Nyxarian/ApexFly-v2.0/优化一下/会话交接.md

# ApexFly V2.0 · 会话交接

> **更新于 2026-10-07，已提交基线 v0.34（含阶段4~7改动 + 定点手动上锁修复）；修复待真机验收。**
>
> **用途**：换新会话时，把这份文档交给新会话的 AI 先读。
> 它只写**当前状态 + 下一步 + 不能忘的规矩**；详细设计与推导**不在这里**，下文指了位置。
>
> ⚠️ **不要把这个旧会话的聊天记录/日志粘进新会话。** 要数据就给文件路径。

---

## 0. 新会话开场白（复制这段）

```
ApexFly V2.0 飞控项目。先读 优化一下/会话交接.md，再按它指的位置读细节。
本次要做：<在这里填一句话>
```

---

## 1. 项目是什么

| 项 | 内容 |
|---|---|
| 什么 | STM32G474VCT6 上的**自写四轴飞控固件** |
| 工具链 | **Keil MDK（AC5 / armcc，C99，`-O1`）** |
| RTOS | FreeRTOS 10.3.1 + CMSIS-RTOS2，tick 1000Hz，heap 30KB |
| 控制环 | 250Hz（`motorTestTask`，优先级 High，DRDY 信号量驱动） |
| 代码根目录 | `ApexFly v2.0\ApexFly v2.0\`（工作区根是 `F:\Zhuomian\ApexFly v2.0\`） |
| 资源 | Flash 256 KB / RAM 128 KB。⚠️ 最近一次 map 约 **98 KB / 42 KB**，那是 **v0.23 之前**的数，加光流后没重新出过 map |
| 遥控端 | **另一个仓库**：`F:\Zhuomian\CoreFly F2 Remoto`（STM32F407 + LVGL） |
| 调试口 | USART3 = 打印 + 黑匣子 dump，**115200 8N1**（COM9，WCH 芯片） |
| 文档目录 | `优化一下\`（方案 / 施工顺序）、`技术文档\`（数据手册，**被 .gitignore 忽略**） |

**任务优先级**：`motorTestTask`=High ／ `radioTask`=AboveNormal ／ `blackboxTask`/`magtask`/`gpsTask`/`tofTask`/`flowTask`=BelowNormal ／ `ledTask`/`defaultTask`=Normal。

---

## 2. 分工与硬规矩（不许破）

**分工：AI 改代码；用户在真机上编译、烧录、验证。**
AI **不烧录、不擦除、不探测目标板、不占串口**，**绝不假装这些已经成功**。

| # | 规矩 |
|---|---|
| 1 | **工作循环**：①AI 出方案 →②用户批准 →③AI 改代码 →④用户真机验证 →⑤下一环节。**未明确批准不动任何代码/工程文件/配置。** |
| 2 | 方案必须含三段（会导致什么 / 现在怎么办 / 优化后如何）+ 五要素（目标、改动文件与点、影响范围、内存与资源、验收标准）。 |
| 3 | **能用串口打印验证的一律用打印验**；验证通过后**把临时打印删干净**。 |
| 4 | **关键节点提交**；提交信息必须写**版本号 + 本次完成了什么**；**跳过某环节必须在留档里备注**。 |
| 5 | **行尾**：`Modules/*` = **LF**；`Core/Src/*`、`Core/Inc/*` = **CRLF**。改之前先确认，别搞成混合。 |
| 6 | **改 `.uvprojx` 之前 Keil 必须关掉**（否则退出时被覆盖）。 |
| 7 | ⭐ **加任何全局符号前，先全工程 grep 一遍**。`HAL_UART_ErrorCallback` 重复定义（`L6200E`）踩过一次。 |

---

## 3. 当前状态（v0.34 已提交，修复待真机验收）

- 2026-10-07 用户批准修复：正常手动上锁让定点回到 WAITING；重新解锁后门禁全通时重新捕获原点。仅把“链路正常 + 有效遥控帧明确请求上锁”认作正常上锁，不把失联、内环禁用或 IMU 故障认作正常上锁。
- `PositionControl_SetSafetyContext()` 新增第4个参数 `pilot_disarmed`；motor 控制环传递原因，Flow 轮询即使无新帧或旋转冻结也能退等待。正常上锁清零目标、积分、滤波、位置/速度和旧锚点；已有真实故障锁存及首次故障原因保持，仍需关开定点请求。
- 验证：位置仿真由22项增至56项，全过；光流39项全过。新增覆盖连续两轮上锁/解锁、重新锚定、无新帧、手动飞行态、五种真实故障锁存保留。position_control.c和motor_test.c的ARM GCC语法检查通过（沿用synchk_gcc的RTOS语法桩，不等同于Keil整工程编译）。Keil编译、烧录和拆桨串口验证由用户进行，本轮未执行。
- 用户日志 `C:/Users/fool/Downloads/apex_session_20261007_110915.csv`：完整场次10/11速度Kp分别0.012/0.013，位置三增益与速度I/D均为0；444条定点记录全部st=3/fr=5，定点姿态输出全为0，不能比较增益效果。文件开头另有场次9尾段；首次锁存触发不在文件中，不能认定具体触发时刻。
- 同份日志有明显偏航变化；用户表示只有油门动、其他杆未动。偏航原因未查明，不能因为本次锁存修复就直接恢复飞行调参。失联停桨旧缺口仍在当前代码中。
- 阶段4：IMU健康、动态加速度权重与静止陀螺偏置学习已实现；阶段5~7：光流方向复核、高度比例和旋转冻结已实现，并有用户台架记录。旋转门限是冻结/重新锚定，不是完整角速度补偿。
- 2026-10-07 已提交 **v0.34**：阶段4~7既有改动与本次手动上锁修复一并入库，未拆分成两次提交。提交信息里写明了「待真机验收」的边界。
- `sim_position_control.c` 受忽略规则影响（`_inbox_会话提取/.gitignore` 整目录忽略），已用 `git add -f` 强制入库并随 v0.34 提交；以后改它**仍要走 `git add -f`**，直接 `git add` 会被静默漏掉。

- v0.24 在 v0.23 光流接入基础上，把 OF5 标定窗口从 25 帧改为 **250 帧（约 10 秒）**，`z` 改为 4 位小数。
- OF1~OF5 的 `sim_flow.c` 基线 **37 项全过**；用户已编译烧录并完成 60 秒静止复测；遥控端不用动。
- 本地仍领先远端，推送由用户自己做。`硬件/BOM/` 是另一话题留下的未跟踪文档，不属于本次固件提交。

### 定高（H1~H14）：代码完成 + 已真机验证

| 环节 | 状态 |
|---|---|
| H1~H6 估计器 / 状态机 / 门禁 / 三段映射 / 停手 | ✅ 已实测（v0.13） |
| H17a 遥控端模式通道 | ✅ 用户实测通过 |
| H8 油门来源接管 | ✅ 台架 9/9 |
| H9 垂速内环 P | ✅ 真机 10/10（等效 Kp ≈19.9） |
| H10 悬停油门估计器 + 绝对油门区间 | ✅ 真机 12/0/1 |
| H12 失效处理（保持 → 慢降到 1000） | 🔨 代码完成（v0.19），⚠️ **台架验证被跳过，从未上过真机** |
| H13 外环 P + `h_sp` 接入 | 🔨 代码完成（v0.20），待验证 |
| 飞前清账（v0.21） | 🔨 代码完成，待烧录 |
| H14 停手改「推杆即解手」（v0.22） | 🔨 代码完成，待烧录 |
| **H16 估计器互补滤波** | ❌ **未做**。⭐ 它是"内环增益能不能加上去"的前提（当前 `vz_kp` 只能给 2，设计值 20） |

### ⭐ 光流（OF1~OF5）：全部真机通过

- **OF1/OF2**：约 25Hz、Quality 168~255、checksum 恒 0；format 偶发但能自动恢复。
- **OF3**：遮挡时 304 个低质量帧期间 `sx/sy` 严格冻结；TX 断开约 16 秒时 `n` 不变、`sx/sy` 严格冻结；接回自动恢复。
- **OF4**：前后/左右正反方向已取证。模块镜头垂直向下，仅在水平面内相对机体系约旋转 **58°**；二维转换放到 OF6 只打印阶段复核。
- **OF5**：v0.24 的 250 帧标定已真机通过。`z=-0.0040,0`；标定后 1653 帧/66.12 秒漂 6.6/0 计数，每帧残差 0.003993，相对旧版改善 10.02 倍。
- **OF6**：v0.25 软件与真机台架通过。新增约 58° 机体系旋转、位置 P 环 12.5Hz、速度 P 环 25Hz、2.5Hz 输出低通；只打印 `[PC]`，未接姿态/电机。用户确认机体与光流镜头实际高度保持约 15cm；内侧 ToF 被底座遮挡导致 `[V] raw/h` 后半段下降，不代表光流高度变化。
- **OF7**：新增请求接口、五位门禁、当前位置锚定、手动飞行态、失效锁存和请求重开；仍只打印，真实遥控请求留到 OF10，不复用定高 `flight_mode`。
- **OF10**：飞控与 `CoreFly F2 Remoto` 已接入独立定点请求位 `0x02`；遥测 `flight_mode` 的 bit4~6 回传实际定点状态；遥控器设置页可开关请求，仪表盘显示实际状态。两端基线已分别提交，用户真机联调通过；UI 有轻微显示问题，暂不处理。
- **OF8**：姿态、有效高度、解锁/内环许可接入定点门禁；光流/链路/姿态/高度运行中故障会清零并锁存，恢复后必须关开请求。宿主机 `sim_position_control.c` **22/22**；`sim_flow.c` **39/39**；飞控 ARM GCC 语法检查通过。待用户拆桨台架验证。
- **OF8 真机验收**：用户已验证定点锁存与恢复流程；拔掉光流输入后为 `st=3 fr=1`，盖镜头时已处于锁存态没有新增动作，符合锁存设计。`fr=2` 的遥控链路专门测试尚未单独取证，但不阻挡本轮进入 OF9。
- **OF9**：新增独立 64 字节定点扩展记录，约 12.5Hz 记录光流 dx/dy/quality、累积流量、标定零点、速度/目标速度、raw/out 姿态目标和定点状态；旧姿态样本布局不变。首份 CSV 已确认字段与状态正确，但发现 `t_ms` 受黑匣子队列写入延迟影响，已改为记录 Flow 采样源时间；当前等待重新 dump 验证时间间隔。宿主机 Flow 39/39、位置 22/22、ARM GCC 语法检查通过。
- **OF11**：位置/速度环输出已接入原有姿态目标角输入；普通模式生效，定高模式暂不叠加，修正角保持 ±8°；原有姿态 PID 参数未改。ARM GCC 语法检查通过，待用户拆桨台架验证。
- **OF15**：飞控与遥控端已扩展到 39 项参数；新增定点位置环/速度环 KP、KI、KD 共 6 项；支持遥控 SET、SAVE、LOAD、上电自动加载；黑匣子场次头追加定点参数记录。当前继续补上机载端每次成功 SET/LOAD 的完整 39 项参数版本记录和 SAVE 标记，遥控端无需改协议。两端语法检查通过，待用户验证参数历史与波形对应关系。
- OF11 已在普通模式接入姿态目标；定高模式暂不叠加定点，不能再按“全部只打印”理解当前代码。

完整证据：`优化一下\光流OF1~OF5真机验收留样.md`。

⚠️ **GPS 被临时摘掉**：本板只有两个串口，光流接到了 GPS 座。开关是
`Core/Inc/apex_config.h` 的 **`APEX_UART2_ROLE_FLOW`**（1=光流 19200 / 0=GPS 9600，**GPS 代码路径没删**）。
副作用：**黑匣子场次时间戳会写 0**（用户已定：照原样显示、不兜底）。

---

## 4. ⭐ 下一步（本会话结束后的第一件事）

**用户用Keil编译烧录本次手动上锁修复；先拆桨验证下面流程，再排查偏航及失联保护，暂不继续飞行加增益。**

1. 拆桨、保持ToF/光流有效、摇杆回中，打开定点请求。正常手动上锁时应为 `[PC] req=1 st=1 fr=0 ok=0`，`raw/out`全0。
2. 解锁后门禁全通，应为 `gate=0x1F st=2 fr=0 ok=1`。轻微平移验证速度和修正角更新。
3. 手动上锁后改一次参数，定点请求保持打开；应回st=1/fr=0/ok=0。将机体平移到新位置再解锁，应在新位置锚定、st=2/fr=0/ok=1，不能向旧位置回拉。连续完成两轮。
4. ACTIVE时遮挡镜头到光流失效，应st=3/fr=1；恢复、手动上锁和再解锁都不能清掉已有故障。只有关闭、重开定点请求才允许重新使能。
5. 参数SET/SAVE/LOAD仍只允许上锁操作；仅降油门并不等于上锁。真实故障许可丢失仍允许fr=5锁存。

OF1~OF5 的完整留样：`优化一下\光流OF1~OF5真机验收留样.md`。

参数调节顺序是速度内环先、位置外环后。单独验证速度刹车时位置Kp/Ki/Kd全0，速度I/D全0；合格的ACTIVE记录产生后才能判断增益。当前修正角上限±8°，高度比例参考14cm、钳在0.6~2.0。

### 不建议现在做的

**别急着首飞。** 飞前还压着 4 件事，其中待办 9 是硬缺口 —— 见下一节。

---

## 5. 挂着没关的账

| # | 项 | 状态 | 挡什么 |
|---|---|---|---|
| **待办 9** | ⚠️⚠️ **失联门限只放宽到 1500ms，没根治** | LoRa 一问一答实测间隔 300~320ms ⇒ 连丢 4~5 帧仍判失联 ⇒ `armed=false` ⇒ **空中停桨**。真修法要改 `motor_test.c` 的 `!armed` 分支（failsafe hold） | **首飞**（唯一的硬缺口） |
| **待办 11** | ⚠️ **H12 从未上过真机** | 最便宜的一条：**举到 1.25m 以上** → `fr=3`、`st=6` 保持 2s、`st=7` 慢降。不用飞、不用拆桨 | **首飞**（风险转移在那里） |
| **待办 6** | 「举到 1.35m 让 `v=0`」未做 | 需要更长的 USB 线或支架（举高会扯掉线，实测掉线 3 次丢 143s） | 不挡 |
| **待办 7** | 悬停油门天花板 1650 够不够 | **只有首飞才知道**。若 `i` 长期顶在 1650 还上不去，要改**代码常量** `VERTICAL_CONTROL_THROTTLE_MAX_US`（**要重烧**） | 首飞后 |
| **待办 10** | H12 下降段单向不回头 | 刻意取舍，待评估 | 不挡 |
| **待办 4** | 串口 ORE 溢出后的自动恢复路径 | **未真机验证**（用户跳过了）。将来串口"突然收不到、要重插"先怀疑这里 | 不挡（只影响黑匣子 dump） |
| GPS | 返航/航线 | 光流稳了之后第二阶段做（光流挪到打印口 RX、GPS 接回 USART2） | 后期 |
| H18/H19 | 自动起飞 / 自动降落 | 未做。⚠️ H19 的前提被"停手"改过，文档里标了要重看 | 后期 |

---

## 6. 必读文档

| 文档 | 里面有什么 |
|---|---|
| `优化一下\IMU与光流定点阶段总结_2026-10-07.md` | 本轮阶段0~8成果、状态机修复、飞行日志结论、验证边界、当前参数及后续调试顺序 |
| `优化一下\高度接入施工顺序.md`（**1428 行，含「当前进度」表 + 待办清单**） | 定高 H1~H20 全表、每个环节的验收步骤与实测结果、待办 1~11、踩坑记录 |
| `优化一下\高度接入飞控方案.md` | 定高的研究方案（为什么这么设计，§5 摇杆与模式、§6 失效、§15 坑） |
| `优化一下\光流接入方案.md` | 光流 OF1~OF5 方案；**含商家 demo 的两条缺陷**（不看 Quality、不做零点标定 = 恒速漂移的根因） |
| `优化一下\光流定点施工顺序.md` | OF1~OF15 全表 + **「OF1~OF5 验收步骤」** |
| `优化一下\光流OF1~OF5真机验收留样.md` | 2026-09-21 真机日志证据、实际安装条件、OF3 验收与 OF5 修正依据 |
| `技术文档\mini光流资料\demo代码\README.md` | 商家 demo 逐行读后的结论（⚠️ `技术文档/` 被 gitignore） |

**改代码前必看的具体文件**

| 文件 | 关键内容 |
|---|---|
| `Modules\Control\vertical_control.h` | ⭐ 所有定高常量与注释都在这里（停手门槛、三段边界、速率、门限、油门区间） |
| `Modules\Control\vertical_control.c` | 状态机 + 两层门禁 + 停手 + 失效处理 + 慢层积分器 |
| `Modules\Flow\flow.c` / `flow_cxof.c` | 光流管理层 / 协议层 |
| `Core\Inc\apex_config.h` | 手写编译期开关（USART2 归谁） |
| `Modules\Motor\motor_test.c` | 控制环；基础油门按模式分叉在 ~L524；打印**禁止**在这里（一行 10ms 会吃两拍预算） |
| `Modules\ToF\tof.c` | `[V]` 与 `[OF]` 两行打印都在这里（tofTask，500ms） |
| `Modules\Communication\apex_protocol.h` | 参数 ID 表（高度组 25~32） |

---

## 7. 日志怎么读

### `[V]` 行（500ms 一行，垂直轴全部信息）

```
[V] raw=<mm> | h=<cm> vz=<cm/s> v=<0|1> | req= mode= st= sw=0x ct=0x stick= h_sp= gt=ms fs=ms fr= | vzsp= corr= i= thr=
```

| 字段 | 含义 |
|---|---|
| `st` | ⭐ 细分状态：**0** 普通 / **1** 定高在干活 / **4** 停手 / **5** 已进模式未使能 / **6** 失效保持 / **7** 失效下降 |
| `sw` / `ct` | 两层门禁位图，全通分别是 `0xF` |
| `fs` / `fr` | 失效计时 / 失效原因（0 无、1 ToF 失效、2 姿态超限、3 高度越界）。⚠️ **`fr=2` 时 `thr` 立刻 1000**，是设计不是 bug |
| `vzsp` | 外环输出（内环的目标垂速）。符号：命令上升为正；死区 2cm 内恒 0 |
| `corr` | 快层（垂速内环修正量）。⚠️ **符号必须与 `vz` 相反**，这是负反馈的唯一证据 |
| `i` | ⭐ 慢层（悬停油门估计器），钳在 **1150~1650**。台架上只有它能看出积分在不在工作 |
| `thr` | 基础油门。定高时 = `i + corr` 再钳到 [1150,1650]；普通模式跟杆走 |

### `[OF]` 行
见第 4 节。

---

## 8. 已经踩过的坑（别重犯）

| # | 坑 | 结论 |
|---|---|---|
| 1 | **`L6200E: Symbol HAL_UART_ErrorCallback multiply defined`** | 加全局符号前先全工程 grep。光流与 GPS **必须互斥编译**（同一个 `APEX_UART2_ROLE_FLOW` 开关控制两个 HAL 回调） |
| 2 | ⚠️ **CubeMX 重新生成会覆盖手改** | `usart.c` 里 `huart2.Init.BaudRate = APEX_UART2_BAUD` 和 `app_freertos.c` 里 `gpsTask` 的那个 `#if` **都不在 USER CODE 区** ⇒ 生成完必须回来确认（否则波特率打回 9600、光流一帧收不到） |
| 3 | **停手门槛必须 > 地面静止读数** | 门槛低于读数 ⇒ 停手永远进不去（2026-09-14 翻过车）。反向也不行：门槛太高会把低空悬停误判成停手 ⇒ 油门压最低 ⇒ **掉下来**。规矩是**撤垫块后重新实测**，门槛取"实测 + 1~2cm" |
| 4 | **打印绝不能进 250Hz 控制环** | 一行约 10ms，会吃掉两拍 4ms 预算。打印全在 `tof.c`（tofTask，500ms） |
| 5 | `USART3` 是 **5ms 轮询 + FIFO 关闭**（硬件只存 1 字节） | 串口命令**必须逐字节发、间隔 ≥10ms**，否则被吃掉。这就是"发命令又慢又脆"的根因 |
| 6 | **`.uvprojx` 是手改的** | 改之前 Keil 必须关着 |
| 7 | 仿真能抓产品代码的错 | H6 的"**永远起飞不了**"死循环就是仿真抓出来的。**烧录前先跑仿真**（见下一节） |
| 8 | ⚠️ **DSH 沙箱禁写 `.git`** | 受限模式下 `git add/commit` 一律 `Unable to create '.git/index.lock': Permission denied`（工作区其他目录可写，只有 `.git` 被单独挡）。**提交必须在「完全权限」下跑**，别误判成仓库损坏 |
| 9 | ⚠️ **本工作区 Windows 权限曾缺失** | 2026-10-07 出现过 `SetNamedSecurityInfoW failed (Win32 5): grantWrite(...)`，连 `echo` 都跑不了：根目录缺 `WRITE_OWNER`。备份与回滚脚本在 `F:\Zhuomian\acl-recovery\` |

---

## 9. 验证工具在哪（不碰硬件就能用的）

都在 `_inbox_会话提取\提取脚本\`（脚本源码已强制入库；`_inbox_会话提取\.gitignore` 里列了清单）。

| 工具 | 干什么 |
|---|---|
| `sim_vc_h10.c` / `h12.c` / `h13.c` / `h14.c` | **固件仿真**：真实编译 `vertical_control.c` + `pid.c`，桩掉估计器与参数表。当前有效回归：h10 **49** / h12 **68** / h13 **34** / h14 **48** 项全过 |
| `sim_flow.c` | **光流仿真**：真实编译 `flow.c` + `flow_cxof.c` + `position_control.c`，并用"反向控制"驱动**真的 `Flow_Task`**，**39 项全过** |
| `sim_position_control.c` | **OF6/OF7 纯计算仿真**：旋转、两级环、分频、门禁、锚定、手动飞行态、锁存、限幅、低通、失效与恢复，**16 项全过** |
| `verify_v.js` | **真机日志自动判据**：读 `[V]` 行，24 条判据逐条给结论。用法 `node verify_v.js <日志>` |
| `gen_fake_v_log.js` | 合成日志生成器，**含 11 个对照组**（用来证明判据真能抓错，不是自欺） |
| `sim_h13_takeoff.js` | 物理仿真：起飞时间线 / 延迟扫描 / 增益扫描 |
| `measure_session.js` / `measure_usage.js` | 量 DSH 会话体积与 token 用量（成本分析用） |
| `synchk_gcc\` / `flow_stub\` / `sim_stub\` | 宿主机语法检查用的桩头 |

**语法检查**（两种开关状态都要过）：
```bash
arm-none-eabi-gcc -fsyntax-only -std=gnu99 -Wall -Wextra -Wno-unused-parameter -Wformat=2 \
  -DUSE_HAL_DRIVER -DSTM32G474xx <包含路径...> <文件>
```
⚠️ `sim_vc_h8.c` / `sim_vc_h9.c` 是**历史脚本**（断言基于当时的旧基准，已过期），**不要接进自动检查**。

---

## 10. 沟通与协作风格

- **中文回答，先给结论再给依据。**参数偏保守，不确定就说不确定，**不要猜**。
- 用户偏好：**大白话**、**决策表**、**五要素方案**、**不要废**（别啰嗦）。
- ⚠️ **压缩档（caveman full）默认开**。**例外**（按普通写法、不许压）：
  安全警告、不可逆操作（接反烧模块、5V、掉桨）、**多步操作顺序**（烧录流程、验收步骤、接线）、
  判据、参数值、常量、命令行、错误原文、代码块。
- ⚠️ 硬件的事**由用户做**，包括编译烧录。AI 只给可直接执行的步骤与命令。

---

## 11. 成本纪律（给用户看的，AI 也要遵守）

**实测结论**（用 `measure_usage.js` 量的上一个会话）：

- 上下文长期卡在 **700K~790K**；**三次压缩只降了 10% / 3% / 6%** ⇒ **压缩救不了**。
- 换新会话，同样工作量**输入省约 18 倍**（拆成多个会话约 30 倍）。

**规矩：**
1. ⭐ **一个环节 ≈ 一个会话。**（H8/H9/H10 一个、H12/H13 一个、OF1~OF5 一个）
2. 换会话的触发：**一个环节做完并提交** / **上下文 > 200K** / **已经压缩过 1 次** / **换任务类型**。
3. AI 回复默认走压缩档；**长报告只在"要留档"时才写**。
   （上一个会话里，AI 自己的回复占会话体积的 **58%**，是最大单项。）
4. 换会话时**不要把旧日志/长工具回显粘过来** —— 给文件路径，或重新生成。
5. 本文件就是交接资料。**每次换会话前更新本文件的第 3、4 节。**
