Nyxarian/ApexFly-v2.0/优化一下/IMU与光流定点阶段总结_2026-10-07.md

# ApexFly V2.0 · IMU与光流定点阶段总结

> 日期：2026-10-07（北京时间）  
> 范围：IMU基准优化、六面校准、姿态健康、光流测量与定点控制，以及手动上锁退等待修复。  
> 已提交基线：`9f5d31e`，`v0.33：完成 IMU 六面校准与姿态打印链路`。  
> 当前状态：主要功能代码和调参链路已实现，后续重点为真机验收与调参；有效定点飞行尚未验收通过。

## 1. 本阶段结论

这轮工作把“每次上电把当前地面当成水平”的处理，改为重力姿态、加速度计校准和固定安装角修正分别处理；同时补齐光流高度比例、旋转冻结、定点状态机和观测链路。

当前能够计算定点姿态修正，并在普通模式中送入姿态控制。遥控器可以修改、保存、加载位置与速度六项增益，串口和黑匣子可以查看定点实际状态。

“代码已经实现”不等于“飞行已经稳定”。2026-10-07两场完整飞行记录中的定点始终故障锁存，输出为零，所以不能把它们视为速度环整定成功，也不能据此认定增益过大。

最新完成的是正常手动上锁退等待修复：代码、仿真与语法检查通过，用户尚未提供修复后的编译、烧录和拆桨验收结果。

## 2. 完成内容和验证状态

| 阶段 | 完成内容 | 当前证据与状态 |
|---|---|---|
| 0 | 冻结基线、记录参数和工作区 | 基线文档已建立 |
| 1 | 取消每次上电动态水平清零 | 已从电机控制任务移除旧清零流程；用户后续姿态测试有倾斜响应 |
| 2 | 固定安装角修正 | 用户确认机架水平，完成平放、四方向垫高测试；六面校准后重新修正安装角 |
| 3 | 六面加速度计bias/scale校准、串口控制和Flash保存 | 用户提供保存成功回显及后续姿态数据；历史六面算法仿真1224项通过，本次未重跑 |
| 4A/4B | 姿态健康、加速度模长、静止判断和融合误差观测 | 用户提供静止/移动串口记录 |
| 4C | 动态加速度修正权重 | 用户记录可观察到运动时权重降低、静止后恢复 |
| 4D | 静止时在线陀螺零偏学习 | 用户记录可观察到静止允许学习、移动停止学习；在线补偿仅保存在RAM |
| 5 | 光流质量、有效性、零点和前后左右方向复核 | 用户提供台架移动记录；安装角在代码中采用约54° |
| 6 | 按ToF高度计算比例，缩放光流位置和速度 | 用户提供不同高度的hs记录；已实现0.6～2.0钳位 |
| 7 | 大角速度期间冻结光流控制，结束后重新锚定 | 用户提供rot冻结/恢复记录；这是门限抑制，不是完整旋转补偿 |
| 8 | 位置/速度增益整定 | 参数和日志链路已具备；有效定点飞行增益尚未确定 |
| 本次补充 | 正常手动上锁退WAITING，重新解锁重新锚定 | 位置仿真56/56、光流39/39、ARM GCC语法检查通过；待修复后真机验收 |
| 9 | 定点与定高同时使用 | 尚未实现；当前定高模式不叠加定点修正 |

上述台架结果来自本轮用户提供的串口记录和反馈，不表示本次重新执行了全部硬件测试。

## 3. IMU处理结果

### 3.1 水平基准与传感器校准分开

- 上电仍采集陀螺仪静止零偏，但不再把当前摆放姿态强行清成水平。
- 六面校准处理加速度计三轴bias和scale，不等于机架安装角校准。
- 加速度计校准改变重力方向估计后，需要重新检查固定安装角修正。这解释了六面校准后平放角度曾重新出现偏差。
- 当前安装角修正为机体系 `roll=-0.14°`、`pitch=-0.87°`，属于代码中的固定常量；更换飞控、改变安装位置或传感器后需要重新检查。
- 当前六面算法不包含完整轴间不正交、温度模型或全矩阵安装旋转标定。

### 3.2 六面校准与保存

串口命令：

```text
calimu start
calimu next
calimu status
calimu save
calimu cancel
```

六面顺序为传感器原始轴 `X+ → X- → Y+ → Y- → Z+ → Z-`，不能直接把这些名称当成机架前后左右。

用户曾提供以下保存成功回显：

```text
[IMU_CAL] flash saved gen=1 bias=+0.04171,-0.08191,+0.02669 scale=1.00044,0.99864,0.98863.
```

这是一份历史保存证据，不是本次重新读取目标板Flash的结果。校准记录使用外部W25Q64末尾保留扇区中的64字节双副本，启动时读取有效记录；无需每次上电重新做六面采集。固定安装角修正与这份bias/scale记录分开。

### 3.3 姿态健康与在线零偏

已有诊断字段包括加速度模长 `an`、修正有效性 `ac`、健康状态 `ah`、静止状态 `st`、融合误差 `fe`、修正权重 `aw`、在线陀螺偏置 `gb` 和学习许可 `gl`。

在线学习仅在未解锁、静止、健康正常且加速度修正权重足够高时允许；时间常数约20秒，补偿限制为每轴±3°/s。解锁或运动时停止学习，避免把真实运动吸收为零偏。它不代替六面校准，也不在飞行中学习水平基准。

## 4. 当前定点控制链和参数

```text
光流原始帧
→ 校验、质量门禁、零点修正
→ 旋转门限抑制
→ 模块坐标转机体系
→ 高度比例缩放
→ 位置外环给目标速度
→ 速度内环给roll/pitch修正角
→ 输出低通
→ 普通模式下叠加到姿态目标
→ 原有姿态/角速度控制和电机混控
```

| 项目 | 当前代码值或规则 |
|---|---|
| 控制周期 | 姿态/电机任务250Hz；光流约25Hz；位置外环每两帧更新一次，约12.5Hz |
| 光流安装角 | 约54°，cos=0.5878、sin=0.8090 |
| 高度参考 | 14cm |
| 高度比例 | `hs=clamp(height_cm/14, 0.60, 2.00)` |
| 比例影响 | 同时缩放机体系光流位置和速度 |
| 高度限制 | 超过28cm后比例顶在2.00，不能视为更高高度也已完整补偿；当前量仍是光流计数，不是cm或m |
| 旋转冻结 | 三轴角速度最大绝对值达到25°/s时进入，降到15°/s及以下时退出 |
| 冻结行为 | 停止对应累积/控制更新，姿态修正清零，恢复后重新锚定 |
| 目标速度限幅 | 每轴±200 count/s |
| 姿态修正限幅 | roll/pitch各±8° |
| 输出低通 | 2.5Hz |
| 代码默认位置增益 | Kp=0.50，Ki=0，Kd=0 |
| 代码默认速度增益 | Kp=0.010，Ki=0，Kd=0 |
| 参数更新权限 | SET/SAVE/LOAD仅允许上锁状态操作 |
| 当前模式范围 | 普通模式支持定点；定高模式暂不叠加定点 |

默认值不是已经验证的最终飞行值。Flash保存参数会覆盖默认值，应以遥控回读及场次参数记录为准。

当前高度处理采用简化缩放模型；尚未证明高度变化过程中累计位置的连续性及跨高度闭环一致性。阶段6台架hs变化记录只能证明比例计算和钳位行为，不能代替这一项飞行验收。

## 5. 状态机与手动上锁修复

### 5.1 请求与实际状态必须分开看

| st | 含义 |
|---:|---|
| 0 | 定点请求关闭 |
| 1 | 等待有效使能条件 |
| 2 | 定点实际工作 |
| 3 | 故障锁存，禁止输出 |
| 4 | 摇杆离开中心，手动移动 |

| fr | 原因 |
|---:|---|
| 0 | 无故障 |
| 1 | 光流不可用 |
| 2 | 遥控链路故障 |
| 3 | 姿态超限 |
| 4 | 高度不可用/越界 |
| 5 | 控制许可失效 |

`gate=0x1F`表示五位门禁全通，但不会自动清除既有锁存。判断实际参与定点，应同时看 `st=2、fr=0、ok=1` 和修正输出；不能只看请求开关。

摇杆离开中心后，定点修正暂停；回中后按当前代码等待约200ms，再捕获新位置。因此推杆移动后松杆主要检验新位置的刹车和保持，不代表回到推杆前的原点。

### 5.2 旧问题与本次修复

旧路径可能为：

```text
定点ACTIVE → 正常手动上锁 → 许可失效 → fr=5锁存
→ 上锁改参数 → 再次解锁 → 定点仍不工作
```

修改参数命令本身不会触发锁存；不便来自参数操作前的正常上锁被当作故障。

本次新增的正常上锁判断是：链路正常、控制帧有效、遥控帧明确取消解锁请求。失联、内环禁用或IMU异常不能仅因 `armed=false` 就被当作正常上锁。

新的正常路径为：

```text
定点ACTIVE → 明确手动上锁 → WAITING，fr=0，输出/积分/旧锚点清零
→ 上锁改参数 → 再次解锁且门禁全通 → 在当前位置重新ACTIVE
```

Flow轮询在没有新光流帧或旋转冻结时也处理正常上锁。已有真实故障锁存不自动解除，后续光流失效不会覆盖已锁存的首次故障原因；仍需关闭、重开定点请求。

本次仅增加少量状态和分支，没有新增RTOS任务或动态内存，未修改Keil工程文件、遥控协议或增益。整工程最新Flash/RAM占用需由用户编译后的map确认。

## 6. 2026-10-07飞行日志结论

文件：`C:/Users/fool/Downloads/apex_session_20261007_110915.csv`。

文件开头为上一场尾段，随后包含场次10、11的完整记录；姿态与定点两种记录混排，不能作为同一张固定列数CSV直接套用姿态表头。

| 项目 | 场次10 | 场次11 |
|---|---:|---:|
| 位置Kp/Ki/Kd | 全0 | 全0 |
| 速度Kp | 0.012 | 0.013 |
| 速度Ki/Kd | 全0 | 全0 |
| 姿态记录数 | 5275 | 3797 |
| 定点记录数 | 259 | 185 |
| 定点状态与原因 | 全部st=3/fr=5 | 全部st=3/fr=5 |
| raw/out修正角 | 全部0 | 全部0 |

确定结论：这两场没有产生有效定点控制，不能比较0.012与0.013的刹车效果。锁存期间速度快照一直为 `-0.8,0.0`，不是可用的实时飞行速度证据。

尚不能确定：首次许可失效发生在哪次操作。日志第一条就已锁存，没有首次触发前后的记录。正常上锁后没有关开定点请求，是符合旧代码的解释，但不是本文件证明的唯一原因。

另有偏航异常线索：日志首尾偏航展开后变化约174°和218°，包含落地前后阶段；电机运行段也存在明显偏航角速度，场次11偏航修正曾达到−200µs。用户表示仅动油门，其余杆未动。需要结合实际机头转动情况检查陀螺方向、混控/电机转向与磁航向；当前不能定性为某一个具体根因。

## 7. 验证完成范围

| 检查 | 结果 | 边界 |
|---|---|---|
| 最新位置仿真 | 56/56通过 | 真实编译position_control.c；覆盖两轮正常上锁/解锁、重新锚定、无新帧、手动移动态、五类故障锁存保留 |
| 最新光流仿真 | 39/39通过 | 驱动真实Flow_Task，验证解析、质量、标定、冻结和恢复 |
| 最新ARM GCC语法检查 | position_control.c、motor_test.c通过 | 使用synchk_gcc的RTOS语法桩，不等同于Keil整工程编译 |
| 行尾与差异检查 | 本次修改文件保持LF；diff检查通过 | 未混入行尾转换或工程文件修改 |
| 六面算法仿真 | 历史1224项通过 | 本次只写总结，没有重新运行该仿真 |
| 最新修复的Keil编译/烧录/拆桨验收 | 待用户提供结果 | 尚未收到修复后的具体测试结果，暂不标为已验收 |
| 有效定点飞行和最终参数 | 尚未通过 | 需要实际ACTIVE场次的飞行表现与黑匣子记录 |

## 8. 下一步执行顺序

### 8.1 先验收手动上锁修复

1. 用户Keil编译、烧录；测试全程拆桨，保持光流/ToF有效、摇杆回中。
2. 定点请求打开并解锁后，确认 `gate=0x1F、st=2、fr=0、ok=1`。
3. 手动上锁，确认 `req=1、st=1、fr=0、ok=0`，raw/out全部0。
4. 上锁修改一项参数，定点请求保持打开。
5. 平移机体到新位置后重新解锁，确认重新ACTIVE且在新位置锚定。
6. 连续重复两轮。
7. ACTIVE时遮挡镜头直到光流失效，确认st=3/fr=1；恢复光流、手动上锁/再解锁仍保持锁存；关闭、重开定点请求才允许恢复。

### 8.2 处理基础飞行问题

- 检查偏航变化是否为实际自转，查明并验证原因。
- 当前失联路径仍可能令 `armed=false` 后立即停桨，不能把本次调参便利性修复当成失联保护修复。
- 交接中的H12失效处理仍缺真机证据；若后续测试涉及定高，需先补该验收。

### 8.3 再做速度、位置整定

1. 普通模式基础姿态稳定，实际定点ACTIVE，有可靠光流与高度数据后，再开始飞行整定。
2. 速度环先：位置Kp/Ki/Kd全0，速度Ki/Kd为0；速度Kp=0.005仅作为首轮候选值，不是已证明安全的最终参数。
3. 刹车不足且无振荡时，每轮增大速度Kp约10%～20%；出现振荡、错误方向或输出持续饱和时结束该轮，不继续加。
4. 固定已验证的速度参数，再从位置Kp=0.10这个候选值开始，位置Ki/Kd仍为0，逐步检查回位和过冲。
5. 每轮落地上锁只改一项，记录实际六项参数、测试高度、机头方向、动作和场次编号。保持相同高度，暂不混入转向和高度变化。
6. 用黑匣子判断动态过程；当前串口每500ms打印一次，不足以排除快速振荡。
7. 合格参数在落地上锁后SAVE，断电回读验证，再重复同样动作。
8. 有效定点验收后再评估低通、角度限幅和跨高度一致性，最后另立阶段9方案整合定高。

## 9. 主要文件、资料和提交状态

| 文件 | 作用 |
|---|---|
| `ApexFly v2.0/Modules/IMU/imu_attitude.c/.h` | 姿态、安装角修正、健康和动态权重 |
| `ApexFly v2.0/Modules/IMU/imu_bias.c/.h` | 启动零偏与在线静止学习 |
| `ApexFly v2.0/Modules/IMU/imu_accel_calibration.c/.h` | 六面bias/scale算法与采样控制 |
| `ApexFly v2.0/Modules/Flash/blackbox.c/.h` | 校准保存、串口命令、姿态/定点及参数版本记录 |
| `ApexFly v2.0/Modules/Flow/flow.c/.h` | 光流管理、零点、质量、旋转门限、控制上下文 |
| `ApexFly v2.0/Modules/Control/position_control.c/.h` | 坐标、高度比例、两级环、门禁和状态机 |
| `ApexFly v2.0/Modules/Control/pid_table.c/.h` | 定点六项参数与更新权限 |
| `ApexFly v2.0/Modules/Motor/motor_test.c` | IMU与控制上下文、普通模式定点姿态接入 |
| `ApexFly v2.0/Modules/ToF/tof.c`、`Modules/De_Bug/debug.c/.h` | 低频串口观测；打印不进入250Hz控制环 |
| `_inbox_会话提取/提取脚本/sim_position_control.c`、`sim_flow.c` | 最新主机回归 |

以上代码路径均相对工作区根 `F:/Zhuomian/ApexFly v2.0`；表中简写的同组文件位于同一目录。

相关资料：

- [会话交接](<F:/Zhuomian/ApexFly v2.0/优化一下/会话交接.md>)：当前状态与下一步。
- [整体施工方案](<F:/Zhuomian/ApexFly v2.0/优化一下/IMU与光流整体优化施工方案.md>)：初始问题、分阶段设计与后续整合。
- [阶段0基线记录](<F:/Zhuomian/ApexFly v2.0/优化一下/阶段0基线记录.md>)：施工前基线。
- [光流施工顺序](<F:/Zhuomian/ApexFly v2.0/优化一下/光流定点施工顺序.md>)：OF系列历史进度。

Git目前已提交到v0.33；后续阶段4~7和手动上锁修复仍在工作区。本总结没有生成新的固件提交，也没有改动硬件/BOM或遥控器仓库。关键修复待真机验收后审查提交范围，提交信息必须包含版本号和完成内容。

`sim_position_control.c`目前未被Git跟踪，提交对应测试时需显式执行：

```powershell
git add -f "_inbox_会话提取/提取脚本/sim_position_control.c"
```

调试结束后再清理临时串口打印；当前[V]/[OF]/[PC]仍用于有效使能与调参验收，不在本次总结时提前删除。
