Nyxarian/ApexFly-v2.0/优化一下/光流定点施工顺序.md

# 光流 + 定点 · 施工顺序表

> 只排列环节顺序，不排期、不分天。按依赖关系从底到上排列，作为后续推进的"施工顺序表"。
> 前置文档：`高度接入飞控方案.md`、`高度接入施工顺序.md`（提供**高度估计**，光流要靠它换速度）。
> 硬件资料：`技术文档/mini光流资料/`（协议图 + docx 教程 + `demo代码/`）+ ArduPilot 官方页 `Cheerson CX-OF Optical Flow`。
>
> ⭐ **2026-09-21**：**OF1~OF6 已完成真机台架验收。** OF3 的遮挡、断 TX、冻结和自动恢复全部通过。
> OF5 的 v0.24 250 帧标定已复测：标定后 1653 帧（约 66.12 秒）仅漂 6.6/0 计数，
> 每帧残差 0.003993，相对旧版改善 **10.02 倍**。OF6 版本 v0.25，只算只打印，不接姿态。
> 完整证据见 `光流OF1~OF5真机验收留样.md`。
>
> ⚠️ 本文件的「前置事实」在 2026-09-18 做过一次更正：原来写的是 2026-09-11 的四段式摇杆
> （**含早已取消的"待命段"**）和 25° 姿态门限，都已过期。

---

## 前置事实（硬件与协议，写代码前必看）

### ⭐ 前置前提：定高现在长什么样（2026-09-18 更正）

⚠️ **本节原来写的是 2026-09-11 的四段式版本（含"待命段"），已经全部过期。**

| | 普通模式 | 定高模式 |
|---|---|---|
| 油门杆 | **直通油门** | **三段式**：下降 0~350 ／ 保持 350~650 ／ 上升 650~1000 |
| 速率 | — | 下降 **−5 → 0**、上升 **0 → +5** cm/s（2026-09-15 由 −2/+3 改） |
| 切换条件 | — | **已上锁 + 杆在最低位（≤50）** ⇒ 一次飞行只能用一个模式 |
| 模式值 | 0 | 1 |
| 地面状态 | — | **停手**：落地自动进（`h_est ≤ 4cm` 且没在命令爬升，连续 500ms）；**推杆过 200 解手**（H14，2026-09-15） |
| 姿态门禁 | — | **30°**（2026-09-15 由 25° 改；超过即判撞击、立即停桨） |

⭐ **"待命段"早在 2026-09-12 就被取消了**，不要再按它写代码。

**对定点的影响（三条，前两条与原来的说法相反）**：

1. ⭐ **定点不必绑在"定高模式"下。** 原来写的是"定点只能在定高模式下起作用"，
   理由是"垂直由定高管"。但实际上：
   - 定点真正依赖的只是**高度估计**（`h` / `vz` —— 光流要靠高度才能把"流量"换成速度），
     而那是 H1~H6 的产物，**与定高的控制环（外环 P、悬停油门估计、失效处理）无关**；
   - 让定点先跑在**普通模式**下反而更好：油门由人管、垂直那一路完全不参与，
     出问题时**只有一个新环在动**，容易定位。
   ⇒ **结论：定点不绑定定高。**
2. **将来做 OF7 使能门禁时，不要照抄本文件旧文字里的"杆不在待命段"**：
   停手现在由**推杆**驱动，语义已经变了，按当时的实现重看一遍。
3. ⭐ **定点开关的形态仍未定**（是独立模式值？还是定高模式内的一个位？能不能空中切？）
   —— 见 `高度接入飞控方案.md` **§15.2 待讨论事项**。

详设定高侧全部细节见 `高度接入飞控方案.md` §5、§6。

### 买的是什么

**Cheerson CX-OF**（淘宝"mini 光流"就是它）。不是杂牌——**ArduPilot 官方支持它**（`FLOW_TYPE = 4`）。

### 协议（已从商家资料确认）

```
0xFE | 0x04 | DX_L | DX_H | DY_L | DY_H | SUM | Quality | 0xAA
               └──── 4 字节光流数据 ────┘   ↑      ↑       ↑
                                     累加和  图像质量   包尾
```

| 项 | 值 |
|---|---|
| 波特率 | **19200**，8 数据位，无校验，无流控 |
| 更新率 | **40ms 一帧 = 25Hz**，有数据自动发（不用轮询） |
| DX / DY | **int16（有符号）**，是"从上次更新到现在的位移计数" |
| SUM | 中间 4 个字节相加取低 8 位 |
| Quality | 0~100，**< 30 建议舍弃** |

### 六条硬约束（踩了会烧模块或白干活）

| # | 事实 | 后果 |
|---|---|---|
| 1 | ⭐ **供电只能 2.7~3.3V，绝不能接 5V**（ArduPilot 官方页原话："Connect the sensor's **VDD (aka VCC or 3.3V)** to a 3.3V power source"） | 飞控 TELEM 口一般给 5V → 必须有单独的 3.3V 取电方案。<br>✅ **本机已解决**：GPS 座的 VCC 就是 **3.3V**（用户实测确认）⇒ 直接接同一个座。<br>⚠️ 插之前**先量电压、核对线序**（GPS 座 4 pin、光流 3 线，错位可能把电供到信号线上）；**正负极接反很可能烧模块** |
| 2 | **只发不收**（3 根线：VCC / GND / TX） | 飞控**只需要一个 RX**，不需要 TX —— 串口紧张时是好事 |
| 3 | ⭐ **延迟约 80ms**（ArduPilot 推荐 `EK2_FLOW_DELAY = 80`） | **位置环周期必须 ≥ 80ms ⇒ 只能做 10~12.5Hz**，这不是保守，是物理决定的 |
| 4 | **没有陀螺补偿**（商家 demo 里试过、注释掉了） | 姿态机动时光流会读到假运动 → **定点只能在松杆、姿态平稳时启用** |
| 5 | **没有高度输出** | 必须配测距 —— 我们有 ToF ✓ |
| 6 | **输出是"原始位移计数"，不是速度** | 见下面第五条：尺度不用标，**但零点偏移必须标** |

> ⭐ **2026-09-18 定的接线方案（分两期）**：本板没预留接口，只有 USART2（GPS 座）和
> USART3（调试口/打印）两个串口，都占满了。所以：
>
> | 阶段 | USART2（GPS 座） | USART3（调试口） | 干什么 |
> |---|---|---|---|
> | **第一期（现在）** | **光流** @19200 | 打印 @115200（**一根线都不动**） | 把定点 + 定高都做稳 |
> | **第二期（稳了之后）** | **GPS** @9600 接回来 | 打印 @19200 + **光流接它的 RX 脚** | 做 GPS 返航 / 航线 |
>
> ⚠️ **第一期的打印口绝对不能动**：`[V]` / `[OF]` 判据、**黑匣子 dump**、串口命令全靠它；
> 拿它换光流等于把开发能力换掉。而且先在"排错工具完好"的条件下把光流跑通，风险最低。
>
> ⚠️ 第二期要付两个代价：① 打印波特率必须从 115200 降到 **19200**（STM32 收发共用一个
> 波特率，改不了；日常够用，但**黑匣子 dump 会从约 20 秒变成约 2 分钟**，dump 时可临时提速）；
> ② 打印口的 **RX 引脚被光流占用** ⇒ 台架上想发命令得先拔那根线（飞行中不需要发命令）。
>
> ⚠️ 一条纪律：**光流的驱动里不能把串口写死**，要照 `gps.c` 的做法把 `UART_HandleTypeDef*`
> 当参数传进来（`GPS_ATGM336H_Init(&gps_device, &huart2)` 就是这个模式）——
> 否则第二期要把代码重写一遍。`Modules/Flow/flow.c` 目前直接用 `huart2`（第一期够用），
> **第二期挪口时这里要改**。
>
> ⚠️ 切换用一个**编译期开关**（不要上电自动识别）：`Core/Inc/apex_config.h` 的
> `APEX_UART2_ROLE_FLOW`。GPS 那条代码路径**故意不删**，第二阶段改一个数就切回去。

### ⭐ 第五条：尺度不用标，**零点偏移必须标**

商家 demo 里最关键的三行：

```c
speed_x = -flow_x;                                        // 只是取反，没有任何比例系数、没有除高度
sum_flow_x += vx * 0.05f;                                 // 把"流量"累加成"位移"
pos_pid_out_x = PID_calculate(..., 0.0f, sum_flow_x, ...); // 位置环目标是 0
```

**思路：把"累积光流"当成位置，用 PID 把它钉在 0。**

⚠️ **但必须分清两件事**：

| | 要不要标定 | 为什么 |
|---|---|---|
| **尺度**（1 个计数 = 多少米） | ❌ **不用** | 因为**目标永远是 0**，尺度错了只是环路增益不对，**不会造成漂移** |
| ⭐ **零点偏移**（静止时读数不为 0） | ✅ **必须标** | 环路会把"**读数**"压到 0。若静止时读数本来是 +3，它就会让飞机**真的往反方向移动**直到读数为 0 —— **这就是恒速慢漂的直接原因** |

PMW3901 这类传感器在静止时确实会报出很小的非零流量（像素噪声、光照不均、装配公差）。**不处理它，位置环就会变成"恒速漂移机"。**

**好在标定很简单**，而且我们已经有现成的模式可以照搬：

> 水平零点就是这么干的：**上电、静止时采几秒取平均，作为本场次的零点**。
> 光流用同一套：**每次上电、飞机静止时采几秒光流的平均，之后每帧减掉它。**

⇒ **不需要转台、不需要已知位移的滑动测试、不需要 counts-per-radian。**

代价：得到的是"**把相对地面的运动压到零**"（= 钉住），**不是**回到某个绝对坐标。长期仍有缓慢漂移——这是光流的固有性质。

### ⭐ 预期能到什么水平（先把期望定下来）

| 方案 | 松杆后实际表现 |
|---|---|
| **现在**（纯姿态，无位置反馈） | 起飞漂 2~5 米，之后持续缓慢漂 |
| **光流 + 位置环**（本表 OF1~OF12 的档次，≈ 商家 demo） | 原地游走 **±20~50cm**；短时间不会跑出 1 米 |
| **光流 + 加速度计融合**（再加 OF13） | **±10~20cm**，明显更"钉" |
| RTK | ±2~5cm（真厘米级，但贵、只能室外） |
| UWB | ±10cm（室内，要布站） |

**结论**：相比现在是**数量级改善**，但**"厘米级"要理解成"十几厘米级"**。真"几厘米"要靠 RTK / UWB。
想要"十几厘米"这一档，**零点偏移标定（OF5）和 IMU 融合（OF13）两个都要有**。

另外：**定点效果好不好，一半取决于地面**——有纹理的地板最好；纯色瓷砖/抛光地面/地毯差很多甚至失效；太暗（<60Lux）、水面、镜面直接失效；室外有风会顺风飘（我们没有风估计）。

### 从商家 demo 里抄什么 / 不抄什么

> ⭐ **2026-09-18：demo 源码已经解出来逐行读过了**，留档在
> `技术文档/mini光流资料/demo代码/`（含 UTF-8 可读版 + 原始 GBK 版 + 一份 README）。
> （RAR4 压缩，用 **Windows 自带的 `tar.exe`（bsdtar/libarchive）** 就能解，不用装 7-Zip。）
> 读完挖出**两条缺陷**，正好是我们要补的：

| # | demo 的做法 | 后果 | 我们怎么做 |
|---|---|---|---|
| **1** | ⭐ **完全不看 `Quality`**（`flow_decode()` 从头到尾没读过 `buf[7]`，尽管协议图明确写着"30 以下建议舍弃"） | 镜头被挡 / 对着纯色地面时模块报"**0 流量 + 低质量**"，环路会读成"**飞机完全静止**" ⇒ **控制器以为钉住了、实际在飘** | **Quality < 30 判该帧无效 + 冻结数据**（OF3） |
| **2** | ⭐⭐ **完全不做零点标定**（`speed_x = -flow_x` 直接取反） | 位置环是**纯 P、目标恒 0**，它把"测到的累积流量"压到 0；静止时若本来报 +3/帧，环路就会让飞机**真的往反方向匀速移动** ⇒ **这就是"恒速漂移机"** | **上电静止采 10 秒取平均当零点**，之后每帧减掉（OF5；v0.24 由 1 秒改为 10 秒）← **不是可选优化，是能不能用的前提** |

| 抄 | 不抄 |
|---|---|
| ⭐ **按高度调增益**（flow ∝ 1/高度，所以增益要随高度增大） | **PID 参数**（`KKP=0.1`、`KP=12`、`KD=1`）——那是他们机架、他们量纲下的值 |
| **摇杆居中才使能**的门禁（他们用 ±30） | `-flow_x` 的**符号与轴映射**——必须自己实测（OF4 手推测试） |
| 位置环 / 速度环两级 + 输出低通（约 2.5Hz）的结构 | 固定 7 档的高度表（1.0→1.7；**只补了一半**，物理上应 ∝ 高度） |
| **Quality 判据 + 限幅** 的思路 | 用"欧拉角差分"补偿光流（他们自己都注释掉了） |
| 退出时**清累积 + 复位 PID 状态**（无扰切换） | 只查累加和、不查 `buf[1]==0x04` / `buf[8]==0xAA` 的解析方式 |
| ⚠️ 但**零点标定他们没做** —— 这是我们比 demo 做得细的地方 | 用**写死的 0.05s** 积分（传感器实际是 40ms；我们直接累加计数） |

---

## 排序规则（七条）

1. **先让数据"看得见"，再谈控制** —— 串口 → 解析 → 有效性 → 累积，前四步全是只读；
2. ⭐ **先标零点，再谈闭环** —— 光流的零点偏移不标就是恒速漂移，闭环前必须解决；
3. **先算出来，再发出去** —— 位置环先在台架上跑通、只打印，**不接姿态**，这一步零炸机风险；
4. **先无扰，再接管** —— 使能门禁与切换无跳变，必须排在"第一次接控制"之前；
5. ⭐ **高度估计先行，但不必等定高**（2026-09-18 更正）—— 定点依赖的是**高度估计**
   （光流要靠高度才能把流量换成速度），那是 H1~H6 的产物，**已经做完了**。
   原来的"定点只在定高模式下起作用、必须在定高模式+已解锁+杆不在待命段时做"**作废**
   （待命段已取消；定点也不必绑定高）。
   现在建议：**第一次接控制先跑在普通模式下** —— 油门由人管、垂直那一路不参与，
   出问题时只有一个新环在动，容易定位；
6. **权限从极小开始** —— 第一次接管只给 **±3°**，方向反了也能救；
7. **先验证，再整定** —— 每次改参数都必须有黑匣子波形作依据。

---

## 施工顺序表

图例：🖥 纯软件可验证 ／ 🔧 需要台架 ／ ✈️ 需要飞行 ／ ⚠️ 有炸机风险

| # | 环节 | 依赖 | 类型 | 改动 | 验证方式 | 风险 |
|---|---|---|---|---|---|---|
| **OF1**<br>**OF2** | ✅ **v0.23 已真机验证 · 串口接入 + 帧解析**（两条合并成一批做）<br>本板没预留接口，因此摘掉 GPS、光流接 USART2（GPS 座），开关是 `APEX_UART2_ROLE_FLOW`。四重校验失败只丢一个字节重新同步。<br>2026-09-21 实测：正常每 500ms 增加 12~14 帧，Quality 168~255，checksum 恒 0；format 偶发但能自动恢复，继续观察 | 硬件到手 | 🖥🔧 | `Modules/Flow/*`、`apex_config.h`、`usart.c`、`gps.c`、`app_freertos.c`、`tof.c`、`.uvprojx` | 真机帧率约 25Hz、质量远高于 30、解析持续工作 | 低 |
| **OF3** | ✅ **v0.23 已真机验证 · 失效判据 + `valid` 标志**<br>连续 3 帧 Quality < 30、或 >200ms 没有合格帧 → `valid=0` 并冻结。2026-09-21 遮挡实测：304 个低质量帧期间 `sx/sy` 变化严格为 0；TX 断开约 16 秒期间 `n` 不变、`sx/sy` 变化严格为 0，接回自动恢复 | OF2 | 🖥🔧 | 同上 | ✅ 遮挡、断 TX、冻结、恢复全部通过，证据见留样文档 | 低 |
| **OF4** | ✅ **v0.23 已取真机方向证据 · 累积流量与符号**<br>`sum += dx − 零点`，不乘 dt；另输出 `vx/vy`。实测向前 `sx/sy` 同增、向后同减、向右 `sx` 减而 `sy` 增、向左相反。模块镜头垂直向下，仅在水平面内相对机体系约旋转 58°；OF6 用二维旋转并在只打印阶段复核精确角度 | OF3 | 🖥🔧 | 同上；OF6 增加机体系旋转 | 正反方向已通过；精确角度和尺度在 OF6 台架复核 | 低 |
| **OF5** | ✅ **v0.24 已真机验证 · 零点偏移标定**<br>v0.23 的 25 帧窗口被真机证据否定；v0.24 改为 250 帧（约 10 秒）并打印 4 位小数。实测 `z=-0.0040,0`，标定后 1653 帧/66.12 秒仅漂 6.6/0 计数，每帧残差 0.003993，较旧版改善 10.02 倍。0.004 级残差留到 OF6 根据真实位移尺度评估，不凭空加死区 | OF4 | 🖥🔧 | `flow.c`、`tof.c`、`sim_flow.c`、文档 | ✅ OF5 基线 37/37；真机 60 秒静止复测通过 | 低 |
| **OF6** | ✅ **v0.25 真机台架通过 · 位置环 + 速度环（只算不下发）**<br>光流坐标按约 **54°** 旋到机体前/右；2026-09-27 前后/左右原始流量复核得到 53～54°；位置 P 环 12.5Hz（2 分频）、速度 P 环 25Hz、输出低通 2.5Hz；输出限幅 ±3°，只打印 `[PC]` | OF5 | 🔧 | `Modules/Control/position_control.c/.h`、`flow.c`、`tof.c`、`.uvprojx`、仿真 | `z=-0.0040,+0.0040`；前后/左右主轴、副轴和符号一致；输出未越限；**全程不接姿态环** | 中 |
| **OF7** | 🔨 **v0.25 模块与仿真完成，遥控请求留到 OF10**<br>状态机、请求门禁、当前位置锚定、手动飞行态、故障锁存、关开请求后重新锚定；只打印，不接姿态 | OF6 | 🖥🔧 | `position_control.c/.h`、仿真、打印清理 | 仿真 16/16；待 OF10 接入独立遥控请求后做真机切换验收 | 中 |
| **OF8** | 🔨 **v0.27 安全门禁代码完成，待拆桨台架验收**<br>姿态、有效高度、解锁/内环许可接入定点门禁；运行中光流、链路、姿态或高度异常 → 输出归零并锁存；恢复后必须关开请求 | OF7 + OF10 | 🖥🔧 | `position_control.c/.h`、`flow.c`、`motor_test.c`、`tof.c` | 宿主机 22/22；拆桨验证 WAITING、ACTIVE、PILOT_MOVE、FAULT_LATCHED、故障原因和请求重开 | 中 |
| **OF9** | 🔨 **v0.28 黑匣子定点扩展记录代码完成，待真机 dump 验收**<br>新增独立 64 字节定点记录，保存 flow dx/dy/quality、累积流量、零点、速度/目标速度、raw/out 姿态目标和状态；不改变旧姿态样本布局 | OF8 | 🖥🔧 | `blackbox.c/.h`、`flow.c`、仿真桩 | 编译烧录后解锁一场，`dump` 能看到 `# position_log` 和定点列；记录约 12.5Hz，旧 CSV 仍可读 | 低 |
| **OF10** | ✅ **v0.26 两端代码与真机联调通过**<br>新增独立定点请求位；遥控器设置页可开关请求，仪表盘显示 `DISABLED/WAITING/ACTIVE/PILOT_MOVE/FAULT_LATCHED` 实际状态；不复用定高 `flight_mode` | OF7 | 🖥🔧 | 飞控协议/Flow/Radio + `CoreFly F2 Remoto` 协议/无线任务/UI | 已验证请求开关、手动飞行态、重新锚定、故障锁存和恢复；UI 有轻微显示问题，不影响控制，暂不处理 | 低 |
| **OF11** | 🔨 **v0.29 姿态目标接入代码完成，待拆桨台架验收**<br>位置环/速度环输出接入原有横滚/俯仰目标角，普通模式生效，修正角保持 **±8°**；定高模式暂不叠加 | OF9 + OF10 | ✈️⚠️ | `motor_test.c`、`attitude_control.c/.h` | 拆桨确认 ACTIVE 时姿态目标通道有响应；PILOT_MOVE/故障时修正为 0；之后才做限位绳/低风险悬停 | **高** |
| **OF12** | **整定 + 按高度连续补偿增益 + 加大权限**<br>`Kp_eff = Kp_base × (h / h_ref)`，限幅；在 ±8° 基线上验证，必要时再评估到 ±10° | OF11 | ✈️ | 参数 + `position_control` | 松杆能钉住，漂移明显变小；用黑匣子波形整定。目标：**±20~50cm 游走** | 中 |
| **OF13** | ⭐ **光流 + 加速度计融合**（本表新增，对照定高的 H16）<br>互补滤波：高位交给加速度计、低频漂移交给光流；顺便估计光流的残余零点偏移。**只换速度来源，控制律一行不改** | OF12 | 🖥✈️ | 新增/扩展一个水平估计器 | 波形对比：融合后高频更顺、滞后更小；**重新整定**。目标：**±10~20cm 游走** | 中 |
| **OF14** | **与定高整合：松杆悬停**<br>定高 + 定点同时生效 = 高度和水平都钉住 | OF12 + 定高完成 | ✈️ | `motor_test.c` | 松杆后基本悬停不动 | 中高 |
| **OF15** | 🔨 **v0.31 在线调参与参数历史代码完成，待机载端编译和链路验收**<br>新增定点位置环/速度环 KP、KI、KD 共 6 项；支持遥控 SET、SAVE、LOAD、上电自动加载；黑匣子场次头记录本场定点增益，并为每次成功 SET/LOAD 写入完整 39 项参数版本和 SAVE 标记 | OF11 | 🖥🔧 | 飞控/遥控协议、`pid_table`、`position_control`、`blackbox`、遥控器 PID 页 | 39 项参数 GET/SET；2.0→2.5→3.0 版本记录与对应飞行日志连续可追溯；SAVE/断电恢复 | 中 |

---

## OF1~OF5 验收步骤（2026-09-21：全部通过，保留作回归基线）

⚠️ **全程拆桨**（本阶段光流不接任何控制，拆不拆桨都安全；拆桨可以顺便听电机）。

### 烧录前

1. ⭐⭐ **断电，量 GPS 座 VCC–GND = 3.3V**，核对线序，再把光流插上（只接 **GND + TX** 两根）；
2. 确认 `Core/Inc/apex_config.h` 里 `APEX_UART2_ROLE_FLOW = 1`；
3. Keil 编译烧录（**只烧飞控，遥控端一行没动**）。

### 观测：只看 `[OF]` 一行

```
[OF] n=帧数 bad=累加和/格式 qrej=质量拒绝 | q=质量 dx dy | z=零点 | sx sy | v=可用 cal=标定态 a=age
```

| # | 操作 | 期望 |
|---|---|---|
| ① | 上电 | `[OF]` 行出现；`n` 持续增长；`q` **远大于 30** |
| ② | ⭐⭐ 上电静止至少 70 秒 | 前约 10 秒 `cal=1`，随后变 **2**；再静止 60 秒，`sx/sy` 不应持续单向增长 |
| ③ | ⭐⭐ **用手沿机头方向缓慢平移** | 对应轴 `s` **单调变化**；反向平移 → 反向变化 |
| ④ | 盖住镜头 / 对着纯色面 | `q` < 30 ⇒ `v=0`、`sx/sy` **冻结**、`qrej` 增长 |
| ⑤ | 拔信号线 | `v=0`、`a` 涨过 200ms；插回后自动恢复 |
| ⑥ | 拿着飞机晃动几下再看 `cal` | 若晃动正好落在采样期 ⇒ `cal=3`（判失败）→ 1 秒后自动重来，**不许留下坏零点** |
| ⑦ | 换一块地面重新上电 | 重标之后 `sx/sy` 仍能压住 |
| ⑧ | ⭐ **回归**：普通模式 / 定高模式各走一遍 | `[V]` 行与改动前**完全一致** |

### 停止条件（出现任一条先停下来）

1. 插之前量到的**不是 3.3V** ⇒ 先断电，不许插；
2. `q` 长期 < 30、或帧率远低于 25Hz ⇒ **接线/波特率/供电有问题，不要再往下做**；
3. 静止时 `sx/sy` **持续单向快速增长** ⇒ 标定没生效；
4. 平移测试方向与机头完全对不上 ⇒ 轴映射写错；
5. 普通模式或定高模式出现**任何**与改动前不同的现象。

### 软件侧已做的自查（不碰硬件）

- `arm-none-eabi-gcc -fsyntax-only -Wall -Wextra -Wformat=2`：**两种开关状态都全绿**
  （role=1 光流 / role=0 GPS）；
- ⭐ **符号互斥在目标文件层面验过**：`HAL_UARTEx_RxEventCallback` / `HAL_UART_ErrorCallback`
  在 role=1 时只定义在 `flow.o`、role=0 时只定义在 `gps.o`（用 `nm --defined-only` 查的，
  **不是靠读代码**）—— 这条是 2026-09 串口回显测试踩过 `L6200E` 之后专门加的检查；
- ⭐ **宿主机仿真 `sim_flow.c`：39 项全过** —— 驱动的是 `flow.c` 里**真的 `Flow_Task`**
  （外设与 RTOS 是桩，用"反向控制"让 `osDelay/taskYIELD` 去推进仿真世界，
  于是整场跑在同一个栈帧里、`Flow_Init` 只执行一次，而循环体是产品代码原文）。
  覆盖：正常帧流、**DMA 缓冲绕回**、坏校验/坏长度/坏包尾、**半截帧跨事件拼装**、
  **粘包**、帧中插噪声后的**重新同步**、质量门槛边界（29 / 30）、**标定期间不累积**、
  **质量失效时冻结而不是清零**、超时失效与恢复、**标定守卫与自动重试**、
  以及 250 帧窗口把单个异常计数的零点影响从 0.04 降到 0.004 的回归。

- ⭐ **OF6/OF7 独立仿真 `sim_position_control.c`：16 项全过** —— 覆盖 58° 旋转、前/右轴解耦、
  位置环 12.5Hz、速度环 25Hz、回拉符号、当前位置锚定、手动飞行态、门禁锁存、请求重开、±8° 限幅、
  2.5Hz 低通、失效归零和恢复。

  ⚠️ 仿真抓出我**一条写错的判据**（把"累加和错 2 次"写成了 1 次）：帧中间插噪声会让窗口错位，
  而**错位窗口几乎都先在累加和这一步被拦下** ⇒ checksum 计数会多一次。
  这条差别本身有用：**"checksum 一直在涨"未必是波特率问题，也可能只是有噪声字节**。

---

## 三个关键节点

| 节点 | 在哪 | 为什么重要 |
|---|---|---|
| **第一个"零风险可验证"的里程碑** | **OF7 结束** | 到此为止**绝不接控制**，但解析、有效性、累积、轴符号、**零点标定**、位置环、门禁、无扰切换**全部验完了**。台架上就能做，不用飞 |
| **第一个"有炸机风险"的动作** | **OF11** | 位置环的输出第一次真的会推动姿态。之前所有环节都可以在桨叶拆掉或飞机固定住的条件下做 |
| **第一个"必须拿到数据才能继续"的点** | **OF12** | 从这里开始，每次改参数都必须先导黑匣子看波形 |

---

## 可以并行 / 合并的

- **OF1 与 OF2 可以合并**：接线对了、字节进来了，直接往下解析就是；
- **OF3 / OF4 / OF5 可以合并**：都是"只读只算"，一起验也不冲突；
- **OF9（黑匣子）与 OF10（遥控器）可以并行**（不同仓库），但 **OF9 必须赶在 OF11 之前**；
- **OF15 可以和整定并行**，但它动协议，要单独走一轮遥控器升级；
- **OF14 必须等定高整套做完**（H13~H19）。

---

## 与现有文档的关系

| 文档 | 关系 |
|---|---|
| `高度接入飞控方案.md` | **前置**。定高的研究方案；本文的 OF3/OF5/OF7/OF8 直接复用它的"valid + 冻结 + 重启间隔 + 采集取平均"模式 |
| `高度接入施工顺序.md` | **前置**。定高的 H1~H20；本文的 OF11 依赖定高可用（H13/H14），OF14 依赖定高整套完成 |
| `技术文档/mini光流资料/` | 硬件一手资料：协议图、docx 教程、demo 代码（**注意 demo 文件名写 iic，其实是串口版**） |
| ArduPilot 官方页 `Cheerson CX-OF` | 权威参考：`FLOW_TYPE=4`、**`EK2_FLOW_DELAY=80`（延迟来源）**、`FLOW_POS_X/Z`（安装位置补偿） |
| `定高与油门专题.md` | 定高的现状与历史；定点的结论将来回写进这里 |

---

## OF6 软件实现与台架验收（v0.25，已通过）

### 软件侧改动

- `Modules/Control/position_control.c/.h`：固定初始旋转系数 `cos=0.5878`、`sin=0.8090`（约 54°）；位置 Kp=`0.50/s`，目标速度限幅 ±200 count/s；速度 Kp=`0.010 deg/(count/s)`，角度限幅 ±8°；输出一阶低通 2.5Hz。
- `Modules/Flow/flow.c`：每个合格、已标定光流帧更新一次；光流失效或标定未完成时清输出。
- `Modules/ToF/tof.c`：每 500ms 增加一行 `[PC]`，只打印位置、速度、目标速度和 roll/pitch 角。
- `motor_test.c`、姿态环、混控、油门、定高逻辑均未接入。

### 台架结论

- 用户确认机体与光流镜头到桌面的实际高度保持约 15cm；ToF 安装在底座内侧，左右摆放时底座会遮挡 ToF，导致 `[V] raw/h` 从约 15cm 降到几厘米。这是 ToF 遥测遮挡，不代表光流高度变化，不能用它否定左右段数据。
- 上电标定完成后 `z=-0.0040,+0.0040`；静止段 `pF/pR` 仅小幅缓慢变化，未出现上一场的坏零点漂移。
- 前移 `pitch` 正、后移 `pitch` 负、右移 `roll` 负、左移过程出现正确的正向刹车 roll；位置/速度更新次数约 2:1，输出保持在 ±3° 内。
- 中间设备断开和末段乱码属于日志窗口链路干扰；光流数据随后恢复，未改变 OF6 控制结论。

### 真机步骤（拆桨）

1. 断电，量 GPS 座 VCC–GND 必须为 3.3V；光流仍只接 GND + TX；确认 `APEX_UART2_ROLE_FLOW=1`。
2. Keil 编译烧录，静止等待至少 70 秒，确认 `[OF] cal=2`、`[PC] ok=1`，且 `[PC] n=` 的前后两个计数约为 2:1。
3. 在约 15cm 高度、机体保持水平，用手沿机头方向前后各平移约 20cm，再沿机体右方向左右各平移约 20cm；每个方向做正反动作并留日志。
4. 期望方向：前移 `pitch` 正、后移 `pitch` 负、右移 `roll` 负、左移 `roll` 正；主轴明显变化，副轴不超过主轴约 20%。
5. 盖住镜头，再断开 TX：`[OF] v=0` 后 `[PC] ok=0 out=+0.00,+0.00`；恢复纹理/接回 TX 后自动恢复。
6. 普通模式与定高模式各走一遍，`[V]` 行、油门和电机行为必须与 v0.24 一致。

### 回归停止条件

- 若后续回归出现方向反、前后/左右明显串轴、输出长期撞 ±3°、失效时 `out` 不归零、或 `[V]` 行/电机行为变化：停止后续环节，回到 OF6 排查。

---

## OF7 模块实现（v0.25）

- `position_hold_request` 已作为模块接口加入；当前诊断构建默认请求为真，只为保持 `[PC]` 只打印链路可见。
- 门禁位：请求、链路、光流有效、摇杆中心、控制许可；完整门禁为 `0x1F`。
- 状态：`0=DISABLED`、`1=WAITING`、`2=ACTIVE`、`3=FAULT_LATCHED`、`4=PILOT_MOVE`。
- 进入 ACTIVE 时捕获当前旋转后位置为新锚点；退出或光流失效后锁存，必须关开请求才重新锚定。
- 真实遥控请求不复用现有定高 `flight_mode`，留到 OF10 增加独立请求位。

### 串口打印清理

- 保留 `[V]`、`[OF]`、`[PC]` 和 ToF/黑匣子/磁力计故障信息。
- 删除 ToF 正常初始化、I2C2 扫描成功、黑匣子参数/磁力计正常加载、日志索引成功和黑匣子周期状态横幅。
- 保留用户主动命令的结果、写入失败、传感器故障和 dump 过程信息。

---

## OF10 两端联调验收清单（v0.26）

### 软件与协议

1. 飞控和遥控器的 `APEX_CONTROL_FLAG_POSITION_HOLD_REQUESTED` 都为 `0x02`。
2. 遥控器上电后请求默认关闭，控制帧默认不带该位。
3. 飞控 `flight_mode` 的 bit0~2 仍是垂直模式，bit4~6 是定点状态，bit7 仍是垂直模式拒绝标志。
4. 两端协议编解码通过；普通控制帧、定高请求、ARM 请求、PID 命令回归不变。
5. 飞控和遥控器都能通过 ARM GCC/Keil 工程语法或编译检查。

### 拆桨真机

1. 遥控器设置页显示“定点请求：关闭”；上电后飞控 `[PC] req=0`、`st=0`。
2. 打开定点请求，等待光流 `cal=2`、摇杆回中，飞控显示 `req=1 gate=0x1F st=2`；遥控器显示“定点生效”。
3. 手动推前/后/左/右：飞控进入 `st=4`，`out` 归零；遥控器显示“手动飞行”。
4. 松杆回中并保持约 200ms：回到 `st=2`，位置重新锚定，`p` 接近 0，输出从零开始。
5. 重复 A 点 → B 点 → 松杆 → C 点 → 松杆，确认每次松杆后的新位置都能重新定点。
6. 关闭定点请求：飞控回 `st=0`，输出归零；遥控器显示“定点关闭”。
7. 盖镜头或拔 TX：飞控进入 `st=3`，输出归零；遥控器显示“定点锁存”。
8. 恢复光流/TX：状态仍保持 `st=3`，不会自动接管。
9. 关开定点请求：重新进入 `st=2`，以当前位置重新锚定。
10. 定点请求关闭时，普通模式和定高模式各走一遍，`[V]`、油门和电机行为与 OF10 前一致。

---

## OF8 安全门禁验收清单（v0.27）

### 代码与仿真

- `PositionControl_SetPilotContext()` 只接收链路和摇杆状态；姿态、有效高度、解锁/内环许可由 250Hz 控制环通过 `PositionControl_SetSafetyContext()` 发布。
- 安全门禁不满足时，`gate` 的许可位（bit4）关闭；位置/速度环输出为 0。
- 运行中从 `ACTIVE` 或 `PILOT_MOVE` 遇到光流、链路或姿态/高度安全故障时进入 `FAULT_LATCHED`；恢复数据不会自动接管。
- `[PC]` 新增 `fr`：`0=无`、`1=光流`、`2=链路`、`3=姿态`、`4=高度`、`5=许可`。
- 宿主机位置控制仿真：**22/22**；`sim_flow.c` 回归：**39/39**；飞控 ARM GCC 语法检查通过。

### 用户拆桨台架步骤

1. 拆桨，烧录飞控；遥控端沿用已通过 OF10 的程序。确认光流 `cal=2`，ToF 有效，IMU 内环完成初始化。
2. 定点请求关闭：确认 `[PC] req=0 st=0`，输出为 0。
3. 请求打开但未解锁：确认许可门禁未打开，状态为 `WAITING`，`fr=5`，输出为 0。
4. 拆桨解锁、摇杆回中、机体保持水平：确认 `gate=0x1F st=2`，进入 `ACTIVE`。
5. 推动摇杆：确认进入 `st=4`，输出归零；回中保持约 200ms，回到 `st=2` 并重新锚定。
6. 在 `ACTIVE` 时让机体姿态超过现有 `±30°` 门限：确认进入 `st=3 fr=3`，输出归零。
7. 恢复水平姿态：确认仍为 `st=3`，不会自动恢复；关闭再打开定点请求后才回到 `st=2`。
8. 在 `ACTIVE` 时盖住光流：确认进入 `st=3 fr=1`，输出归零；恢复纹理后仍保持锁存。
9. 在 `ACTIVE` 时拔 TX：确认进入 `st=3 fr=2`，输出归零；重新接回后仍保持锁存。
10. 高度门禁用仿真确认 `WAITING/fr=4`；真机高度测试必须保证 ToF 下方无遮挡，不能把底座遮挡造成的假低值当作真实高度变化。

### OF8 停止条件

- 任一故障后 `out` 仍非零、恢复传感器后自动回到 `ACTIVE`、姿态门禁误触发、或普通模式油门/姿态行为变化，停止测试并回到 OF8 排查。

⚠️ OF8 只负责定点输出的退出和锁存。TX 失联后整机 `armed=false`、电机降到 1000us 的总失联策略仍是独立待办，必须在 OF11 首次接管前单独处理。

---

## OF9 黑匣子验收清单（v0.28）

1. 编译烧录飞控端 OF9；遥控端不需要升级。
2. 拆桨解锁并保持一场短日志，依次覆盖：定点关闭、`ACTIVE`、摇杆移动、回中重新锚定；允许保留一次光流故障锁存。
3. 上锁后通过 USART3 发送 `dump`，确认导出中出现：
   - `# position_log`
   - `pos_t_ms,flow_dx,flow_dy,flow_q,flow_valid,...`
   - `flow_sum_x/y`、`flow_zero_x/y`
   - `vel_f/vel_r`、`vel_sp_f/vel_sp_r`
   - `raw_roll/raw_pitch`、`roll/pitch`
   - `pc_state`、`pc_gate`、`pc_fault`
4. 检查普通姿态样本的原有 CSV 表头和列数不变，旧的 `alt_state/armed/conn` 数据仍能正常导出。
5. 检查定点扩展记录的采样时间单调增加，约每 80ms 一条；时间取光流任务采样时刻，不受 Flash 队列排队延迟影响；`pc_fault=1/2/3/4/5` 与对应故障场景一致。
6. 发送 `dumpall` 时，新记录的 magic、type、CRC 均能通过，不出现连续无效记录。

OF9 通过后，才进入 OF11 的第一次姿态环接入；OF11 仍需单独做失联保护收尾和风险评估。

---

## OF11 姿态环接入验收清单（v0.29）

### 代码行为

1. 定点关闭、`WAITING`、`PILOT_MOVE`、`FAULT_LATCHED` 时，传给姿态环的定点横滚/俯仰修正为 0。
2. 普通模式下 `ACTIVE && valid` 时，使用 `position_control.roll_deg/pitch_deg` 作为姿态修正输入。
3. 定高模式暂不使用定点修正，避免 OF11 同时引入水平和垂直两路控制。
4. 修正角仍由位置控制模块限制在 ±3°；原有姿态角环、角速度环和 PID 参数不改。

### 拆桨台架

1. 确认原有姿态环内环已启用，拆掉全部桨叶。
2. 定点关闭，记录普通模式姿态和电机输出作为基线。
3. 打开定点请求，确认 `ACTIVE`；手动移动机体或制造光流位移，观察姿态修正方向和电机混控修正开始响应。
4. 推动摇杆进入 `PILOT_MOVE`，确认定点修正归零，手动姿态通道仍可用。
5. 盖镜头、拔光流输入或触发高度门禁，确认定点修正归零；姿态环本身仍按普通模式运行。
6. 检查修正方向：前向偏移应产生反向俯仰，右向偏移应产生反向横滚；修正角不得超过 ±8°。

### 进入有动力测试前

- 先处理或明确总失联保护：当前 TX 失联会让整机 `armed=false` 并把电机降到 1000us。
- 拆桨台架通过后，才允许进入限位绳/低风险悬停；首次只用普通模式和人工油门。
