Nyxarian/ApexFly-v2.0/优化一下/阶段0基线记录.md

# ApexFly V2.0 · 阶段 0 基线记录

> 记录时间：2026-10-01 10:13 UTC  
> 对应方案：[IMU与光流整体优化施工方案.md](./IMU与光流整体优化施工方案.md)  
> 阶段：0 · 冻结基线  
> 状态：完成

## 1. 本阶段边界

本阶段只做只读盘点和主机验证：

- 未修改固件源代码；
- 未修改 Keil 工程文件；
- 未修改协议、参数或配置；
- 未烧录、未擦除、未连接目标板；
- 未清理原有 OF15 未提交改动；
- 本轮生成的临时仿真可执行文件已删除。

## 2. Git 基线

### 当前分支和 HEAD

```text
branch: master
HEAD: a2ac82e OF11: 接入定点姿态目标基线
```

### 已修改但未提交的文件

```text
ApexFly v2.0/Modules/Communication/apex_protocol.h
ApexFly v2.0/Modules/Control/pid_table.c
ApexFly v2.0/Modules/Control/pid_table.h
ApexFly v2.0/Modules/Control/position_control.c
ApexFly v2.0/Modules/Flash/blackbox.c
ApexFly v2.0/Modules/Flash/blackbox.h
ApexFly v2.0/Modules/ToF/tof.c
优化一下/会话交接.md
优化一下/光流定点施工顺序.md
```

统计：9 个已跟踪文件，约 547 行新增、96 行删除。

### 未跟踪文件

```text
ApexFly v2.0/MDK-ARM/.clangd
优化一下/DeepSeek Harness 交接.md
优化一下/IMU与光流整体优化施工方案.md
优化一下/代码学习计划.md
硬件/
```

其中 `IMU与光流整体优化施工方案.md` 是本轮新增方案文件；其他未跟踪内容属于本阶段之前已存在的工作区内容，未做处理。

## 3. OF15 工作区确认

当前未提交改动集中在：

- 39 项参数协议和参数表；
- 定点位置/速度环参数；
- 黑匣子参数历史与定点扩展记录；
- 定点控制参数读取；
- ToF/打印相关代码；
- 施工顺序和会话交接文档。

本阶段确认：阶段 1 不应覆盖、回滚或重排这些改动。后续 IMU 修改必须单独识别 diff，不能把 OF15 文件的既有改动误当成本轮改动。

## 4. 当前代码基线

### IMU

当前调用链仍为：

```text
motor_test.c
  IMU_GyroBias_Start()
  IMU_Level_Start()
  IMU_Attitude_Update()
  IMU_Level_Update()
  IMU_Level_Apply()
```

确认位置：

- `motor_test.c:356` 启动陀螺零偏和水平采样；
- `motor_test.c:357` 启动 200 点水平采样；
- `motor_test.c:442` 水平采样门禁失败时重新开始；
- `motor_test.c:446` 收集水平姿态；
- `motor_test.c:457` 把平均水平偏置应用到 body 姿态；
- `imu_level.c:16` 实现采样；
- `imu_level.c:60` 实现横滚/俯仰减偏置。

这确认阶段 1 的第一目标仍然是取消“每次上电动态水平清零”，不是修改陀螺仪零偏流程。

### 光流/定点

当前调用链仍为：

```text
flow.c
  Flow_OnFrame()
  PositionControl_Update()

motor_test.c
  PositionControl_GetSnapshot()
  AttitudeControl_Update(... position_roll_offset_deg, position_pitch_offset_deg ...)
```

当前默认定点参数仍为：

```text
position_kp = 0.50
position_ki = 0.0
position_kd = 0.0
velocity_kp = 0.010
velocity_ki = 0.0
velocity_kd = 0.0
```

当前普通模式会叠加定点姿态修正，定高模式暂不叠加；这一行为不在阶段 0 修改。

## 5. 主机验证

### 光流仿真

使用现有 `sim_flow.exe` 运行：

```text
结果：39 项检查，失败 0 项
```

覆盖：帧解析、DMA 绕回、坏帧、半帧、粘包、噪声重同步、质量门禁、250 帧零点标定、冻结、超时和恢复。

注意：直接从当前源码重新编译光流仿真时，旧仿真桩与当前 HAL 头文件存在已有声明不一致：

```text
error: conflicting types for 'HAL_UARTEx_GetRxEventType'
have 'HAL_UART_RxEventTypeTypeDef(UART_HandleTypeDef *)'
previous declaration ... 'const UART_HandleTypeDef *'
```

这属于阶段 0 发现的既有仿真构建问题。现有可执行文件可运行并通过 39/39；本阶段不修它，避免把仿真桩修复混入 IMU 变更。

### 位置控制仿真

使用当前产品 `position_control.c`，加 `POSITION_CONTROL_SIM` 和现有桩重新编译运行：

```text
结果：22 项检查，失败 0 项
```

覆盖：坐标旋转、两级环、限幅、低通、失效、锚定、手动飞行态、故障锁存、高度门禁和请求重开。

### Keil 历史构建记录

现有 `compiler.log` 最后更新时间为 2026-09-27 16:55，记录：

```text
ARM Compiler 5.06 update 5
Program Size: Code=101440 RO-data=4248 RW-data=524 ZI-data=50452
```

该日志早于本阶段新增方案文件，且不能证明当前 OF15 工作区已由用户重新编译。阶段 0 不把它当作当前工作区真机编译通过证据。

## 6. 阶段 0 结论

1. 当前工作区存在 OF15 未提交改动，后续必须避开覆盖。
2. 当前 IMU 每次上电动态水平清零调用链已确认，阶段 1 修改目标明确。
3. 光流已有 39/39 主机回归可执行结果。
4. 位置控制当前源码重新编译运行 22/22 通过。
5. 光流仿真源码重编译存在 HAL 桩头 `const` 声明不一致，暂不修复。
6. 阶段 1 可以从 `motor_test.c` 与 `imu_level.c/.h` 开始，不需要先改光流控制器。

## 7. 阶段 1 起点和停止条件

### 阶段 1 只做

- 保留陀螺仪零偏校准；
- 取消当前姿态被 `IMU_Level_Apply()` 动态减零；
- 保持普通姿态 PID、混控、光流协议和 OF15 参数链不变；
- 修改后重新跑现有位置/光流回归。

### 停止条件

- 需要回滚或覆盖 OF15 未提交内容；
- 需要修改 `.uvprojx` 但无法确认 Keil 已关闭；
- 发现姿态符号或机体系映射需要重新定义；
- 普通模式出现与水平基准修改无关的新电机行为；
- 主机回归从 39/39 或 22/22 下降。

## 8. 本阶段提交

阶段 0 是基线文档节点。本文件新增但尚未提交，是否与下一阶段代码一起提交按用户后续确认执行。
