Nyxarian/ApexFly-v2.0/优化一下/光流OF1~OF5真机验收留样.md

# 光流 OF1~OF5 真机验收留样

> 日期：2026-09-21
> 基线：v0.23 光流接入代码
> 模块：CX-OF，USART2 19200，约 25Hz
> 安装：镜头垂直向下；模块 XY 在机体水平面内约旋转 58°，计划在 OF6 做二维坐标旋转
> 本文件保留真实测试证据、结论和随后实施的 OF5 修正。原始长日志不粘入交接文档。

## 1. 日志来源

| 组别 | 环境与动作 | 原始日志 |
|---|---|---|
| A | 光流离桌面约 1cm，静止 | `C:\Users\fool\.codex\attachments\a847026a-57a8-4269-b428-de70d1151e22\已粘贴的文本.txt` |
| B | 光流/ToF 离桌面约 15cm，从上电开始静止 | `C:\Users\fool\.codex\attachments\cacaefba-36d7-45fb-867b-4359cd14a254\已粘贴的文本.txt` |
| C | 前进后退、右移左移 | `C:\Users\fool\.codex\attachments\9921130b-37b7-4bb2-8101-792a9a9eb684\已粘贴的文本.txt`、`C:\Users\fool\.codex\attachments\14e63859-9cec-424b-8b5b-b04719098447\已粘贴的文本.txt` |
| D | 先遮挡镜头，再断开 TX，最后恢复 | `C:\Users\fool\.codex\attachments\b6c01cef-3271-45fc-bd80-b7257e08e470\已粘贴的文本.txt` |
| E | v0.24，250 帧标定，约 15cm，静止复测 | `C:\Users\fool\.codex\attachments\c507eed5-3560-4054-af95-b60854302913\已粘贴的文本.txt` |

## 2. OF1/OF2：串口与解析

- 正常相邻打印中 `n` 每 500ms 增加 12~14，符合约 25Hz。
- Quality 在正常纹理地面为 168~255，远高于门槛 30。
- 所有留样中 checksum 错误保持 0。
- format 错误偶发增加，比例低且解析器能恢复；继续观察，不阻挡台架阶段。
- `age` 正常约 0~70ms，远低于 200ms 超时门槛。

结论：OF1/OF2 真机通过。

## 3. OF3：质量失效、冻结与掉线恢复

### 3.1 遮挡镜头

遮挡前后关键样本：

```text
[OF] n=665 qrej=0   | q=255 | sx=-92.4 sy=-203.6 | v=1 a=10ms
[OF] n=678 qrej=5   | q=0   | sx=-44.1 sy=-165.9 | v=0 a=203ms
[OF] n=982 qrej=309 | q=0   | sx=-44.1 sy=-165.9 | v=0 a=11275ms
[OF] n=995 qrej=316 | q=255 | sx=-126.8 sy=-247.2 | v=1 a=11ms
```

证据：

- 低质量帧仍能被解析并计入 `qrej`。
- `q=0` 后 `v=0`。
- 304 个低质量帧期间 `sx/sy` 变化量严格为 0，证明是冻结而不是清零。
- 移开遮挡后自动恢复 `v=1`，`cal` 保持 2，不需要重启或重标。

### 3.2 断开 TX

关键样本：

```text
[OF] n=1329 | sx=-19.5 sy=-119.5 | v=0 a=383ms
... n 始终为 1329，a 一直增加 ...
[OF] n=1329 | sx=-19.5 sy=-119.5 | v=0 a=16001ms
[OF] n=1358 | sx=-17.3 sy=-120.7 | v=1 a=30ms
```

证据：

- 断线期间 `n` 完全不增长。
- 超过 200ms 后 `v=0`。
- 约 16 秒掉线期间 `sx/sy` 变化量严格为 0。
- TX 接回后 DMA 和解析自动恢复，`v=1`，无需重启。

结论：OF3 的质量失效、超时失效、冻结、恢复全部真机通过。

## 4. OF4：方向与安装事实

用户实际操作：空间只有一条移动路线。前后测试完成后，把整架飞机连同光流旋转 90°，再沿同一路线完成左右测试。支架有几毫米高度误差，因此本轮只判方向，不拿计数做尺度标定。

| 机体动作 | `sx` | `sy` |
|---|---:|---:|
| 向前 | 增大 | 增大 |
| 向后 | 减小 | 减小 |
| 向右 | 减小 | 增大 |
| 向左 | 增大 | 减小 |

- 正反方向一致。
- 两组数据方向接近正交。
- 用户确认模块镜头垂直向下，不存在 roll/pitch 安装倾角；只有水平面内约 58° 的 yaw 安装角。
- OF6 使用可复核的二维旋转，不要求重装模块。初值：

```text
body_forward = +0.53 * flow_x + 0.85 * flow_y
body_right   = -0.85 * flow_x + 0.53 * flow_y
```

上式只是 OF6 台架初值，必须在“只算不下发”阶段用前后左右移动再次验证后才能冻结。

结论：OF4 的运动响应与符号已取得真机证据；精确安装角和尺度留给 OF6 台架标定。

## 5. OF5：25 帧标定暴露的问题

### 5.1 三组静止证据

| 组别 | `zero_x, zero_y` | 帧数与结果 |
|---|---|---|
| A，约 1cm | `+0.16,+0.08` | 522 帧内 `sx -87.5`、`sy -38.8` |
| B，约 15cm | `0.00,0.00` | 858 帧内 `sx/sy` 始终 0 |
| D，约 15cm | `-0.04,+0.04` | 601 帧内 `sx +23.1`、`sy -23.1` |

D 组理论预测与实测：

```text
X 理论：-(-0.04) × 601 = +24.04；实测 +23.1
Y 理论：-(+0.04) × 601 = -24.04；实测 -23.1
```

根因已确认：`dx/dy` 是整数。25 帧窗口中只要偶发一个 ±1，均值就是 ±0.04；之后即使原始值全为 0，逐帧减掉这个分数零点也会主动制造约 1 计数/秒的漂移。

### 5.2 2026-09-21 实施的修正

- `FLOW_CAL_FRAMES`：25 → **250**，标定时间约 1s → **10s**。
- 单个异常计数对零点的影响：0.04 → **0.004 计数/帧**，降低 10 倍。
- `[OF] z=`：2 位小数 → **4 位小数**，让 0.004 级残差可见。
- 不加任意死区，不做运行中自适应，不改变冻结、恢复和累积算法。
- 更新 `sim_flow.c`，增加“单个 -1 经 250 帧平均后零点为 -0.004，随后 250 帧静止只累积约 +1”的真实回归。

软件验证：

```text
sim_flow：37 项，失败 0 项
```

### 5.3 v0.24 真机验收结果

日志 E 从上电开始记录。文件首行属于上一次连接残片，统计从 `[BB] pid loaded` 后的新启动开始。

```text
标定前：cal=1，n=1...245
首次打印到标定完成：n=282，cal=2
零点：z=-0.0040,+0.0000
标定后末尾：n=1935，sx=+6.7，sy=0.0
```

精确统计：

| 项 | 结果 |
|---|---:|
| 标定窗口 | 250 帧，约 10 秒 |
| 标定后样本 | 1653 帧，估算 66.12 秒 |
| X 净漂移 | +6.6 计数 |
| X 每帧残差 | +0.003993 计数/帧 |
| X 每秒漂移 | 约 +0.0998 计数/秒 |
| Y 净漂移 | 0 |
| 相对旧版 0.04/帧改善 | **10.02 倍** |
| Quality | 恒 255 |
| `v=0` 次数 | 0 |
| checksum / format | 0 / 6，均能自动恢复 |
| ToF | 152~161mm，无重初始化 |

实际结果与 37 项仿真的“单个 -1 → `z=-0.004` → 250 帧静止约漂 +1”完全一致。
v0.24 达到预定的“至少改善 10 倍”验收标准，因此 OF5 结案。

仍保留的限制：0.004 级量化残差没有被消灭，只是压低。OF6 在“只算不下发”阶段根据实际位移尺度判断它是否足以影响控制；没有数据之前不继续加死区或自适应算法。

## 6. 当前结论

| 环节 | 状态 |
|---|---|
| OF1 串口接入 | ✅ 真机通过 |
| OF2 解析与重同步 | ✅ 真机通过，偶发 format 错误继续观察 |
| OF3 质量/超时失效、冻结、恢复 | ✅ 真机通过 |
| OF4 移动响应、方向与符号 | ✅ 已取证；约 58° yaw 转换留给 OF6 台架复核 |
| OF5 零点标定 | ✅ v0.24 真机通过：66.12 秒漂 6.6/0 计数，较旧版改善 10.02 倍 |
