Nyxarian/ApexFly-v2.0/优化一下/高度接入施工顺序.md

# 高度接入 · 开发顺序（施工顺序表）

## 排序规则（七条）

1. **先让"眼睛"准，再让"手"动** —— 估计器先做完、单独验证，再碰控制律；
2. **先搭骨架，再装肌肉** —— 模式状态机、门禁先落地，这个阶段**修正量恒 0**，零炸机风险就能验完最危险的那部分逻辑；
3. **先内环，后外环** —— 内环是唯一的阻尼来源，没有内环的外环必振荡；
4. **先安全，后首飞** —— 退出判据必须在第一次打开定高之前就位；
5. **先近端，后远端** —— 飞控跑通再改遥控器，避免两端同时动、出了问题分不清是谁；
6. **先验证，再整定** —— 每次改参数都必须有黑匣子波形作依据，不凭感觉连改；
7. ⭐ **模式只在地面切换**（2026-09-11 新增）—— 切换要求"**已上锁 + 杆在最低位**"，所以**一次飞行只能用一个模式**。
   这条顺带让"无扰切换"这件事基本消失（切换时两边油门都是最低）。
8. ⭐ **"停手"跟着骨架一起做**（2026-09-12 新增）—— 地面行为改由**停手状态机**负责（方案 §5.4）。它只依赖"高度读数 + 摇杆积分"，**不产生任何修正量**，
   所以放在 H6 阶段做是零炸机风险的；而且它**必须和门禁一起验证**，才能证明"地面不推杆就不动"。

---

## 施工顺序表

图例：🖥 纯软件可验证 ／ 🔧 需要台架 ／ ✈️ 需要飞行 ／ ⚠️ 有炸机风险

| # | 环节 | 依赖 | 类型 | 改动 | 验证方式 | 风险 |
|---|---|---|---|---|---|---|
| **H1** | **语义与正名迁移**<br>`hover_pwm_us` 注释正名；`target_vz_cms` 黑匣子列语义迁移方案定稿 + `bb_*.js` 脚本改成能区分两种语义 | — | 🖥 | `pid_table.c/.h` 注释、`blackbox.h` 注释、脚本 | 编译通过；用**旧数据**跑脚本仍能正确解析磁航向 | 低 |
| **H2** | **ToF 暴露原始距离**<br>快照新增未滤波距离，滤波值继续给显示 | — | 🖥🔧 | `tof.h/.c` | 串口同时打印 raw 与 filtered，确认 raw 抖动明显更大 | 低 |
| **H3** | **估计器骨架（差分版）**<br>`h_est`、`vz_est`、有效标志 | H2 | 🖥🔧 | 新增 `vertical_est.c/.h` | 手举对比卷尺（差 <3cm）；静止时 `vz_est` 抖动 <5cm/s；匀速抬手符号正确 | 低 |
| **H4** | **倾斜补偿 `cosθ`**<br>估计器入口对 `h_tof` 做 `d·cos(roll)·cos(pitch)` | H3 | 🖥🔧 | `vertical_est.c` | 台架把飞机歪 20°，读数应基本不变（补偿前会偏大 6%） | 低 |
| **H5** | **估计器接入控制环（只读）**<br>250Hz 每拍调用 + 节流打印，**不接控制** | H3 | 🖥🔧 | `motor_test.c` | ① 打印正常；② ⭐**实测控制环一拍耗时**，确认没吃掉 4ms 预算 | 低 |
| — | ⚠️ **H4 与 H5 已合并为「H4'」**（2026-09-11）：倾斜补偿要用姿态角，而姿态角只有控制环算得出来，tofTask 拿不到。按原顺序做得先造一条"姿态发布通道"，H5 一搬家就变废码。合并后一次做完：搬迁 + 倾斜补偿 + 一拍耗时实测，打印仍留在 tofTask（控制环禁止打印）。**H6 的依赖从 H5 改为 H4'。** | — | — | — | — | — |
| **H6** | ⭐ **模式状态机 + 两层门禁 + 三段映射 + 停手状态机**（2026-09-12 定义扩展；**三段映射与 `h_sp` 积分器从 H13 前移至此**）<br>① `flight_mode` 解析、请求 vs **实际**状态、遥测回显实际模式；<br>② **模式切换门禁**：已上锁 + 杆在最低位（≤50） + 读数可信 + 高度 ≤120cm；<br>③ **控制启用门禁**：已解锁 + 读数可信 + 姿态平稳 + **不处于停手**；<br>④ 三段边界与速率常量：下降 0~350 ／ 保持 350~650 ／ 上升 650~1000，速率 **−2 → +3 cm/s**，段间连续；<br>⑤ **`h_sp` 积分器**：`h_sp += rate×dt`，`clamp(h_sp, 0, 120)`；<br>⑥ **停手状态机**（方案 §5.4）：进入要 `h_est ≤ 门槛`（⚠️ **当前是台架测试值 6cm**，因为飞机被垫高、地面读数约 4cm；恢复不垫高后改回 **2cm**）**且本拍没在命令爬升**（`rate ≤ 0`）**且不在起飞保护期**，连续 **500ms**；进入时 **`h_sp := 0`**（不对齐到 `h_est`）；退出 **`h_sp > 4cm`** 并置**起飞保护**（`h_est > 10cm` 或 `rate < 0` 才清）；<br>**修正量恒 0** | H4' | 🖥🔧 | 新增 `vertical_control.c/.h`、`motor_test.c`、`radio.c`（回显实际模式）、`tof.c`（`[ALT]` 打印）、`blackbox.c`（**临时** `vm` 命令）、`MDK-ARM/*.uvprojx`（登记新文件） | ① **逐条测门禁**：不解锁 → 拒绝；杆不在最低位 → 拒绝；桌面上+上锁+杆最低 → **接受**；② 举到 1.3m 以上 → 读数失效 → 退出；③ 反复切模式状态干净；④ ⭐ **飞机行为完全不变**（修正量恒 0）；⑤ ⭐⭐ **停手状态位与 `h_sp`**：地面解锁不推杆 → `alt_state=4`（**门槛对了才进得去**）；推杆过 650 → `h_sp` 从 0 涨、过 4cm → `alt_state=1`；杆回中段 → `h_sp` **冻结不回落**；⑥ ⭐ 退出停手、油门抬起来之后**姿态环能重新收敛**（油门 ≤1100µs 时姿态环被旁路、三轴修正量清零，见方案 §5.4）；⑦ ⭐⭐ **推力偏弱起飞**：飞机一直放在台架上（`h≈4cm`）把杆推到底，`h_sp` 必须一路涨、`alt_state` 保持 1，**绝不能被按回停手**（这一条已在 PC 仿真里验过，见下方"台架仿真"）。<br>⚠️ 停手期间的"**输出恒 1100µs**"要等 **H8**（油门接管之后）才能验，H6 只验状态位与积分行为<br>⚠️ 原来写的"**挡住激光**"作废（手挡会得到一个**有效的**近距离读数） | 中 |
| ~~H7~~ | ⚠️ **已并入 H8**（2026-09-14，用户批准）。理由：① "切换时复位控制器状态" **H6 已经做了**；② `throttle_slew_us` 在 `!armed` 分支里每拍都在复位，而切模式必须上锁，**天然已满足**；③ "验证切换无跳变"——**H6 阶段模式根本不影响油门，平凡成立、验不出任何东西**。真正有可观测内容的"停手进出不油门跳变"要等 H8 接管油门之后。<br>**原定义留档**：因为切换只发生在"上锁 + 杆在最低位"，两边油门都是最低 ⇒ 主动切换天然无扰，什么都不用做；只剩"切换时复位控制器状态与 `throttle_slew_us`"。 | — | — | 无 | 见 H8 | — |
| **H17a** | ⭐ **遥控端：模式通道打通**（2026-09-14 提前到 H8 之前；**纯遥控端改动，飞控一行不动**）<br>① 设置页"飞行模式"改成**两选一：普通模式 / 定高模式**（删掉 RATE/ANGLE 空壳——飞控没有纯速率模式，那两个对飞控是同一个东西）<br>② 确认后把请求交给 radio 模块，之后每帧控制指令持续携带（上电初值 **0 = 普通**，**不记忆上次选择**）<br>③ 显示**实际**模式：设置页值区与仪表盘都读遥测回显，不再读本地请求<br>④ 已解锁时禁止编辑（**既有门禁已覆盖**：设置页本来就在解锁时弹"禁止修改"）<br>⑤ **被拒即作废**：连续 **3 帧**遥测都报 bit7 → 判失败，请求退回实际值、状态栏显示**「修改失败」**、想改必须**重新申请**（不做原因、不弹窗）；值区同步退回，否则界面会一直显示那个没生效的值<br>⑥ ⚠️ **为什么必须 3 帧**：遥测是飞控**收到控制帧的瞬间**回的，而模式切换在**下一个控制环拍**（最多 4ms 后），紧接请求的那帧遥测大概率还是"未生效"，一帧就判会把"其实已经成功"误报成失败 | H6 | 🖥🔧 | 遥控端仓库（**已 git init，基线 9619cdf**）：`Algorithms/ui.c`、`Apps/App_Radio_Task.c/.h` | ① 上电显示「普通模式」（读的是实际模式）；② 上锁 + 杆最低 → 选「定高模式」→ 飞控 `[ALT]` 的 `req` 变 1、`mode` 变 1，遥控值区几百毫秒内跟着变；③ 选回「普通模式」；④ **解锁后进设置页 → 弹「禁止修改」**，无法进入编辑；⑤ ⭐ 上锁但**杆推到中位**再申请 → 显示**「修改失败」**、值区退回「普通模式」、`req` 回到 0；⑥ ⭐ **被拒后不再自动生效**：把杆收到底、确认上锁，`req` 仍是 0，不会自己切进去；⑦ **重新进页面重新确认** → 这次生效 | 低 |
| **H8** | **油门来源接管**（⭐ 已并入 **H7 无扰切换**、**H4' 探针删除**、**举到 1.3m 验证**）<br>① **来源二选一**：普通模式走手动映射（**一个字节都不动**）；定高模式走控制器输出（新增 `VerticalControl_GetThrottleUs()`）<br>② 定高下两档：**停手 = 1000µs**（`MOTOR_PWM_MIN_US`，电机停转 —— 这才真的和"普通模式收到底"一致，原来文档写的 `MOTOR_PWM_IDLE_US` 1100 是错的）；**控制启用 = 1100µs**（`MIXER_PWM_EFFECTIVE_MIN_US`，H8 阶段是占位：修正量恒 0、顶在下限，H9 起换成内环输出）<br>③ **速率限制保留、不旁路**：它顺便把"停手 ↔ 控制"变成软启动/软收油（1000→1100 约 0.13s，反向约 0.33s）。方案 §2.5 说的"定高时旁路"是针对控制器自带限速，等 H9 接上内环再评估要不要合并两层<br>④ 删 H4' 探针；⑤ `[ALT]` 打印加 `thr=%u`（本环节核心观测量）<br>⭐ **关键性质：定高模式下油门只会更低、不会更高**（杆 690 时 H6 给 1345µs、H8 给 1100µs）⇒ **风险低**，不是原先评估的"中高" | H17a | 🖥🔧 | `vertical_control.c/.h`、`motor_test.c`、`motor_test.h`、`tof.c` | ① ⭐ **普通模式完全不变**：推杆 `thr` 从 1000 涨到 1500；② `vm 1` + 解锁 → `st=4` 且 **`thr=1000` 不动**；③ ⭐⭐ **推杆到底 `thr` 恒 1000、电机不转**（H6 这里是 1345µs，这是本环节的核心现象）；④ 推杆过 650 约 1.4s → `st=1 gnd=0`，`thr` 从 1000 爬到 **1100**（约 0.13s，电机刚够怠速）；⑤ 杆回中段 → `h_sp` 冻结、`thr` 停 1100；⑥ 杆拉到底 → 回 `st=4`、`thr` 降回 1000（约 0.33s）；⑦ 上锁 → `thr` 立即 1000；⑧ ⭐ **举到 1.3m 以上**（原 H6 的 ②）：`v=0`、`sw` 掉 `EST_VALID`/`HEIGHT_OK` 两位，⚠️ `st` **仍是 4**（停手不因高度退出，这是设计）、`thr` 仍是 1000 ⇒ **安全**；⑨ 反复切模式 `thr` 连续无跳变（H7 的验收） | **低** |
| **H9** | ✅ **内环 P（垂速→修正量）+ 动态输出限幅**（2026-09-15 实施 v0.15；**真机实测 10/10 通过**，见本文档「H9 实测结果」）<br>① **控制律** `∆µs = Kp_v × (vz_sp − vz_est)`，`vz_sp` **固定 0**（`VERTICAL_INNER_VZ_SP_CMS`）⇒ **纯阻尼器**：抬起来减油门、压下去加油门；<br>② ⭐⭐ **基准油门 1100 → 1250**（`VERTICAL_BASE_PWM_US`，与 `mixer.h:20` 的台架基准同值）—— 本环节最关键的一个决策，三条理由见方案 §3.4：基准=1100 时修正量只有单侧、"该减油门时减"**验不了**、姿态环还会在边界上反复 Reset；<br>③ **动态限幅**：上 = `min(满杆油门 − 基准 − 姿态保留余量100, +30)`、下 = `max(1100 − 基准, −30)` ⇒ 默认参数下**对称 ±30µs**；满杆油门取 `PidTable_GetMaxThrottleUs()`（**不是写死的 1600**）；<br>④ **硬限幅 ±30µs**（`VERTICAL_INNER_CORR_LIMIT_US`）；<br>⑤ 参数走协议 ID 25~27，**新增 `PidTable_GetAltitudeParams()`**；缓存比对、**变了才 `Pid_ApplyParams`**（否则 H10 的积分会被每拍按回 0）；<br>⑥ 停手 / 门禁②没过 → **复位内环并输出 0**，与 `GetThrottleUs()` 共用 `VerticalControl_IsActive()`；<br>⑦ `[ALT]` 加 `vzsp=` / `vz=` / `corr=`（本环节核心观测量）⚠️ **v0.16 起这两行打印已合并为一行 `[V]`**，见本表下方 H9 验收步骤与「打印格式」说明<br>⚠️ **anti-windup 推迟到 H10**：Ki=0 时 `pid.c` 里积分项根本不算，交付比例没有作用对象（详见方案 §3.4）<br>⚠️ **代价：H8 的"定高下油门只会更低"到此结束**，判据由 `thr ≤ 1100` 改为 **`thr ≤ 1280`**（停手仍恒 1000，地面安全性不变） | H8 | 🔧 | `vertical_control.c/.h`、`pid_table.c/.h`、`tof.c`、`motor_test.c`（**只改注释**） | ① ⭐⭐ **符号**（本环节唯一会真正导致失控的错误）：手**下压** → `vz` 负、`corr` **正**（顶 +30）；手**上提** → `vz` 正、`corr` **负**（顶 −30）；② 停手 / 上锁 / 门禁②没过 → `corr = 0`、`thr = 1000`；③ 控制启用时 `thr` 落在 **1220~1280**；④ 遥控改 `vz_kp` → `corr` 幅度跟着变（证明参数是活的）；⑤ 普通模式回归一字不变；⑥ ⚠️ **台架验不了增益**（手是"无限权限"扰动源，飞机不会真的跑飞），增益只能首飞整定 | **中**（原评"高"：符号写反是确定性失控；但台架拆桨下风险为零，且符号一旦验过就只剩限幅/状态逻辑） |
| **H10** | **悬停油门估计器（内环积分）+ 绝对油门区间**（2026-09-15 实施 **v0.18**，待硬件验证）<br>⭐⭐ **本环节的形状与原文不同：拆成了两层**（原文只说"内环 Ki + anti-windup"）——<br>　**慢层** = 手写积分器 `vertical_throttle_base_us`（回答"悬停要多少油门"），由 `vz_ki` 驱动，初值 1250；<br>　**快层** = H9 的垂速内环 P（回答"此刻该加还是该减"）；<br>　`GetThrottleUs() = 慢层 + 快层`，再**整体钳到 [1150, 1650]**（`VERTICAL_CONTROL_THROTTLE_MIN/MAX_US`）<br>⚠️ **为什么不让 `Pid_t` 的内部积分当慢层**：`pid.c` 的积分钳位是**对称的**（±i_limit），装不下 [1150,1650] 这种相对 0 不对称的区间。硬套只能玩"把积分当偏移、中心挪到 1400"，可读性差、以后必被改错。⇒ 因此 `Pid_ApplyParams` 收到的 **ki 写死 0**（否则两个积分器会打架 —— 这是最容易被后人"顺手修正"成 bug 的一行，注释里写死了）<br>① **快层限幅 30 → 50**（`VERTICAL_INNER_CORR_LIMIT_US`）：与 H14 首飞的"修正量限 ±50µs 起步"对齐 ⇒ H14 不用再改代码；取 80 则首飞振荡风险偏高，而真正该调的是遥控可改的 `vz_kp`；<br>② **地板/天花板独立于 `max_throttle_us`**（不跟着它走）：那个参数同时是普通模式满杆油门，跟着它会让"调手动手感"意外改变定高行为。地板 1150 = 混控有效下限 1100 + 50µs 余量（**必须 >1100，否则姿态环被旁路**）；天花板 1650 = 悬停估计 1420 + 230µs，且给姿态差速留 350µs；<br>③ ⭐ **积分与输出用同一把锁**（都是 [1150,1650]）—— 只钳输出不钳积分就是 windup；<br>④ 慢层初值 **1250**（`VERTICAL_THROTTLE_START_US`）⇒ 进控制那一刻油门不跳变；<br>⑤ 不活跃（普通 / 停手 / 门禁②没过）时**慢层回初值、快层输出 0**，不留残值；<br>⑥ `[V]` 打印加 **`i=`**（慢层当前值）—— 台架上只有它能看出积分在不在工作。<br>⚠️ **anti-windup 不需要额外接线**：`pid.c` 的 anti-windup 第 1 层（条件积分）本来就在跑；第 2 层 `delivery_scale` 是给"混控缩放姿态修正"用的，高度环的输出没有"被打折"这回事 ⇒ H9 写的"anti-windup 推迟到 H10"**更正为"高度环不需要它"**<br>⚠️ **并入了 H11 的两行**（`vz_correction_us` / `vz_target_cms` 由恒填 0 改成填真值）<br>⚠️ **满杆油门默认 1500 → 2000**（用户决定）：当年取 1500 是因为"1450 就能起飞、再高用不到"，但 1000~1500 映射下**一格杆 = 0.5µs，而 TIM8 只能分辨 1µs** ⇒ 那一半分辨率是花不出去的。改成 1000~2000 后一格杆 = 1µs，正好等于电调分辨率。代价：悬停点从杆量 ~900 挪到 ~450、软启动 0.625s → 1.25s | H9 | 🖥🔧 | `vertical_control.c/.h`、`pid_table.c`、`motor_test.c`、`tof.c`、遥控端 `ui.c` | ① 普通模式 `thr` 1000→**2000**、`corr` 恒 0、`i` 恒 1250；② ⭐⭐ **慢层符号**：匀速**上抬**飞机 → `i` **下降**（写反即正反馈，与快层那个减号同性质）；匀速**下放** → `i` **上升**；③ 停手 / 上锁 / 门禁②没过 → `thr=1000`、`corr=0`、`i=1250`；④ `st=1` 时 `thr` 与 `i` 恒在 **[1150,1650]**、`|corr| ≤ 50`；⑤ ⭐⭐ **不变式：`thr` 永不 ≤1100**（姿态环永不被旁路）；⑥ `vz_ki` 改 0 → 慢层冻结；⑦ ⚠️ **台架上飞机仍然抬不起来**（没有外环、拆桨）—— **这是预期现象，不是失败** | **中**（符号/限幅写错是确定性失控，与 H9 同性质；但台架拆桨下风险为零，且已有 48 组组合的不变式仿真兜底） |
| **H11** | **黑匣子字段补齐**<br>`vz_cms`/`target_vz_cms`/`vz_correction_us`/`altitude_state` 填真值；`hover_pwm_us` 列修正过期值<br>⭐ **H9 已经在快照里产生了 `vz_correction_us` / `vz_sp_cms` / `vz_est_cms` 的真值**，H11 只需把它们接进黑匣子（`motor_test.c:577` 现在恒填 0） | H1 H10 | 🖥🔧 | `blackbox.c/.h`、`motor_test.c` | 导一份数据，波形能看出内环行为 | 低 |
| **H12** | **失效处理：保持 → 平缓降至 1000**（2026-09-15 实施 **v0.19**，待硬件验证）<br>⚠️ **本环节的形状与原文完全不同**：原文写的是"退出判据 + 退出后交还手动"，实际做出来的是**不退出、而是先把油门稳住再慢慢收**。<br>⭐⭐ **根因**：H10 真机实测 451 个样本里 **41 个（9% 的时间）** 处于"空中停车" —— 门禁②一抖就返回 1000，而 1000 还会命中 `thr <= 1100` 分支**旁路姿态环** ⇒ 飞机**翻滚着砸下来**。<br>① **拆成三级台阶**：`st=1 控制` →（门禁②失效）→ `st=6 失效保持`（**油门锁存不变**、姿态环照常、计时 2s）→（未恢复）→ `st=7 失效下降`（从锁存值按 **30µs/s** 降到 1000，**单向不回头**）；<br>② ⭐ **锁存值 = 失效前一刻的实际输出**（慢层 + 快层），就是 §2.3 说的"内环积分器即悬停油门估计器"。**不是常数、更不是 1000**；<br>③ ⭐⭐ **2 秒保持是纯赚的**：瞬时失效（反光地面、丢帧、`ToF re-init`，H10 实测一晚上出现 3 次）在此期间恢复 ⇒ **什么都不发生**（慢层不丢、油门零跳变）；而且保持段油门锁在悬停值 ⇒ **不增加落地速度**（仿真：1.86 vs 1.86 m/s）；<br>④ ⚠️ **姿态超 25° 是唯一例外：不进保持段、直接 1000**（用户决定："姿态超 25° 一般就是撞上东西了，以现在的硬件基础很难找回，默认撞击炸机、不管了"）。若也走 2s+30µs/s，撞地之后桨还要转约 16 秒，与"赶紧停桨"正相反；<br>⑤ **高度越界（>125cm）并入本环节**：与读数失效同一套。**恢复门槛 115cm**（滞回，防边界来回穿）；<br>⑥ ⭐⭐ **守卫④「没飞过就不许锁存」**：本轮自己引入的风险 —— 地面上重新解锁而 ToF 还坏着时，停手要求 `est_valid` ⇒ 永远进不去停手 ⇒ 会把油门在**地面上**顶到 ~1250µs。判据用"本次解锁后有没有真的飞过"（不能用高度，高度正好不可用）；<br>⑦ **遥测 `flight_mode` bit5-6 = 失效原因**（0 无 / 1 读数 / 2 姿态 / 3 高度）。⚠️ 遥控端**暂不解析**（弹窗按用户要求缓做），先占位 ⇒ 将来加弹窗只改遥控端；<br>⑧ `[V]` 加 **`fs=`（失效计时）/ `fr=`（原因）**；黑匣子 `altitude_state` 的 **bit5-6 = 原因**（bit0-3 状态、bit4 预留定点都不动⇒旧档天然兼容）<br>⚠️ **不做**：自动降落（要 H16 的加计融合才能真正控下降速度）、空中切模式、§6.1 的"修正量饱和"判据（H10 之后已失去原意）<br>⚠️ 同一次实施**结掉了待办 5**（空中停车缺口） | H10 | 🖥🔧 | `vertical_control.c/.h`、`tof.c`、`motor_test.c`、`blackbox.h`、两份文档 | ① 普通模式 / 上锁 / **停手**回归（停手必须仍恒 1000）；② ⭐⭐ **拔 ToF 线** ⇒ `st=6`、`fr=1`、**`thr` 2 秒不动**；③ ⭐⭐ **拔线 0.5s 后插回** ⇒ 回 `st=1`、`i` 不丢、`thr` 无跳变；④ 过 2000ms ⇒ `st=7`、`thr` 按 **30µs/s** 线性下降（相邻两拍差约 15µs）；⑤ 下降全程 `thr ≥ 1100`（姿态环不被旁路）；⑥ 举到 **1.25~1.3m** ⇒ `fr=3`、同一套（**不需要举到 1.35m**）；⑦ 歪 30° ⇒ **立即 1000**、`fr=2`、**不进 `st=6`**；⑧ 上锁清干净 ⇒ 能重新进定高 | **中**（症状是确定的、逻辑是新增的；但全程拆桨、且"地面上不许锁存"那条守卫专门防新引入的风险） |
| **H13** | **外环 P + `h_sp` 接入 → 串级真正成立**（2026-09-15 实施 **v0.20**，待硬件验证）<br>⚠️ 本环节除"接线"之外**还抓出一个必须在首飞前知道的问题**（见 ③）。<br>① **新增外环**：`vz_sp = clamp( h_kp × (h_sp − h_est), ±20 )`，**死区 2cm（硬死区）**。它取代了原来的常数 `VERTICAL_INNER_VZ_SP_CMS = 0`；<br>② 外环用 **`Pid_t`**（不是手写纯 P）：你在 v0.17 加的 `h_kp/h_ki/h_kd`（**协议 ID 30/31/32**）本来就能遥控，手写 P 会让后两个变成死参数。**新增 `PidTable_GetHeightParams()`**（`pid_table.h` 里早就写着"H13 才补"）；<br>③ ⭐⭐ **`h_kp` 默认值 0.6 → 0.3、首飞 `vz_kp` 建议 20 → 2** —— 依据是**回路延迟**：ToF 一步 20ms、4 步一个测量周期 = **83ms**，再加差分垂速、低通、限速器（±50µs 满幅要走 125ms）。手算相位裕度：`d(推力比)/du = 2/415` ⇒ 修正量每变 1µs 加速度变 4.7cm/s²；内环 `corr = −Kp_v·vz` 的闭环时间常数 = `1/(Kp_v × 4.7)`，`Kp_v=20` 时只有 **11ms**，比延迟快 8~15 倍 ⇒ **相位裕度必然为负**。仿真确认 60~80ms 延迟下 `20/0.6` 进极限环（末段垂速 ±27cm/s），延迟 0 时同一组参数完全稳定；<br>④ ⭐⭐ **慢层的误差从 `0 − vz` 改成 `vz_sp − vz`**（H10 的注释一直写着"两层用同一个误差"，H13 才把它补成真的）。**这一条是"定高能起飞"的关键**：慢层只在有误差时才学，用 0 的话飞机在地面上 `vz=0` ⇒ 永不学习 ⇒ 油门停在 1250 而悬起来要 1450 ⇒ **永远离不开地面**（这就是 H10 台架上"抬不起来"的真正原因）；<br>⑤ 台架行为（仿真实测）：推杆 ⇒ **约 1.3s 退出停手** ⇒ **再憋油门约 5.7 秒**（`i` 从 1250 学到约 1410）⇒ 离地后**以 3~8cm/s 平缓爬升、无过冲**；跟随持续上升的目标稳定滞后 `3cm/s ÷ h_kp = 5cm`（与 §3.3 的预测完全一致）；<br>⑥ `[V]` 加 **`vzsp=`**（H9 的注释里就写着"H13 要加回来"）；黑匣子 `vz_target_cms` 那一列由"恒 0"变成真值（**记录结构不变**）<br>⚠️ **不做**：起飞助力（把 5.7 秒缩短 —— 那是 H18 的活，且需要 NVM 记住悬停油门才安全）、把 `VERTICAL_THROTTLE_START_US` 改成悬停值（⛔ 会让飞机**在地面上解锁就窜出去**）、降低 ToF 延迟（独立改动，但它正是增益上不去的根因） | H12 | 🖥🔧 | `vertical_control.c/.h`、`pid_table.c/.h`、`tof.c`、`motor_test.c`（只改注释）、两份文档 | ① 普通模式 / 上锁 / **停手**回归（停手仍恒 1000、`vzsp=0`）；② ⭐⭐ **符号**：`h_sp > h` ⇒ `vzsp` **为正**（写反 = 正反馈 = 越掉越低）；③ ⭐⭐ **死区**：`\|h_sp − h\| ≤ 2cm` ⇒ `vzsp` **恰好 0**；④ 限幅 ±20（⚠️ 负方向**不能**用大误差测：`h>125cm` 会先触发高度失效——那是正确行为，别误判）；⑤ 遥控改 `h_kp` ⇒ `vzsp` 跟着变；⑥ ⭐ **把飞机整体抬高 20cm 再放下** ⇒ `vzsp` 立刻变负、`i` 下降（**第一次真的闭环看高度**）；⑦ ⚠️ 台架预期：推杆后 `i` **一路涨到天花板 1650**（飞机起不来、误差一直大），**不是失败**；⑧ H12 回归（失效期间 `vzsp` **冻结**、姿态超限立即 1000） | **中**（符号写错是确定性失控，与 H9/H10 同族；但全程拆桨，且延迟问题已在方案阶段抓出并改成保守增益） |
| **H14** | **首飞：极小限幅**（⚠️ 2026-09-15 流程与参数都改了）<br>⭐ **地面上选定定高模式**（上锁 + 杆最低）→ 解锁 → 确认**停手**（不推杆不动）→ 推杆把目标抬到 **15~30cm 就立刻把杆回中段**（`h_sp` 会冻结）→ ⚠️ **等约 8~13 秒**（**解手已经很快**：H14 起推杆过 200 就解手；大头是憋悬停油门；**目标越低等得越久**：抬到 15cm 约 13s、30cm 约 8s）→ 飞机自己平缓爬上去 → 杆回中段悬停<br>⚠️⚠️ **起始参数必须用保守值，不许用默认/设计值**：`vz_kp = 2`（默认 100、设计值 20）、`h_kp = 0.3`（默认已是 0.3）、`vz_ki = 5`、MAX THROTTLE 2000。理由见 H13 的 ③（回路延迟把内环增益压得很低）<br>⚠️ 修正量限 ±50µs（H10 已经定好），之后按 §7.3 逐步放开<br>⚠️ **推杆一直推着不松手**：`h_sp` 会一直涨到 120cm 上限、飞机跟着走（滞后 5cm）—— 不是失控，但没必要 | H13 | ✈️⚠️ | 参数 | 不炸；⭐ **停手行为正确**（地面上输出恒 1000µs、电机停转）；⭐ **推杆后 8~13 秒才离地是预期现象**；能稳住。⚠️ 半空中开不了定高 | **高** |
| **H15** | **整定**<br>用黑匣子数据整外环 Kp、内环 Kp/Ki | H14 | ✈️ | 参数 | 松手稳住、推拉跟随、无低频摆动 | 中 |
| **H16** | **估计器升级为互补滤波**<br>只换 `vz_est` 来源，**控制律一行不改**。⭐ 它同时是"读数失效后做惯性下降"的前提（见方案 §15.1 路线 C） | H15 | 🖥✈️ | `vertical_est.c` | 波形对比：差分路受噪声限制、响应迟钝；融合后高频由加计提供、噪声由 ToF 长期锁住。需重新整定 | 中 |
| **H17b** | **遥控端其余**（⭐ 其中"模式选择 → 确认发送 → 显示实际模式"已由 **H17a** 提前完成）<br>剩余：显示**垂速**、自动退出时在 UI 上看得见、黑匣子/诊断页完善<br>⚠️ **定点开关怎么接 —— 待讨论**（方案 §15.2） | H15 | 🖥🔧 | 遥控端仓库（**已 git init，基线 9619cdf**） | 遥控联调；自动退出时能看到模式变化 | 低 |
| **H18** | **自动起飞**<br>目标高度从当前爬到 0.5m。⭐ **依赖 H6 的停手状态机**——"飞机在地面且未收到起飞指令"这个前提由它提供 | H17b | ✈️⚠️ | `vertical_control.c` | 一键起飞并稳住；起飞前在地面必须处于**停手** | 中 |
| **H19** | **自动降落**<br>目标高度降到 ~15cm 时**主动退出定高**交还手动（避开地面效应与 4cm 最小测距） | H18 | ✈️⚠️ | `vertical_control.c` | 下降速率受控、落地不过冲 | **高** |
| **H20** | 可选增强：电压前馈、地面效应补偿、接气压计扩高度上限 | H19 | ✈️ | 视情况 | — | 中 |

---

## 三个关键节点（记住这三个就够）

| 节点 | 在哪 | 为什么重要 |
|---|---|---|
| **第一个"零风险可验证"的里程碑** | **H17a 结束**（原 H7 已并入 H8） | 到此为止**修正量还是 0、油门也还没被接管**，但模式状态机、**两层门禁**、三段映射、**停手状态机**、模式通道全链路（遥控选定 → 发送 → 飞控门禁 → 回显实际模式）这些最容易出人命的逻辑，已经**全部验证完了**。台架上就能做，不用飞 |
| **第一个"有炸机风险"的动作** | **H9 / H14** | H9 是修正量第一次真的会推动电机（台架）；H14 是第一次真的接管飞行。之前所有环节都可以在桨叶拆掉或飞机固定住的条件下做 |
| **第一个"必须拿到数据才能继续"的点** | **H15** | 从这里开始，每次改参数都必须先导黑匣子看波形。没有数据就不改参数 |
| ⚠️ **挂起未定的点** | **H17b**（H12 已定） | H17b 的"**定点开关怎么接**"—— 见方案文档 **§15.2 待讨论事项**。原 H12 的"**退出之后交还手动还是自动降落**"已由用户在 2026-09-15 定为**"保持 2 秒，然后平缓降到 1000"**（不是交还手动），见 §15.1 |

---

## 可以并行/合并的

- **H1 和 H2 完全独立**，可以和别的活并行；
- **H4 可以并进 H3**（只是估计器入口多一行乘法），单列是因为它可以单独验证；
- **H11 黑匣子**其实可以和 H9/H10 一起写（值一产生就顺手记上），但**必须在 H14 首飞之前完成**，否则首飞没数据可整定；
- **H17b 遥控器端其余**可以和 H13~H16 并行（不同仓库、不同编译产物）。⚠️ 但 **H17a 不行**：它是 H8 的前置，必须排在 H8 **之前**单独验证完（理由见排序规则 5「先近端后远端」）。

---

## 当前进度（2026-09-15）

| 环节 | 状态 |
|---|---|
| H1 语义与正名迁移 | ✅ 完成（v0.8） |
| H2 ToF 暴露原始距离 | ✅ 完成（v0.9） |
| H3 估计器骨架（差分版） | ✅ 完成（v0.10） |
| H4/H5 → **H4'** 搬进控制环 + 倾斜补偿 | ✅ 完成（v0.11） |
| H6 模式状态机 + 两层门禁 + 三段映射 + 停手状态机 | ✅ **完成（v0.13）**：门禁逐条、模式切换、三段映射、`h_sp` 积分与冻结、**停手进出**、**推力偏弱起飞**、遥测回显实际模式**全部实测通过**。⚠️ 停手门槛按垫高台架暂用测试值 6cm（待办 3 要改回） |
| ~~H7 无扰切换~~ | ⚠️ **已并入 H8**（无代码可做、无现象可验） |
| **H17a 遥控端：模式通道打通** | ✅ **完成**（遥控端基线 `9619cdf` + H17a 改动 `5bc8c60`）：菜单选 普通/定高 → 确认发送 → 飞控回显实际模式；被拒 3 帧后 `0x80` 回滚 + 状态栏"修改失败"；解锁中禁止编辑。**用户实测通过** |
| H8 油门来源接管（含 H7 / H4' 探针 / 举到 1.3m） | ✅ **完成（v0.14）**：台架实测 **9/9 判据通过**（见"实测结果"）。⑧「举高」**⑧a 通过、⑧b 未达成**（受 USB 线长度限制，见"⑧ 补充实测"） |
| **H9 垂速内环 P + 动态输出限幅** | ✅ **完成（v0.15 代码 / v0.16 精简打印）**：真机实测 **10/10 判据通过**（见"H9 实测结果"）。⭐ **符号正确**（强信号 85/85 反号）、**等效 Kp ≈ 19.9** 与遥控设的 20 吻合、`thr` 硬上限越界 0。⚠️ 本次实测顺带补验了 H8 的 ⑨（举到 1.2m → `sw` 掉 `HEIGHT_OK`） |
| **参数通道扩展（高度环 KP/KI/KD）+ 遥控端字库补齐** | ✅ **完成（v0.17）**：已烧录，**用户实测 UI 无问题**（高度页三行、两个环标签可分辨、7 个参数可编辑、缺字形不再是方框）。🖥 我这边已验：两侧语法全绿、两份协议头逐条一致、字库 0 缺字且旧字形逐字节零改动 |
| **H10 悬停油门估计器 + 绝对油门区间（并入 H11 两行）** | ✅ **完成（v0.18）**：真机实测 **12 通过 / 0 失败 / 1 未测**（见"H10 实测结果"）。⭐ **慢层符号两个方向都对**（严格档 58/0）、`i` 全程在 [1150,1650]（实测 1153.8~1478.4）、**地板与"积分/输出同锁"实测生效**、无 windup；普通模式映射反推**满杆 2000µs** ✓。⚠️ ⑨「举到 1.2m」未做（`h` 最大 91.9cm）。⚠️⚠️ **本次正面确认了两条"空中停车"缺口**（姿态歪超 25°、ToF 掉线），**H12 必须修，之前不许飞** |
| **H12 失效处理：保持 → 平缓降至 1000（结掉待办 5）** | ✅ **代码完成（v0.19）**；⚠️⚠️ **台架验证按用户决定【跳过】**（2026-09-15，"到时候飞行测试如果出现这个情况我再去看"）—— 代码未经真机验证，**风险转移到首飞**，见待办 11。⭐ 仿真 `sim_vc_h12.c` **67 项全过**（含 144 组组合 × 400 拍的不变式遍历）；⭐ 核对脚本自测 **正确组 17/0/1 + 五个对照组各被对应判据抓到**。⚠️ **v0.19 的飞控要重烧**（遥控端不用动） |
| **H13 外环 P + `h_sp` 接入（串级真正成立）** | 🔨 **代码完成（v0.20），待你在 Keil 编译烧录验证**。⭐ 仿真 `sim_vc_h13.c` **34 项全过**；⭐ 物理仿真 `sim_h13_takeoff.js` 给出起飞时间线（推杆后 **8~13 秒**离地，**目标抬得越低等得越久**）；⭐ 核对脚本自测 **正确组 21/0/1 + 八个对照组各被对应判据抓到**。<br>⭐⭐ **方案阶段就抓出一个必须改参数的问题**：回路延迟 83ms 使 `vz_kp=20 / h_kp=0.6` 进极限环 ⇒ **首飞改 `vz_kp=2`、`h_kp` 默认降到 0.3** |

| **2026-09-15 飞前清账（v0.21）** | ✅ **代码完成，待烧录**：摇杆速率 2/3 → **5/5**、姿态门禁 25 → **30°**、满杆角度 20 → **15°**、停手门槛 6 → **4cm**、失联门限 800 → **1500ms**、删掉 `vm` 临时命令；**首飞参数定为 `vz_kp=2 / h_kp=0.3 / vz_ki=5 / MAX THROTTLE=2000`**（⚠️ `vz_kp` 由 5 改成 **2**，理由见「飞前清账」一节）。⚠️ 遥控端不用动 |

| **H14 停手改成"推杆即解手"（v0.22）** | ✅ **代码完成，待烧录**：解手从"推到上升段让 `h_sp` 攒过 4cm（约 0.8s）"改成"**已解锁 + 杆从低位推过 200（边沿）**"；起飞保护的清除条件从"变化率<0"改成"**杆 ≤100**"（不改就会**转一下停一下来回抖**）；`!armed` 时清保护（否则解锁瞬间油门直接 1250）。⭐ 仿真 `sim_vc_h14.c` **48 项全过**（含"杆停 1 分钟 `st` 恒为 1"）；⭐ 核对脚本自测 **正确组 24/0/1 + 11 个对照组各被对应判据抓到**。<br>⚠️ **离地前的 8~13 秒照旧**（油门仍全程由控制器给，本环节**不做**手动起飞段）。⚠️ 遥控端不用动 |

⚠️ **待办**：

1. ~~**删 H4' 的临时探针**~~ ✅ **已在 H8 删除**：`motor_test.c` 的 `motor_test_max_frame_us` / `MotorTest_TakeMaxFrameUs()`、`motor_test.h` 的声明、`tof.c` 里的 `loop=%luus`；
2. ✅ **已结案（2026-09-15 飞前清账）**：`vm` 临时命令已**全部删除** —— `blackbox.c` 的整段 VM 分支 + `HELP`/未知命令提示里的 `vm` 字样、`vertical_control.h` 的 `VerticalControl_SetDebugRequestedMode()` 声明、`vertical_control.c` 的实现与那个 `volatile` 变量。**全工程零残留**（grep 过）。遥控端 H17a 已验证能切模式，`vm` 本来就已经冗余。下面是当时的原始记录：`blackbox.c` 的 `VM 0|1|off` 分支（含 `HELP` 与"未知命令"提示里的 `vm` 字样）、`vertical_control.h/.c` 的 `VerticalControl_SetDebugRequestedMode()` 和它那个 `volatile` 变量。⚠️ H17a 之后遥控端已经能切模式、`vm` 变冗余，但**留作台架上的第二条退路**，H8 验证通过再和探针一起删。`tof.c` 的那行打印（现为 `[V]`）同理——H8/H9 正要靠它看 `thr=` / `corr=`。
3. ✅ **已结案（2026-09-15 飞前）：改成 `4.0`**（`VERTICAL_GROUND_ENTER_H_CM`）。
   ⚠️ **飞之前仍要在地面上先看一眼 `h`**：静止读数若已 ≥ 3.5cm，就把门槛再抬 1~2cm（**要重烧**）。
   下面是当时的原始记录（规矩仍然有效，别机械照抄任何数）：
   `VERTICAL_GROUND_ENTER_H_CM` 现在是 **6.0（垫高台架的测试值）**。
   ⚠️ **2026-09-15 实测（同样的垫高台架）地面读数 = 2.4~3.2cm，中位 2.8cm、均值 2.79cm**
   （H8 编译前后两份日志共 **2137** 个样本，分布完全一致）—— 比 09-14 记录的"垫高约 **4cm**"低，
   说明**垫高高度或镜头安装状态变过**，所以"不垫高约 **1cm**"这个旧数字**也不能照用**。
   ⇒ **规矩**：撤掉垫块后**重新实测静止读数**，门槛取 **实测读数 + 1~2cm**，并把实测值记回本文与方案 §5.4。
   **为什么不能机械地改回 2.0**：门槛只要**小于**地面读数，停手就永远进不去 ——
   2026-09-14 就是这么翻车的（门槛 2.0、读数 4cm ⇒ `st` 一直 1、`gt` 一直 0ms）。
   反过来门槛高了会把 4~6cm 的正常悬停误判成停手（油门压最低 → 掉下来）。详见方案 §15.3 第四个坑。
4. **（离题插曲，已全部还原）串口回显测试 —— 2026-09-15**：为验证上位机串口工具，临时做过一版
   USART3 透明回显（接收中断 + 环形缓冲 + 回显任务），**已按用户要求全部删除**
   （commit `afe46ad` 还原了 `0fbb390` 与 `448e549`；完整内容在 git 历史里随时可查）。
   **两条要记住的结论**：
   - ① **USART3 现在是"5ms 轮询 + 必须逐字节发"**（`BLACKBOX_UART_POLL_MS = 5`，FIFO 关闭、硬件只存 1 字节）。
     这就是"串口发命令又慢又脆"的根因。**接收中断这条路已实测可行**：256 字节全量二进制与 1024 字节连续突发
     都是零丢失（会话统计 **1314 字节进 / 1314 字节出**）。以后要做真正的命令协议，从这里起步。
   - ② ⚠️ **未验证项**：**拔插线 / ORE 溢出后的自动恢复那条路径没有真机验证过**（用户跳过了这一步）。
     将来串口出现"突然收不到数据、要重插才恢复"时，**先怀疑这里**。
5. ✅ **已结案（H12 / v0.19）：空中门禁失效 = 空中停车**。
   H8 留下的这条缺口（`GetThrottleUs()` 在门禁②没过时一律返回 1000 ⇒ 空中停车 +
   旁路姿态环 ⇒ 翻滚砸地）**已由 H12 的失效处理修掉**：`st=6` 保持锁存油门、
   `st=7` 按 30µs/s 平缓降到 1000，姿态环在前 90% 的行程里全程有效。
   下面是发现当时的原始记录，保留备查：
   > `VerticalControl_GetThrottleUs()` 在门禁②没过时**一律返回 1000**。地面上完全正确（停手），
   > 但**空中**丢读数（超量程 / 传感器坏）或姿态歪超 25° 时就等于**空中停车**。
   > ⭐ H10 之后"已经有东西可以保持了"（慢层积分器就是那个稳定偏置），
   > 所以正确做法是**锁存并保持慢层积分值** —— 这正是 H12 做的第一件事。
   ⇒ 定高现在允许台架之外的下一步（H13 外环 → H14 首飞）。
   ⚠️ 但"自动降落/受控坠落"仍未做（需要 H16 的加计融合才能真正控制下降速度）。

9. ⚠️ **已处理（2026-09-15 飞前）：门限 `800 → 1500`**（`control_link.h`）。
   ⚠️⚠️ **但只是"把停桨推迟 0.7 秒"，没有根治**：真正的做法是"失联后**维持最后一次指令**
   继续飞一段时间（failsafe hold）"，那要改 `motor_test.c` 的 `!armed` 分支，属独立改动。
   ⇒ **仍然登记为待办**（首飞可以先按 1500 飞，但这条不要以为关掉了）。下面是原始记录：
   `control_link.h` 的 `CONTROL_LINK_TIMEOUT_MS = 800U`，而 LoRa 一问一答**实测间隔 300~320ms**
   ⇒ **连续丢 2~3 帧控制帧就判失联 ⇒ `armed=false` ⇒ `!armed` 分支立刻四路 1000（空中停桨）**。
   这是**整个飞控的既有设计**，不是定高引入的（H12 的失效处理也接不住它 ——
   `!armed` 在 `motor_test.c` 里是硬台阶，比定高的失效处理更靠前）。
   ⇒ 首飞前**必须**单独评估：是放宽门限、还是失联后维持最后一次指令若干秒、
     还是先确认实测链路丢包率足够低（H14 之前的**必做项**，登记在此）。
   ⚠️ H12 **刻意没有动它** —— 那是飞行安全的全局决策，不该塞在定高环节里顺手改。

10. ⚠️ **H12 的"下降段不再回头"是一次飞行内的单向门**：
    失效保持 2 秒内恢复 ⇒ 无缝继续；一旦开始下降就**不会**再回到定高
    （理由是"高度越界"会在 125cm 上下反复进出，而读数恢复后油门要重新爬回悬停值，
    两件事都不好收尾）。⇒ 一次失效 = 一次飞行结束，落地后重新选定高。
    ⚠️ 如果实测发现"读数只是掉了 3 秒又回来"很常见，可以再评估"下降段也允许恢复"
      （代价是要给恢复加去抖，否则会来回抽）。**这是待评估项，不是缺陷。**

11. ⚠️⚠️ **H12 的台架验证被跳过（2026-09-15，用户决定）** —— 按"跳过必须留档"的约定记在这里。
    - **状态**：代码已提交（`7b867e2` / v0.19），仿真 `sim_vc_h12.c` 67 项全过、
      核对脚本 5 组对照组自测通过；但**真机上一次都没跑过**。
    - **风险转移**：失效处理的第一次真实检验会落在 **H14 首飞**上。
      缓解：`[V]` 行有 `fs=` / `fr=` 可现场判读；黑匣子 `alt_state` bit5-6 记原因码。
    - ⭐ **首飞前至少要补做这一条**（不用飞、不用拆桨、成本最低）：
      **把飞机举到 1.25m 以上**（ToF 仍有效）→ 应看到 `fr=3`、`st=6` 保持 2 秒、
      然后 `st=7` 且 `thr` 按 30µs/s 降到 1000。这一条同时验到：高度越界判据、
      保持段、下降段、斜坡斜率、地板 —— **一条顶 H12 验收表的一半**。
    - ⚠️ **另外三条建议在首飞前顺手做**（都在地面上、都不用飞）：
      ① 拔 ToF 线 → `fr=1`；② 拔线 0.5s 后插回 → 回 `st=1`、`thr` 无跳变；
      ③ 把飞机歪到 30° → `fr=2` 且 **立即** `thr=1000`（**不进 `st=6`**）。
    - 完整的 H12 验收表见上文「H12 验收步骤」（已标注"未执行"）。
6. **⑧b「举到 1.3m 以上让 `v=0`」还没做**：需要 **>1.35m**（120cm 是软上限、约 1.3m 是 ToF 硬件量程，
   两个触发点不同）。阻碍是**飞机用 USB 线连着电脑，举高会扯掉线**（实测掉了 3 次、丢 143 秒数据）。
   ⇒ 换**更长的 USB 线**，或用**支架**架到 1.35m 以上再做。
   ⚠️ 台架仿真 `sim_vc_h8.c` 的场景 9 已经覆盖了这一条（`v=0` 时 `sw` 掉两位、`st` 仍 4、`thr` 仍 1000），
   所以剩下的只是**真机确认**，不是逻辑风险。
7. ⭐⭐ **悬停油门还是未知数，而它挡在 H14 前面**（H9 实施时核对代码发现）
   —— **2026-09-15（H10）部分解决，但没完全解决**：
   - ✅ **"谁来给这个数"解决了一半**：H10 的慢层积分器**就是**那个估计器，它会在飞行中自己学出来
     （这正是方案 §2.3 的承诺）。**不再需要人工先飞一遍量出悬停油门再填参数。**
   - ✅ **用户提供的关键线索**：他说"**1450 左右就能起飞**" ⇒ 悬停油门 ≈ **1400~1430**，
     而 `mixer.h:54` 那句"悬停 1550"是当年写余量时的**假设、从没实测过** —— 偏高了约 100µs。
     H10 的天花板 **1650** 就是按 1420 + 230µs 余量定的。
   - ⚠️ **但"油门权限够不够"仍要首飞才能确认**，而且有一条**必须在首飞现场做**：
     如果积分器长期顶在 1650 而飞机还是上不去，说明天花板不够 —— 那时要抬的是
     **`VERTICAL_CONTROL_THROTTLE_MAX_US`（代码常量，要重烧）**，不是 `max_throttle_us`。
     （H10 起这两个数已经**解耦**：`max_throttle_us` 只管普通模式满杆油门。）
   - ⚠️ **另一个仍然存在的量**：`max_throttle_us` 默认值已由 1500 改成 **2000**，
     所以普通模式的满杆油门不再压缩定高的权限；但它**同时决定手动飞行手感**，
     悬停点从杆量 ~900 挪到 ~450，**首飞前先在地面确认这个新映射能接受**。
   - ✅ `max_throttle_us` 是协议 ID（遥控可改，范围已对齐成 1200~2000），**不用重新烧固件**。
8. ~~**H13 的外环 `h_kp` 没有协议 ID**~~ ✅ **已在 2026-09-15 解决（v0.17）**：选了路线 **B**，
   新增 `APEX_PID_HEIGHT_KP/KI/KD`（编号 **30/31/32**，`APEX_PID_PARAMETER_COUNT` 30 → **33**），
   **旧编号一个都没动**。详情与连带改动见下面「2026-09-15 参数通道扩展」。
   下面是发现当时的原始记录，保留备查：
   协议表 30 项里高度只占 4 项 —— `APEX_PID_VERTICAL_SPEED_KP/KI/KD`（**一个环**的量）+ `HOVER_PWM_US`，
   而三个姿态轴占了 21 项。⇒ **H13 的外环 Kp（方案 §3.3 写 0.6）没有通道可用。**
   两条路：**A. 写成代码常量**（每次改都要重新编译烧录）；
   **B. 加协议 ID**（要同时改 `apex_protocol.h`、`pid_table.c`、**黑匣子场次头格式**、遥控端 ⇒ 两端都要重烧）。
   ⚠️ 用户明确要求"能在遥控器上调定高 PID"，所以选 **B**。

---

## ⭐ 2026-09-15 飞前清账（第一次定高实飞之前一次性做掉的项）

> 用户的计划：**这次调参实现"下=降落 / 中=定高 / 上=上升"三段操作**，定高基本功能即完成；
> 之后直接进自动起飞 → 光流。所以飞之前把所有"琐碎但必须做"的事一次清干净。
>
> ⚠️ **2026-09-18 更正：这条计划改了 —— 光流提前开始，定高先放一边。**
> 用户实测发现**定高能悬停、但水平会一直漂走**（起飞漂 2~5 米，之后持续缓慢漂），
> 而厂区面积小、漂移会撞墙 ⇒ **定高没法长时间测试**。
> ⇒ 改成**先做定点**（那是缺少水平位置反馈的物理事实，定高调好了也不会改善）。
> **OF1~OF5 已实施（v0.23）**，方案见 `光流接入方案.md`、验收见 `光流定点施工顺序.md`。
>
> ⚠️ **一个直接影响本文件的副作用：GPS 被临时摘掉了。**
> 本板只有 USART2（GPS 座）与 USART3（打印）两个串口，光流接到了 USART2。
> 开关是 `Core/Inc/apex_config.h` 的 `APEX_UART2_ROLE_FLOW`（=1 光流 / =0 GPS，GPS 代码路径没删）。
> 后果：**黑匣子场次头部的 UTC 时间戳会写 0**（时间来自 GPS；用户已定：照原样显示、不做兜底，
> 找日志请按**场次序号**找）。定位/导航/高度/姿态/混控/油门/定高**都不读 GPS**，其余不受影响。

### 代码改动一览（v0.21）

| 项 | 文件 | 由 → 到 | 理由 |
|---|---|---|---|
| 摇杆速率 | `vertical_control.h` | 下降 2 → **5**、上升 3 → **5** cm/s | "下区域要能当**降落**用"：2cm/s 时从 1 米落地要 **50 秒**，飞行员会以为坏了。5cm/s 约 20 秒。⚠️ 仍远低于自由落体量级（300+ cm/s），"慌乱收杆也不会失控"的保护性质不变 |
| 姿态门禁 | `vertical_control.h` | 25 → **30°** | 与满杆角度配套（见下）。⚠️ **同一个阈值管两件事**：门禁② 的 `ATT_OK` 与 H12 的 `fr=2` |
| 满杆角度 | `attitude_control.c` | 20 → **15°** | 满杆 20° 对 25° 门禁只留 5° 余量，打满杆 + 一阵扰动就可能触发 `fr=2`（**立即停桨**）。15° + 30° 门禁 ⇒ 余量 15° |
| 停手门槛 | `vertical_control.h` | 6.0 → **4.0 cm** | 6.0 是垫高台架的测试值（**待办 3 结案**） |
| 失联门限 | `control_link.h` | 800 → **1500 ms** | LoRa 实测间隔 300~320ms ⇒ 800ms 只容忍连丢 2~3 帧就空中停桨（**待办 9**，但**未根治**） |
| 删 `vm` 命令 | `blackbox.c`、`vertical_control.c/.h` | 全部删除 | 临时命令，遥控端已能切模式（**待办 2 结案**） |
| **首飞 `vz_kp`** | 文档/参数（**不是代码**） | 5 → **2** | ⭐ 物理仿真扫表：延迟 80/100/120ms 下 `vz_kp ≤ 2` 稳、`≥ 3` 就开始振荡。**瓶颈是内环，不是外环**（更正 H13 的初版结论） |
| 三段边界 | `vertical_control.h` | 350 / 650（**不变**） | 用户遥控器中位约 520，落在保持段内 ✓ |

⚠️ **上面大部分是"要重烧"的代码改动，一次烧进去**；**遥控端不用动**
（`h_kp`/`vz_kp`/`vz_ki`/MAX THROTTLE 都是遥控可调）。

### 首飞参数（烧录后在遥控器上确认）

| 参数 | 值 | 备注 |
|---|---|---|
| `vz_kp` | **2** | ⚠️ 不是 20（H9 实验值）、也不是 100（代码默认） |
| `h_kp` | **0.3** | 代码默认已是 0.3；⚠️ Flash 里可能有旧 0.6 |
| `vz_ki` | **5** | 决定起飞前"憋油门"多久 |
| MAX THROTTLE | **2000** | 老坑：`LOAD_SAVED` 会把 1500 带回来 |

### ⚠️ 飞前必须过一遍的三件事（都不用飞）

1. ⭐ **在地面上先看一眼 `h`**：静止读数必须 **< 3.5cm**（否则停手门槛 4.0 给不出余量 ⇒ 停手永远进不去）。
2. ⭐ **举到 1.25m 以上**（ToF 仍有效）：应看到 `fr=3` → `st=6` 保持 2s → `st=7` 且 `thr` 按 30µs/s 降到 1000。
   **一条顶 H12 验收表的一半**（高度越界判据 + 保持段 + 下降段 + 斜率 + 地板）。
3. ⭐ **拔 ToF 线 / 把飞机歪到 30°**：`fr=1`（拔线）；`fr=2` 且**立即** `thr=1000`（歪 30°，**不进 `st=6`**）。

### ⚠️ 本次飞行的预期现象（不是故障，先知道就不会误判）

1. **推杆后 8~13 秒才离地**：⚠️ 其中**"解手"已经很快了**（H14 起推杆过 200 就解手），
   这 8~13 秒几乎全是**憋悬停油门**的时间。**目标抬得越低等得越久**（抬到 15cm 约 13s、30cm 约 8s）。
   ⭐ 顺带记住：**解手那一刻油门从 1000 跳到 1250（0.31 秒）**，而且杆停在下降段/中间段
   也一样会转（这正是 H14 的目的）。**要停就收杆到 ≤100 或上锁**。
2. **台架上 `i` 会一路顶到天花板 1650**（飞机起不来、误差一直大，估计器就一直学）。
3. **稳态精度 ±2cm**（P + 硬死区）。要更准得上 `h_ki`（ID 31），那是 H15 的活。
4. **落地后桨还转一会儿**（只有失效下降那条路会这样），**上锁即止**。
5. **高度超 120cm 会触发 `fr=3` ⇒ 开始慢降**（不是失控，是 H12 的设计）。
6. **杆一直推着不松手** ⇒ `h_sp` 涨到 120cm 上限、飞机一直往上爬（滞后约 5cm）。

### 这次飞行要验的功能（代码已经在跑，不是要写）

`下 0~350 = 缓降 5cm/s` ／ `中 350~650 = 保持（h_sp 冻结、松手就稳住）` ／ `上 650~1000 = 缓升 5cm/s`。
⚠️ 三段映射是 **H6** 就实现的、`h_sp` 积分也是；**这次是验手感 + 调增益，不是实现功能**。

### 调参顺序（§7.3 的落地版）

⭐ **先内环、后外环**（这是 H13 扫表得出的顺序，别反过来）：
1. `vz_kp`：2 → 3 → 4（**一次加一档**；看到"高度在目标附近来回抽"就退回上一档）；
2. 再动 `h_kp`：0.3 → 0.4 → 0.6；
3. **每次改完都要导黑匣子看波形再改**（排序规则第 6 条：不凭感觉连改）。

---
## H8 验收步骤（2026-09-15 实施，待硬件验证）

⚠️ **全程拆桨**。观测量只有一行：`[ALT] ... thr=<微秒>`。

| # | 操作 | 期望现象 |
|---|---|---|
| ① | **普通模式**，解锁，推杆从最低到最高 | `thr` 从 **1000** 平滑涨到 **1500**，和改动前**完全一致** |
| ② | 上锁 → 杆收最低 → 遥控切**定高模式**（或 `vm 1`）→ 解锁 | `st=4` 且 **`thr=1000` 不动** |
| ③ | ⭐⭐ 定高模式下**推杆到底并保持** | ⚠️ **头 1.33 秒**（334 拍）`thr` **恒 1000、电机不转**（H6 在这里是 1345µs，这是本环节的核心现象）；<br>⚠️ **继续推着不放，第 334 拍起按设计爬到 1100**（电机开始转）—— 因为"推杆"的语义就是"命令爬升"，`h_sp` 涨过 4cm 就要退出停手。**这不是故障** |
| ③b | 同上，但杆只推到 **690**（刚过保持段） | 变化率只有 +0.34cm/s，涨过 4cm 要 11.7s，所以 **8 秒内 `thr` 一直是 1000** —— 这一条才最能说明"油门不跟杆走" |
| ④ | 杆保持 >650 | 第 **334 拍**（1.33s）`st` 从 4 → **1**、`gnd=0`；`thr` 再用约 **31 拍**（0.13s）爬到 **1100** |
| ⑤ | 杆回到中段（350~650） | `h_sp` **冻结不回落**，`thr` 停在 **1100** |
| ⑥ | 杆拉到底（≤350） | ⚠️ **只要 500ms 去抖（125 拍）**就回 `st=4` —— **不需要等 `h_sp` 掉回 4cm 以下**（停手进入判据用的是 `h_est` + `rate`，不是 `h_sp`）；`thr` 再用约 **83 拍**（0.33s）降回 **1000** |
| ⑦ | 上锁 | `thr` **立即** 1000（上锁分支直接赋值，不走限速器） |
| ⑧a | ⭐ 举到 **1.2m 以上**（⚠️ 2026-09-15 实测后拆成两条） | `sw` 掉 **`HEIGHT_OK`**（> `VERTICAL_MODE_MAX_HEIGHT_CM` = 120cm，**软上限先触发**）；⚠️ `st` **仍是 4**（停手不因高度退出，这是设计）；`thr` **仍是 1000** ⇒ 安全 |
| ⑧b | ⭐ 再举到 **1.3m 以上**（超过 ToF 量程） | `v=0`、`sw` 再掉 **`EST_VALID`**（**硬件量程后触发**，实测约需 **>1.35m**）；`st`/`thr` 同上 |

⚠️ **为什么必须拆成两条**：原判据写成一条"举到 1.3m 以上 → `v=0`、`sw` 掉两位"，
把两个**触发点完全不同**的事件混在一起了 —— 120cm 是**代码里的软上限**（先掉 `HEIGHT_OK`），
约 1.3~1.35m 才是 **ToF 的硬件量程**（再掉 `EST_VALID`）。
2026-09-15 实测只举到 **128.1cm**，因此只看到 ⑧a 的现象、⑧b 没触发。
⚠️ **举高的物理限制**：飞机是**用 USB 线连在电脑上**的，往上举会把线扯掉
（实测当场端口掉了 3 次、丢了约 143 秒数据，也因此没能举过 1.3m）。
⇒ 做 ⑧b 要**换更长的 USB 线**，或者**用支架**把飞机架到 1.35m 以上（别手举）。
| ⑨ | 在两种模式间来回切 | ⚠️ **不是"全程无台阶"**：<br>· **普通模式 → 上锁** 是直接跳到 1000（**改动前就是这样**，不是 H8 引入的）；<br>· **上锁 → 解锁（定高停手）** 两边都是 1000，天然无扰；<br>· **定高停手 → 控制** 是 1000→1100 经限速器软启动（约 0.13s） |
| ⑩ | 切回**普通模式** | 摇杆重新驱动 `thr`（1000↔1500） |

**停止条件**（出现任一条就是没做对，回滚）：
- ① 普通模式与改动前有任何差异；
- 定高模式下 `thr > 1100`（**任何杆量、任何高度**）；
- ⑧ 举高后 `thr ≠ 1000`。

**已知的预期中间态**：`thr = 1100` 正好落在姿态环的旁路边界（`<= 1100` 含等号），
所以 **H8 阶段定高模式下没有姿态修正**。这不是 bug，H9 把修正量加到 1100 之上才会恢复。

⚠️⚠️ **本环节留下的一个安全缺口（已登记为待办 5，H14 首飞之前必须解决）**：
`GetThrottleUs()` 在门禁②没过时一律返回 **1000**。在地面上这是完全正确的（停手）；
但**如果飞机在空中**丢了读数（超量程 / 传感器坏）或姿态歪超 25°，
返回 1000 的含义就是**电机停转、空中停车**。
方案 §6.2 的要求是"**传感器失效时退回基准油门就能继续飞**"，那需要"内环积分器=悬停油门估计器"
存在之后才做得了（H9/H10）。⇒ **在 H11/H12 把自动退出/自动降落做完之前，不许飞定高**。
台架（拆桨）不受影响。

> ✅ **2026-09-15 状态（H12 / v0.19）：这条禁令已解除。** 缺口由 H12 的失效处理结掉
> （`st=6` 保持锁存油门 → `st=7` 按 30µs/s 平缓降到 1000）。**下面这段是当时的历史记录，保留备查。**
> ⚠️ 但**另一条与定高无关的缺口**仍然挡在首飞前面：全局失联门限 800ms
> （LoRa 实测间隔 300~320ms ⇒ 连丢 2~3 帧就停桨），登记在待办 9。

---

### ⭐ H8 实测结果（2026-09-15，用户执行，结论由串口审计日志逐条自动核对）

**证据**：Keil `unify_builder.log` 里 12:51:38 那次增量编译重编的正是 H8 的 6 个文件
（`vertical_control.c` / `motor_test.c` / `tof.c` + 依赖头文件的 `app_freertos.c` / `radio.c` / `blackbox.c`），
`build successfully`；COM9 审计日志 12:54:54–12:57:38 共 **314 个 `[ALT]` 样本（约 157 秒）**，
`thr=` 字段存在、`loop=` 已消失 ⇒ **H8 固件确实在跑**。
核对脚本：`_inbox_会话提取/提取脚本/verify_h8.js`（读 DSH 串口审计日志，按判据自动判定）。

| 判据 | 结果 | 实测数据 |
|---|---|---|
| ① 普通模式映射不变 | ✅ | 31 样本；限速带外 0；杆量连续两拍不变的 13 个全部精确；**杆 690 → thr=1345**（与改动前同值） |
| ② 定高+解锁+杆最低+停手 → 1000 | ✅ | 10 样本，`ct=0x7`（**已解锁**）全部 `thr=1000` —— 走的是 `GetThrottleUs()` 新路径 |
| ③ 推杆时 h_sp 未过 4cm → 恒 1000 | ✅ | 14 样本全部 1000（stick 最大 **1000**）；越过 4cm 后立刻变 `st=1 thr=1100` |
| ★ **不变式：定高下 thr ≤ 1100** | ✅ | 257 个定高样本，thr 只出现 `{1000, 1009, 1100}`，**超限 0 个** |
| ④ 控制启用时 1100、不跟杆 | ✅ | 47 样本，**21 种杆量（200~1000）全部 thr=1100** ← 本环节的核心现象 |
| ⑤ 中段 h_sp 冻结 | ✅ | 13 样本，h_sp 冻在 20.7 / 23.8 不动，thr 停 1100 |
| ⑥ 拉到底 → 重新进停手 | ✅ | 2 次转换，进停手那拍 `gt=500ms`（正好是去抖窗口） |
| ⑦ 上锁 → 立即 1000 | ✅ | 154 样本全 1000 |
| ⑨ 模式切换油门连续 | ✅ | 2 次切换，跳变 >20µs 的 **0 次** |
| ⑧ **举到 1.3m 以上** | ⚠️ **部分完成**：⑧a（>1.2m）✅ 通过；⑧b（>1.3m 触发 `v=0`）⬜ 未达成（受 USB 线长度限制，详见下） | 举到 **128.1cm**：`sw` 从 0xF 掉成 **0x7**（掉了 `HEIGHT_OK`），**`st` 仍 4、`thr` 仍 1000** ⇒ 安全 |

**顺带被数据正面印证的两条既有设计**（不是新结论，是第一次看到实测形态）：
- `st 1→4` 的转换恰好发生在 `h_sp` 从 **3.8 跨到 4.3** 的那一刻，与设计值 4.0 对上；
- 有一段时间杆停在中段（`rate=0`）却仍判在停手 —— 因为**起飞保护只在 `rate < 0` 时清除**，
  `rate=0` 清不掉。这正是 H6 写下的行为。

**黑匣子**：本次台架测试已记录（session 1818 / 1819 / 1820，468 / 3976 / 12786 采样 ⇒ 234 / 248 / 250 Hz ✓）。
`rec=0` 只是 disarm 之后的正常状态，不是故障。

**新增观察（记给 H9，不是缺陷）**：台架上飞机不离地，推杆把 `h_sp` 积分到了 **23.8cm**。
H8 没有外环所以无害；**H9 接上外环后**，退出停手那一刻外环会拿到一个 20cm 量级的正误差。
真机起飞时 `h_sp` 通常只涨到几厘米，多半是台架特有现象 —— 但 H9 要确认一下要不要在地面上钳 `h_sp`。

---

### ⭐ ⑧「举高」的补充实测（2026-09-15 13:03，同一天稍后）

用户把飞机举起来做 ⑧，结果 **拆成了两件事**（判据已按此改写，见上面的验收表 ⑧a/⑧b）：

| 观测 | 数值 | 说明 |
|---|---|---|
| 离地样本 | **32 个**，h = **96.6 ~ 128.1cm** | 全程 `st=4`、`thr=1000`、`v=1`、`ct=0x6` ⇒ **停手在离地状态下依然成立，油门不动** |
| **`sw` 掉 `HEIGHT_OK`** | h>120cm 的 **2 个样本全部 `sw=0x7`** | 触发点是**代码里的软上限** `VERTICAL_MODE_MAX_HEIGHT_CM = 120cm` |
| `v=0`（掉 `EST_VALID`） | **没触发** | h 最高 128.1cm，**还在 ToF 的 ~1.3m 量程内**，所以没判失效 |
| ★ `thr` 超过 1100 | **0 个** | 不变式在离地状态下依然成立 |
| ⑧b 需要的实际高度 | 约 **>1.35m** | 软上限与硬件量程是**两个不同的触发点**，原判据把它们混成一条了 |

⚠️ **举高时暴露的物理问题：飞机是用 USB 线连在电脑上的，往上举会把线扯掉。**
13:03:25 / 13:03:46 / 13:04:04 **端口掉了 3 次**（日志里是
`port closed unexpectedly (COM9) — unplugged, or the driver dropped it`），
`n=` 的跳变显示**丢了约 143 秒数据**，也因此没能举过 1.3m。
⇒ **做 ⑧b 必须换更长的 USB 线，或者用支架架到 1.35m 以上（别手举）。**

**顺带撞见的一次"意外注入"**：掉线前后出现 3 次 `[BB] unknown cmd, send dump dumpall calmag vm or stop`
（集中在 13:03:32~34，也就是一次掉线重连之后 2~3 秒）。两个可能的原因：
① **拔插瞬间 RX 线上的噪声**被 USART3 收进来当命令解析（我觉得是这个）；
② 手打命令被 **5ms 轮询**吃掉了字节（已知限制，见待办 4）。
**无法从日志区分**，但有一点是好的：**收到垃圾字节之后主循环照常跑、后续数据正常**。
⚠️ 注意这**没有**验证待办 4 那条"ORE 溢出标志的恢复路径" —— 只证明了收到垃圾不致命。
⇒ 记住操作规矩：**别在刚拔插之后发命令；发命令要逐字节、间隔 ≥10ms。**

---

## H9 验收步骤（2026-09-15 实施，待硬件验证）

⚠️ **全程拆桨**。观测量：**一行 `[V]`**（v0.16 起，取代原来的 `[TOF]` + `[ALT]` 两行）：

```
[V] raw=28mm | h=2.8cm vz=-0.3cm/s v=1 | req=1 mode=1 st=4 sw=0xC ct=0x7 stick=0 h_sp=0.0 gt=500ms | corr=+0.0 thr=1000
```

⚠️ **v0.18（H10）起这一行多了 `i=`（慢层 / 悬停油门估计器），位置在 `corr=` 与 `thr=` 之间**：

```
[V] raw=28mm | h=2.8cm vz=-0.3cm/s v=1 | req=1 mode=1 st=4 sw=0xC ct=0x7 stick=0 h_sp=0.0 gt=500ms | corr=+0.0 i=1250.0 thr=1000
```

⇒ **H9 及更早的日志没有 `i=`**，那时要用旧版核对脚本（`git` 历史里那一版 `verify_v.js`）。
本节下面的判据描述保留 H9 当时的形态，**不改写**；H10 的判据见下面「H10 验收步骤」。

需要看的只有**加粗**那几项，其余是出问题时才看的：

| 段 | 字段 | 本环节看什么 |
|---|---|---|
| ① 传感器 | `raw` | ToF 是否在出数据（估计器的输入） |
| ② 估计器 | **`vz`**、`h`、`v` | **`vz` 是符号判据的左半边**；`v` 必须为 1 |
| ③ 状态机 | **`st`**、`req` `mode` `sw` `ct` `stick` `h_sp` `gt` | **`st` 是本环节最重要的一个数**（4 停手 / 1 在干活 / 5 已进未使能）；`req`≠`mode` 就是"被拒"；`sw`/`ct` 是两层门禁位图（全通 0xF） |
| ④ 输出 | **`corr`**、**`thr`** | **本环节的核心**：`corr` 的符号必须与 `vz` 相反；`thr` = 普通模式跟杆走 / 定高 = 1250 + `corr` |

⚠️ **例行的 `[TOF]` 与 `[ALT]` 两个标签在 v0.16 起不再存在**（合并为 `[V]`）。
但 ⚠️ **`[TOF]` 标签本身没消失**：`tof.c` 里 `init ok` / `init fail` / `trigger fail` /
`too many misses, re-init` 这些**一次性事件**仍在用它 —— 那是 ToF 模块自己的故障与状态消息，
和例行数据行不是一回事，开机时看到 `[TOF] init ok: ...` 是正常的。
核对脚本相应换成 `verify_v.js`（见「台架仿真」节）；
本文里 2026-09-15 之前的实测记录仍沿用旧标签，那是当时真实的打印，不做改写。

### 第 0 步（**必做，否则看不出符号**）：先用遥控把 `vz_kp` 改成 20

`vz_kp` 的默认值是 **100**。而实测静置噪声 σ = **0.47 cm/s**（592 个样本），
Kp=100 时**噪声自己**就能推出 **±150µs**，远超 ±30 限幅 ⇒ **限幅会长期顶死、符号被淹没**。

> 遥控 → PID 页 → **垂速 KP**（`EDIT_PID_VERTICAL_SPEED_KP`，步进 10，范围 0~500）
> → 从 100 降到 **20** → 确认。
> ⚠️ `PidTable_Init()` **不会自动从 Flash 加载已保存参数**，所以每次上电/复位后都要重设，
>    或者用 SAVE 存下来再 LOAD_SAVED。
> ⚠️ 解锁中禁止改参（`PidTable_HandleCommand` 的既有约束），必须在**上锁**状态下改。

### 判据

| # | 操作 | 期望现象 | 在验什么 |
|---|---|---|---|
| ① | **普通模式**解锁，推杆 0→1000 | `thr` 1000 → 1500，与 H8 **完全一致**；`corr` 恒 0 | 回归 |
| ② | 上锁 → 杆最低 → 切**定高**（或 `vm 1`）→ 解锁 | `st=4`、`thr=1000`、**`corr=0.0`** | 停手时内环闭嘴 |
| ③ | 上锁 | `thr` 立即 1000、`corr=0` | 同上 |
| ④ | 推杆 >650 约 1.4s | `st=1`；`thr` **稳定后**落在 **1220~1280**（⚠️ 刚退出停手那几拍是 1000→1250 的**限速过渡值**）；飞机静止时 `corr` 接近 0 | 基准 1250 + 限幅生效 |
| ⑤ | ⭐⭐ **手快速下压飞机** | `vz` 变**负** → `corr` 变**正**、顶到 **+30** → `thr` 走向 **1280** | **符号（核心）** |
| ⑥ | ⭐⭐ **手快速上提飞机** | `vz` 变**正** → `corr` 变**负**、顶到 **−30** → `thr` 走向 **1220** | **符号（核心）** |
| ⑦ | 静止不动看 10 秒 | `corr` 抖动幅度 ≈ **Kp × 0.47 ≈ ±9µs**（**不**顶限幅）。把这个数记下来 | Kp 还能不能再往上加 |
| ⑧ | 杆拉到底 → **让飞机真的降下来** | 降到 `h_est ≤ 门槛` 后约 **0.5s** 回 `st=4`；`corr` **立刻**回 0；`thr` 约 **0.83s** 后回到 **1000**<br>⚠️ **举着不放是回不去的**，见下方"实测结果"里的第 6 条 | 停手往返干净 |
| ⑨ | 举到 **1.2m 以上** | `sw` 掉 `HEIGHT_OK`；若此时仍判在空中，`st` **仍是 1**、`thr` 仍是 1250±30（⑧a 是"在地面上举高"的情形，那时 `st` 才是 4） | 门禁① 的高度位 |
| ⑩ | 遥控把 `vz_kp` 20 → 5 → 50 | ⑦ 的抖动幅度按比例变（5→±2µs、50→±24µs）；最后**改回 20** | **参数是活的** |

**停止条件（出现任一条立刻回滚）**：
- ⭐⭐ **⑤⑥ 符号反了**（下压却减油门）—— 这是**唯一会真正导致失控**的错误
  （正反馈 ⇒ 飞机被抬起来就一直往上飞）。它就是 `pid.c` 里 `error = setpoint − measured`
  那个减号，或者 `Pid_Update` 的两个参数顺序写反了。台架上必须验死；
- 停手 / 上锁 / 门禁②没过时 `corr ≠ 0`；
- `st=1` **稳定后** `thr` 跑出 **1220~1280**（硬上限 1280 任何时候都不许破）；
- 普通模式出现任何差异。

### ⚠️ 本环节必须提前知道的三件事

1. **台架能验符号，验不了增益。** 手是"**无限权限**"的扰动源 —— 你按着飞机，它就不会真的跑飞，
   所以**即使增益大到飞行中会自激振荡，台架上看起来也完全正常**。
   增益只能首飞整定（H14，修正量限 ±50µs 起）。
2. **定高模式下油门不再"只会更低"。** 基准从 1100 抬到 1250 就是本环节的目的：
   不抬上去，"该减油门时减"这条判据**物理上验不了**（再减就低于电调有效下限），
   而且输出会在 1100 边界上来回穿、把姿态环反复 Reset。
   **停手仍然恒 1000**，"地面不会自己起飞"没有削弱；H8 的判据 `thr ≤ 1100` 到此作废，改 `thr ≤ 1280`。
3. **姿态环在定高模式下恢复参与了。** H8 时定高给 1100，正好命中 `motor_test.c` 里
   `throttle_us <= MOTOR_ATTITUDE_ENABLE_PWM_US`（= 1100，**含等号**）的"四路等值"分支，
   所以那时定高**没有**姿态修正；现在给 1250±30，不再命中 ⇒ 姿态环重新工作。

---

### ⭐ H9 实测结果（2026-09-15 17:24–17:30，用户执行，结论由 `verify_v.js` 逐条自动核对）

**证据**：3 份审计日志共 **598 个 `[V]` 样本（约 299 秒）**，`verify_v.js` 判定 **通过 10 / 失败 0 / 未测 0**。
（日志：`COM9-20260915-172454 / -172801 / -172931.jsonl`）

| 判据 | 结果 | 实测 |
|---|---|---|
| ★ 字段串位自检 | ✅ | 598 个样本的 raw/h/st/sw/ct/stick/thr 全部落在合理值域 |
| ① 普通模式 `thr = 1000 + 0.5×stick` | ✅ | 58 样本，限速带外 0；杆量连续两拍不变的 39 个全部精确；`corr` 恒 0 |
| ② 停手 → `corr=0`、`thr` 回 1000 | ✅ | 150 样本，`corr` 非 0 的 **0** 个 |
| ③ 上锁 → `thr=1000` | ✅ | 47 样本全 1000 |
| ④ 控制启用 `thr` 稳定后在 1220~1280 | ✅ | 326 样本 / 6 段；硬上限越界 **0**；涉及 **30 种杆量（0~1000）** |
| ⑤⑥ ⭐⭐ **符号** | ✅ | **强信号（\|vz\|≥3）85 个：反号 85、同号 0**；弱信号 231 个全部反号 |
| ⭐ **等效 Kp** | ✅ | **19.9 µs/(cm/s)** —— 与遥控里设的 **`vz_kp = 20` 吻合**，证明参数是真活的 |
| ⑦ 静止 `corr` 抖动 | ✅ | 111 样本：σ=4.8µs、幅度 8.9µs（**没顶限幅**）；同时刻 `vz` RMS 0.24cm/s |
| ⑧ `st 1→4` 转换 | ✅ | 4 次，进入那拍 `gt=500ms` |
| ⑨ 举到 1.2m → `sw` 掉 `HEIGHT_OK` | ✅ | h>120cm 的 10 个样本**全部** `sw=0x6`（0xE→0x6，位 3 掉了） |
| ★ 不变式 `thr ∈ [1000,1280]` | ✅ | 488 个定高样本，越界 **0** |

**⇒ H9 的核心目的（"证明那个减号写对了"）达成，而且等效 Kp 与设定值吻合。**

#### ⭐ 用户实测中提出的四个"为什么"，全部是设计行为（不是 bug）

四个现象有**同一个根源**：**停手只用"估计高度"判断，而"估计高度"就是"镜头到下方物体的距离"。**
定高**不知道**"飞机是不是在飞"，它只知道"离下方物体多远"。手举着 = 26cm = 系统认为在空中。

| # | 现象 | 实测数据 | 原因 |
|---|---|---|---|
| 1 | 推杆后**等了几秒**电机才逐步转起来；中途收杆也不减速 | stick 0→760，`h_sp` 从 0 涨到 4.3 时才 `st=1` | `h_sp` 从 0 涨到 **4cm** 才退出停手。stick=760 时速率 = 3×(760−650)/350 = **0.94cm/s ⇒ 约 4.2 秒**。这就是"等了几秒"。<br>⚠️ **收杆不减速**：定高模式下杆只管"目标高度变化率"，**不再直通油门**。 |
| 2 | 杆放最低了，**还在转** | `stick=0` 但 `st=1`，`h_est=26cm`，`thr` 保持 1243~1252 | 杆到底 = **−2cm/s 缓降**，不是停油门（"取消待命段"的直接后果）。<br>要进停手必须 **`h_est ≤ 6cm`**，而手举着 26cm ⇒ 永远进不去 ⇒ 油门保持基准 1250。<br>✅ 真实飞行时它会真的降，落到 6cm 以下就停手了。 |
| 3 | 上锁停了，**再解锁又转** | 上锁 `st=5 thr=1000` → 解锁 `ct=0xF` → `st=1 thr=1262` | 解锁后门禁②**全通**（已解锁 + 读数可信 + 姿态平稳 + **不在停手**，因为 `h_est=25.7cm`）⇒ 控制启用 ⇒ 基准 1250。<br>✅ **真实地面上解锁不会转**（`h_est≈3cm` → 停手）。他看到转，是因为**那一刻飞机在他手里**。 |
| 4 | **放回垫高位置就停机了** | `h=5.6cm`（≤ 门槛 6.0）+ 杆最低 + 500ms → `st=4`，`thr` 1276→1122→1000 | **这正是停手在工作** —— 而且注意：**此时仍是解锁状态**。 |

#### ⚠️ 这次实测暴露的三个要留意点（已登记）

1. ⚠️ **解锁时没有任何"必须在地面"的检查**（现象 3 的另一面）：
   `motor_test.c` 的 `!armed` 分支只把油门复位到 1000，**不看 `h_est`**。所以
   **举着 / 架着（> 门槛）解锁时，油门会在约 0.31s 内爬到 1250，桨就转起来了**。
   地面上安全（停手挡住），但**装桨后"先放地面、确认停手、再解锁"是硬规矩**——
   H14 首飞流程已经这么写了，但**代码层面没有强制**。要不要加门禁属于 **H12** 的范围。
2. ⚠️ **高度超过 120cm 时，门禁① 掉了但控制器没有退出**：
   实测 `h=125cm` 时 `sw=0x6`（`HEIGHT_OK` 掉了），但 **`st` 仍是 1、`thr` 仍 1220~1280**。
   ⇒ 真实飞行中爬过 120cm，定高会**继续用不可信的高度**干活。**这是 H12 的活**（退出判据还没做）。
3. **`h_sp` 在普通模式下也一直在积分**：实测普通模式推杆时 `h_sp` 涨到了 **19.3cm**。
   切进定高时 `VerticalControl_Reset()` 会把它对齐到 `h_est`、随后停手再归零，**所以无害**；
   但打印上看起来会误导（"普通模式怎么也有目标高度？"）。
   它是无条件的——**停手需要 `h_sp` 作为唯一出口**，不能只在定高模式下积分。

#### ⭐ 这次实测也**顺带把 H8 遗留的 ⑨ 补验了**

举高到 120cm 以上时 `sw` 从 `0xE` 变成 `0x6`（`HEIGHT_OK` 位掉了）——
H8 待办 6 的"⑧a 举到 1.2m"这次拿到了**10 个样本**的正面证据。
⚠️ 但与 H8 时的情形不同：**那次飞机在地面上（停手），`st` 仍是 4、`thr` 仍 1000**；
**这次飞机在空中（手举着），`st` 仍 1、`thr` 仍 1250±30**。判据已按此改写。

---

## H10 验收步骤（2026-09-15 实施，待硬件验证）

⚠️ **全程拆桨**。观测量是 `[V]` 行尾段的三个数：**`corr=`（快层）、`i=`（慢层）、`thr=`（两者之和）**。

### 烧录前必须先做的参数设置（3 个）

| 参数 | 遥控位置 | 设成 | 为什么 |
|---|---|---|---|
| **`vz_kp`** | PID 页 →「高度」→ 垂速环 Kp | **20** | 默认 100 时**噪声自己**就能推出 ±150µs，远超 ±50 限幅 ⇒ 限幅长期顶死、符号看不出来。20 是 H9 实测验过的值 |
| **`vz_ki`** | 同页 → 垂速环 Ki | **5** | 本环节的起步值。台架上"匀速移动 20cm/s"能让 `i` 以 **100µs/s** 变化 ⇒ 2 秒走 200µs，肉眼可见；够慢够安全 |
| **MAX THROTTLE** | 同页 → 第三行 | **2000** | 默认值已改成 2000；如果 Flash 里存着旧的 1500，`LOAD_SAVED` 会把旧值带回来 ⇒ `thr` 只会到 1500。**用「默认」按钮或手动改成 2000** |

⚠️ **改参必须在已上锁状态**（解锁中遥控端禁止改参，是既有约束）。
⚠️ **参数表上电不自动从 Flash 加载**，每次上电要么重设、要么 `LOAD_SAVED`。

### 验收表

| # | 操作 | 期望现象 |
|---|---|---|
| ① | **普通模式**解锁，推杆 0→1000 | `thr` **1000 → 2000**（满杆映射变了，`=` 一格 1µs）；`corr` **恒 0**；`i` **恒 1250**；<br>⚠️ 杆 450 处 `thr` 应约 **1450**（用户说这里能起飞）；杆 500 处约 1500 |
| ② | 上锁 → 杆最低 → 切定高 → 解锁 | `st=4`、`thr=1000`、**`corr=0`、`i=1250`** |
| ③ | 推杆 >650 约 1.4s | `st=1`；`thr` 经限速器从 1000 爬到 **1250**（约 0.31s，中间会看到 1003/1055/1192 这类**过渡值 —— 不是越界**）；`i` 仍是 **1250**（进控制不跳变） |
| ④ | ⭐ 手**快速下压** | `vz` 负 → `corr` 正、顶 **+50** → `thr` 走向约 1300 |
| ⑤ | ⭐ 手**快速上提** | `vz` 正 → `corr` 负、顶 **−50** → `thr` 走向约 1200 |
| ⑥ | ⭐⭐ **匀速上抬**飞机约 20cm/s，保持 2 秒 | **`i` 持续下降**（往 1150 走），2 秒约 **−200µs**。⚠️ 若 `i` 停在 1150 不动，说明已撞地板，**那是对的**（说明积分真的在累加） |
| ⑦ | ⭐⭐ **匀速下放**飞机同样 2 秒 | **`i` 持续上升**（往 1650 走），约 **+200µs** |
| ⑧ | **停住不动** 10 秒 | `i` **基本不动**（±几 µs）；`corr` 抖动约 **±9µs**（不顶限幅）—— 把这个数告诉我 |
| ⑨ | 遥控 `vz_ki` 5 → **0** | ⑥⑦ 的 `i` **完全不动**（冻结悬停油门估计）；改回 **20** → `i` 变化明显变快；**最后改回 5** |
| ⑩ | 杆拉到底 / 上锁 | 约 0.5s 后 `st=4`、`thr` 回 1000、**`corr=0`、`i` 回 1250** |
| ⑪ | 举到 1.2m 以上 | `sw` 掉 `HEIGHT_OK`（`0xC`→`0x8`）；⚠️ 因飞机在空中，此时 `st` 仍 1、`i` 仍等于当时值（不退出，属 H12） |
| ★ | **不变式** | `st=1` 时 **`thr` 与 `i` 恒在 [1150, 1650]**、**`|corr| ≤ 50`**、**`thr` 永不 ≤ 1100** |

### 停止条件（出现任一条立刻回滚）

1. ⭐⭐ **⑥⑦ 方向反了**（上抬却让 `i` 上升）—— 与 H9 的符号错误同性质，是正反馈，会失控；
2. `i` 或 `thr` 跑出 **[1150, 1650]**（积分没被钳住 = windup）；
3. 停手 / 上锁 / 门禁②没过时 `i ≠ 1250` 或 `corr ≠ 0`；
4. `st=1` 稳定后 `thr` 掉到 **1100 以下**（姿态环被旁路）；
5. 普通模式出现任何异常（`corr ≠ 0`、`i ≠ 1250`、映射不对）。

### ⚠️ 两个**预期现象**（不是失败，先知道就不会误判）

1. **台架上飞机仍然抬不起来。** 没有外环（`vz_sp` 仍固定 0）+ 拆桨，积分会动但油门不足以离地。
   **定高自己能起飞要等 H13（外环）。**
2. **静止时 `i` 不动。** `vz_est ≈ 0` ⇒ 误差 ≈ 0 ⇒ 积分不累加。
   **要让它动必须"匀速移动飞机"**，光按着不动是没用的。这也是 ⑥⑦ 为什么强调"匀速"。

### 台架能验 / 验不了

| 能验 | 验不了 |
|---|---|
| 慢层与快层的**符号** | `vz_ki` 该取多少（台架没有真实工作点可收敛） |
| 限幅、有界、无 windup | 稳定性 |
| 失效闭嘴（停手/上锁/门禁掉） | 真实悬停油门（**只能飞出来**） |
| 参数在线变更不丢 `i` | — |

⇒ 与 H9 同一条：**手是"无限权限"的扰动源，台架验得了方向、验不了增益。**

---

### ⭐ H10 实测结果（2026-09-15 21:18–21:22，用户执行，结论由 `verify_v.js` 逐条自动核对）

飞控端已烧 **v0.18**（构建日志 21:08:54 重编 `pid_table`/`vertical_control`/`blackbox`/`motor_test`/`tof`）。
日志 3 份、**451 个 `[V]` 样本 ≈ 226 秒**。

**判定：12 通过 / 0 失败 / 1 未测**（未测的是 ⑨ 举到 1.2m —— 本次 `h` 最大只到 **91.9cm**）。

| 判据 | 结果 | 实测数据 |
|---|---|---|
| ① 普通模式映射 + `corr=0` + `i=1250` | ✅ | 反推斜率 **k = 1.0000** ⇒ 满杆 **2000µs**（与 v0.18 的新默认值吻合）；杆 0 的样本曾经到过 1000；`corr`/`i` 全程为 0/1250 |
| ② 停手 → `thr=1000`、`corr=0`、`i=1250` | ✅ | 47 个样本；`thr` 集合 {1000, 1094, 1248}（后两个是限速回落过渡值） |
| ③ 上锁 → `thr=1000` | ✅ | 14 个样本全部 1000 |
| ④ `st=1` 时 `thr ∈ [1150,1650]`、`\|corr\|≤50` | ✅ | 231 个样本 / 10 段；`thr` 范围 **1150~1528**；硬越界 0；涉及 13 种杆量（150~1000） |
| ⑤⑥ **快层符号** | ✅ | 强信号（`\|vz\|≥3`）**66/66 反号**、弱信号 155/155；等效 Kp ≈ **20.2**（遥控设的 20） |
| ⭐⭐ **慢层符号** | ✅ | **严格档（相邻两条 `vz` 同号、`\|vz\|≥1`）：58 个可判、同号 0 个**；`\|vz\|` 门槛提到 8 仍是 0/13 |
| ⭐ **慢层有界** | ✅ | `i` 范围 **1153.8 ~ 1478.4**，全程在 [1150, 1650] |
| ⑦ 静止抖动 | ✅ | `corr` σ = **4.93µs**、幅度 **8.9µs**（不顶限幅）；等效 Kp ≈ 20.4；`i` 逐拍变化 RMS **0.61µs/拍** |
| ⑧ `st` 1→4 转换 | ✅ | 1 次，进入那拍 `gt=500ms` |
| ★ `thr ∈ [1000,1650]` | ✅ | 319 个定高样本，范围 1000~1528，越界 0 |
| ⭐⭐ **`st=1` 稳定后 `thr` 永不 ≤1100** | ✅ | 174 个稳态样本，`≤1100` 的 **0** 个 ⇒ 姿态环全程参与 |

#### ⭐⭐ 本环节最要紧的两条正面证据（happened exactly as designed）

**① 慢层方向：两个方向都对。** 挑"连续 5 拍同一方向"的段：

| 段 | `vz` 序列 | `i` 变化 | 判定 |
|---|---|---|---|
| 持续下沉 | `[-9.5, -6.5, -5.1, -4.5, -3.8]` | 1190.2 → 1247.3（**+57.1**） | ✅ 下沉 ⇒ 加油门估计 |
| 持续上抬 | `[+3.3, +5, +5.9, +7.4, +6.4]` | 1271.6 → 1210.6（**−61.0**） | ✅ 上抬 ⇒ 减油门估计 |

**② 地板与"积分/输出同锁"都真的在生效**，最漂亮的一例：

```
raw=236mm h=24.7cm vz=+11.2cm/s ... corr=-50.0 i=1153.8 thr=1150
```
`i` 被钳在地板 **1153.8**（正往 1150 走）、`corr` 顶在 **−50**，两者之和 (**1103.8**) 被最终那一层钳回 **1150**。
⇒ **如果没有最后那层钳位，油门就会掉到 1103.8，离姿态环旁路线 1100 只剩 4µs。** 三层钳位缺一不可，这一条是实测证据。

**③ 无 windup（顶到天花板后能自己退回来）**：飞机快速下坠时 `i` 一路涨到 **1478.4**，等它稳住之后
`i` 自己回落到 1245~1250 一带，没有卡在高位。

#### ⚠️⚠️ 这次实测**正面确认了两条"空中停车"缺口**（都是待办 5 的实证，**H12 必须修**）

| 触发 | 样本数 | 日志证据 | 后果 |
|---|---|---|---|
| **姿态歪超 25°**（门禁②掉 `ATT_OK`） | **38** | `ct=0xB`（`0xB` = ARMED+EST_VALID+NOT_GROUND，**缺 ATT_OK**）⇒ `st=5` ⇒ `thr` 从 1250 一路掉到 **1000** | 空中停车 |
| **ToF 读数失效**（`too many misses, re-init`） | **3** | `v=0 sw=0x0 ct=0x9` ⇒ `st=5` ⇒ `thr=1000`；`h`/`vz` 冻结在 61.7cm / +74.9 | 空中停车 |

第一次掉 `ATT_OK` 的上下文（飞机当时 `h≈22.7cm`，**在空中**）：

```
st=1 ct=0xf vz=-1.8 corr=35.3 i=1214.8 thr=1250
st=5 ct=0xb vz=-2.1 corr= 0.0 i=1250.0 thr=1166   ← 门禁刚掉，i 被按回初值
st=5 ct=0xb vz= 0.0 corr= 0.0 i=1250.0 thr=1012
st=5 ct=0xb vz=-0.5 corr= 0.0 i=1250.0 thr=1000
```

⚠️ 注意 `i` 同时也被按回 1250 —— 这就是 §5.4 里记录的"**不活跃时慢层回初值**"的代价
（一次飞行内门禁抖一下就会丢掉已学到的悬停油门）。拆桨台架上无害；
**真实飞行中这两条都会直接摔机**，所以 **H12 之前不许飞**这条不能松。

⚠️ 另外：`ct=0xB` 只掉 `ATT_OK` 一位 ⇒ **是姿态歪、不是读数坏**。台架上手拿着飞机快速上下移动，
很容易超过 25°；真实飞行中一阵风或一次打杆也会。⇒ **25° 这个门禁阈值对"空中"场景太严**，
这一点要留给 **H12** 一起定（要么放宽、要么失效时改为锁存而不是停车）。

#### 判据侧又踩了两次同类坑（第 5、6 次），已修

| 误报 | 原因 |
|---|---|
| ① 报"限速带外 6 个"+"杆 0 时 `thr≠1000` 4 个" | **带检的两个端点用了两个映射值**，而正确的一端是"上一拍**实际** `thr`"。杆从满位收到底时 `thr` 以 **300µs/s** 从 2000 衰减（到 1000 要 3.33s ≈ 7 拍打印），中途必然高于本拍映射值。⇒ 改成 `[min(上一拍 thr, 本拍映射值), max(...)]` |
| ⭐⭐ 慢层符号报"同号 7 个" | **拿两个端点瞬时 `vz` 去判一个积分的符号**。而 `i` 的变化取决于这 500ms 内的**平均** `vz`；端点一正一负（方向反转）或**丢行/乱码**（那次 COM9 掉了 3 次）时无从判。⇒ 加上"相邻两条 `vz` 必须同号"，同号立刻降到 **0** |

⇒ 教训合并进「台架仿真」节的坑位清单（第 5、6 条），并给 `gen_fake_v_log.js`
**补了一段"收杆回落"**（2000→1850→…→1000），让自测能覆盖到限速衰减。

---

## H12 验收步骤（2026-09-15 实施 v0.19）

> ## ⚠️⚠️ 本节【未执行】—— 用户决定跳过台架验证（2026-09-15）
>
> **用户原话**：「这个我就不用去进行测试了，到时候飞行测试如果出现这个情况，我再去看一下。」
>
> **实际状态**：代码已提交（`7b867e2`）、仿真 67 项全过、核对脚本 5 组对照组自测通过，
> 但**真机上一次都没跑过**。
>
> **风险已转移的位置**：失效处理的第一真实检验会在 **H14 首飞**中发生 ——
> 如果那条状态机有问题，**第一次发现会在飞行中**，而不是在拆桨的台架上。
> 缓解手段：① 仿真覆盖了全部状态机路径与不变式；② `[V]` 行有 `fs=` / `fr=` 两个观测量，
> 首飞时盯着它们就能判断失效处理是否按设计走；③ 黑匣子会把原因码记进 `alt_state` 的 bit5-6。
>
> ⚠️ **首飞前至少要确认一件事**：把飞机举到 **1.25m 以上**（ToF 还有效）看 `fr=3` 会不会出现
> —— 这条**不需要飞、不需要拆桨**，是最便宜的一次真实检验。见待办 11。
>
> 下面这张表保留，**首飞后要补做**（尤其是 ②③④⑧ 四条）。

⚠️ **全程拆桨**。观测量是 `[V]` 行里新加的两个数 + 老三个：

```
[V] raw=... | ... | req=1 mode=1 st=6 sw=0xC ct=0xD stick=1000 h_sp=20.0 gt=0ms fs=1500ms fr=1 | corr=+0.0 i=1450.0 thr=1500
                                                                                    ↑↑↑        ↑↑                     ↑↑↑
                                                                                  失效计时   原因                  锁存/斜坡值
```

| 段 | 字段 | 本环节看什么 |
|---|---|---|
| ③ 状态机 | **`st`** | **6 = 失效保持 / 7 = 失效下降**（新增）。`st` 与 `fr` 必须同进同出 |
| | **`fs`** | 失效计时：`0~2000` 在保持段，`≥2000` 已在下降段 |
| | **`fr`** | 0 无 / **1 ToF 读数失效** / **2 姿态超限** / **3 高度越界** |
| ④ 输出 | **`thr`** | `st=6` 时**恒定**（= 失效前一刻的输出）；`st=7` 时按 **30µs/s** 单调下降 |

### 烧录前（与 H10 相同）

`vz_kp = 20`、`vz_ki = 5`、MAX THROTTLE = 2000。改参必须在**已上锁**状态。

### 验收表

| # | 操作 | 期望现象 |
|---|---|---|
| ① | 普通模式推杆 / 上锁 / **停手** | 与 H10 一致；⭐ **停手仍然恒 1000**（不许被失效逻辑锁存成悬停值 —— 这是本环节最容易出的错） |
| ② | 进控制启用（`st=1`，`thr` 稳定）→ ⭐⭐ **拔 ToF 线** | 立刻 `st=6`、`fr=1`、`fs` 从 0 开始涨；**`thr` 在 2 秒内一点不动**（≈ 拔线前的值，**不是** 1000） |
| ③ | ⭐⭐ 拔线 **0.5 秒后插回** | `st` 回 **1**、`fs=0`、`fr=0`、**`i` 不丢**、`thr` **无跳变** ⇒ **瞬时失效什么都没发生** |
| ④ | 拔线后不管，等 `fs` 过 **2000ms** | `st=7`；`thr` 从锁存值**线性下降**，相邻两拍打印（500ms）差约 **15µs** ⇒ 斜率 ≈ **30µs/s** |
| ⑤ | ⭐ **下降全程看 `thr`** | 直到贴近 1000 之前**始终 ≥ 1100**（⇒ 姿态环不被旁路 ⇒ 水平着地）；到底后 `thr=1000` 且**桨停** |
| ⑥ | 上锁 | `thr=1000`、`fs=0`、`fr=0`；落地重选定高再解锁 ⇒ 能重新进入、`i` 回 1250 重新学 |
| ⑦ | ⭐ **举到 1.25~1.3m**（ToF 还有效） | `fr=3`、走 ②~⑥ 同一套（保持 → 下降）⇒ **不需要举到 1.35m，不受 USB 线长度限制** |
| ⑧ | ⭐⭐ **把飞机歪到 30° 并保持** | **立刻 `thr=1000`**、`fr=2`、⭐ **完全不进 `st=6`**（不是"先保持 2 秒再降"）；歪回去也不会恢复 |
| ⑨ | 歪到 24°（< 25°） | **不触发**（`st` 仍 1、`fr=0`）—— 门禁阈值含等号，24 不该进 |
| ★ | 不变式 | `st ∈ {0,1,4,5,6,7}`；`fr≠0 ⟺ st∈{6,7}`；`st=1` 时 `thr∈[1150,1650]`；**`st=6` 时 `thr` 恒定**；**`st=7` 时 `thr` 单调不增且 ≥1000**；上锁/停手恒 1000 |

### 停止条件（出现任一条立刻回滚）

1. ⭐⭐ **`st=6` 期间 `thr` 有跳变**（保持没生效 = 还是空中停车）；
2. `st=7` 期间 **`thr` 回升**、或掉到 **1000 以下**、或超出 [1000,1650]；
3. ⭐ **姿态超限没有立即停桨**（走了保持段 / `fr=2` 却出现 `st=6`）；
4. ⭐⭐ **停手被误伤**（停手时 `thr` 不是 1000，或进了 `st=6/7`）；
5. ⭐⭐ **没飞过却进了 `st=6/7`**（地面上重新解锁 + 读数坏着 ⇒ 会把油门在地面上顶到 1250µs）；
6. 正常悬停时**无故失效**（`fr=0` 却进了 `st=6/7`，或 `st=1` 却带 `fr≠0`）；
7. 普通模式出现任何差异。

### ⚠️ 三个**预期现象**（不是失败，先知道就不会误判）

1. **失效之后定高不会自己回来**：下降段是单向的，一次失效 = 一次飞行结束，落地重新选模式。
   （"读数掉了 3 秒又回来"这种更长的抖动救不回来 —— 这是刻意的取舍，理由见施工表待办 10。）
2. **失效期间 `mode` 仍是 1，遥控器上不会显示"已自动退出"**：因为切回普通模式的话，
   杆在中位就是 1500µs ≈ 接近满推力，飞机会往上窜。⇒ 飞行员接管的手段是**上锁**。
   原因码现在只能看串口（遥控端弹窗按你的要求缓做）。
3. **落地后桨还会转一会儿**（从落地时油门到 1000 要十几秒），**你上锁即止**。
   这是"慢降"必然的代价：无高度/垂速反馈时，**"落得软"与"落地就停桨"不可兼得**
   （这就是 §6.2 说的"控制不了下降速度"）。

### 台架能验 / 验不了

| 能验 | 验不了 |
|---|---|
| 状态机路径（保持 / 恢复 / 超时 / 单向） | 落地有多硬（要物理模型 + 真机；见 `sim_failsafe_ramp.js`） |
| 锁存值 = 失效前输出 | 斜坡斜率该取多少（20/30/50 的取舍是**算出来的**，不是台架能测的） |
| 斜坡斜率、单调性、地板 | 真实飞行中 ToF 失效的频率与持续时长 |
| 恢复的无缝性（`i` 不丢、`thr` 无跳变） | — |
| 姿态超限立即停桨 | — |
| ⭐ **守卫④**（地面上不许锁存） | — |

---

## H13 验收步骤（2026-09-15 实施 v0.20，待硬件验证）

⚠️ **全程拆桨**。观测量是 `[V]` 行里新加的 **`vzsp=`**（外环输出、内环的目标垂速）：

```
[V] raw=... | ... | stick=1000 h_sp=10.8 gt=0ms fs=0ms fr=0 | vzsp=+2.3 corr=+11.7 i=1264 thr=1276
                                                              ↑↑↑↑↑↑↑
                                                    外环（H13）—— 台架上只有它能看出外环有没有接上
```

### 烧录前必须先设的 4 个参数

| 参数 | 遥控位置 | 设成 | 为什么 |
|---|---|---|---|
| **`vz_kp`** | PID 页→「高度」→ **垂速环** Kp | ⭐ **5** | ⚠️ **不是 20**。回路延迟 83ms 下 `20` 会进极限环（见 H13 行的 ③） |
| **`h_kp`** | 同页 → **高度环** Kp | **0.3** | 代码默认已改成 0.3。⚠️ Flash 里可能存着旧的 0.6，`LOAD_SAVED` 会带回来 ⇒ **看显示值确认** |
| **`vz_ki`** | 垂速环 Ki | **5** | 悬停油门估计器的学习速率；它决定"起飞前憋多久" |
| **MAX THROTTLE** | 同页 → 第三行 | **2000** | 老坑：Flash 里存旧值会把 1500 带回来 |

### 验收表

| # | 操作 | 期望现象 |
|---|---|---|
| ① | 普通模式推杆 / 上锁 / **停手** | 与 H12 一致；⭐ **停手仍恒 1000 且 `vzsp=0`** |
| ② | ⭐⭐ 进 `st=1` 后**推杆** | `vzsp` **由 0 变正**，数值 ≈ `0.3 × (h_sp − h)`；推到 1000 约 2 秒后 `vzsp ≈ +2.3`（`h_sp≈10.8`、`h=3.0`） |
| ③ | ⭐⭐ **拉杆到底** | `vzsp` **变负**（⚠️ 台架上飞机不动 ⇒ `h` 不变 ⇒ 误差一直负）；注意**别把它推过 125cm**，否则会先触发高度失效（那是 H12 的正确行为） |
| ④ | ⭐⭐ **死区**：让 `h_sp ≈ 地面读数` | `vzsp = 0`；两侧各 2cm 内都是 0；出死区一点点（误差 2.5cm）应约 **+0.75** |
| ⑤ | ⭐ **把飞机整体抬高 20cm 再放下** | `h` 涨 ⇒ 误差变负 ⇒ **`vzsp` 立刻变负** ⇒ 随后 `i` 下降、`corr` 变负 ⇒ **这是第一次真的"闭环看高度"** ← 本环节最重要的一条 |
| ⑥ | ⭐ **推杆把 `h_sp` 抬到 15~30cm，然后** | ⭐⭐ **`i` 开始一路上涨**（从 1250 往 1400 爬）—— 这就是"憋油门"，**真机上约 5.7 秒后离地**。⚠️ 台架上飞机起不来，所以 `i` 会**一路顶到天花板 1650** 并停住，**这不是失败** |
| ⑦ | 遥控改 `h_kp` 0.3 → 0.6 | 同一个误差下 `vzsp` **翻倍**（证明参数是活的） |
| ⑧ | H12 回归 | 拔 ToF 线 ⇒ `st=6`、`thr` 恒定、**`vzsp` 冻结**（保持失效前的值，不跳也不清）；歪 30° ⇒ `fr=2` 立即 1000 |
| ⑨ | 黑匣子 | `vz_target_cms` 这一列**不再是常数 0** |
| ★ | 不变式 | `vzsp ∈ [−20, +20]`；`st∈{0,4,5}` ⇒ `vzsp = 0`；`st=1` 且误差在死区内 ⇒ `vzsp = 0`；`st=1` 时 `thr∈[1150,1650]`；停手/上锁恒 1000 |

### 停止条件（任一条立刻回滚）

1. ⭐⭐ **`vzsp` 符号反了**（推杆反而变负）—— 本环节唯一会真正导致失控的错误；
2. `vzsp` 恒 0（外环没接上）或死区内恒不为 0（死区没生效）；
3. 停手 / 上锁 / `st=6,7` 时 `vzsp ≠ 0`（失效期间必须冻结）；
4. **`i` 在"推杆但飞机没离地"时反而下降**（说明慢层的误差还在用 0 ⇒ 永远起飞不了）；
5. 普通模式出现任何差异；H12 的回归项失败。

### ⚠️ 三个**预期现象**（不是失败，先知道就不会误判）

1. **推杆后约 7 秒才离地**（1.3s 退停手 + 约 5.7s 憋油门）。这是"悬停油门必须自己学"的必然代价。
2. **台架上 `i` 会顶到天花板 1650 并停住** —— 因为飞机起不来、误差一直大，估计器就一直学。
3. **稳态精度只有 ±2cm**（P-only + 死区）。要更准得上 `h_ki`（ID 31，已预留），那是 H15 的活。

### 台架能验 / 验不了

| 能验 | 验不了 |
|---|---|
| 外环**符号**、死区、限幅 | **增益该取多少** —— 一维模型只能定量级（见 `sim_h13_takeoff.js`） |
| 参数在线变更 | 真实延迟/噪声/姿态耦合下的稳定性 |
| 与 H12 的交互（失效冻结） | 起飞的"手感"（憋油门那 5.7 秒你能不能接受） |
| ⭐ **"抬高飞机看 `vzsp` 反号"** —— 闭环的第一次真实检查 | — |
| 慢层误差来源改对了（`i` 在推杆时上涨） | — |

---

## H14 验收步骤（2026-09-15 实施 v0.22，待硬件验证）

> ⭐ **本环节改的是"停手怎么出来"**：从"必须推到上升段、让 `h_sp` 攒过 4cm（约 0.8 秒）"
> 改成"**推杆过 200 就解手**"。目的只有一个：**让杆在下降段/中间段推着时电机也能转**。
> ⚠️ 油门仍然**全程由控制器给**（本环节**不做**"手动起飞段"），所以**离地前的 8~13 秒照旧**。

⚠️ **全程拆桨**。观测量：`[V]` 行里的 `st` / `stick` / `thr`。

### 验收表

| # | 操作 | 期望 |
|---|---|---|
| ① | 落地 + 上锁 + 杆最低 | `st=4`、`thr=1000`、电机停 |
| ② | 解锁后**不动杆** | 仍 `st=4`、`thr=1000` |
| ③ | ⭐⭐ 杆**慢慢推过 200** | `st` 立刻变 **1**；`thr` 0.31 秒爬到 **≈1250**（`[V]` 上会看到 1003/1055/1192 这类**过渡值，不是越界**）；**电机转** |
| ④ | ⭐⭐ 杆停在 **250~350**（下降段） | `st=1`、`thr` 从 1250 **慢慢漂向 1150 然后停住**、**电机一直转** |
| ⑤ | ⭐⭐ 杆停在 **350~650**（中间段） | 同上 ⇒ **证明中间段不是"死区"** |
| ⑥ | ⭐⭐⭐ 杆停在中位 **1 分钟** | `st` **一直是 1**（**不许在 1 与 4 之间来回跳** —— 这是本次最容易写错的错）；`thr` 到 **1150 停住** |
| ⑦ | 杆推回 **≤100**，等 0.5 秒 | 回 `st=4`、`thr→1000`、电机停 |
| ⑧ | ⭐ 锁着时先把杆推到 1000、**再**解锁 | **不解手**（`st` 仍 4）；收回 ≤100 再推过 200 ⇒ 才解手 |
| ⑨ | ⭐ 举起 30cm 再放下（杆在中位 450） | **自动回 `st=4`**（落地自动进停手）—— 若把"杆 ≤100"错加进**进入条件**，这条会失败 |
| ⑩ | H12 回归 | `st=1` 时拔 ToF 线 ⇒ `st=6` 保持 2s（`thr` 恒定）→ `st=7` 慢降 |
| ★ | 不变式 | `st∈{0,1,4,5,6,7}`；`st=1` 时 `thr∈[1150,1650]`；停手/上锁恒 1000 |

### 停止条件（出现任一条立刻回滚）

1. 杆推过 200 后 `st` 仍是 4（**没解手**）；
2. ⭐⭐ **杆停在 200~650 时 `st` 在 4 与 1 之间来回跳**（起飞保护的清除条件没改干净 —— **本次最可能出的错**）；
3. **上锁状态下推杆能解手**（`armed` 判据漏了）；
4. **落地后收杆仍进不了停手**（说明"杆 ≤100"被错加进了进入条件）；
5. `st=1` 之后出现任何与改前不同的现象；H12 的回归项失败。

### ⚠️ 三个**预期现象**（不是失败，先知道就不会误判）

1. ⭐ **杆一推过 200，油门就从 1000 跳到 1250（0.31 秒）** —— "电机一转就是 27% 推力"这件事
   **不会消失**，它就是"解手后把油门交给控制器"的形态。本环节只是让它**提前**发生（不用再等 0.8 秒）。
2. **离地的 8~13 秒照旧**（目标抬得越低等得越久）。要缩短它得动别的（记住上次悬停油门 / 遥控设初值），
   那是 H18 的活。
3. **要停手就收杆到 ≤100 或上锁**。杆停在 200~650 时飞机会一直在地面上转着
   （推力 27% → 7.7%，**不会起飞**：目标高度被钳在 0、误差是负的）。
   ⚠️ 另一个边角：**低空（没超过 10cm）落地时，起飞保护还没被高度清掉** ⇒ 落地也进不了停手，
   同样要收杆或上锁。超过 10cm 的正常飞行落地则会**自动进停手**。

### 台架能验 / 验不了

| 能验 | 验不了 |
|---|---|
| 解手边沿、门槛（199/200/201） | 真实手感（"推一点就转"是不是你要的） |
| ⭐⭐ **滞回不抖**（杆停 1 分钟 `st` 恒为 1） | 起飞那 8~13 秒在真机上的表现 |
| 落地自动进停手、上锁边界 | 推力不足时"一直在地面转着"的处理（要靠人收杆） |
| 与 H12 的交互（失效照旧） | — |

---

## 台架仿真 / 静态检查（H6 起）

- **飞控端**：在 PC 上把 `vertical_control.c` 单独编起来，用一个**假的估计器**喂高度，跑 17 个场景，
把验收矩阵在**烧录之前**先跑一遍；再用 `arm-none-eabi-gcc -fsyntax-only` 配桩头文件做类型检查。不碰任何硬件。

⭐ **H8 之后新增一招：直接读 DSH 的串口审计日志来核对验收判据**（`_inbox_会话提取/提取脚本/`）：

| 脚本 | 作用 |
|---|---|
| ⭐ **`verify_v.js`** | **v0.18 起（H10）的格式**：解析 `[V]` 行（**含 `i=`**），自动判定 H10 的判据（慢层符号、有界、无 windup、失效闭嘴、限速过渡、回归），逐条给 PASS/FAIL + 实测数值。**新日志都用它**。⚠️ 只有符号、限幅、停手闭嘴这几条是"机器能判"的；**增益好不好只有人能判**。自测见「台架仿真」节（三组对照组） |
| `verify_h8.js` | **旧格式**（`[ALT]`）的判据核对。只对 2026-09-15 之前的日志有意义，**保留不动** |
| `parse_alt_log.js` / `dump_alt_seq.js` / `alt_h_stats.js` | 旧格式的按状态分组 / 时序明细 / `h` 分布统计，同上 |
| `gen_fake_v_log.js` | 生成合成的 `[V]` 日志（含**故意写反符号**的对照组），用来自测 `verify_v.js` 本身 |
| `chk_printf.js` | 扫 `.c` 里所有 `Debug_Printf`，核对「说明符个数 == 实参个数」+ 有/无符号强转是否匹配 |

日志位置：`C:\Users\fool\.dsh\serial-console\logs\COM9-<时间戳>.jsonl`。

⚠️ **判据写法上的坑，全都是真机/自测误报过才记下来的**（**同一条道理踩了四次**，值得单独记住）：

1. **判据 ① 不能拿"本拍杆量算出的映射值"直接比 `thr`** ——
   杆在扫动时限速器会滞后（上升 800、下降 **300**µs/s，打印周期 500ms ⇒ 最多滞后 150µs）。
   正确判据是"`thr` 必须落在【上一拍映射值, 本拍映射值】之间"。
   H8/H9 仿真、真机脚本都在这里误报过，不是固件问题。
2. ⭐ **符号判据必须排除 `corr = 0` 的样本** —— `0` 不带符号信息，
   把它算成"同号"会让"控制刚启用、误差还很小"这类正常样本变成**假失败**。
   `verify_v.js` 的自测（`gen_fake_v_log.js` 的正/反两组）就是靠这一条发现的：
   第一版把 `corr=0` 算成同号，**符号正确的那一组也被判了失败**。
3. ⭐ **判据 ④ 不能逐拍比较 `thr ∈ [1220,1280]`** ——
   刚退出停手时 `thr` 要**经速率限制器从 1000 爬到 1250**（上升 800µs/s ⇒ 约 0.31s ≈ 80 拍），
   中间必然出现 1003 / 1055 / 1192 这类值。H9 真机首跑就在这里误报 3 条。
   正确判据是**分段**：硬上限（任何 st=1 的样本都不许 > 1280）+
   每个连续 st=1 段**跳过开头 8 拍**（= 2s，远超 0.31s）后必须 ≥ 1220。
4. ⭐ **符号判据还要排除"`vz` 印成 `0.0`"的样本** —— 真实 `|vz| < 0.05` 时
   打印出来是 `+0.0`/`-0.0`（只有 1 位小数），此时 `corr*vz` 恒为 **0**，会被算成"同号"。
   而 `corr` 完全可能非 0（例：真值 vz=−0.005 → 印 `+0.0`，corr=+0.1）。
   H9 真机首跑在这里误报 **10** 条。
5. ⭐⭐ **"应该变化 X" 的判据必须先问"这段行程够不够"** —— H10 仿真里，
   把 `i` 从初值 1250 上抬 2 秒本应走 **−200µs**，但地板是 **1150**，只走得了 100µs 就撞住，
   实测显示 −100µs，**被我的判据判成"斜率不对"**。斜率其实完全正确。
   ⇒ 正确做法是**先把被测量充到有足够行程的位置再测**（先把 `i` 充到 1450 再测上抬），
   而且**顺手把"撞地板"本身也断言掉**（从 1250 上抬 2s 应恰好停在 1150）。
   ⚠️ 这是 `verify_v.js` 判据 ④ 那条"限速过渡值不是越界"的**同族错误**：
   **任何钳位都会让"应该走到 X"变成"只走到边界"。**

6. ⭐⭐ **判"积分的符号"不能拿两个端点的瞬时值去比** —— H10 真机首跑，
   慢层符号判据报了 **7 个"同号"**。逐个查完全不是符号错，而是**判据本身不成立**：
   `i` 在 500ms 内的变化取决于这段里的**平均** `vz`，而打印的 `vz` 只是**端点瞬时值**。
   两种情况下二者可以不同号：
     · **方向反转**（端点一个 +12.6、一个 −12.9）：平均值落在哪一侧无从得知；
     · **丢行/乱码**（那次 COM9 掉了 3 次、还有半行被截断）：两端之间不是 0.5s，区间长度对不上。
   ⇒ 判据加一条"**相邻两条打印的 `vz` 必须同号**"，同号立刻 **7 → 0**；
     而且 `|vz|` 门槛从 1 提到 8 都仍然是 0/13 ⇒ 符号确实是对的。
   ⚠️ 同时修正判据 ① 的带检：**端点必须用"上一拍实际 `thr`"而不是"上一拍映射值"**
     （杆从满位收到底时 `thr` 以 300µs/s 从 2000 衰减，到 1000 要 7 拍打印，
     中途必然高于本拍映射值 —— 这一条误报了 6+4 条）。
   ⚠️ 并且给 `gen_fake_v_log.js` **补了"收杆回落"段**：原来的合成日志太"干净"
     （直接给出 `1000+stick` 的精确值、不含限速滞后），所以自测**覆盖不到**这类判据错误 ——
     **合成数据必须包含真实系统里的滞后/钳位/丢行，否则自测是在自欺**。

⇒ **几次误报的共同点**：**判据把"打印分辨率 / 限速器 / 钳位 / 采样间隔带来的过渡值"当成了物理量本身。**
   凡是要拿打印值做**逐拍/逐符号/定量**比较的判据，先问四件事：
   **① 这个量有没有一阶滞后（限速器/滤波器）？② 这个量的打印精度够不够判我要判的那件事？
   ③ 这一路有没有钳位、行程够不够走到我期望的那个值？
   ④ 我要判的那个量（比如一个积分），是否真的由我拿来比较的那几个瞬时样本决定？**

  语法检查的可复用命令（包含路径取自 `ApexFly v2.0.uvprojx` 的 `<IncludePath>`）：

  ```powershell
  arm-none-eabi-gcc -fsyntax-only -std=gnu99 -Wall -Wextra -Wno-unused-parameter `
    -DUSE_HAL_DRIVER -DSTM32G474xx `
    -I<Modules/* 各目录> -I<Core/Inc> -I<Drivers/...> -I<synchk> `
    Modules/Control/vertical_control.c
  ```

  ⚠️ 一个必踩的坑：`Middlewares` 里只带 Keil(RVDS) 版 FreeRTOS port，`portmacro.h` 用
  ARMCC 的 `__asm { }`，GCC 解析不了 —— 需要一份 GCC 兼容的 `portmacro.h` 桩并放在包含路径最前面
  （H17a 那份在 `CoreFly F2 Remoto/.dsh-review-tmp/synchk/`，可直接复用）。
  ⚠️ **静态检查查不出重复定义**（`L6200E: Symbol ... multiply defined`）—— 新增任何**全局符号**
  之前，先在**全工程**范围内搜一遍同名符号（`Modules/` + `Core/` + `Drivers/` 全搜，不能只搜一个目录）。

- 仿真脚本：`_inbox_会话提取/提取脚本/sim_vertical_control.c`（跑法见文件头注释，宿主机 gcc，两行命令）；
- ⭐ **H6 的"起飞保护"就是它抓出来的**：不加保护时，"推力偏弱、飞机离不了地"会变成
  "推杆 → 被按回停手 → 再推杆"的死循环，飞机永远起飞不了（详见方案 §15.3 第三个坑）；
- 结论：**17 个场景全过**。这类纯状态机逻辑都应该先跑仿真再上硬件，成本几乎为零。

**H8 的仿真**（`_inbox_会话提取/提取脚本/sim_vc_h8.c`，15 个场景，**全过**）：
在 `motor_test.c` 那条分叉之外，还**逐行复刻**了 `MotorTest_MapStickToThrottleUs`、
`MotorTest_ThrottleRampLimit` 和 `if (!armed)` 分支，所以能直接断言油门值与**爬升/回落用了多少拍**。

- 编译：`gcc -std=c99 -Wall -Wextra -I sim_stub -I "ApexFly v2.0/Modules/Control" -I "ApexFly v2.0/Modules/Motor" sim_vc_h8.c "ApexFly v2.0/Modules/Control/vertical_control.c" -o sim_vc_h8.exe`
  （`sim_stub/main.h` 只是顶掉 HAL 聚合头，**绝不能**加进 Keil 包含路径）；
- 核心断言：**定高模式下 48 种"杆量×高度"组合遍历，油门峰值恒 = 1100、超限拍数 = 0**（单侧不变式）；
  普通模式 10 秒内峰值恒 = 1500；
- ⭐ **它抓出的不是代码 bug，是我自己写错的验收判据**（第一版 10 条失败，逐条查完全在脚本/期望值一侧）：
  ① 把"停手退出需要 `h_sp` 掉回 4cm 以下"记错了 —— 实际只需要 **500ms 去抖**（125 拍）；
  ② 把"限速器立即到位"记错了 —— 实际 1000→1100 要 **0.13s**、1100→1000 要 **0.33s**；
  ③ 把"推杆到底油门恒 1000"写绝对了 —— 实际**只有头 1.33s**，之后按设计升到 1100。
  ⇒ **这三条已经改回上面的验收表**。原来那版判据拿到真机上会让人误判成"H8 做错了"。
  ⭐ **教训**：仿真脚本的价值一半在验证代码，另一半在**逼你把验收判据写成可执行的形式**——
  写不成数字的判据，真机上一定判不清。

**H9 的仿真**（`_inbox_会话提取/提取脚本/sim_vc_h9.c`，9 组 / 15 个场景，**全过**）：
真实参与编译的只有 `vertical_control.c` 和**真的 `pid.c`**（PID 库不改，行为必须是真的），
估计器与参数表用桩顶掉。

- 编译：
  `gcc -std=c99 -Wall -Wextra -I sim_stub -I "ApexFly v2.0/Modules/Control" -I "ApexFly v2.0/Modules/Motor" -I "ApexFly v2.0/Modules/Communication" sim_vc_h9.c "ApexFly v2.0/Modules/Control/vertical_control.c" "ApexFly v2.0/Modules/Control/pid.c" -o sim_vc_h9.exe`
- ⭐ **核心断言是符号**：`vz = +50cm/s` ⇒ `corr = −30000/1000µs`（顶 −30）；
  `vz = −50` ⇒ `corr = +30`；`vz = +0.5` 且 Kp=20 ⇒ 恰好 `−10µs`
  （**这一条最重要**：证明是线性响应，不是"碰巧顶在限幅上所以方向看起来对"）。
- **不变式**：遍历 **240** 种"杆量×高度×垂速"组合，`thr` 全局范围恒为 **1000 ~ 1280**，真越界 **0** 拍。
- **动态限幅**：满杆油门改到 1350 ⇒ 向上余量算出来是 0 ⇒ `corr` 不能为正；
  改到 1200 ⇒ 向上仍为 0、向下仍是 −30（下限只由 1100 边界与硬限幅决定）。
- **已知缺口被正面确认**（不是 bug，是待办 5）：空中读数失效 ⇒ `corr = 0` ⇒ 约 0.93s 后 `thr = 1000`，
  即**空中停车**。这一条是**故意断言**的，用来提醒"**H12 之前不许飞**"。
- ⭐ **它抓出的 3 条失败全部是我自己判据写错**，产品代码一条没错：
  ① 两处**漏算了速率限制器的滞后**（"满杆改小后 `thr` 应该立刻 ≤ 基准"——实际下降只有 300µs/s，
     要走 25 拍；"失效后降到 1000"要走 **234 拍 = 0.93s**，我只跑了 0.48s）。
     ⚠️ **这和 H8 仿真踩的是同一个坑**（把限速滞后误判成逻辑错），值得记牢；
  ② 把限速器在 `1000 ↔ 1220` 之间的**过渡值**（实测是 **1218**）当成了"越界"。
     正确判据是"**硬界限** [1000,1280] 不许越" + "**稳定后**只许落在 `{1000} ∪ [1220,1280]`"。

**H10 的仿真**（`_inbox_会话提取/提取脚本/sim_vc_h10.c`，**49 项检查全过**）：
同样是"真实编译 `vertical_control.c` + 真 `pid.c`，估计器与参数表用桩顶掉"。

- 编译：
  `gcc -std=c99 -Wall -Wextra -I sim_stub -I "ApexFly v2.0/Modules/Control" -I "ApexFly v2.0/Modules/Motor" -I "ApexFly v2.0/Modules/Communication" sim_vc_h10.c "ApexFly v2.0/Modules/Control/vertical_control.c" "ApexFly v2.0/Modules/Control/pid.c" -o sim_vc_h10.exe`
- ⭐⭐ **核心断言是慢层的"两个方向 + 两个边界"**：
  `vz = −20cm/s` 持续 2s ⇒ `i` 上升约 **+200µs**；`vz = +20` 持续 2s（**先充到 1450**）⇒ 下降约 **−200µs**；
  从初值 1250 直接上抬 2s ⇒ **恰好停在地板 1150**。
- ⭐⭐ **无 windup 是显式断言的**：长时间下沉把 `i` 顶到天花板 1650 之后，
  **反向 0.1s 内 `i` 必须立刻开始下降**（而不是卡在天花板不动）。
- ⭐ **不变式遍历**：`6 种 vz × 4 种 ki × 2 种 kp = 48 组`，每组跑 6 秒，
  断言 `thr ∈ [1150,1650]`、`i ∈ [1150,1650]`、`|corr| ≤ 50`，
  以及 ⭐⭐ **`thr` 永不 ≤ 1100**（姿态环永不被旁路）。
- **失效闭嘴**：上锁 / 停手 ⇒ `i` 回 1250、`corr = 0`、`thr = 1000`；
  ⚠️ **姿态歪 30°** 在 H12 之后**不一样**：判定炸机 ⇒ 立即 `thr=1000`、`st=7`、`fr=2`，
  而 `i` 是**冻结保持**（不回初值）。判据已按 H12 更新过，见下面的说明。
- **参数在线变更**：改 `vz_kp` 会触发 `Pid_ApplyParams`（清快层），但 **`i` 不受影响**
  （那是刻意的：改增益不该丢掉已经学到的悬停油门）。
- **`dt` 异常**：`dt = 0.5s` 或 `0.1ms` ⇒ 慢层不积分（与 `pid.c` 同一套判据）。
- ⭐ **它抓出的 1 条失败仍然是我自己的判据写错**（产品代码 0 错）：
  把 `i` 从 1250 上抬 2 秒本应走 −200µs，但地板 1150 只允许走 100µs ⇒ 显示 −100µs，
  被我判成"斜率不对"。**已按"先充到 1450 再测"改写，并补上"撞地板"的断言**（见上面的坑位第 5 条）。

> ⚠️ **H12/H13 之后这个仿真做了两处改造，让它继续有效**（不改的话它就是废码）：
> ① **把外环关掉**（stub 的 `h_kp = 0`）：H13 把慢层的误差来源从 `0 − vz` 改成 `vz_sp − vz`，
>    而 `h_kp = 0` 时外环输出恒为 0 ⇒ 整条链路与 H13 之前**逐位等价**。
>    ⭐ 于是它从一个"过时脚本"变成**真正的回归测试**：
>    "**H13 的改动在 `h_kp = 0` 时没有改变任何行为**"。
> ② **一条判据按 H12 更新过**：原来期望"姿态歪 30° ⇒ `i` 回 1250"，
>    而 H12 起这是"判定炸机 ⇒ 立即停手（`st=7`、`fr=2`）且**两层冻结**" ⇒ 改成
>    "`i` **保持**、`thr` 立即 1000"。**这是 H12 的刻意改动，不是回退。**
> 现状：`sim_vc_h10` **49 项全过**、`sim_vc_h12` **67 项全过**、`sim_vc_h13` **34 项全过**。

**H12 的仿真**（`_inbox_会话提取/提取脚本/sim_vc_h12.c`，**67 项检查全过**）：
同样"真实编译 `vertical_control.c` + 真 `pid.c`，估计器与参数表用桩顶掉"。

- 编译：
  `gcc -std=c99 -Wall -Wextra -I sim_stub -I "ApexFly v2.0/Modules/Control" -I "ApexFly v2.0/Modules/Motor" -I "ApexFly v2.0/Modules/Communication" sim_vc_h12.c "ApexFly v2.0/Modules/Control/vertical_control.c" "ApexFly v2.0/Modules/Control/pid.c" -o sim_vc_h12.exe`
- ⭐⭐ **它证明的四件事**（都是"写错就会摔机"的）：
  ① **保持段 `thr` 恒定** —— 短暂失效时飞机真的什么都没发生；
  ② **恢复无缝** —— 失效前 `thr=1500`、保持 0.4s、恢复后 `thr=1500`（差 **0**）、`i` 不丢；
  ③ **斜坡 30.0µs/s、单调不增、最终恰好停在 1000**，且地板不漏；
  ④ **姿态超限完全不进 `st=6`**（直接 1000、`fs=0`）。
- ⭐⭐ **两条"写代码时自己踩的坑"各有专门的断言守着**，防止以后被人改回去：
  - 「**高度越界不在门禁②里**」⇒ "h>125cm 而其它一切正常"那一拍 `IsActive()` 恰好为 true。
    第一版在"门禁全通就 return"处直接返回，**高度失效整条判据是死代码**。
    断言：那一拍 `ct=0xF` 且仍然进了 `st=6 fr=3`。
  - 「**地面上重新解锁 + ToF 坏着**」⇒ 停手要求 `est_valid`，读数坏着就永远进不去停手，
    于是"锁存悬停油门"会把油门在**地面上**顶到 ~1250µs。
    断言：这条路径下 `thr=1000`，且**不许**出现 `st=6/7`（守卫④）。
- ⭐ **不变式遍历**：`4 种杆量 × 3 种倾角 × 3 种高度 × 2 种读数 × 2 种解锁 = 144 组`，每组 400 拍，
  断言 `st ∈ {0,1,4,5,6,7}`、`fr≠0 ⟺ st∈{6,7}`、`st=1` 时 `thr∈[1150,1650]`、
  **`st=6` 时 `thr` 恒定**、**`st=7` 时 `thr` 单调不增**、上锁/停手恒 1000。
- ⭐ **它抓出的 2 条失败仍然是我自己的判据写错**（产品代码 0 错）：
  ① **"油门不上升"套到了所有状态上** —— 而 `st=1` 时慢层正在积分，油门**本来就该会上升**
     （仿真一直喂 `vz=−20` ⇒ `i` 一直在涨 ⇒ `thr` 一直在涨）。⇒ 单调性判据只对 `st=7` 成立；
  ② **"保持段 2 秒内 `thr` 恒定"和"`fs` 涨满"写在一个 520 拍的循环里** ——
     跑到一半就转成了下降段，恒定判据必然失败。⇒ 拆成 490 拍（验恒定）+ 20 拍（验计时）。
     顺带记下：**进入保持的那一拍不累加计时**，所以"2 秒"要 **501** 拍才满（差 4ms 无影响，但判据写 500 会误报）。
- ⚠️ 还有一个**独立的物理仿真** `sim_failsafe_ramp.js`（纯物理、不碰飞控代码）：
  一维模型算"从 1m 掉下来落地有多快"，用来定斜坡斜率。结论：
  **立刻停车 4.43m/s → 30µs/s 的 1.86m/s（冲击能量降到 1/6）**，且落地速度与保持段长短无关。

**H13 的仿真**（`_inbox_会话提取/提取脚本/sim_vc_h13.c`，**34 项检查全过**）：
同样"真实编译 `vertical_control.c` + 真 `pid.c`，估计器与参数表用桩顶掉"。

- 编译：
  `gcc -std=c99 -Wall -Wextra -I sim_stub -I "ApexFly v2.0/Modules/Control" -I "ApexFly v2.0/Modules/Motor" -I "ApexFly v2.0/Modules/Communication" sim_vc_h13.c "ApexFly v2.0/Modules/Control/vertical_control.c" "ApexFly v2.0/Modules/Control/pid.c" -o sim_vc_h13.exe`
- ⭐⭐ **核心断言是"符号 + 死区 + 起飞助力"三条**：
  `h_sp > h_est` ⇒ `vzsp` 为正且 ≈ `h_kp ×` 误差；`h_sp < h_est` ⇒ 为负；
  `|误差| ≤ 2cm` ⇒ **恰好 0**（连边界 2.0cm 也是 0）；出死区 2.5cm ⇒ +0.75；
  `|误差| ≥ 67cm` ⇒ 顶 ±20。
- ⭐⭐ **"起飞助力"是显式断言的**：推杆使 `h_sp` 抬高后，`i` 在 2 秒内上涨约 20µs
  （定量：`Δi = 帧数 × vz_ki × vzsp × dt`）。这一条直接对应"定高模式能不能起飞"。
- **H10 回归**：`vzsp ≈ 0` 时匀速上抬 ⇒ `i` 下降 −80µs、匀速下沉 ⇒ +80µs（斜率都对）。
- **复位与失效**：`Reset()` ⇒ `vzsp` 归 0 且 `h_sp` 对齐到 `h_est`；失效期间 `vzsp`
  **冻结**（保持失效前的值，不跳也不清）；恢复后立刻重新出力；上锁 ⇒ 清 0。
- **不变式遍历**：`7 种高度误差 × 2 种解锁 × 2 种读数可信 = 28 组`，
  断言 `st∈{0,1,4,5,6,7}`、`vzsp∈[−20,+20]`、死区内恰好 0、出死区符号一致、
  非 `st=1/6/7` 时 `vzsp` 恒 0、`thr∈[1000,1650]`。
- ⭐ **它抓出的 2 条失败仍然是我自己的判据写错**（产品代码 0 错）：
  ① 用 **−200cm 误差**测负限幅 —— 而 `h_est=210cm` 会**先触发高度越界失效**（st=6 外环冻结），
     量到的是冻结值。**那是产品代码的正确行为**，是判据选错了测试点；
  ② `i` 预期降 200µs 却只降了 114 —— 因为**撞到了地板 1150**。
     ⇒ 与 H10/H12 是同一个坑的第三、四次复发：**判据必须先问"这段行程够不够"**。

**H13 的物理仿真**（`_inbox_会话提取/提取脚本/sim_h13_takeoff.js`，纯物理、不碰飞控代码）：
一维模型（与 `sim_failsafe_ramp.js` 同一套推力模型）算"接上外环之后怎么起飞"。

- ⭐ **起飞时间线**（推杆到底、h_kp=0.3、vz_ki=5）：**1.35s 退出停手 → 约 7.0s 离地**
  （中间约 5.7 秒在"憋油门"，`i` 从 1250 爬到约 1410）；离地时 `h_sp` 已到 21cm。
- ⭐ **爬升很温和**：最大 **8.4 cm/s**、**过冲 0**、末段垂速 <3cm/s。
  原因不显然但很重要：**推力只要 ≈ 悬停就能维持匀速爬升**（纯积分对象），
  所以内环的 P 项只需要很小修正，±50µs 限幅基本碰不到。
- ⭐ **跟随"持续上升的目标"稳定滞后 5cm**（= 3cm/s ÷ 0.6），与方案 §3.3 的预测**完全一致**
  —— 说明模型可信。
- ⭐⭐⭐ **延迟扫描（本环节最重要的产出）**：ToF 一步 20ms、4 步一个测量周期 ⇒ 回路延迟约 80ms。
  扫下来：延迟 0 稳、40ms 轻振荡、**80ms 起明显振荡（末段垂速 ±27cm/s）**、120ms 稳态误差 15cm。
  再扫 `vz_kp`：延迟 80ms 下只有 `vz_kp=2` 稳，`≥5` 全部振荡。
  ⇒ **结论：设计值 `vz_kp=20 / h_kp=0.6` 在真实延迟下不能用**，首飞必须降到 **5 / 0.3**。
  同时它说明 **H9 的"台架验过了"只验了符号** —— 拆桨时没有真实推力回路，
  "增益该取多少"从头到尾没被验证过。真正的解法是 **H16（加计融合换掉 `vz` 的来源）**。
- ⚠️ 该仿真自己踩过两个**符号/单位**错（与飞控里最容易犯的错同族）：
  ① 把"向下为正"的加速度加到"向上为正"的 `vz` 上 ⇒ 飞机加速飞到 **675 米**；
  ② `vz` 用米、`h_sp` 用厘米 ⇒ 地面读数算成 `3+12.8`，飞机在 12.8m 而控制器以为在 15.8cm。
  ⇒ 已全程统一成 cm / cm·s⁻¹，并只用一种符号约定。

**验收脚本 `verify_v.js` 的自测**（`gen_fake_v_log.js` 生成**九份**合成日志）：

| 组 | 造的数据 | 期望 | 实测 |
|---|---|---|---|
| A | 全部正确 | 全过 | ✅ **21 通过 / 0 失败 / 1 未测** |
| B | **快层**符号写反 | 只有 ⑤⑥ 失败 | ✅ **20 / 1** |
| C | **慢层**符号写反 | 只有「慢层符号」失败 | ✅ **20 / 1** |
| D | `st=6` 期间 `thr` 在漂 | 只有 H12-① 失败 | ✅ **20 / 1** |
| E | `st=7` 期间 `thr` 回升 | 只有 H12-② 失败 | ✅ **20 / 1** |
| F | 姿态超限先进了 `st=6` | H12-① 与 H12-③ 失败 | ✅ **19 / 2** |
| G | **外环符号写反** | H13-① 失败 | ✅ **19 / 2** |
| H | **死区内 `vzsp` 不为 0** | H13-② 失败 | ✅ **19 / 1**（另有 1 项未测，因为对照组让样本分布变了） |
| I | **`vzsp>2` 时 `i` 反而下降** | H13-④ 失败 | ✅ **19 / 2** |

⭐ **B~I 八组是专门的对照组**：只有"正确的组也能过"是不够的 ——
还必须证明脚本**真的有本事抓到写错的那种**，否则它只是个永远说 OK 的摆设。
⚠️ 自测先后抓出我自己的**六个**错，都已修：
① 生成器把显式指定的 `thr` 覆盖掉了；② ⑦ 里 `i` 的逐拍变化跨了"静止段→移动段"；
③ **生成器没给 `corr` 加 ±50 钳位** ⇒ "正确组"自己把字段自检与判据 ④ 判失败；
④ H12 的两条新判据一开始也被我写错；
⑤ ⭐ **H13 起 `corr` 必须由 `(vz − vzsp)` 推出**，生成器还在用 `vz`（旧时代写法）；
⑥ ⭐ **"静止"必须排除"被命令动"**：`vzsp≠0` 时飞机虽然暂时 `|vz|<0.5`（还在地面），
   内环却在为命令速度出满力（`corr` 顶 ±50）—— 把它算进"静止"会误判成"Kp 偏大"。
⇒ 一句话：**合成数据必须满足固件当前的**不变式与**控制律**，否则自测是在自欺。**

**遥控端**（H17a 起）：遥控工程里带了**完整的 LVGL 与 CMSIS**，所以能直接用 `arm-none-eabi-gcc` 拿**真实头文件**
做语法检查，不必等 Keil：

```powershell
# 包含路径取自 CoreFly F2 Remoto.uvprojx 的 <IncludePath>；synchk 是本仓库里那版 GCC 兼容的 portmacro.h 桩
arm-none-eabi-gcc -fsyntax-only -std=gnu99 -Wall -Wextra -Wno-unused-parameter `
  -DUSE_HAL_DRIVER -DSTM32F407xx -DLV_LVGL_H_INCLUDE_SIMPLE -DLV_CONF_INCLUDE_SIMPLE `
  -I<synchk> -I<../Core/Inc> ...（其余见 uvprojx）... Algorithms/ui.c
```

⚠️ 唯一的坑：`Middlewares` 里只带了 **Keil(RVDS) 版 FreeRTOS port**，它的 `portmacro.h` 用 ARMCC 的
`__asm { }` 内联汇编，GCC 解析不了。所以本仓库里放了一份 **GCC 兼容的 `portmacro.h` 桩**
（`CoreFly F2 Remoto/.dsh-review-tmp/synchk/portmacro.h`，已 gitignore，**不参与 Keil 构建**），
把它放在包含路径**最前面**即可。H17a 就是靠这个在 PC 上查出了 `ui.c` 里一处漏改的 `.mode` 结构初始化。

---

## 与现有文档的关系

- 本文是 `高度接入飞控方案.md` 第 8 节那 8 个"阶段"的**细化版**（阶段 → 20 个可独立验证的环节）；
- 每个环节真正开工前，按你的规矩**单独出五要素方案**、批准后再改代码；
- **2026-09-11 改版**：定高从"一个开关"变成**独立模式**（四段式油门杆 + 地面切换），受影响的 H6/H7/H8/H12/H13/H14/H16/H17 已同步；详见方案文档 §5、§6、§15。
- **2026-09-12 改版**：① 油门杆由**四段改为三段**（取消"待命段"，满杆下拉 = 2cm/s 缓降）；② 新增 **「停手（地面待机）」状态机**（方案 §5.4）并**并入 H6**；③ **三段映射 + `h_sp` 积分器从 H13 前移到 H6**，H13 收缩为"外环 P"；④ `h_sp` 钳位下限 **2 → 0**；⑤ 明确**落地不自动上锁**。受影响的 H6/H7/H8/H13/H14/H18 已同步；另有死锁教训留档在方案 §15.3。
- **2026-09-12 H6 实施**：`vertical_control.c/.h` 落地（v0.12）。⚠️ 实现时用台架仿真补出停手进入条件的**两条附加判据**（"没在命令爬升" + "起飞保护"），并**改写了 H17 的形态**（LCD 页面选模式 → 确认发送）。原因见方案 §15.3 第三个坑，别当成可选优化删掉。
- **2026-09-14 台架验证 + 门槛修正（v0.13）**：H6 首次实测——门禁 / 模式切换 / 三段映射 / `h_sp` 积分 / 遥测回显**全部正确**；但**停手一次都没进去**，因为飞机被垫高、地面读数约 4cm 而门槛是 2cm。修法两条：门槛改 **6cm（测试值）**；停手进入时 `h_sp` 从"对齐到 `h_est`"改成**归零**（否则"进入即退出"2Hz 抖）。详见方案 §15.3 第四个坑与上面待办第 3 条。
- **2026-09-14 H6 收尾 + H17a（本次）**：① **H7 并入 H8**（无代码可做、无现象可验）；② **H4' 探针删除**与**举到 1.3m 验证**也都并入 H8；③ 新增 **H17a「遥控端：模式通道打通」并提前到 H8 之前**（纯遥控端改动，飞控一行不动），原 H17 改名 **H17b**；④ H8 的"遥控端常量改成 0"**取消**（H17a 之后遥控端默认就是普通模式）；⑤ H8 的风险由**中高改判为低**（定高模式下油门只会更低、不会更高）；⑥ **遥控端仓库首次纳入版本控制**（`git init` + 基线 `9619cdf`）。
- **2026-09-15 H8 实施（v0.14）**：**定高模式接管基础油门**。① 新增 `VerticalControl_GetThrottleUs()`（停手/门禁②没过 → **1000**，控制启用 → **1100** 占位）；② `motor_test.c` 的油门来源按**实际生效的模式**分叉，普通模式那一行**一个字节没动**；③ 速率限制器**保留不旁路**（1000↔1100 因此是软启动/软收油）；④ **删除 H4' 探针**（`motor_test.c/.h` + `tof.c` 的 `loop=`）；⑤ `[ALT]` 加 `thr=%u`（本环节核心观测量，从遥测快照读，两种模式都看得到）；⑥ ⭐ **更正文档旧错**：停手油门由 `MOTOR_PWM_IDLE_US`（1100，桨还在转）改为 **`MOTOR_PWM_MIN_US`（1000，电机停转）** —— 影响方案 §5.4 / §6.1 / §5.2 / §7 首飞流程 / 决策 9 / §15.3 及本文 H14 共 8 处。
  ⚠️ **一个必须记住的后果**：1100 落在姿态环旁路边界（判据含等号）内，所以 **H8 阶段定高模式下没有姿态修正**，H9 才会恢复。这不是 bug。
  ⚠️ 本次**没有**做"举到 1.3m 验证"的实测（并入本环节的验收步骤 ⑧，等硬件验证时一起做）。
  ⭐ **台架仿真 `sim_vc_h8.c` 15 个场景全过**，并**纠正了三处我自己写错的验收判据**（见"台架仿真"节）。
  ⚠️⚠️ **留下一处安全缺口**：空中门禁失效时油门压到 1000 = 空中停车，**H11/H12 之前不许飞定高**（待办 5）。
  ✅ **已由 H12（v0.19）结案**，见施工表待办 5 与「H12 验收步骤」。
- **2026-09-15 H8 台架验证通过（v0.14）**：用户实测，**9/9 判据通过**（详见"H8 实测结果"）。
  核心确认：**定高模式下 257 个样本 thr 只出现 {1000, 1009, 1100}，超限 0 个**；
  **控制启用时 21 种杆量（200~1000）全部 thr=1100 ⇒ 油门确实不跟杆走了**；
  普通模式杆 690 仍是 **1345µs**（与改动前同值）。
  ⚠️ **并入本环节的「举到 1.3m」仍未做**（飞机全程在地面上）。
  ⚠️ **待办 3 的数字被推翻**：同一台架地面实测 **2.8cm（中位）**，不是旧记录的 1cm/4cm ——
  门槛**必须按撤垫块后的重新实测值 + 1~2cm 定，不许照抄 2.0**。
  📌 新增观察（给 H9）：台架不离地时推杆会把 `h_sp` 积到 **23.8cm**，接上外环后要评估要不要在地面上钳它。
- **2026-09-15 ⑧「举高」补充实测**：举到 **128.1cm**（32 个离地样本）——
  **`sw` 从 0xF 掉成 0x7（掉了 `HEIGHT_OK`），`st` 仍 4、`thr` 仍 1000、`thr` 超 1100 的样本 0 个**。
  ⭐ **判据本身被这次实测纠正**：`HEIGHT_OK`（120cm **软上限**）与 `EST_VALID`（约 1.3m **硬件量程**）
  是**两个不同的触发点**，原判据写成一条是错的 ⇒ 已拆成 **⑧a / ⑧b**。
  ⚠️ 举高时 **USB 线被扯掉，端口掉了 3 次、丢约 143 秒数据**，所以没能举过 1.3m（⑧b 待做，见待办 6）。
  ⚠️ 掉线前后出现 3 次 `[BB] unknown cmd`：大概率是**拔插瞬间 RX 线噪声**（另一个可能是手打命令被
  5ms 轮询吃字节）。收到垃圾字节后主循环照常跑 —— 但**没有**验证待办 4 那条 ORE 恢复路径。
- **2026-09-15 H9 实施（v0.15）**：**垂速内环 P 接上，修正量第一次真的加到油门上**。
  ① 新增内环 `Pid_t`（不是 `CascadePid_t`——H9 只有内环，用后者会让人误以为外环已在跑）；
  ② ⭐⭐ **基准油门 1100 → 1250**（`VERTICAL_BASE_PWM_US`）：这是本环节最关键的一个决策。
     不抬上去的话，修正量只有 `[0,+30]` 单侧、**"该减油门时减"这条判据物理上验不了**，
     而且输出会因噪声在 1100 边界上来回穿，姿态环被反复 `AttitudeControl_Reset()` 等于废掉。
     取 1250 是因为 `mixer.h:20` 的台架倾斜测试基准就是这个值，不是新编的数；
  ③ **动态限幅**：上 = `min(满杆油门 − 基准 − 姿态保留 100, +30)`、下 = `max(1100 − 基准, −30)`；
     ⭐ 顺手更正方案 §3.4 的旧错——那里写"最高油门 **1600**"，而代码是
     `PidTable_GetMaxThrottleUs()` 默认 **1500** 且**遥控可改**（写死 1600 等于没有限幅）；
  ④ **新增 `PidTable_GetAltitudeParams()`**（协议 ID 25~27 原来只是读写载体、没有访问接口）；
     参数**缓存比对、变了才 `Pid_ApplyParams`** —— 否则 H10 打开 Ki 后积分会被每拍按回 0；
  ⑤ 停手 / 门禁②没过 → 复位内环并输出 0，与 `GetThrottleUs()` **共用 `VerticalControl_IsActive()`**
     （两处各写一遍迟早会不一致，那会出现"修正量在算、油门却给 1000"）；
  ⑥ `[ALT]` 加 `vzsp=` / `vz=` / `corr=`；`motor_test.c` **只改注释，逻辑一行不动**；
  ⑦ **anti-windup 明确推迟到 H10**（Ki=0 时 `pid.c` 里积分项根本不算，没有作用对象）；
  ⑧ 台架仿真 `sim_vc_h9.c` 9 组全过，**抓出的 3 条失败全是判据写错、产品代码无问题**（见仿真节）。
  ⚠️ **代价与后果**：H8 的"定高下油门只会更低"到此结束，判据改 **`thr ≤ 1280`**；
     姿态环在定高模式下**恢复参与**（H8 时 1100 命中旁路分支）。
     **停手仍恒 1000**，地面安全性不变。
  ⚠️ **本次没有动代码的地方**：遥控端（H9 用到的 4 个参数 `ui.c` 里已有编辑控件，**一行都不用改**）、
     `mixer.*`、`attitude_control.*`、`pid.*`、`apex_protocol.h`、黑匣子格式、`.uvprojx`。
  ⚠️ **新登记两条待办**：7 = 悬停油门未知（默认参数下控制器最多命令到 1280µs < 估计悬停 1550µs，
     **H14 前必须飞出来并抬 `max_throttle_us`**）；8 = H13 外环 `h_kp` **没有协议 ID**（要决定加 ID 还是写常量）。

- **2026-09-15 打印精简（v0.16，与 v0.15 一起烧一次）**：用户提出例行打印太长、多数字段不看。
  把 500ms 的 **`[TOF]` + `[ALT]` 两行（约 239 字符）合并为一行 `[V]`（约 123 字符）**，
  只留会看的 14 个字段。**控制逻辑一行不动，纯粹是打印。**
  - ⭐ **合并的最大理由不是省字符，是消重**：原来 `h` / `vz` / `v` 三个字段是
    **同一时刻同一来源打了两遍**（两行都读估计器，取出时刻差一拍，数值还不一样，
    反而容易让人怀疑是 bug）。合并后估计器那一段只出现一次。
  - 其余删除项：`filt`/`alt`（一个 `raw` 就够）、`n`/`sc`（被 `fresh`+`age` 覆盖）、
    `gnd`（**与 `st=4` 恒等**）、`rate`（由 `stick` 唯一决定）、`vzsp`（H9 阶段恒 0，H13 加回）。
  - ⭐ **用户主动砍掉的是 ToF 健康度（`status`/`fresh`/`age`/`err`）**：平时最清爽，
    但有代价 —— **这几项黑匣子不记，删了就没有第二个出口**，将来排查
    "`v` 掉到 0 是超量程还是 ToF 挂了"时必须加回来或从 git 历史取旧版。
    已在 `tof.c` 的注释里逐条写明删了什么、为什么，免得后人当成手滑删错。
    当时给的三个档位（全套 18 项 / **中间 14 项** / 极简 10 项）与取舍理由也记在对话里。
  - 顺带把打印改为**全部读 `vertical_control` 的快照**，不再单独调 `VerticalEst_GetState()`：
    一份样本、少一次结构拷贝、少一条跨模块依赖（`tof.c` 不再 include `vertical_est.h`）。
    同时修掉一个潜在 bug：旧脚本 `measure_vz_noise.js` 靠"`[TOF]` 与 `[ALT]` 交替出现、按下标配对"
    来关联两个源，**合并成一行后这个脆弱假设消失了**。
  - ⚠️ **代价：解析脚本要换**。例行的 `[TOF]`/`[ALT]` 两行不再存在，新增 `verify_v.js` 认新格式；
    旧脚本全部保留（它们对已有日志仍然正确）。本文与方案里 2026-09-15 之前的记录沿用旧标签，
    **不改写**——那是当时真实的打印。（`[TOF]` 标签本身还在，ToF 的一次性事件消息仍用它。）
  - 自查：`chk_printf.js` 核对 14 个说明符 vs 14 个实参 ✅；`arm-none-eabi-gcc -Wformat=2` 全绿；
    **人工逐字段核对过顺序**（varargs 顺序错了编译器查不出来）。
  - ⭐ 新脚本 `verify_v.js` 用 `gen_fake_v_log.js` 做过**正/反两组自测**：
    符号正确的组 10/0/0 通过、故意写反的组 ⑤⑥ 如实报失败。
    **自测当场抓出脚本自己的一个错**：`corr = 0` 的样本被算成"同号"，
    导致**符号正确的那一组也被判失败**。零值不带符号信息，必须排除 —— 已修正并记进上面的坑位清单。

- **2026-09-15 H9 真机验证通过（v0.16，无代码改动）**：用户实测，`verify_v.js` 判定 **10/0/0**。
  - ⭐ **核心结论：符号正确**。强信号（|vz|≥3cm/s）**85 个样本全部反号**，弱信号 231 个也全部反号；
    **等效 Kp ≈ 19.9**，与遥控里设的 `vz_kp = 20` 吻合 ⇒ 参数链路与量纲都对。
  - `thr` 硬上限 1280 越界 **0**、停手/上锁时 `corr` 非 0 的 **0**、普通模式回归精确。
  - 顺带补验 H8 的 ⑨：举到 120cm 以上时 `sw` 从 `0xE` 变 `0x6`（`HEIGHT_OK` 掉了），10 个样本。
  - ⭐ **用户提的四个"为什么"全部是设计行为**，已记进"H9 实测结果"一节。核心一句：
    **停手只用"估计高度"判断，而"估计高度"= 镜头到下方物体的距离。定高不知道飞机是不是在飞。**
    所以：手举着（26cm）⇒ 系统认为在空中 ⇒ 杆到底也不停手、解锁就转、给基准 1250；
    放回台架（3.4cm）⇒ 停手 ⇒ 停机（**此时仍是解锁状态**）。
  - ⚠️ **新登记两条观察**：① 解锁时**不做**"必须在地面"的检查（举着解锁会直接爬到 1250，
    装桨后必须先放地面确认停手再解锁；要不要加门禁属 H12）；② 高度超 120cm 时门禁①掉了
    但**控制器没有退出**（实测 h=125cm 时 `st` 仍 1、`thr` 仍 1250±30）——**这是 H12 的活**。
  - ⚠️ `verify_v.js` 的判据 ④ 与 ⑤⑥ 在真机首跑各误报 3 条 / 10 条，**都是判据写错、
    产品代码无问题**（限速过渡值、`vz` 印成 `0.0`）。已修正，并把"这条道理踩了四次"整理进坑位清单。
  - 📌 未解：16:45–16:54 那段"串口一个字节都不出"的确切原因没有定论
    （当时 COM9 被换成了 COM5、且用户搬动过 USB/接线；17:13 恢复后再没复现）。
    排查结论记在对话里：代码侧查完（`gState` 超时会复位、ORE 不阻塞 TXE/TC、所有 TX 走同一把互斥锁）
    **找不到能让 TX 静默的机制** ⇒ 指向物理链路。

- **2026-09-15 参数通道扩展 + 遥控端字库补齐（v0.17）**：解决待办 8，并为 H10 备好调参工具。

  **① 新增高度环（外环）三个协议 ID** —— 编号 **30/31/32**，`APEX_PID_PARAMETER_COUNT` 30 → **33**，
  **旧编号一个都没动**（工程既有约定）。命名刻意把两个环分开：
  `VERTICAL_SPEED_*` = **垂速环（内环）**；`HEIGHT_*` = **高度环（外环）**。
  UI 上就是 PID 页「高度」标签页里的两行：`垂速环` / `高度环`。
  - 量程 KP 0~5、KI 0~2、KD 0~5（外环量级比内环小得多）；步进 0.1；默认 **KP = 0.6**（方案 §3.3）、KI = KD = 0。
  - ⚠️ **控制代码在 H13 之前不会读这三个值**，所以现在改它们不影响飞行。

  **② ⚠️⚠️ 单帧负载上限 128 → 140（本次最容易漏掉的连带改动）**
  33 个参数的 PID 回包 = `4 + 33×4 = **136**` 字节 > 原上限 128 ⇒ 会命中 `apex_protocol.h` 里那句编译期 `#error`。
  140 = 136 + 4 余量，远低于 LoRa 模块能力上限（`ra01sc.h` 的 255）。
  **代价与判断**：PID 回包帧 133 → 145 字节、空口时间约 +9%，
  但它是**请求触发的一次性报文**（进 PID 页 GET / SET / SAVE），**不是周期流量**
  ⇒ 遥测帧与控制帧不受影响，飞行中的链路余量不变。
  ⚠️ **协议版本号 `APEX_PROTOCOL_VERSION` 故意没有抬**（仍 0x07）：控制帧与遥测帧格式未变，
  所以"只烧了一端"时**飞机照样能正常飞**，只是 PID 页读不到参数（长度检查会挡下）。
  这比"整条链路 BAD_VERSION 直接死掉"更好。

  **③ 黑匣子**：两处，性质完全不同，别混 ——
  - **Flash 参数表存档**：记录带 `parameter_count` 校验，30 → 33 会让**旧记录被判无效**
    ⇒ `BLACKBOX_PARAMETER_SCHEMA` 2 → **3**，并在 `Blackbox_ReadSlot` 里**照抄一段 30 项的迁移分支**
    （代码里本来就有 26 → 30 的同一套做法）；槽位 A/B 是两个独立扇区，记录长 12 字节不会打架。
  - **场次头的高度参数记录**：新增 `height_q10000[3]`，**刻意放在 `utc_seconds` 之后**、
    占用原来 `reserved0` 的前 12 字节 ⇒ `altitude_q10000` 与 `utc_seconds` 的偏移**完全没变**、
    CRC 覆盖范围也没变 ⇒ **旧记录用新结构读出来照样正确**，因此**不需要**动 `BLACKBOX_RECORD_SCHEMA`。
    `# altitude ...` 那行相应加了 `h_kp/h_ki/h_kd` 三个字段。
    ⚠️ **上位机 BlackboxReader 是否按名字解析这一行还没核实**（按名字则天然兼容，按位置则要跟着改）。

  **④ 遥控端 UI**：PID 页「高度」标签页改成**三行**（`垂速环` / `高度环` / `MAX THROTTLE`）。
  用户选的布局方案 **A（一页三行）**：参数面板高度 `84 → 112`，**只对高度页加高**
  （底边 81+112 = 193，底部四个操作按钮固定在 y=196 ⇒ 还剩 3px），另外 4 个页面一个像素没动。
  - ⚠️ 布局冲突是这次查出来的：面板原本只有两行，而**满杆油门就占着外环 KI 要用的 (142,51)**，
    所以满杆油门整体下移到 (142,83)。
  - ⚠️ `edit_id_t` 的数值必须与 `APEX_PID_*` **同序连续**（`edit_pid_index()` 靠 `id - EDIT_PID_ROLL_OUTER_KP`），
    所以新项**只能追加在末尾**。

  **⑤ ⭐ 遥控端字库补齐（"普通模式"的"普"显示成方框）**
  根因：字库是 `tools/generate_apexfly_ui_fonts.py` **按 ui.c 的字符串清单生成的静态子集**，
  产物生成于 **08-28**，而「普通模式」等文案是 **09-14（H17a）** 才加的 ⇒ 新汉字没有字形。
  实测缺的**不是 1 个而是 17 个**（普/么/什/底/现/帧/干/若/其/效/生/切/换/签/被/拒/退），
  分布在 9 条文案上（`普通模式`、`飞机现在到底是什么模式`、`连续若干帧`、`其实已经成功`、
  `未生效`、`上锁且油门最低时可切换`、`标签高度`、`被拒`、`请求被拒/已自动退出`）。
  - 重新生成前先做了**管线可复现性验证**：用同一套参数（Bahnschrift Bold Condensed +2 /
    **DengXian Bold**(`Dengb.ttf`) +1 / 直立 / 2bpp）生成，与现有产物的 **425 个旧字形逐字节完全一致**
    （位图 + 6 个度量字段），只新增 17 个 ⇒ 不会整屏视觉回归。
    ⚠️ 顺带确认：用 `Deng.ttf`（Regular）会有 **329 个字形不一致** —— 这是"用错字体"的判据。
  - 重新生成后的验证：**缺字 0**、**旧字形逐字节零改动**、位图合计 **42205 → 43988 字节（+1.7 KB）**。
  - 消失 1 个字形 `稳`(U+7A33)：查过，当前**没有任何字符串在用**（来自 08-28 之后被改掉的文案），安全。
  - ⚠️ 已把"**改了 ui.c 的中文就必须重跑字库脚本**"写进 `tools/generate_apexfly_ui_fonts.py` 的文件头，
    并记下两个坑：中文字体必须用 `Dengb.ttf`；**`ui_font_16` 按设计不含中文**（中文放上去会整条变方框）。
  - 顺带：`ui_font_10` 生成了但 ui.c 里没有引用（约 10 KB 位图的潜在可裁剪空间），本次不动。

  **本环节没有动的**：控制逻辑一行没改（外环要到 H13 才读这三个参数）；
  `mixer.*` / `attitude_control.*` / `pid.*` / 黑匣子采样记录格式 / `.uvprojx` 全部没动。
  **静态检查**：飞控 8 个文件、遥控 3 个文件，`-Wall -Wextra -Wformat=2` 全干净；
  两份 `apex_protocol.h` 的关键常量与枚举顺序**逐条比对一致**。

- **2026-09-15 H10 实施（v0.18）：悬停油门估计器 + 绝对油门区间**。这是定高第一次"知道该给多少油门"。

  **① ⭐⭐ 形态与原文不同：拆成两层**（原文只说"内环 Ki + anti-windup"）
  - **慢层** = 手写积分器 `vertical_throttle_base_us`（悬停油门估计器，方案 §2.3 承诺的那个东西），
    由协议参数 `vz_ki` 驱动，初值 **1250**，钳 **[1150, 1650]**；
  - **快层** = H9 的垂速内环 P（钳 ±50）；
  - `GetThrottleUs() = 慢层 + 快层`，**再整体钳到 [1150, 1650]**。

  **② ⚠️ 为什么不让 `Pid_t` 的内部积分当慢层（这是本环节最容易做错的地方）**
  `pid.c` 的积分钳位是**对称的**（±`i_limit`），而 [1150,1650] 相对 0 **不对称**。
  硬套只能玩"把积分当偏移、中心挪到 1400"，可读性差、以后必被改错。
  ⇒ 因此 `Pid_ApplyParams` 收到的 **`ki` 写死 0**，`vertical_inner_pid` 的内部积分永不运行。
  **两个积分器同时跑会打架**，这一行在代码注释里写死了原因，别"顺手修正"。

  **③ 快层限幅 30 → 50**（`VERTICAL_INNER_CORR_LIMIT_US`）：与 H14 首飞的"±50µs 起步"对齐。
  取 80 则首飞振荡风险偏高；真正该调的旋钮是 `vz_kp`（遥控可改、不用重烧）。

  **④ 地板 1150 / 天花板 1650，且刻意不跟 `max_throttle_us` 走**
  `max_throttle_us` 同时是普通模式满杆油门，跟着它会让"调手动手感"意外改变定高行为。
  - 地板 1150 = 混控有效下限 1100 + 50µs。**必须 >1100**，否则命中 `motor_test.c` 的
    "四路等值 + `AttitudeControl_Reset()`"分支 ⇒ 飞机在空中没有姿态修正；
  - 天花板 1650 = 悬停估计 **1420** + 230µs，且给姿态差速留 350µs（基础油门越接近物理上限
    2000，留给姿态的空间越小，**被牺牲的永远是姿态**）。

  **⑤ ⭐ 积分与输出用同一把锁**：只钳输出不钳积分就是 windup ——
  积分偷偷涨到几千而表面看不出来，表现成"长期顶在天花板"，条件一变立刻猛冲。
  仿真里有一条**显式断言**：顶到天花板后反向 0.1s 内 `i` 必须立刻开始下降。

  **⑥ ⚠️ anti-windup 不需要额外接线（更正 H9 的说法）**
  `pid.c` 的 anti-windup 第 1 层（条件积分）本来就在跑；第 2 层 `delivery_scale`
  是给"混控缩放姿态修正"用的，高度环的输出没有"被打折"这回事。
  ⇒ H9 写的"anti-windup 推迟到 H10"**更正为"高度环不需要它"**。

  **⑦ 并入了 H11 的两行**：`motor_test.c` 的 `vz_correction_us` / `vz_target_cms`
  由恒填 0 改成填快照真值（此前黑匣子里有一列"看着像数据、其实是常数"）。
  ⚠️ 但**慢层的 `i` 在样本记录里没有对应字段** —— 要在飞行整定时用它，得给样本加一列
  （改 `BLACKBOX_RECORD_SCHEMA`），属独立改动，本次没做。

  **⑧ ⚠️ 满杆油门默认 1500 → 2000**（用户决定）
  当年取 1500 是因为"1450 就能起飞、再高用不到，压窄区间精度"—— 但那个精度是**花不出去的**：
  1000~1500 映射下一格杆 = 0.5µs，而 `motor.c` 文件头写着 **TIM8 计数 1MHz（1µs）**，
  电调只能分辨 1µs。改成 1000~2000 后一格杆 = 1µs，**正好等于电调分辨率，没有损失**。
  代价两条（已写进 §H10 验收）：悬停点从杆量 ~900 挪到 ~450；软启动 0.625s → 1.25s。

  **⑨ `[V]` 打印加 `i=`**（慢层当前值）。**台架上只有它能看出积分在不在工作** ——
  `corr` 是快层、随时可能为 0，而 `i` 会随"匀速移动飞机"持续变化。不加它 H10 无法验收。

  **⑩ 验收工具同步**：`verify_v.js` 已按 H10 全面更新（新增慢层符号、有界、无 windup、
  地板不越界等判据），并配了 **B/C 两组"符号写反"的对照组**自测 ——
  只有"正确的组也能过"是不够的，还必须证明脚本**真能抓到写反的那种**。

  **本环节没有动的**：`pid.c` / `mixer.*` / `attitude_control.*` / 协议格式 /
  黑匣子记录结构 / `.uvprojx` 全部没动。
  **静态检查**：飞控 8 个文件、遥控 3 个文件，`-Wall -Wextra -Wformat=2` 全干净；
  新增符号全工程查重（各 1 处定义）。

- **2026-09-15 H12 实施（v0.19）：失效处理 —— 保持 → 平缓降至 1000**。
  这一环的**形状与原文完全不同**（原文是"退出判据 + 交还手动"），起因是 H10 真机实测
  暴露的 **41/451 个样本（9% 的时间）处于"空中停车"**。

  **① ⭐⭐ 三级台阶，不是"退出"**
  `st=1 控制` →（门禁②失效）→ `st=6 失效保持`（油门**锁存**、姿态环照常、计时 2s）
  →（未恢复）→ `st=7 失效下降`（从锁存值按 **30µs/s** 降到 1000，**单向不回头**）。
  为什么不是"立刻退出交还手动"：飞行员接管的动作（切模式）**只在地面上允许**，
  空中交还等于"看着它掉"；而"立刻 1000"又等于空中停车。
  ⭐ 锁存值取 **"失效前一刻的实际输出"**（慢层+快层），就是方案 §2.3 承诺的
  "内环积分器即悬停油门估计器"—— 比任何常数都好，因为它带着当前的电压与载荷。

  **② ⭐⭐ 2 秒保持是"纯赚的"**：ToF 的失效有相当一部分是瞬时的
  （反光地面、丢帧、`too many misses → re-init`，H10 实测一晚上出现 3 次），
  它们本来什么都不用做。保持段内恢复 ⇒ 慢层不丢、油门零跳变（仿真断言差 = 0）。
  而且保持段油门锁在悬停值 ⇒ **不增加落地速度**（1.86 vs 1.86 m/s，只晚 2 秒落地）。

  **③ ⚠️ 姿态超 25° 是唯一例外：不进保持段、直接 1000**（用户决定）。
  理由：保持段的用途是"抓瞬时失效"，而姿态歪着**不是瞬时事件**、它什么也抓不到；
  若也走 2s+30µs/s，撞地之后桨还要转约 **16 秒**，与"撞了就别管、赶紧停桨"正相反。

  **④ 高度越界（>125cm）并入本环节**，与读数失效同一套。**恢复门槛 115cm**（滞回）：
  高度是连续量，进出用同一个门槛就会在边界上来回穿（`h_sp` 上限就是 120cm）。

  **⑤ ⭐⭐ 守卫④「没飞过就不许锁存」** —— 本环节**自己引入的风险**的补丁：
  地面上重新解锁而 ToF 还坏着时，停手判据要求 `est_valid` ⇒ **永远进不去停手** ⇒
  `grounded` 恒 false ⇒ 会把油门在**地面上**顶到 ~1250µs，飞机自己窜出去。
  判据用"**本次解锁后有没有真的飞过**"，**不能用高度** —— 高度正好在读数坏的时候不可用。

  **⑥ 顺带修掉的两个自己写的 bug**（都不是编译能发现的，靠通读抓回来）：
  - **高度越界不在门禁②里** ⇒ "h>125cm 而其它一切正常"那一拍 `IsActive()` 恰好为 true。
    第一版在"门禁全通就 return"处直接返回 ⇒ **高度失效整条判据是死代码**。
  - 进入失效时**必须先把状态置位、再让 ⑩ 决定冻结**，否则那一拍 `i` 会被 else 分支按回 1250，
    锁存值就变成了一个假的常数。

  **⑦ 观测**：`[V]` 加 **`fs=`（失效计时）/ `fr=`（原因）**；
  遥测 `flight_mode` 的 **bit5-6 = 原因**（⚠️ 遥控端暂不解析，弹窗按用户要求缓做，
  先占位 ⇒ 将来加弹窗只改遥控端、飞控不用再烧）；
  黑匣子 `altitude_state` 的 **bit5-6 = 原因**（bit0-3 状态、bit4 预留定点都不动 ⇒ 旧档天然兼容）。

  **本环节没有动的**：`pid.c` / `mixer.*` / `attitude_control.*` / 协议 payload 长度 /
  黑匣子记录结构 / `.uvprojx` / **遥控端一行都没动**。
  **静态检查**：飞控 7 个文件 `-Wall -Wextra -Wformat=2` 全干净；新增符号全工程查重。
  ⚠️ 过程中踩到一个**工程性**的坑：`motor_test.c` 是 **CRLF** 而 `vertical_control.c` 是 **LF**，
  用脚本按 `\n` 切分改这个文件会把行尾搞成混合 —— 改完必须逐文件核对行尾。

- **2026-09-15 H13 实施（v0.20）：外环 P + `h_sp` 接入 —— 串级真正成立**。
  本环节表面上是"接线"，实际上**方案阶段就抓出一个必须改参数的问题**。

  **① 接线本身很简单**：`vz_sp` 从常数 0 换成
  `Pid_Update(外环, h_sp, h_est)`（死区 2cm、限幅 ±20），内环与慢层的代码**一行没改** ——
  这就是串级的用意：外环换了，内环照旧。
  ⚠️ 但有两个"现成件"要补：`Pid_t` **没有死区字段**（死区用"界内把设定值当成当前值"
  传进去实现，这样 PID 的微分历史不会停更）；`PidTable_GetHeightParams()` **还不存在**
  （`pid_table.h` 里写着"H13 才补"）。

  **② ⭐⭐ 慢层的误差来源改了（H13 独有、也是最关键的一处）**：
  从 `0 − vz` 改成 `vz_sp − vz`。H10 的注释一直写着"两层用同一个误差"，
  H13 才把它补成真的。**这一条是"定高能起飞"的全部依据**：
  慢层只在有误差时才学，用 0 的话飞机在地面上 `vz=0` ⇒ 永不学习 ⇒
  油门停在 1250 而悬停要 1450 ⇒ **永远离不开地面** —— 这正是 H10 台架上
  "飞机仍然抬不起来"的真正原因（当时归因成"没有外环"，现在讲清了）。

  **③ ⭐⭐⭐ 回路延迟把增益上限压得很低（本环节最重要的产出）**：
  ToF 一步 20ms、4 步一个测量周期 = **83ms**，再加差分垂速、低通、限速器（125ms/满幅）。
  手算：`d(推力比)/du = 2/415` ⇒ 修正量每变 1µs 加速度变 4.7cm/s² ⇒
  内环 `corr = −Kp_v·vz` 的闭环时间常数 = `1/(Kp_v × 4.7)`，`Kp_v=20` 时只有 **11ms**，
  比延迟快 8~15 倍 ⇒ **相位裕度必然为负**。
  仿真确认：延迟 0 稳、40ms 轻振荡、**80ms 明显振荡（末段垂速 ±27cm/s）**；
  `vz_kp` 扫描在 80ms 下只有 `2` 稳。
  ⇒ ① **`h_kp` 默认 0.6 → 0.3**（`pid_table.c` 一行）；
    ② **首飞 `vz_kp` 用 2 而不是 20**（写在 H14 里）；
    ③ ⚠️ 同时说明 **H9 的"台架验过了"只验了符号** —— 拆桨时没有真实推力回路，
       "增益该取多少"从头到尾没被验证过。**真正的解法是 H16（换掉 `vz` 的来源）**，
       不是继续调增益。

  **④ 台架与首飞的预期行为（仿真给的数）**：推杆 ⇒ 1.35s 退停手 ⇒ 约 5.7 秒憋油门 ⇒
  约 **7.0s 离地**；离地后最大爬升 **8.4cm/s**、**过冲 0**；跟随持续上升的目标滞后 **5cm**
  （与 §3.3 的预测一致，说明模型可信）。台架上则表现为 **`i` 一路顶到天花板 1650**。

  **⑤ 观测**：`[V]` 加 `vzsp=`（H9 的注释里就写着"H13 要加回来"）；
  黑匣子 `vz_target_cms` 由"恒 0"变成真值（**记录结构不变**）；`[V]` 一行现在 **18 个字段**。

  **本环节没有动的**：`pid.c` / `mixer.*` / `attitude_control.*` / 协议 payload 长度 /
  黑匣子记录结构 / `.uvprojx` / **遥控端一行都没动**（ID 30/31/32 早就可编辑）。
  **静态检查**：飞控 7 个文件 `-Wall -Wextra -Wformat=2` 全干净；新增符号全工程查重。
  ⚠️ 文档侧踩到一个坑：**用 PowerShell 改含中文的源码会把编码搞坏**（`Set-Content` 默认编码），
  文件直接变成非法 UTF-8 —— 含中文的文件一律用文件工具改，不要用脚本。
