Nyxarian/ApexFly-v2.0/优化一下/性能增强+9轴.md

# ApexFly V2.0 性能增强 + 9 轴融合 实施方案

> **文件用途**：`环节开发顺序.md` 第六组（#31~#36）与 9 轴融合的详细执行方案，含**顺序、前置条件、验证方法、验收标准、回退方式**。
>
> **相关文档**：
> - `环节开发顺序.md`——环节进度总表
> - `调参.md`——#30 PID 整定方案（本方案第 6 阶段才进入）
> - `姿态链路优化实施顺序（详细版）.md`——阶段划分原始依据
> - `姿态链路优化备注（MPU6050-PID-电机）.md`——问题清单（A/B/C/D/E/F 组）
>
> 创建日期：2026-09-09。前置：#1~#29 全部完成并验证。

---

## 零、总览

### 0.1 为什么先做性能增强，再统一调参

**核心原则：调参要调在"最终的系统"上。**

| 改动 | 是否改变动力学 | 若放在调参之后 |
|---|---|---|
| #31 I2C DMA | 不改动力学，改 CPU 占用 | 影响小 |
| #32 EXTI 采样 | 改采样相位 | 影响小 |
| #10 DLPF 档位 | **改延迟** | 影响小（但会改噪声） |
| **#33 提频** | **改全部轴的动态特性** | **roll/pitch/yaw 必须全部重调** |
| 9 轴融合 | 只改 yaw | 只补调 yaw |

**结论**：#33 若放在 #30 之后，整定结果基本作废；放在之前则只需调一次。
所以顺序是：**先改系统 → 再统一调参**。

### 0.2 与环节总表的对应

| 本方案阶段 | 对应环节 | 说明 |
|---|---|---|
| 阶段 0 | 新增（前置闸门） | 磁力计数据质量评估，决定阶段 4 走哪条路 |
| 阶段 1 | **#31** | I2C DMA 读；承接原 #11（DRDY）、#12（读取原子性）的一部分 |
| 阶段 2 | **#32** | EXTI/DRDY 中断采样；承接 #11 |
| 阶段 3 | **#10 + #33** | DLPF 档位必须与提频同步改 |
| 阶段 4 | 9 轴融合（原 **#36** 的完整版） | 磁航向进姿态或进偏航环 |
| 阶段 5 | **#30** | 统一调参，一次到位 |
| 阶段 6 | **#34 / #35 / #36 剩余** | 调参之后的可选增强 |

### 0.3 总流程

```
阶段 0  磁力计数据质量评估          ← 闸门：不通过则阶段 4 降级
   ↓
阶段 1  #31 I2C DMA 读              ← 台架验证数据逐字节一致
   ↓
阶段 2  #32 EXTI/DRDY 中断采样       ← 台架验证每拍都是新样本
   ↓
阶段 3  #10 DLPF + #33 提频 250Hz    ← 台架验噪声/耗时，飞行验可飞
   ↓
阶段 4  9 轴融合（路线 a）            ⏭️ 【跳过】改按需
   ↓           替代 → 打开 yaw_rate / yaw_angle（路线 b），并入阶段 5
阶段 5  #30 统一调参                 ← 一次到位（轮 6 顺手把偏航两个功能上线）
   ↓
阶段 6  #34 电压补偿 / #35 输出平滑   ← 按需
```

### 0.4 三条铁律

1. **一步一验，不跳步**。每个阶段独立验证通过后才能进下一阶段；不允许"一次改四个再一起试"。
2. **每阶段都有回退路径**，且回退不需要重新设计（用宏切换或改回旧值）。
3. **阶段 0 不通过，阶段 4 降级**（见 0.5），但阶段 1~3、5 不受影响。

### 0.4.1 阶段 4 已决定跳过（2026-09-10）

阶段 0 实测通过后，评估结论是 **路线 (a) 9 轴融合不必要** —— 航向保持用路线 (b)
（磁航向进偏航角环，代码已存在）即可，零工程量、风险更低。

**详见第五节 5.0。** 阶段 4 改为"后续按需"。

> ⚠️ **注意：跳过 9 轴融合 ≠ 不用磁力计。** 磁力计仍然要用于偏航航向保持（路线 b）。

### 0.5 阶段 0 的分支决策

| 阶段 0 结果 | 阶段 4 走哪条路 |
|---|---|
| 静态噪声 < 2°、电流干扰偏移 < 3° | **路线 (a)**：9 轴 Mahony，磁力计进姿态融合 |
| 噪声大 / 电流干扰 > 3° | **路线 (b)**：保持 6 轴，磁航向只进偏航角环（现状路线，低风险） |
| 磁力计完全不可用 | 跳过阶段 4，yaw 只做速率阻尼（`调参.md` 轮 6a） |

---

## 一、阶段 0：磁力计数据质量评估（前置闸门）

### 1.1 目的

**这是整个方案里唯一可能推翻路线的环节。** HMC5883L 本身噪声约 ±2°，装在四轴上还要面对电机电流、电调、电池线产生的磁场。数据质量不行，无论走哪条路线都做不好。

**先花 0.5 小时测出来，比先写 200 行融合代码划算。**

### 1.2 前置条件

| 项 | 要求 |
|---|---|
| 供电 | **USB 供电即可，不需要电池**（前 3 项） |
| 串口 | USART3，115200-8N1 |
| 环境 | 远离铁磁物、大电流线、金属桌面 |
| 飞机状态 | 拆桨、静置 |

### 1.3 操作步骤

**第 1 步：硬铁校准**

```
串口输入：calmag start
缓慢绕三轴各转一圈以上（像转魔方，覆盖所有朝向）
串口输入：calmag status     ← 看三轴 span 是否足够
串口输入：calmag stop       ← 计算偏移并排队写 Flash
```

成功标志：
- `[MAG_CAL] done samples=... span=... offset=...`
- `[MAG_CAL] queued flash save at 0x002000`
- 断电重启后出现 `[MAG_CAL] flash loaded gen=N`

失败标志：`[MAG_CAL] rejected samples=... span=...; rotate farther on all 3 axes.` → 重转。

**第 2 步：静态噪声**

静置，看串口 `[MAG]` 打印的 `calhdg=` 字段（需要姿态调试任务，若没有可临时打开）。

| 指标 | 通过标准 |
|---|---|
| `calhdg` 波动 | **< 2°** |
| 采样计数 `ok` | 持续增长，无 `err` |

**第 3 步：转动连续性**

缓慢水平转动飞机（手拿着转一圈）。

| 指标 | 通过标准 |
|---|---|
| 航向变化 | 连续单调，**不跳变** |
| 回到原位 | 航向回到原值 ±2° |

**第 4 步：电流干扰（需要电池）**

| 条件 | 记录 |
|---|---|
| 电机不转 | `calhdg` = A |
| 电机中油门（拆桨）转 10 秒 | `calhdg` = B |
| 偏移量 | **\|B − A\| < 3°** |

> 这一条**最能说明 9 轴可行性**。偏移大说明磁力计离电机/电调太近，或者需要做"电机干扰补偿"（复杂度高，不建议）。

### 1.4 验收与分支

| 结果 | 分支 |
|---|---|
| 全部通过 | 阶段 4 走**路线 (a)** 9 轴 Mahony |
| 仅第 4 步不通过 | 阶段 4 走**路线 (b)** 磁航向只进偏航环（电流干扰时偏航环会受影响，但可加大倾角/门禁保护） |
| 第 2/3 步不通过 | 检查接线、安装位置；仍不行则**跳过阶段 4** |

---

### 1.5 实测结果（2026-09-10，已完成）

#### 硬件与标定

| 项 | 结果 | 判定 |
|---|---|---|
| 芯片 | **QMC5883P**（驱动自动识别，非 HMC5883L） | ✅ |
| 标度 | 1000 LSB/高斯（由 \|B\| 反推自洽） | ✅ |
| 地磁场 \|B_e\| | 0.495 高斯（由 span÷2 反推） | ✅ 正常 |
| 硬铁 offset | (−0.069, +0.119, +0.054)，\|offset\| = **0.148 高斯** | ⚠️ 偏大但可复现，标定已扣 |
| Flash | `gen=3`，重启后 `flash loaded gen=3` | ✅ |

#### 四个子测试

| 测试 | 实测 | 判定 |
|---|---|---|
| **T2 静态噪声** | **±0.3°**（门槛 2°） | ✅ **优秀** |
| **T3 转动连续性** | 陀螺转过 −351.5°，航向完整跟随；4343 拍中仅 1 次 32° 毛刺 | ✅ 通过 |
| **T4 电流干扰（空载）** | 油门 0→2000us→0 全程，航向仅 **±1.3°**（门槛 3°） | ✅ 空载通过 |
| T4 带载 | **未测**（带桨系留风险高） | ⏸️ 留到 #30 飞行看黑匣子 |

#### 映射（重要修正）

**旧映射 `mx=-x, my=y` 是错的**，实测后改为：

```c
*mx_gauss = -y_gauss;    /* 前 */
*my_gauss =  x_gauss;    /* 右 */
*mz_gauss =  z_gauss;    /* 下 */
```

实测依据（与机体朝向无关，只用地磁场方向）：
- 水平磁场完全落在芯片 −Y 上 → **芯片 −Y 指向正北**
- Z 读数为正的完整垂直分量 → **芯片 Z 指向正下**
- 结论：芯片电气轴 = **X→东、Y→南、Z→下**，与模块丝印标注差 180°

#### 关键教训（记下来）

| # | 教训 |
|---|---|
| 1 | **磁力计丝印不可信**，映射必须实测推导 |
| 2 | **换安装位置必须重做硬铁校准**，旧 Flash offset 立即作废 |
| 3 | **传感器要远离电池主回路**：原位置离总电流极近，低油门空载就偏 5.58°；挪开后全油门空载只偏 1.3° |
| 4 | **飞控串口每 5ms 才轮询一次接收**，长命令必须逐字节慢发（见 `工具/串口工具.html` 的"间隔 10ms/字节"） |
| 5 | 磁力计**未做倾角补偿**，做朝向测试时机体必须保持水平 |
| 6 | 测 `\|B\|` 是否恒定可判断环境干净程度（刚体在均匀场中旋转，`\|B\|` 必须不变） |

#### 遗留待办（不阻塞主线）

| 项 | 说明 |
|---|---|
| 软铁椭球拟合标定 | 当前硬铁标定后仍有 **7% 残留畸变**（软铁），会让航向有 ±5~10° 的朝向相关误差 |
| 绝对航向校验 | `chdg` 与 `bhdg` 差约 20°，**不影响偏航环**（环锁的是相对航向），等 GPS 可用时再校 |
| 带载电流干扰确认 | #30 飞行时导黑匣子看 `mag_hdg` 随 `thr` 的变化 |

#### 阶段 0 结论

> **路线 (a) 9 轴融合：条件性可行** ✅
>
> 磁力计硬件质量优秀、电流干扰（空载）已降到 1.3°、映射已确认。
> 唯一保留是带载干扰量级 —— 留到 #30 飞行验证。

---

## 二、阶段 1：#31 I2C DMA 读 —— ⏭️ 决定跳过（2026-09-10）

> **本阶段跳过。** 原目标"为 #33 提频腾出时间预算"改由 **I2C1 提到 400kHz** 承担。
>
> **为什么不靠 DMA**：DMA 只改变"谁在等"（CPU 忙等 → 任务阻塞在信号量上），
> **不改变 I2C 事务本身的墙钟延迟**。而当前的真实瓶颈是**总线速率**：
> `I2C1.Timing=0x40B285C2` 解码为约 **100kHz**（PRESC=4 → t_PRESC=29.41ns，SCLL=194、SCLH=133，
> SCL 周期 9.68µs），14 字节读按该速率约 **1.5ms**，占满 10ms 控制周期的 15%；
> 提到 250Hz（4ms）后就是 38%，必然超时。**只做 DMA 不修总线，提频照样做不成。**
>
> **替代方案**：`hi2c1.Init.Timing` 改为 `0x40621236`（CubeMX 官方值，Fast Mode 400kHz），
> 读耗时降到约 0.4ms，一次解决 CPU 占用与提频预算两个问题，且只改 1 个寄存器值、零结构性风险。
>
> **归属**：400kHz 作为 **#33 的前置步骤**执行（记为"轮 A"），不塞进 #32
> —— #32（DRDY 中断采样）与总线速率没有依赖关系。
>
> **#31 名下原承接项的去处**：#11（DRDY 中断）、#12（读取原子性）继续由 **#32** 承接。
> DMA 通路暂不实现；若将来 400kHz 仍不够（例如要上 500Hz），再回头评估。
>
> **以下 2.1~2.9 为原始方案，本次不执行，仅留档。**

### 2.0.1 轮 A 实测结果（2026-09-10，已完成 ✅）

| 项 | 改前（旧值 `0x40B285C2`） | 改后（`0x40621236`） |
|---|---|---|
| SCL 实际速率 | 约 98.8 kHz（按实测比值反推） | **400.0 kHz**（实测反推：393µs ÷ 157 位 = 2.50µs/位） |
| 14 字节读耗时 | 约 1600 µs（反推） | **405 µs**（探针实测，均值 = 峰值） |
| 占 10 ms 周期 | 16 % | **4.1 %** |
| 整拍 work（未解锁） | 约 1.63 ms | **435 µs 均值 / 633 µs 峰值**（峰值来自每秒一次的 `Battery_Update`） |
| I2C 错误 `err` | — | **0（连续 5 分钟以上）** |
| WHO_AM_I 自检 | — | **0x68，异常 0 次** |
| 丢拍 | — | **无，每秒拍数恒为 100** |

**结论**：提速 **4.0 倍**。`work` 减去 `i2c` 只剩约 30 µs（Mahony + 姿态映射 + 遥测发布 + 遥控快照），
说明控制环自身开销极小、I2C 读是绝对大头。
**阶段 3 提到 250 Hz（4 ms）后 `i2c` 占 10.1 %，时间预算充足，提频可行。**

**附带发现（值得记）**：`i2c` 峰值偶发 406~450 µs（约每秒一两次），是 ISR 抢占轮询造成的 SCL 时钟拉伸
—— HAL 阻塞读靠 CPU 及时读走 RXDR，被中断打断时外设会拉长 SCL。占比极小、不影响功能；
若要彻底消除，那才是 DMA 的真正价值（DMA 取 RXDR 不依赖 CPU）。

**另一件被实测否掉的事**：CubeMX 标称 400 kHz，而按 `(SCLL+1)+(SCLH+1)` 直接计数只有 2.18 µs（≈460 kHz），
曾担心实际偏快超标。实测 405 µs 证明 **CubeMX 的模型（把 SCLDEL/SDADEL 计入低电平延展、并计入上升时间）是对的**，
不需要再压低 `SCLL` 做后备。

### 2.1 目标

把 MPU6050 的 14 字节读取从**阻塞**改为 **DMA**，降低 CPU 占用，为阶段 3 提频腾出时间预算。

### 2.2 现状

| 项 | 现状 |
|---|---|
| 读取方式 | `HAL_I2C_Mem_Read()` 阻塞，超时 5ms |
| 数据量 | 14 字节 @ 400kHz ≈ 0.4ms |
| 占 10ms 周期 | 4% |
| 占 4ms 周期（提频后） | 10% |
| 占 2ms 周期（若提到 500Hz） | 20% |

### 2.3 前置条件

| 项 | 要求 |
|---|---|
| 阶段 | 阶段 0 完成（其实不依赖，但建议先做） |
| 固件基线 | #1~#29 已验证（提交 `d5c59ea`） |
| 工具 | 能对比改造前后的原始数据 |

### 2.4 改动点

| 文件 | 改动 |
|---|---|
| `Modules/IMU/mpu6050.c/.h` | 新增 DMA 读取路径：`HAL_I2C_Mem_Read_DMA()` + 静态缓冲区 + 完成通知 |
| `Core/Src/i2c.c` | 使能 I2C1 的 DMA 通道（CubeMX 配置） |
| `motor_test.c` | 调用点改为"DMA 启动 + 等待完成"或"读取上一拍结果" |
| `.ioc` | 配置 I2C1 TX DMA（若用 Mem_Read_DMA，走 TX 通道发地址 + RX 通道收数据） |

### 2.5 关键设计决策（实现时定）

| 方案 | 说明 | 延迟 | 复杂度 |
|---|---|---|---|
| **A. DMA + 等待完成** | 启动 DMA，阻塞在信号量上等完成 | 不变（仍 0.4ms） | 低 |
| **B. 流水线** | 本拍末尾启动下一拍读取，下一拍开头取结果 | 增加 1 拍 | 中 |
| **C. DRDY 驱动**（配合阶段 2） | 芯片有新数据 → 中断 → 启动 DMA → 控制拍开始时数据已就绪 | 最小 | 高 |

**建议**：阶段 1 先做 **A**（验证 DMA 通路正确），阶段 2 再升级到 **C**。

### 2.6 验证方法（台架，不需要电池）

| # | 方法 | 通过标准 |
|---|---|---|
| 1 | **静态逐字节对比**：改造前后各采 10 秒原始数据，对比 accel/gyro 的原始码值序列 | 统计特性一致（均值、方差、量级），无错位 |
| 2 | 转动飞机，看姿态角是否连续 | 无跳变、无卡顿 |
| 3 | 连续运行 10 分钟 | 无 I2C 错误累积、无数据冻结 |
| 4 | 测量控制环单拍耗时 | 比改造前**下降**（CPU 时间，不是墙钟） |

### 2.7 验收标准

- 原始数据统计特性与改造前一致；
- 无新增 I2C 错误；
- 控制周期稳定（`dt` 抖动不增大）。

### 2.8 回退

保留阻塞读代码路径，用编译宏 `MPU6050_USE_I2C_DMA` 切换，回退只需改宏。

### 2.9 风险

| 风险 | 影响 | 对策 |
|---|---|---|
| DMA 与下一次请求冲突 | 数据错乱 → **姿态失控** | 单缓冲 + 完成标志，未完成不发新请求 |
| DMA 通道与其它外设冲突 | 传输失败 | 查 DMA 请求映射表，确认 I2C1_TX/RX 独占通道 |
| 缓存一致性 | 读到旧数据 | STM32G4 无 D-Cache，风险低；仍需 `volatile` + 内存屏障 |

---

## 三、阶段 2：#32 EXTI/DRDY 中断采样

### 3.0 实测结果（2026-09-10，已完成 ✅）

| 项 | 结果 |
|---|---|
| `SMPLRT_DIV` | `0x00` → `0x09`：1kHz/(1+9) = **100Hz**，一次 DRDY = 一帧控制 |
| DRDY 中断与拍数 | **1:1**，每秒恒为 100 / 100，无一次例外 |
| 超时兜底次数 | **0**（脉冲一次没丢） |
| 实测周期 | **10019 µs**，抖动仅 **2~6 µs**（旧定时方式受 1ms tick 粒度限制） |
| `err` / WHO_AM_I | 0 / 0x68 |
| **断线兜底（自测）** | 跳过 `INT_ENABLE` 写入模拟 INT 断线：`drdy=0`、`tick=50`、`timeout` 每秒 +50、`err=0`、`who=0x68` —— **循环稳定跑在 50Hz，不卡死** ✅ |

**两个实测发现（重要，以后会反复用到）**

1. **传感器实际周期是 10.019 ms，不是 10.000 ms。**
   MPU6050 的 100Hz 由它自己的陀螺参考时钟分频而来，比 MCU 晶振慢 **0.19%**。
   - 所以必须用**实测 dt** 驱动 PID（硬编码 `0.01f` 会带 0.19% 的积分/微分偏差）。
   - 反推旧代码：MCU 每 10.000 ms 读一次、芯片每 10.019 ms 更新一次，相位每拍漂 19 µs
     → **约每 5.3 秒就会有一拍读到与上一拍完全相同的帧**（重复积分、重复控制）。改 DRDY 后归零。
   - 阶段 3 提频时同样成立：250Hz 的真实周期约 **4.008 ms**，靠实测 dt 自动跟上。

2. **MPU6050 只要不断电就一直保留自己的寄存器。**
   热复位（按复位键/重新下载）后，芯片仍按**上一次固件**的 `INT_ENABLE`/`SMPLRT_DIV` 在打脉冲。
   实测证据：热复位后前 5 行 `drdy=100`（芯片残留 `INT_ENABLE=1`），**断电重上电后才是 `drdy=0`**。
   → **做采样率、DRDY、DLPF 相关验证前，必须完全断电重上电**，否则测到的是芯片残留状态。

### 3.1 目标

用 MPU6050 的 **Data-Ready 中断**驱动采样，保证每拍拿到的是**新样本**，且采样相位与芯片内部更新对齐。

### 3.2 现状

| 项 | 现状 |
|---|---|
| `IMU_INT` | PB0 / EXTI0 已配优先级 6 |
| `HAL_GPIO_EXTI_Callback()` | **明确忽略它**（`radio.c:344-353`） |
| 采样方式 | 靠 `osDelayUntil` 盲等，不检查 Data-Ready |
| 后果 | 可能读到与上一拍相同的样本（重复积分/重复控制），或跨更新边界读到"半新半旧"数据 |

### 3.3 前置条件

| 项 | 要求 |
|---|---|
| 阶段 | **不依赖阶段 1**（#31 DMA 已跳过）；建议先完成轮 A（400kHz），再进本阶段 |
| 硬件 | PB0 已接到 MPU6050 的 INT 脚（现有工程已配，需实测确认有脉冲） |

### 3.4 改动点

| 文件 | 改动 |
|---|---|
| `radio.c` 或新建 `imu_int.c` | EXTI0 回调 → 任务通知（`vTaskNotifyGiveFromISR`） |
| `motor_test.c` | 控制循环从 `osDelayUntil` 改为等待任务通知（带超时兜底） |
| `mpu6050.c` | 设置 `SMPLRT_DIV` 使 DRDY 频率 = 控制频率；读前检查 `INT_STATUS.DATA_RDY` |
| `mpu6050.h` | 新增 INT 使能配置 |

### 3.5 关键设计决策

**采样率对齐**：MPU6050 内部采样 1kHz（DLPF 决定），用 `SMPLRT_DIV` 分频：

| 控制频率 | SMPLRT_DIV | 实际 DRDY |
|---|---|---|
| 100Hz | 9 | 100Hz |
| **250Hz** | **3** | **250Hz** |
| 500Hz | 1 | 500Hz |

这样 **一次 DRDY = 一帧控制**，时序最干净。

> ⚠️ 注意：改 `SMPLRT_DIV` 会改变采样率，必须与阶段 3 的 DLPF 档位一起考虑（DLPF 的内部采样率必须是 1kHz 才能这么分频；98Hz 档和 188Hz 档都是 1kHz）。

### 3.6 验证方法（台架，不需要电池）

| # | 方法 | 通过标准 |
|---|---|---|
| 1 | 用示波器/逻辑分析仪看 PB0 | 有稳定脉冲，频率 = 预期 DRDY 频率 |
| 2 | 连续采样，统计 `sample_count` 与中断计数 | 两者一致（每拍一个新样本） |
| 3 | 控制周期实测 | 与 DRDY 周期一致，抖动 < 5% |
| 4 | 断开 INT 线 | 循环靠超时兜底继续跑，不卡死 |

### 3.7 验收标准

- 每拍都是新样本（无重复）；
- 控制周期由 DRDY 驱动，抖动显著小于盲等；
- INT 失效时有超时保护，不会死锁。

### 3.8 回退

用宏 `IMU_USE_DRDY_IRQ` 切回 `osDelayUntil` 盲等。

### 3.9 风险

| 风险 | 影响 | 对策 |
|---|---|---|
| 中断频率高（250~1000Hz） | CPU 占用、优先级反转 | 中断里只发通知，不做任何 I2C 操作 |
| INT 线噪声/悬空 | 误触发或丢失 | 硬件上拉 + 软件超时兜底 |
| 中断优先级与 I2C DMA 冲突 | 数据竞争 | 明确优先级：EXTI(6) > 任务；DMA 完成用任务通知 |

---

## 四、阶段 3：#10 DLPF 档位 + #33 控制频率提升

> **这两个必须一起改。** 只提频不改 DLPF，42Hz 滤波器会成为瓶颈；只改 DLPF 不提频，噪声上去了延迟没降多少。

### 4.0 本次执行记录（2026-09-10，代码就绪，待台架验证）

前置条件已具备：轮 A 已把 I2C1 提到 400kHz（实测读 405µs/拍），轮 B 已把采样改成 DRDY 驱动（实测 1:1、周期抖动 2~6µs）。

实际采用的参数：

| 项 | 取值 | 位置 |
|---|---|---|
| DLPF | `CONFIG = 0x02`（带宽 98Hz，延迟约 2.8ms） | `mpu6050.c` |
| 输出率 / DRDY | `SMPLRT_DIV = 0x03` → **250Hz** | `mpu6050.c` |
| 控制周期常量 | `IMU_SAMPLE_PERIOD_MS = 4`、`IMU_DELTA_TIME_S = 0.004f` | `motor_test.c` |
| dt 限幅 | `MOTOR_DT_MIN_S = 0.002f`、`MOTOR_DT_MAX_S = 0.012f` | `motor_test.c` |
| DRDY 兜底超时 | `MOTOR_DRDY_TIMEOUT_MS = 8`（两倍周期；断线时跑 125Hz） | `motor_test.c` |
| 黑匣子分频 | `MOTOR_BLACKBOX_SAMPLE_DIV = 1` → **调参期间全速 250Hz**（约 8.3 分钟/场次）；调参结束后改 2 换长场次 | `motor_test.c` |

**已核对（支撑"旧增益可以直接飞"这个判断）**：整条控制链的 dt 自洽 —— `pid.c` 的 D 项除以 dt、I 项乘 dt、微分低通系数 `tau/(tau+dt)`；`attitude_control.c` 的 slew 限制全部乘 dt。提频只改变时间尺度，不改变增益的物理含义。
另外 `pid.c` 的 dt 合理性门限是 `[0.5ms, 100ms]`，4ms 落在区间内；250Hz 采样对 98Hz 带宽的奈奎斯特余量为 125Hz > 98Hz，不会折叠。

**台架实测结果（2026-09-10，✅ 通过）**

| 判据 | 通过线 | 实测 |
|---|---|---|
| `drdy` / `tick` | 250 / 250 | **250 / 250**（打印行约 3.2ms，塞进 4ms 一拍内，没吃采样） |
| `timeout` | 0 | 仅**冷启动第一次**超时 1 次，之后全程不再增长 |
| `dt` | ≈4008 µs | **4007 µs**（抖动 3~19 µs） |
| `work` 均值/峰值 | 峰值 < 2000 µs | **434 / 633 µs** |
| 陀螺静止噪声 | — | **13~15**（0.01dps，三轴和） |
| `err` | 0 | 0 |

**几点解读（以后会用到）**

- **时间预算**：`work` 峰值 633µs ÷ 4007µs = **15.8 %**（未解锁状态）。解锁后还要加串级 PID + 混控 +
  黑匣子入队，预计峰值 800~900µs（≈22 %），余量充足，**250Hz 站得住**。
- **`work` 与 100Hz 时几乎一样**（那时 435/633µs）：它主要由 I2C 读的 405µs 决定，与环率无关。
- **噪声完全达标，保留 `0x02`**：实测 0.13~0.15 dps（三轴和）→ 单轴约 0.05 dps RMS，
  与数据手册噪声密度 0.005 dps/√Hz × √98Hz ≈ 0.049 dps 吻合。
  说明 98Hz 档的噪声**就是芯片自身噪声**，台架上没有额外振动/串扰噪声，不需要退回 42Hz。
- **冷启动第一次超时 1 次**属正常：`MPU6050_Init` 刚写完 `INT_ENABLE`，芯片第一个 DRDY 脉冲要等
  下一个内部采样点 + 滤波建立（几毫秒），8ms 超时来不及。之后 `timeout` 不再增长。
- **第一条 `[R]708 1 …`**：`drdy=708` 是开机到首次打印之间的中断累计数（≈零偏 2s + 水平零点 0.8s ≈ 2.8s × 250Hz ≈ 700）；
  `tick=1` 是因为采集阶段都走 `continue`、不经过打印点。**不是异常**。

**待办**：飞行验证（旧增益直接飞，能稳定悬停）。**建议与 #30 的"轮 0 基线"合并成同一次飞行**，省一次飞行场次。

### 4.1 目标

控制频率 100Hz → **250Hz**（先 250，不要一步到 500），同时把 DLPF 从 42Hz 提到 98Hz 或 188Hz。

### 4.2 前置条件

| 项 | 要求 |
|---|---|
| 阶段 | 阶段 2 完成（DRDY 在跑）+ **轮 A 完成（I2C1 已到 400kHz）** —— 后者是硬前置，替代原 #31 的腾预算作用 |
| 时间预算 | 实测控制环单拍耗时 **< 4ms 的 50%**（即 < 2ms），留足余量 |
| 基线 | 记录当前 100Hz 下的黑匣子数据，用于对比 |

### 4.3 改动点

| 文件 | 改动 | 说明 |
|---|---|---|
| `mpu6050.c` | `CONFIG` 寄存器：0x03 → 0x02（98Hz）或 0x01（188Hz） | 权衡噪声与延迟 |
| `mpu6050.c` | `SMPLRT_DIV` 按新频率设置 | 见 3.5 |
| `motor_test.c` | `IMU_SAMPLE_PERIOD_MS` 10 → **4** | 250Hz |
| `motor_test.c` | `IMU_DELTA_TIME_S` 0.01 → **0.004** | ⚠️ 别漏 |
| `motor_test.c` | `MOTOR_DT_MIN_S` / `MOTOR_DT_MAX_S` | ⚠️ **必须改**：现在是 [5ms, 30ms]，4ms 会被判为异常 |
| `motor_test.c` | 黑匣子采样分频 | ⚠️ 250Hz 写 Flash 快 2.5 倍，见 4.6 |
| `app_freertos.c` | 复核 `motorTestTask` 优先级与栈 | 高优先级 640 字，栈够 |
| `tim.c` | **不改**（TIM8 已 400Hz，独立于控制频率） | — |

### 4.4 DLPF 档位选择

| CONFIG | 陀螺 | 加计 | 延迟 | 评价 |
|---|---|---|---|---|
| 0x03（现状） | 42Hz | 44Hz | ~4.9ms | 延迟大，100Hz 勉强 |
| **0x02** | **98Hz** | **98Hz** | **~2.8ms** | **推荐起点**：延迟降 43%，噪声增幅可控 |
| 0x01 | 184Hz | 188Hz | ~1.9ms | 噪声明显上升，需先看 #17 加计低通是否够用 |

**建议**：先改 **0x02**，测噪声；可接受再考虑 0x01。

### 4.5 验证方法

**台架（不需要电池）**

| # | 方法 | 通过标准 |
|---|---|---|
| 1 | 静态 5 分钟，统计陀螺/加计噪声 | 噪声上升但在可接受范围（对比 100Hz/42Hz 基线） |
| 2 | 实测控制环单拍耗时 | < 2ms（4ms 周期的 50%） |
| 3 | 实测 dt 抖动 | 中位数 4.00ms，抖动 < 5% |
| 4 | 快速转动飞机，看姿态跟随 | 无明显滞后改善/恶化 |

**飞行（需要电池）**

| # | 方法 | 通过标准 |
|---|---|---|
| 5 | **用旧增益直接飞** | 能稳定悬停（提频后相位裕度更大，不应变差） |
| 6 | 黑匣子对比 | 姿态噪声、修正量的形状与 100Hz 基线相当或更好 |

> **关键**：提频后旧增益可以直接飞——因为提频只会**增大**相位裕度，不会减小。所以本阶段可以独立飞行验证，不需要先整定。

### 4.6 ⚠️ 黑匣子采样率的连带影响

`Blackbox_SubmitSample()` 在控制环里每拍调用。提到 250Hz 后：

| 项 | 100Hz | 250Hz |
|---|---|---|
| 写入速率 | 6.4 KB/s | **16 KB/s** |
| 8MB Flash 可记录时长 | ~21 分钟 | **~8.3 分钟** |

**对策（二选一）**：
- 接受更短的场次；
- 在控制环里加采样分频（如每 2 拍记一次 → 125Hz），保持记录时长。

**建议**：调参期间用 250Hz 全记（场次短但数据密）；调参完成后改为分频。

### 4.7 验收标准

- dt 稳定在 4ms，抖动 < 5%；
- 控制环单拍耗时 < 2ms；
- 旧增益下能稳定飞行；
- 黑匣子记录正常，无丢样（`drop=0`）。

### 4.8 回退

所有改动集中在一个提交里，`git revert` 即可回到 100Hz。**注意**：DLPF 和 `SMPLRT_DIV` 也要一起回退。

### 4.9 风险

| 风险 | 影响 | 对策 |
|---|---|---|
| 4ms 周期塞不下 | 任务超时、姿态卡顿 | 先实测耗时；不够就停在 100Hz 或降到 200Hz |
| `MOTOR_DT_MIN_S` 忘记改 | **dt 被钳到 5ms → 积分/微分全错** | 改动清单里列为必改项 |
| DLPF 改档后噪声变大 | 姿态抖 → 增益上不去 | 先 0x02；不行退回 0x03 并接受延迟 |
| 黑匣子写满变快 | 场次变短 | 见 4.6 |
| 磁力计任务（50Hz）与新频率不同步 | 航向数据更旧 | 阶段 4 一并处理 |

---

## 五、阶段 4：9 轴融合 —— ⏭️ 决定跳过（2026-09-10）

> **本节原始方案保留在下方，仅作参考。实际操作改为"按需"：本次不做路线 (a)。**

### 5.0 决定与理由（2026-09-10）

**决定：本次不做 9 轴融合（路线 a）。改用路线 (b)：磁航向进偏航角环。**

| 维度 | 路线 (a) 磁力计进 Mahony | **路线 (b) 磁航向进偏航环** |
|---|---|---|
| 工程量 | 1~2 天（改姿态解算 + 磁场门禁 + 倾角补偿 + 独立 mag 增益） | **0**（代码已存在，只差参数） |
| 验证循环 | 要重新验一遍姿态链路 | 不需要 |
| 效果（悬停航向不漂） | ✅ | ✅ **一样** |
| 风险面 | **yaw 估计错了会经旋转矩阵渗进 roll/pitch** ⚠️ | **只影响偏航环** ✓ |
| 排查难度 | 出问题要在姿态解算里找 ✗ | 只怀疑一个环 ✓ |

**关键事实**：`AttitudeControl_UpdateYaw()` 里"航向保持"分支**早就写好了**：

```
打杆              → 摇杆直接给目标角速度（不需要磁力计）
松杆 + 航向有效    → 磁航向最短角误差 → 外环 → 目标角速度
松杆 + 航向无效    → 冻结外环，只阻尼
```

阶段 0 完成后 `mag_heading_valid` 已经为 `true`，**只差把 `yaw_angle Kp` 从 0 改成非 0** ✓

**触发重做路线 (a) 的条件**（满足任一再回头做）：

| 条件 | 说明 |
|---|---|
| 需要遥测/日志里的 yaw **角**也是绝对的 | 6 轴 yaw 仍会漂，但黑匣子的 `mag_hdg` 列已经记录绝对航向 |
| 定点/返航需要绝对 yaw 参与控制 | 后期可能 |
| GPS course 不够用 | 低速悬停时也要绝对航向 |
| 路线 (b) 精度不够 | 软铁残留导致 ±5~10° 朝向相关误差 |

### 5.0.1 偏航两个目标的实现方式

| 目标 | 最少需要 | 推荐做法 | 磁力计 |
|---|---|---|---|
| ① 稳定指向一个方向、不转圈 | `yaw_rate` + Ki | **再开 `yaw_angle`** | ✅ 需要（路线 b） |
| ② 摇杆控制转向 | `yaw_rate Kp` | 打开即可 | ❌ 不需要 |

> ⚠️ **不做 9 轴融合 ≠ 不用磁力计。** 目标 ① 必须用磁力计；只开 `yaw_rate` 的话，
> 速率环能顶住外力矩（基本不转圈），但陀螺零偏会让机头缓慢漂移（几十秒十几度）✗

**执行位置**：并入阶段 5（#30 整定）的轮 6，一起做 ✓

---

### （以下为原始方案，本次不执行，仅留档）

### 5.1 目标

让偏航有**绝对参考**，悬停时航向不漂，为定高定点返航提供航向。

### 5.2 前置条件

| 项 | 要求 |
|---|---|
| 阶段 0 | **必须通过**（决定走 (a) 还是 (b)） |
| 阶段 3 | 完成（mag 修正增益按最终控制频率设） |
| 磁力计 | 硬铁校准已写入 Flash 并成功回读 |

### 5.3 两条路线

#### 路线 (a)：9 轴 Mahony（磁力计进姿态融合）

```
加计 + 陀螺 + 磁力计 → 四元数（9 轴）→ roll/pitch/yaw 全是绝对量
```

| 项 | 内容 |
|---|---|
| 改动点 | `imu_attitude.c/.h`：新增磁向量输入、倾角补偿、磁场模长门禁、独立的 mag 修正增益 |
| 参数 | 新增 mag 修正增益（时间常数 10~30s） |
| 收益 | 姿态源统一；yaw 绝对；为定点/返航铺路 |
| 风险 | **磁干扰直接进姿态** |

#### 路线 (b)：6 轴 + 磁航向只进偏航角环（现状路线）

```
加计 + 陀螺 → 四元数（6 轴）→ roll/pitch 绝对，yaw 相对
                                    ↓
磁力计 → 倾角补偿航向 → 偏航角环的测量（只影响 yaw）
```

| 项 | 内容 |
|---|---|
| 改动点 | 倾角补偿 + 磁场门禁；偏航角环已写好（当前是死代码） |
| 收益 | 悬停航向不漂；磁干扰只影响偏航环 |
| 风险 | 低 |

### 5.4 两条路线都要补的三件事

| # | 要补什么 | 现状 | 说明 |
|---|---|---|---|
| 1 | **倾角补偿的航向** | ❌ 现在是 `atan2(-my, mx)`，无倾角补偿 | 倾 20° 时航向误差可达十几度 |
| 2 | **磁场模长门禁** | ❌ 没有 | `\|B\|` 偏离标定值 > 15% → 丢弃该样本 |
| 3 | **航向修正限速** | ❌ 没有 | 防止航向突变导致 yaw 抽动 |

**倾角补偿公式**（机体系 → 水平系）：

```
Xh = mx·cos(pitch) + my·sin(roll)·sin(pitch) − mz·cos(roll)·sin(pitch)
Yh = my·cos(roll) + mz·sin(roll)
heading = atan2(−Yh, Xh)          ← 符号需按本机实测确认
```

### 5.5 验证方法

**台架（不需要电池，前 3 项）**

| # | 方法 | 通过标准 |
|---|---|---|
| 1 | 水平缓慢转动 | 航向连续，回到原位 ±2° |
| 2 | **倾斜 20° 后转动** | 航向仍连续（验证倾角补偿生效） |
| 3 | 贴近铁磁物 | 磁场门禁触发，航向**冻结**而不是跳变 |
| 4 | 电机转 vs 不转（需电池） | 航向偏移 < 3° |

**飞行（需要电池）**

| # | 方法 | 通过标准 |
|---|---|---|
| 5 | 悬停 30 秒不打方向 | 航向漂移 **< 10°** |
| 6 | 打方向杆 | 转动干脆，松杆锁定 |
| 7 | 大姿态（>25°） | 航向保持自动冻结（设计行为），不抽动 |

### 5.6 验收标准

- 悬停 30 秒航向漂移 < 10°；
- 磁干扰时不跳变（门禁生效）；
- 大倾角时冻结行为正常。

### 5.7 回退

- 路线 (a)：mag 修正增益设 0 → 退回 6 轴；
- 路线 (b)：偏航角环增益设 0 → 退回纯速率阻尼。

### 5.8 风险

| 风险 | 影响 | 对策 |
|---|---|---|
| 磁干扰大 | 航向跳变 → 飞机抽航向 | 门禁 + 低增益 + 大倾角冻结 |
| 倾角补偿符号错 | 大倾角时航向反 | 台架第 2 项专门验 |
| 校准质量差 | 航向恒定偏 | 重做阶段 0 |
| 磁力计离电机太近 | 电流干扰 | 考虑重新安装位置 |

---

## 六、阶段 5：#30 统一调参

### 6.1 前置条件

**阶段 1~4 全部验证通过。** 此后系统架构不再变动，整定结果才有效。

### 6.2 执行

**完全按 `调参.md` 执行**，但注意以下差异：

| 项 | 差异 |
|---|---|
| 控制频率 | 250Hz（不再是 100Hz），`调参.md` 里的判据频段需按比例理解（"5~15Hz 抖振"在高频下可能表现为更高频） |
| dt | 4ms，积分/微分步长变小 |
| 黑匣子 | 记录密度更高，场次更短 |
| yaw | 若阶段 4 已做，轮 6b（yaw_angle）可以一起调 |

### 6.3 验收

同 `调参.md` 第六节。

---

## 七、阶段 6：其他增强（可选，调参之后）

### 7.1 #34 电压补偿

| 项 | 内容 |
|---|---|
| 目标 | 推力与电池电压解耦，悬停点不随电量下降 |
| 前置 | #30 整定完成（否则会污染整定数据） |
| 需要 | 一次台架标定：不同电压下的悬停油门曲线 |
| 改动点 | `motor_test.c` + `battery.c` |

### 7.2 #35 输出平滑

| 项 | 内容 |
|---|---|
| 目标 | 修正量一阶低通，减少电机电流冲击 |
| 前置 | #30 整定完成 |
| 注意 | **会增加延迟**，可能吃掉提频的收益，谨慎评估 |
| 改动点 | `attitude_control.c` 或 `mixer.c` |

### 7.3 #36 剩余部分

若阶段 4 走的是路线 (b)，可进一步考虑：
- GPS course 融合（仅在**移动**时有效，悬停时无参考）；
- 磁航向 + GPS course 互补滤波。

---

## 八、总时间预算

| 阶段 | 内容 | 需要电池 | 预计 |
|---|---|---|---|
| 0 | 磁力计数据质量评估 | 前 3 项不需要 | 0.5 小时 |
| 1 | #31 I2C DMA | ❌ | 半天 |
| 2 | #32 EXTI 采样 | ❌ | 半天 |
| 3 | #10 DLPF + #33 提频 | 台架不需要，飞行验证需要 | 1~2 天 |
| 4 | 9 轴融合 | 台架不需要，飞行验证需要 | 1~2 天 |
| 5 | #30 统一调参 | ✅ | 4~5 小时 |
| 6 | #34 / #35 | ✅ | 按需 |

---

## 九、风险总清单

| 风险 | 阶段 | 影响 | 对策 |
|---|---|---|---|
| 磁力计电流干扰大 | 0 | 9 轴做不成 | 降级到路线 (b) 或跳过 |
| DMA 时序冲突 | 1 | 数据错乱 → 失控 | 逐字节对比 + 单缓冲 |
| EXTI 误触发/丢失 | 2 | 采样错乱 | 超时兜底 + 硬件上拉 |
| 忘记改 `MOTOR_DT_MIN_S` | 3 | **dt 被钳 → 控制全错** | 列为必改项 |
| 4ms 周期塞不下 | 3 | 姿态卡顿 | 实测耗时；不够就停 100Hz |
| DLPF 噪声上升 | 3 | 增益上不去 | 先 0x02，不行退回 |
| 黑匣子写满变快 | 3 | 场次变短 | 采样分频 |
| 磁干扰进姿态（路线 a） | 4 | 航向跳变 | 门禁 + 低增益 + 冻结 |
| 多个改动叠加难定位 | 全部 | 排查成本高 | **一步一验** |

---

## 十、回退总表

| 阶段 | 回退方式 |
|---|---|
| 1 | 宏 `MPU6050_USE_I2C_DMA` 关掉 |
| 2 | 宏 `IMU_USE_DRDY_IRQ` 关掉，回到 `osDelayUntil` |
| 3 | `git revert` 该提交（DLPF + SMPLRT_DIV + 频率常量一起回退） |
| 4 | mag 修正增益设 0（路线 a）/ 偏航角环增益设 0（路线 b） |
| 5 | 恢复上一组参数 |

---

## 十一、记录模板

每阶段完成后填写：

```
| 阶段 | 日期 | 提交号 | 台架验证 | 飞行验证 | 结论 | 备注 |
|---|---|---|---|---|---|---|
| 0 磁力计评估 |  | — |  |  |  |  |
| 1 #31 DMA |  |  |  | — |  |  |
| 2 #32 EXTI |  |  |  | — |  |  |
| 3 #10+#33 提频 |  |  |  |  |  |  |
| 4 9 轴融合 |  |  |  |  |  |  |
| 5 #30 整定 |  |  |  |  | 详见 调参.md |  |
```

---

## 十二、一句话总结

> **先测磁力计（阶段 0），再改采样架构（阶段 1~2），再提频（阶段 3），再融合（阶段 4），最后统一调参（阶段 5）。**
>
> **一步一验，不跳步；每步都有回退。**
