Nyxarian/ApexFly-v2.0/优化一下/姿态链路优化备注（MPU6050-PID-电机）.md

# ApexFly V2.0 姿态链路优化备注（MPU6050 → PID → 电机）

> 整理时间：2026-09-08
> 分析对象：`F:\Zhuomian\ApexFly v2.0\ApexFly v2.0\`（STM32G474VCT6，Keil AC5 + CubeMX + FreeRTOS 10.3.1）
> 性质：**纯只读分析，未修改任何源码/工程配置**；本文件为对话内容的整理归档。
> 数据来源：黑匣子导出 `BlackboxReader/exports/`（截至 8/29）、源码亲核、git 未提交改动比对。
> 范围约束：只分析 V2.0 工程；不参考 V3.0 与遥控器工程。

---

## 目录

1. 背景：这轮要解决什么问题
2. 黑匣子数据：最新场次参数与参数演进时间线
3. 今天（9/8）与 8/29 的关键差异
4. R1 根因详解与修订版
5. 磁力计到底有没有进 PID
6. 全链路审计：MPU6050 → PID → 电机
7. 优化清单（P0/P1/P2）与验证方法
8. 待确认问题与下一步
9. 附录：代码位置索引与关键数字

---

## 1. 背景：这轮要解决什么问题

实机测试现象：**一起飞就炸机**——起飞瞬间震荡很大，并持续向一侧漂移（当天 5~6 级大风）。

本轮聚焦 **横滚 / 俯仰** 这两个由 MPU6050 直接支撑的通道（偏航另议），要求彻底审计：
MPU6050 底层六轴读取 → 零偏/水平零点校准 → 姿态解算 → 串级 PID → 混控 → 电机的**全部流程**，并找出可优化空间（任务调度、数据处理、算法实现）。

---

## 2. 黑匣子数据：最新场次参数与参数演进时间线

### 2.1 最新一次导出是哪批

| 项 | 值 |
|---|---|
| 导出目录 | `BlackboxReader/exports/blackbox_20260829_101042` |
| 导出时间 | 2026-08-29 10:22 |
| 场次数 | 13 场：`session_000` + `session_1738` ~ `session_1749` |
| 覆盖时间（北京时间） | 8/29 08:16 ~ 10:08 |
| 说明 | **黑匣子里没有 9/8（今天）的数据**，今天的测试尚未 dump |

### 2.2 最新一场（session_1749，8/29 10:07:35–10:08:13）完整 30 项参数

| id | 参数 | 值 | id | 参数 | 值 |
|---|---|---|---|---|---|
| 0 | roll_outer_kp | **1.80** | 15 | roll_max_rate_dps | 200.00 |
| 1 | roll_outer_ki | 0.00 | 16 | roll_max_corr_us | 200.00 |
| 2 | roll_outer_kd | 0.01 | 17 | pitch_max_rate_dps | 200.00 |
| 3 | roll_inner_kp | **1.30** | 18 | pitch_max_corr_us | 200.00 |
| 4 | roll_inner_ki | 0.00 | 19 | yaw_max_rate_dps | 200.00 |
| 5 | roll_inner_kd | 0.01 | 20 | yaw_max_corr_us | 200.00 |
| 6 | pitch_outer_kp | **1.80** | 21 | roll_trim_deg | 0.00 |
| 7 | pitch_outer_ki | 0.00 | 22 | pitch_trim_deg | 0.00 |
| 8 | pitch_outer_kd | 0.01 | 23 | yaw_angle_kp | **2.20** |
| 9 | pitch_inner_kp | **1.30** | 24 | yaw_angle_ki | 0.00 |
| 10 | pitch_inner_ki | 0.00 | 25 | yaw_angle_kd | 0.02 |
| 11 | pitch_inner_kd | 0.01 | 26 | vertical_speed_kp | 100.00 |
| 12 | yaw_rate_kp | **1.20** | 27 | vertical_speed_ki | 0.00 |
| 13 | yaw_rate_ki | 0.00 | 28 | vertical_speed_kd | 0.00 |
| 14 | yaw_rate_kd | 0.02 | 29 | hover_pwm_us | **1550** |

**注意**：高度那 4 项虽然写进表，但**定高并未启用**——8/29 全部场次的 `alt_cm / vz_cms / vz_corr_us / alt_state` 全为 0（GROUND_IDLE），与源码里硬编码 `altitude_cm = 0; vz_cms = 0;` 一致。

### 2.3 参数演进时间线（关键节点）

| 时间 | 场次 | roll/pitch 外环 | roll/pitch 内环 | yaw_rate | yaw_angle | 备注 |
|---|---|---|---|---|---|---|
| 8/23 12:18 | 1 / 16 / 164 | 0.30 / 0.00 | 0 / 0 | 0 | 0 | 只开横滚外环 P |
| 8/23 12:18 | 244 / 361 | 1.00 / 1.00 | 0 / 0 | 0 | 0 | 两轴外环都开，仍无内环 |
| 8/23 12:59 | 368~373 | 0~1.0 | 1.3~1.5 | 0 | 0 | 开始试探横滚内环 |
| 8/23 13:33 | 362~365 | 1.0~2.5 | 2.0 / 1.8 | 0 | 0 | 内环加到 2.0 后回落到 1.8 |
| 8/23 13:41 | 377 / 379 | 2.30 / 2.50 | 1.50 | 0 | 0 | 这就是"记忆中的 2.3/1.5"来源 |
| 8/23 18:28 | 1718 | 1.80 | 1.50 | 0.45 | 0 | 外环回落 1.8，yaw_rate 开始加 |
| 8/24 11:01 | 1466~1468 | 2.50 | 1.50 | 0 | 0 | 双轴 2.5/1.5 |
| 8/25 19:42 | 1722~1723 | 1.80 | 1.50 | 1.00 | 0 | 出现高度参数（vz_kp=100）、hover 1250→1350 |
| 8/25 20:18 | 1724~1725 | 1.80 | **1.30** | 1.00 | 0 | hover 1500→1550 |
| 8/26 15:22 | 1731~1734 | **1.80** | **1.30** | 1.00 | 0 | 定型；hover=1550 |
| 8/29 08:32~10:08 | 1738~1749 | 1.80 | 1.30 | 1.00→1.40→**1.20** | 0→1.80→**2.20** | 当天在调偏航环 |

### 2.4 8/29 当天偏航通道的调参轨迹

| 场次 | yaw_rate Kp/Kd | yaw_angle Kp/Kd |
|---|---|---|
| 1738 | 1.00 / 0.01 | 0（未开） |
| 1739 | 1.00 / 0.01 | 1.80 / 0.01 |
| 1740 | 0.70 / 0.01 | 1.50 / 0.01 |
| 1741 | 1.10 / 0.01 | 2.00 / 0.01 |
| 1742 | 1.30 / 0.01 | 2.20 / 0.01 |
| 1743–1744 | 1.30 / 0.02 | 2.20 / 0.02 |
| 1745 | 1.40 / 0.02 | 2.40 / 0.03 |
| 1746 | 1.40 / 0.02 | 2.25 / 0.03 |
| 1747 | 1.20 / 0.02 | 2.25 / 0.03 |
| 1748–1749 | **1.20 / 0.02** | **2.20 / 0.02** |

### 2.5 8/29 各场飞行强度（说明不是台架）

| 场次 | 油门范围 (us) | max\|roll\| | max\|pitch\| | max\|rrate\| | max\|prate\| | dt 中位 |
|---|---|---|---|---|---|---|
| 1738 | 1000–1544 | 21.6° | 18.3° | 272 | 246 | 10ms |
| 1739 | 1000–1511 | 7.3° | 8.5° | 115 | 94 | 10ms |
| 1740 | 1000–1533 | 5.5° | 9.5° | 95 | 71 | 10ms |
| 1741 | 1000–1517 | 5.6° | 7.5° | 113 | 70 | 10ms |
| 1742 | 1000–1517 | 12.9° | 30.1° | 132 | 126 | 10ms |
| 1743 | 1000–1550 | 18.1° | 9.1° | 203 | 195 | 10ms |
| 1744 | 1000–1467 | 29.5° | 21.4° | 204 | 190 | 10ms |
| 1745 | 1000–1467 | 10.1° | 9.3° | 186 | 265 | 10ms |
| 1746 | 1000–1478 | 25.1° | **48.2°** | 183 | **323** | 10ms |
| 1747 | 1000–1473 | 24.6° | 14.5° | 155 | 209 | 10ms |
| 1748 | 1000–1495 | 21.8° | 18.3° | **328** | 246 | 10ms |
| 1749 | 1000–1467 | 13.1° | 23.4° | 104 | 76 | 10ms |

结论：8/29 是真飞且有大姿态/高角速度（最大俯仰 48°、角速度峰值 328°/s），且**控制节拍中位数 10ms（健康）**。

---

## 3. 今天（9/8）与 8/29 的关键差异

### 3.1 用户确认的今天配置

- 横滚、俯仰：与 8/29 那套**一致**（外环 1.80 / 0.00 / 0.01，内环 1.30 / 0.00 / 0.01）
- **偏航没有设置参数**（yaw_rate / yaw_angle 未设 → 保持 0）
- 限幅一致（200 / 200 / 200）
- 油门上限一致（hover_pwm_us = 1550）

| 通道 | 8/29 最新场次 | 今天 | 差异 |
|---|---|---|---|
| roll 外环 | 1.80 / 0.00 / 0.01 | 同 | — |
| roll 内环 | 1.30 / 0.00 / 0.01 | 同 | — |
| pitch 外环 | 1.80 / 0.00 / 0.01 | 同 | — |
| pitch 内环 | 1.30 / 0.00 / 0.01 | 同 | — |
| **yaw_rate** | **1.20 / 0.00 / 0.02** | **0** | ⚠️ |
| **yaw_angle** | **2.20 / 0.00 / 0.02** | **0** | ⚠️ |
| 限幅 / Trim / hover | 200 / 0 / 1550 | 同 | — |

### 3.2 固件层面的新增变量（重要）

| 项 | 事实 |
|---|---|
| `motor_test.c` 最后修改 | **2026-09-03 17:17**（晚于 8/29 飞行数据） |
| 最近一次编译 | **2026-09-08 18:17**（只重编 `motor_test.o`，其余 .o 仍是 8/29 08:00 的） |
| `git diff` 显示 8/29 以来的唯一源码改动 | **新增了一行每拍阻塞打印**（+`#include "debug.h"`，共 8 行） |
| 该打印代码 | `motor_test.c:236` `Debug_Printf("[IMU] accel_g=%.3f,... gyro_dps=%.1f,... hz=%.0f\r\n", ...)` |

**含义**：
- 8/29 飞行时**没有**这行打印 → `t_ms` 中位数 10ms（节拍健康）；
- 今天若烧的是 9/8 编译的固件 → 控制环每拍多约 **6ms** 阻塞串口发送（70 字节 @115200），真实节拍预计 ~16–17ms 且抖动；
- 所以"参数一样，环路行为不一样"。

---

## 4. R1 根因详解与修订版

> R1 在《ApexFly V2.0 悬停稳定性分析与定高定点返航实施方案.md》中的原始定义：
> "实际增益配置 = 纯 P 角度环、无阻尼内环、无偏航控制 → 系统欠阻尼/低刚度，大风下姿态发散"（★★★★★）

### 4.1 原始论据（基于 8/23 及更早数据）

- 编译默认 `kDefaultPidParams` 六组增益**全为 0**；
- 黑匣子 8/23 的 5 个场次：内环全 0、外环 Kp 0.3/1.0、无 Ki/Kd、偏航全 0；
- `attitude_control.c` 有"内环全 0 时外环输出直通当微秒用"的旁路（`AttitudeControl_InnerEnabled`）。

**该论据对 8/23 及更早成立；对 8/29 之后（内环已开 1.30）不成立。**

### 4.2 修订版 R1'：今天这套配置下，仍然成立的四个机制

#### 论据 1（仍成立）：横滚/俯仰 **Ki = 0 → 没有积分，抗风静差消不掉**

大风的本质是**方向恒定的持续推力**。只有 P（加少量 Kd）时，对抗常值力矩必然留下**稳态倾角**（风把机体吹到某个角度，该角度产生的差速刚好抵消风矩）。这个倾角消不掉，而倾角一存在，推力就有水平分量 → 飞机持续朝一个方向加速 → **单向漂移**。
8/29 实测佐证：即便内环已开，阵风下姿态峰值仍到 48°、角速度峰值 328°/s。

#### 论据 2（新，最关键）：**偏航参数为 0 → 偏航完全无控，且存在"杆量直通"隐藏路径**

代码位置 `attitude_control.c:126-170`：

```c
if (stick_deflected)                       // |yaw_stick| > 80
{
    rate_limit_dps = yaw_cascade.outer.out_max;          // = 200（限幅参数）
    stick_rate_dps = (yaw_stick / 1000.0f) * rate_limit_dps;   // 最大 ±200
    yaw_cascade.inner_setpoint = stick_rate_dps;
    if (AttitudeControl_InnerEnabled(&yaw_cascade))
        inner_out = CascadePid_UpdateInner(...);          // 正常：PID 输出
    else
        inner_out = stick_rate_dps;                       // ← 内环为 0 时：杆量数值直接当微秒
    return inner_out;
}
```

即：**yaw_rate 的 Kp/Ki/Kd 全为 0 时，偏航杆量被直接当作混控修正微秒打进混控**，满杆 = **±200us** 的偏航差速（两个电机 +200、两个 −200），足以瞬间把机头拧起来并造成推力严重失衡。

| 触发场景 | 后果 | 如何确认 |
|---|---|---|
| 飞行中手碰偏航杆（含手抖） | 瞬时大偏航差速 → 急转/翻滚 | 黑匣子 `yaw_corr` 列是否出现非 0 大值 |
| **遥控器偏航通道中位未对准**（读数超出 ±80 死区，例如中位 100） | 持续输出约 ±20us 偏航差速 → **缓慢持续自旋**；且每拍 `Pid_Reset` + `yaw_hold_valid=false`，**航向锁定永久失效** | 解锁后松杆，看串口/黑匣子里偏航杆量是否为 0 |
| 遥控器摇杆标定偏差 | 同上，姿态环持续"追"旋转中的机体 | 同上 |

#### 论据 3（仍成立）：偏航无阻尼 → 机头自由转 → 横滚/俯仰被持续激励

即使偏航杆在中位（yaw_corr=0），偏航通道也是空转的：四电机反扭矩不平衡无人管，风一吹就"风标效应"转向。机头一转，横滚/俯仰环的"水平"在惯性系里就在变，等于给一个阻尼偏弱的系统持续注入新扰动 → 表现为震荡。
8/29 场次 1738 当时至少还有 `yaw_rate = 1.0` 的阻尼；今天连这个都没有。

#### 论据 4（新）：节拍恶化（今天固件多了 6ms/拍打印）

对"阻尼偏弱 + 无积分"的系统，等效相位延迟增加会把"能收敛"变成"来回摆"。可用今天黑匣子的 `t_ms` 直接证实或排除。

### 4.3 当前需要回填的确认项

1. 今天参数是遥控**逐项 SET** 还是 **LOAD_SAVED**？（决定偏航是 0 还是 8/29 保存的 1.2/2.2）
2. 今天设完**有没有 SAVE**？（没 SAVE 则重新上电回到全 0）
3. **炸机形态**：油门刚推上去还没离地就侧翻？还是离地后先飘/先摆再发散？
4. 遥控**偏航杆中位读数**是否为 0；
5. **今天黑匣子 dump**（最重要）：场次头参数、`t_ms` 分布、`yaw_corr` 是否有非 0 大值、解锁后前 2 秒的姿态/角速度/四路 PWM。

---

## 5. 磁力计到底有没有进 PID

### 5.1 三层对照

| 层次 | 是否接入 | 证据 |
|---|---|---|
| 硬件 + 驱动 | ✅ 已接入 | `magTask` 50Hz 读 GY-273（I2C2）、芯片系→机体系、一阶低通（~2.5Hz）、硬铁校准，写 `mag_snapshot` |
| 姿态解算（Mahony） | ❌ **没进** | `imu_attitude.c` 只用加速度 + 陀螺；yaw 是**相对积分**会漂移。黑匣子/遥测里的 `yaw` 列就是它，不是磁航向 |
| 控制环（PID） | ⚠️ **只进偏航角度外环** | 横滚/俯仰完全不用磁力计 |

### 5.2 唯一一条进入 PID 的路径

```
mag.c 50Hz ──> mag_snapshot{ body_heading_deg / cal_heading_deg / calibration_valid }
                    │
motor_test.c:292  MotorTest_MagHeadingCdeg(&mag_calibration_valid)
                    │
motor_test.c:308  AttitudeControl_Update(..., mag_heading_deg, mag_heading_valid, yaw_stick, ...)
                    │
attitude_control.c:226  yaw_correction_us = AttitudeControl_UpdateYaw(...)
                    │
attitude_control.c:160  heading_error = Wrap180(磁航向 − 松杆时刻锁定的目标航向)
                    │
                    yaw 角度外环 → yaw_rate 内环 → 混控修正 us
```

横滚/俯仰的目标角来自遥控杆量 + Trim（`attitude_control.c:221-225`），**与磁力计无关**。

### 5.3 磁航向真正生效的四个前提（缺一即失效）

| # | 条件 | 代码位置 |
|---|---|---|
| 1 | `yaw_angle` 的 Kp/Ki/Kd 至少一个非 0 | `attitude_control.c:161` |
| 2 | `mag.valid == true` | `motor_test.c:97` |
| 3 | **硬铁校准已完成**（≥100 样本、每轴跨度 ≥0.25Ga）或从 Flash `0x002000` 加载成功 | `mag.c:287-293`、`mag.c:321-348` |
| 4 | \|roll\| < 25° 且 \|pitch\| < 25° | `attitude_control.c:136` |

### 5.4 今天的实际状态

1. yaw_angle = 0 → 磁航向**不进 PID**；
2. yaw_rate = 0 → **无角速度阻尼**；
3. IMU 的 yaw 也不进 PID（仅用于记录/遥测）。

→ **今天机头方向完全开环**：既无磁航向锁定，也无偏航阻尼。风里会被"风标效应"带走，机头一转，机体坐标系里的风攻角就变，横滚/俯仰环被迫持续追变化的目标——这是"震荡 + 漂移"里容易被忽略的激励源。

### 5.5 磁力计当前的非控制用途

- 黑匣子 `target_vz_cms` 列记录磁航向（导出 CSV 里叫 `mag_hdg`）；
- 遥测 `home_distance_m` 槽位发磁航向给遥控显示（字段名历史遗留）；
- 串口 `[MAG]` 日志（10Hz）。

### 5.6 如果要把磁航向用起来（台架顺序）

1. **确认校准状态**：看串口 `[MAG] ... cal=1 ... calmag≈0.25~0.65 ... calhdg=xxx`；`cal=0` 先做硬铁校准并存 Flash；
2. **先设 yaw_rate 阻尼**（如 1.0~1.4 / Kd 0.02），台架手拨机体看阻尼方向；
3. **再设小 yaw_angle Kp**（8/29 落在 2.2），手转机体验证修正反向；
4. **重点验磁干扰**：拆桨把油门推到悬停附近，看 `calhdg` 是否随油门抖动——电机电流/线束磁场是四轴磁力计的经典杀手；若大油门时航向跳几十度，宁可不启用 yaw_angle。

---

## 6. 全链路审计：MPU6050 → PID → 电机

### 6.0 三个"硬约束级"发现（比调 PID 更重要）

#### 发现 1：控制环名义 100Hz，但**电机实际每 20ms 才收到一次新脉宽**

证据链：
- `tim.c:100-102`：TIM8 `Prescaler=169`、`Period=19999` → 1MHz 计数、**周期 20ms（50Hz）**；
- **关键**：`stm32g4xx_hal_tim.c:4358` —— HAL 在 PWM 模式下自动置 `TIM_CCMR1_OC1PE`（输出比较**预装载**）；
- 因此 `__HAL_TIM_SET_COMPARE()` 写入 CCR 的值，要等**下一个更新事件（20ms 后）**才装载到影子寄存器；
- 结果：控制环 10ms 算一次写一次，但电机看到的脉宽**每 20ms 变一次**，平均延迟 10ms、最坏 20ms。

**后果**：姿态环相位裕度被这一项吃掉一大半；闭环带宽被 50Hz 更新率限制在几 Hz，大风抗扰能力上不去。

**优化**：TIM8 改 **400Hz**（Period=2500 @1MHz，分辨率仍 1us），延迟 10ms→1.25ms；或用电调支持的 OneShot125/DShot。**需先确认电调支持 400Hz**。

#### 发现 2：今天固件控制环每拍被串口打印阻塞 ~6ms

`motor_test.c:236`（9/3 新增、9/8 编译进固件）：每拍 `Debug_Printf` 一行 ~70 字节 @115200 ≈ 6ms 阻塞，且发生在姿态解算**之前**。
- 8/29（无此行）：`t_ms` 中位数 10ms；
- 今天（有此行）：理论周期 10.5+6 ≈ 16.5ms 且抖动。

#### 发现 3：混控之后又强制每路 ≥1050us，破坏差速平衡

`mixer.c` 已做正确的饱和保护（`Mixer_UpdateScale` 按四路中最先撞限的一路统一缩放修正，保证力矩方向不变形），但 `motor_test.c:58-61` 的 `MotorTest_ApplyMixer()` 又**逐路硬抬到 1050us**：

```c
if (output->motor_1_us < 1050) output->motor_1_us = 1050;   // 四路都这样
```

一旦某一路本该 950us 被抬到 1050 → 四路差速关系被破坏、力矩方向被扭曲。且混控下限（1000us）与此处（1050us）不一致。
**正确做法**：把"最低有效油门"作为统一参数传进 `Mixer_Calculate()`，参与 `correction_scale` 计算，而不是事后逐路裁剪。

### 6.1 A. 任务调度层

| 环节 | 现状 | 问题 | 优化空间 |
|---|---|---|---|
| 控制任务优先级 | `motorTestTask = osPriorityNormal(24)` | **低于 `radioTask(25)`**；radio 的 SPI 收发 + Busy 忙等（`ra01sc.c` 单次最多 200ms 忙等）会抢占控制环 | 控制任务提到最高（或至少高于 radio）；radio 降为普通任务 + 中断驱动 |
| 周期基准 | `osDelay(10)`（循环末尾） | **漂移累积**：周期 = 计算时间 + 10ms，永远偏大（实测 11ms 主峰、19ms 尖峰） | 改 `vTaskDelayUntil()` 固定相位 |
| dt 精度 | `osKernelGetTickCount()` 差 × 0.001f | tick 1ms → dt=10ms 时**量化误差 10%**，直接影响积分/微分 | 用 DWT->CYCCNT 或 TIM 微秒计数 |
| 时基一致性 | 姿态时间戳 `HAL_GetTick()`（TIM6），控制用 `osKernelGetTickCount()`（SysTick） | 两套时基混用 | 统一到微秒时基 |
| 控制频率 | 100Hz | 对四轴偏低（现代 250–1000Hz） | 解决 I2C 开销后提到 250–500Hz |
| I2C 超时 | `MPU6050_I2C_TIMEOUT_MS = 20ms` | **超时比控制周期长**：一次异常 → 控制停摆 2 拍以上 | 降到 1–2ms；出错只丢本拍并计数（不整机重初始化） |
| IMU 中断 | `IMU_INT=PB0/EXTI0` 已配优先级 6，但 `HAL_GPIO_EXTI_Callback()` **明确忽略它**（`radio.c:344-353`） | 浪费 Data-Ready 中断，采样靠盲等 | 用 EXTI0 触发采样（任务通知），采样与芯片同步 |
| 栈/堆 | 控制任务 2560B、heap 30KB、栈溢出检测 level 2 | 无明显问题 | 保持 |

### 6.2 B. 传感器数据层（MPU6050）

| 环节 | 现状 | 问题 | 优化空间 |
|---|---|---|---|
| 量程 | 陀螺 ±2000dps（16.4 LSB/dps）、加计 ±8g（4096 LSB/g） | 实际角速度 <500dps，大量程 = 更大噪声 + 更低分辨率 | 陀螺改 ±500dps（65.5 LSB/dps，噪声约降 4 倍）、加计改 ±4g；注意抗冲击余量 |
| DLPF | `CONFIG=0x03` → 陀螺 42Hz / 加计 44Hz，延迟 **4.9ms** | 延迟大；若控制环提到 500Hz，42Hz 带宽成瓶颈 | 频率提高后改 98Hz/188Hz，权衡噪声与延迟 |
| 采样率 | `SMPLRT_DIV=0` → 内部 1kHz | 以 100Hz 读 = 抽点，且**不检查 Data-Ready** | 保留 1kHz，改由 DRDY 中断触发读取 |
| 读取原子性 | 一次连续读 14 字节（~0.4ms @400kHz） | 内部 1ms 更新 → 约 40% 概率**跨更新边界**，accel 与 gyro 差最多 1ms | 读前查 `INT_STATUS.DATA_RDY`，或启用 FIFO 批量读 |
| 温度 | 读了 `temperature_c` 但**从未使用** | 陀螺零偏温漂典型 ±0.05°/s/℃；自热 10–20℃ → 漂移 0.5–1°/s | 温度-零偏一阶补偿（需标定），或静止自适应零偏 |
| 加计校准 | **没有做**（只有"水平零点"） | 加计零偏几十 mg → 静态姿态误差 1–2°，且随姿态变化 | 六面法标定零偏+尺度，存 Flash |
| 陀螺零偏采集 | 上电 200 拍（2s）平均，**无静止检测、无方差检查、无温度稳定等待** | 开机 2s 内芯片自热未稳；有振动/风吹则零偏带误差 | 延长到 5–10s；加"陀螺方差 < 阈值 + 加计模长≈1g"双重门禁 |
| 水平零点采集 | 静置 200 拍取 roll/pitch 平均后**直接相减**（`imu_level.c`） | ① 同时吸收安装倾角与姿态估计静态误差；② **若采集时机体不在真实水平（起落架不平/斜面），就变成永久目标角偏置 → 固定倾角飞行 → 单向漂移**；③ 无水平性/方差检查；④ 只存 RAM，每次开机重采 → 每次飞行不一致 | 改为"用加计重力方向标定安装倾角 + 加计零偏"并**存 Flash**；采集准入条件用"加计模长≈1g + gyro 静止 + 倾角变化 < 阈值"；台架用水平仪交叉验证 |
| I2C 速率 | ✅ 2026-09-10 已改为 400kHz（`Timing=0x40621236`）；旧值 `0x40B285C2` 实测仅约 98.8kHz（不是 400kHz） | 旧：14B 读 ≈1.6ms，占 10ms 周期 16%；新：实测 ≈405µs，占 4.1% | 已完成（DMA 方案已跳过） |

### 6.3 C. 姿态解算层（Mahony）

| 环节 | 现状 | 问题 | 优化空间 |
|---|---|---|---|
| 积分方法 | **一阶欧拉**：`q += 0.5*q⊗ω*dt` | dt=10ms、ω=300°/s 时每拍转 3°，误差随 ω²dt 增长；dt 抖动时不稳定 | 改**中值积分**（ω_prev 与 ω_now 平均）或四元数指数映射，代价极小、精度显著提升 |
| 加速度门限 | `0.8g ~ 1.2g` 才用重力修正 | **太宽**：机动/加速时"比力 ≠ 重力"，0.8–1.2g 内仍会用错误重力方向把姿态拉偏 | 收紧到 0.95–1.05g，或改用加速度变化率/方差门控 + 机动时降低 Kp |
| 加速度滤波 | 只有芯片 DLPF 44Hz，**无软件低通** | 电机振动（100–300Hz 及谐波）残留直接进重力修正 → 姿态角抖动 | 加二阶低通（20–30Hz）或对重力误差项滑动平均 |
| Kp/Ki | Kp=0.8、Ki=0.03/s、积分限幅 ±0.2rad/s | 数值合理，但**按 100Hz 手调**；改频率/滤波后必须重算 | 频率提升后重新整定 |
| dt 限幅 | `[5ms, 30ms]`，越界返回 false | 返回 false 时上层 `continue` **跳过本拍控制**（姿态不更新、电机保持旧值） | 丢拍时用陀螺外推姿态，而不是不控制 |
| 初始化 | 首拍用加速度算 roll/pitch 置初值 | 首拍有振动/机动则初值偏 | 用零偏采集期间的平均加速度作初值 |
| yaw | 无磁观测，纯积分漂移 | （暂不讨论，仅记录） | 后续接磁航向或 GPS course |

### 6.4 D. 控制算法层（串级 PID）

| 环节 | 现状 | 问题 | 优化空间 |
|---|---|---|---|
| 结构 | 外环角度→目标角速度，内环角速度→us | 设计正确 | 保持 |
| 内环旁路 | **内环 Kp/Ki/Kd 全 0 时外环输出直通当 us**（`attitude_control.c:70-73,117-121`） | 危险后门：参数丢失时静默退化为"无阻尼角度环"（8/23 及之前正是此状态） | 加"内环未启用 → 拒绝解锁/告警"门禁，或删除旁路 |
| 微分项 | `deriv = (error - last_error)/dt`，**作用在误差上**，无低通 | ① 打杆/Trim 变化 → **微分冲击**；② 陀螺噪声被 Kd 放大 | 改为对**测量**微分 + 一阶低通 |
| 积分限幅 | `i_limit` 被 SET 时**设成与 out_max 相同（200）** | 积分项可独占整个输出 → windup，退出饱和后过冲 | i_limit 设为 out_max 的 20–30%；加 **anti-windup**（饱和时冻结积分） |
| 输出限幅 | 三轴修正 ±200us，与基础油门无关 | 低油门（1100us）时 200us 相对过大，靠混控 scale 兜底；而 `MotorTest_ApplyMixer` 的 1050 下限又破坏 scale（发现 3） | 让"最低有效油门"进混控统一计算；或按油门比例限制修正 |
| 目标角速率限制 | 杆量直接映射目标角（满杆 10°），无斜率限制 | 杆量跳变 → 目标角跳变 → 误差跳变 → 冲击 | 加目标角一阶滤波/速率限制 |
| 限幅语义 | `..._MAX_RATE_DPS` 同时当外环 out_max 和 i_limit；`..._MAX_CORRECTION_US` 同理 | 语义耦合，调参易误伤 | 拆成独立参数 |
| dt 使用 | `control_dt_s` 被限幅到 [5ms, 30ms] | 与真实周期不一致时积分有偏 | 用微秒真实 dt，只做异常保护 |
| 电压补偿 | 无 | 12.6V→11.0V 时同脉宽推力降约 10% → 悬停漂移 | 用 `battery.c` 电压做一阶推力补偿 |

### 6.5 E. 输出层（PWM / 电调）

| 环节 | 现状 | 问题 | 优化空间 |
|---|---|---|---|
| PWM 频率 | 50Hz（20ms），CCR **预装载** | 有效更新率 50Hz、平均延迟 10ms（发现 1） | 提到 400Hz（延迟 1.25ms）；需电调支持 |
| 通道映射 | M1→CH1(PC6) … M4→CH4(PC9) | 与混控约定一致 | 保持 |
| 脉宽范围 | 1000–2000us，锁定 1000us | 电调实际起转点可能在 1050–1100us 且四路不一致 | 台架测四路起转点，写入各自死区补偿 |
| 混控下限 | 混控 1000 + 事后 1050 双重下限 | 破坏差速（发现 3） | 统一进 `Mixer_Calculate` |
| 输出平滑 | 无 | 修正突跳直接进电机 | 可选：修正量一阶低通（谨慎，会增加延迟） |

### 6.6 延迟链估算（对姿态环相位滞后）

| 环节 | 延迟 |
|---|---|
| MPU6050 DLPF（CONFIG=3） | 约 4.9ms |
| I2C 读 14 字节 @400kHz（2026-09-10 之后才真正是 400kHz） | 实测 405µs（此前旧值约 1.6ms） |
| 任务调度抖动 | 0–1ms（tick 粒度）+ 被 radio 抢占 |
| 姿态解算 + 控制计算 | <0.1ms（硬件 FPU） |
| **PWM 预装载等待** | **0–20ms（平均 10ms）** ← 最大项 |
| 电机 + 螺旋桨响应 | 20–50ms（物理一阶时间常数） |
| **合计** | **约 35–75ms** |

→ 这解释了为什么"姿态环带宽只能做到几 Hz"：相位滞后主要来自 PWM 更新与执行机构，而不是 PID 本身。

### 6.7 附带澄清：FPU 上下文不是问题

审计中一度怀疑 `FreeRTOSConfig.h` 的 `configENABLE_FPU 0` 与工程 `<Cpu>...FPU2</Cpu>` + map 中 `__hardfp_*`（硬件浮点）冲突。核实结论：

- `Middlewares/.../portable/RVDS/ARM_CM4F/port.c:36-38` 强制要求 `__TARGET_FPU_VFP`（即必须启用硬件浮点）；
- `xPortStartScheduler()` 调用 `prvEnableVFP()` 使能 CPACR；
- `xPortPendSVHandler()` 中 `tst r14,#0x10` → 任务使用 FPU 时 `vstm/vldm {s16-s31}` 保存/恢复高 16 个 FPU 寄存器；S0–S15/FPSCR 由硬件 lazy stacking 处理；
- 该 port.c 版本**未引用** `configENABLE_FPU`，所以该宏为 0 不影响 FPU 上下文保存。

→ **结论：FPU 上下文保存是正确实现的，不是 BUG**（此项可排除）。

---

## 7. 优化清单（P0/P1/P2）与验证方法

### P0（纯工程修复，不改算法，收益最大）

| # | 优化 | 预期收益 | 风险 | 验证方法 |
|---|---|---|---|---|
| 1 | 删掉控制环内每拍 `Debug_Printf` | 周期 16.5→10.5ms，抖动消失 | 无 | 黑匣子 `t_ms` 直方图（应 10ms 主峰） |
| 2 | TIM8 50Hz → **400Hz** | 电机更新延迟 10ms→1.25ms，相位裕度大幅改善 | 电调兼容性（需确认） | 示波器测 PWM 周期；台架看修正响应 |
| 3 | 混控下限统一（去掉 `ApplyMixer` 的 1050 硬抬） | 力矩方向不再被扭曲 | 需确认最低有效油门 | 台架大修正时看四路差速比例 |
| 4 | 控制任务优先级最高 + `vTaskDelayUntil` | 抖动降低、周期稳定 | 低优先级任务可能饿 | 黑匣子 dt 分布变窄 |
| 5 | dt 改用 DWT 微秒计时 | 积分/微分量化误差 10%→<0.1% | 无 | 打印实测 dt 对比 |
| 6 | I2C 超时 20ms→2ms，单错只丢拍 | 消除"总线异常导致控制停摆" | 无 | 人为制造 I2C 错误观察恢复 |

### P1（校准与数据质量，直接关系"漂移"）

| # | 优化 | 预期收益 | 风险 |
|---|---|---|---|
| 7 | 水平零点改为"加计重力方向标定安装倾角 + 加计零偏"，加静止/水平性门禁，存 Flash | 消除"固定倾角 → 单向漂移"的软件根源；每次飞行一致 | 需一次台架标定流程 |
| 8 | 陀螺零偏采集 2s→5–10s + 静止/方差门禁 | 零偏更准，尤其冷机起飞 | 起飞准备时间变长 |
| 9 | 加计加软件低通（20–30Hz）+ 门限收紧到 0.95–1.05g | 姿态抖动下降，机动时不被错误重力拉偏 | 引入 5–10ms 延迟，需权衡 |
| 10 | 陀螺量程 ±2000→±500dps（加计 ±8g→±4g） | 噪声约降 4 倍、分辨率提高 | 需确认不饱和 |

### P2（算法增强，需重新整定 PID）

| # | 优化 | 预期收益 | 风险 |
|---|---|---|---|
| 11 | 控制频率 100Hz → 250–500Hz（配 I2C DMA + DRDY 中断） | 采样延迟降低、阻尼带宽提升，抗风能力质变 | 改动大，PID 必须重调 |
| 12 | 欧拉积分 → 中值积分 | 大角速度下姿态精度提升 | 极小 |
| 13 | D 项改为对测量微分 + 低通 | 消除打杆冲击、抑制噪声 | 需重调 Kd |
| 14 | anti-windup + i_limit 降到 out_max 的 20–30% | 消除积分风车与过冲 | 需重调 Ki |
| 15 | 目标角速率限制 | 打杆更顺、减少冲击 | 手感变化 |

> **重要提醒**：只要改动了 PWM 频率、控制频率或滤波环节，现有 PID 参数（1.80 / 1.30）**必须重新整定**——被控对象相位特性变了，旧参数不再是稳定点。

---

## 8. 待确认问题与下一步

### 8.1 需要确认（按信息量排序）

1. 电调型号是否支持 **400Hz PWM**（决定优化 #2，最大单点收益）；
2. 今天黑匣子的 `t_ms` 分布（验证发现 2）；
3. 台架测四路电调**实际起转点脉宽**（决定 #3 与下限值）；
4. 今天参数是 SET 还是 LOAD_SAVED、有没有 SAVE；
5. 今天炸机形态（未离地侧翻 / 离地后发散）；
6. 遥控偏航杆中位读数；
7. 电池电压范围（决定是否值得做电压补偿）。

### 8.2 建议的推进顺序

1. **先做 P0 的 1、4、5、6**（纯软件、无硬件依赖、不改控制律）→ 用黑匣子对比改造前后 dt 分布与姿态噪声；
2. 同时台架确认电调 400Hz 能力 → 能做就上 #2；
3. 再做 P1 的校准流程改造（#7、#8）——这是消除"单向漂移"的关键；
4. 最后动 P2，且每次只改一项、每次重新整定并归档 pid.csv。

---

## 9. 附录：代码位置索引与关键数字

### 9.1 关键代码位置

| 主题 | 文件:行 |
|---|---|
| 控制任务主循环 / 每拍打印 | `Modules/Motor/motor_test.c:127-357`（打印在 :236） |
| 混控后强制 1050us | `Modules/Motor/motor_test.c:55-66`（:58-61） |
| 零偏/水平采集与顺序 | `Modules/Motor/motor_test.c:194-263` |
| 解锁判定与姿态环调用 | `Modules/Motor/motor_test.c:274-323`（:308） |
| 内环旁路判据 | `Modules/Control/attitude_control.c:70-73`、:117-121 |
| 偏航环（含杆量直通） | `Modules/Control/attitude_control.c:126-170` |
| 姿态环入口 | `Modules/Control/attitude_control.c:209-232` |
| PID 公式（D 作用于误差） | `Modules/Control/pid.c:44-109` |
| 混控公式与统一缩放 | `Modules/Control/mixer.c:76-154` |
| Mahony 解算 | `Modules/IMU/imu_attitude.c:144-229` |
| 加速度门限 | `Modules/IMU/imu_attitude.c:19-20` |
| 陀螺零偏采集 | `Modules/IMU/imu_bias.c:32-55` |
| 水平零点采集/应用 | `Modules/IMU/imu_level.c:34-69` |
| MPU6050 配置（量程/DLPF/采样率/中断） | `Modules/IMU/mpu6050.c:195-247` |
| MPU6050 读取与换算 | `Modules/IMU/mpu6050.c:258-354` |
| TIM8 时基与 PWM | `Core/Src/tim.c:99-145` |
| HAL 比较寄存器预装载 | `Drivers/STM32G4xx_HAL_Driver/Src/stm32g4xx_hal_tim.c:4358` |
| 任务创建与优先级 | `Core/Src/app_freertos.c:66-135,199-228` |
| 中断处理 | `Core/Src/stm32g4xx_it.c:167-232` |
| 中断优先级 | `Core/Src/gpio.c:111-115`、`Core/Src/usart.c:174-175`、`Core/Src/dma.c:48` |
| FPU 端口处理 | `Middlewares/Third_Party/FreeRTOS/Source/portable/RVDS/ARM_CM4F/port.c:36-38,281-294,439-494` |

### 9.2 关键数字速查

| 项 | 值 |
|---|---|
| MCU / 主频 | STM32G474VCT6 / 170MHz（HSE 8MHz，PLL M2 N85 R2） |
| FreeRTOS | 10.3.1，tick 1000Hz，heap 30KB，栈溢出检测 level 2 |
| 控制任务 | `motorTestTask`，优先级 Normal(24)，栈 2560B，名义 100Hz（`osDelay(10)`） |
| 实测节拍 | 8/29：`t_ms` 中位 **10ms**；8/23 旧固件：11ms 主峰 + 19ms 尖峰 |
| MPU6050 | I2C1 0x68，陀螺 ±2000dps(16.4 LSB/dps)，加计 ±8g(4096 LSB/g)，DLPF=3（42/44Hz），内部 1kHz |
| 姿态解算 | Mahony 六轴，Kp=0.8，Ki=0.03/s，积分限幅 ±0.2rad/s，dt 限幅 [5,30]ms |
| 加速度门限 | 0.8–1.2g |
| 零偏 / 水平零点 | 各 200 拍（约 2s），水平零点仅 RAM |
| 姿态 PID（今天） | 外环 1.80/0.00/0.01，内环 1.30/0.00/0.01，限幅 200，Trim 0 |
| 偏航 PID（今天） | 全部 0（未设） |
| 混控 | `M1=-R+P-Y, M2=-R-P+Y, M3=+R+P+Y, M4=+R-P-Y`，修正统一缩放 |
| 电调 PWM | TIM8 50Hz（20ms），1MHz 计数，1000–2000us，CCR **预装载** |
| 电机映射 | M1 后右 PC6/CH1 CW，M2 前右 PC7/CH2 CCW，M3 后左 PC8/CH3 CCW，M4 前左 PC9/CH4 CW |
| 调试串口 | USART3 115200-8N1，阻塞发送，单次超时 100ms |
| 链路 | LoRa 433.92MHz SF7 BW125 CR4/5 +10dBm，控制帧 19B ≈ 51.5ms 空中时间 |
| 内存占用 | ROM ≈ 79.3KB / 256KB，RAM ≈ 39.7KB / 128KB |

### 9.3 相关文档

- 全量分析方案书：`ApexFly v2.0\ApexFly V2.0 悬停稳定性分析与定高定点返航实施方案.md`
- 黑匣子导出索引：`BlackboxReader\exports\keep_v2\INDEX.md`（8/23 批次的场次说明）
- 最新导出：`BlackboxReader\exports\blackbox_20260829_101042\`（含 `INDEX.txt` 与各场次 `.pid.csv`）

---

*本备注为只读分析的整理归档，未对任何源码/工程配置做修改。所有"优化"均为方案，实施前需按"方案 → 确认 → 执行"流程逐项进行。*
