Nyxarian/ApexFly-v2.0/BlackboxDump/README.md

# 已停用

这个 Python 窗口工具已经删除，不要再用。

请改用：

F:\Zhuomian\ApexFly v2.0\BlackboxReader\

双击那里的 run.bat。

本目录 exports\ 里是停用前导出的场次备份，只作存档。
