Nyxarian/ApexFly-v2.0/docs/diagrams/blackbox-logs.png

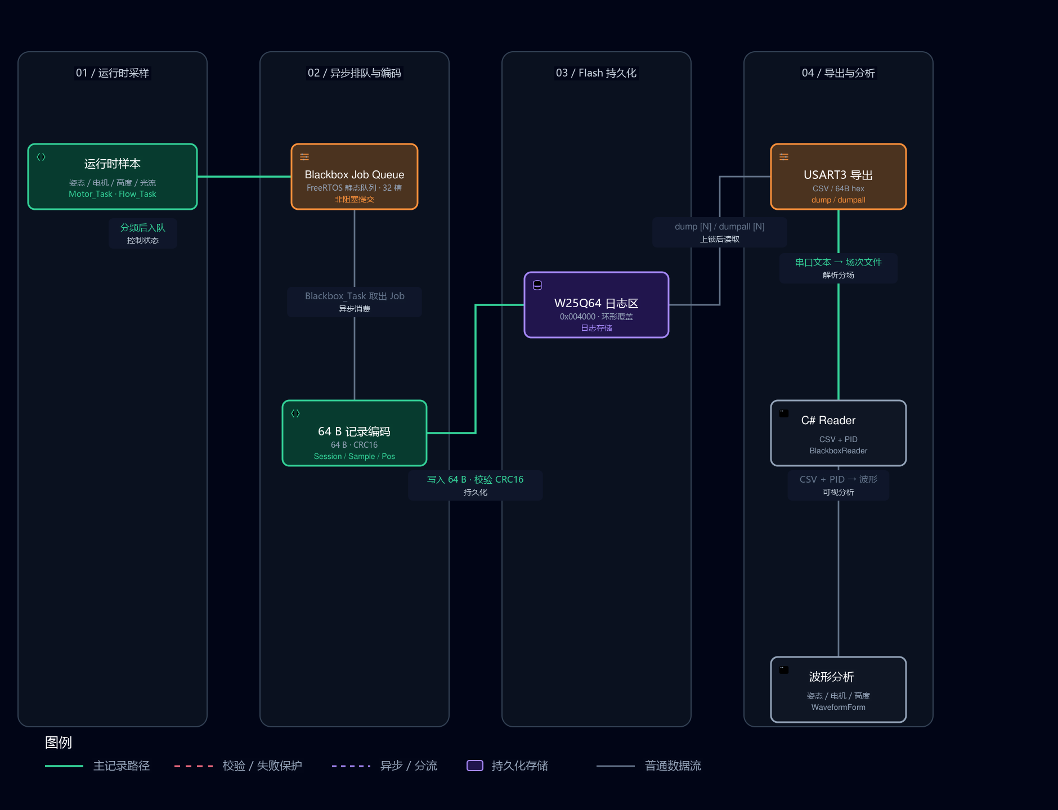
docs/diagrams/blackbox-logs.png
