Nyxarian/ApexFly-v2.0/docs/diagrams/lifecycle-flight-safety.png

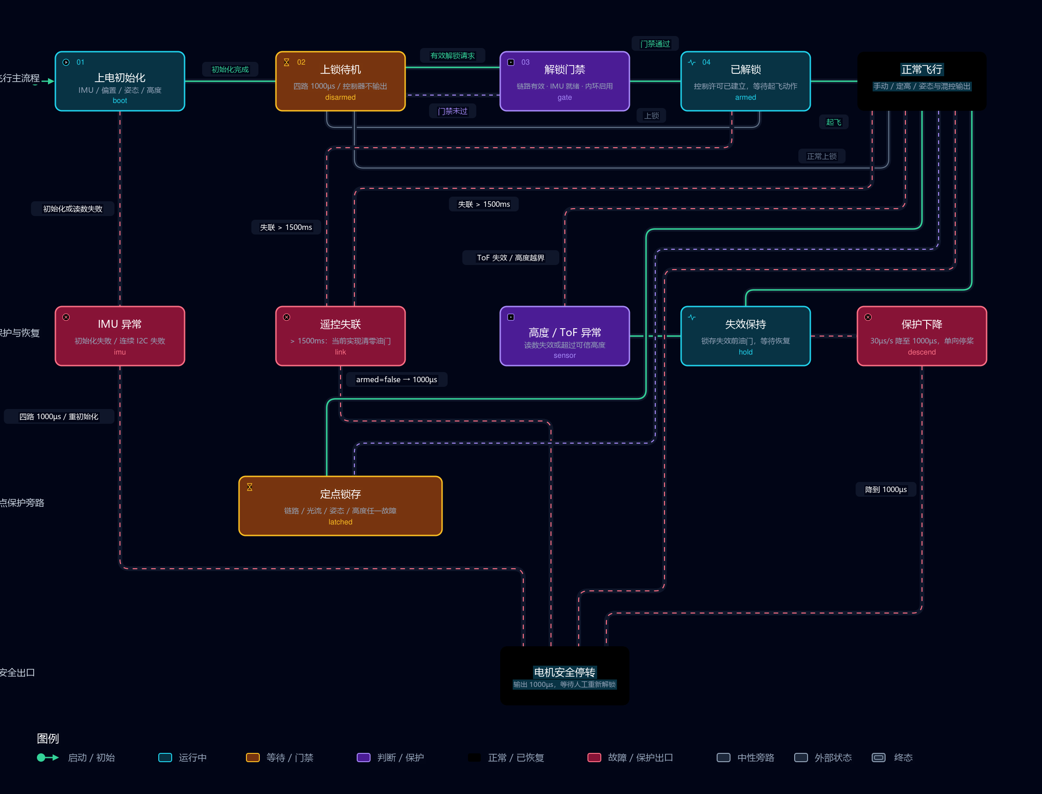
docs/diagrams/lifecycle-flight-safety.png
