Nyxarian/ApexFly-v2.0/docs/diagrams/lora-communication.png

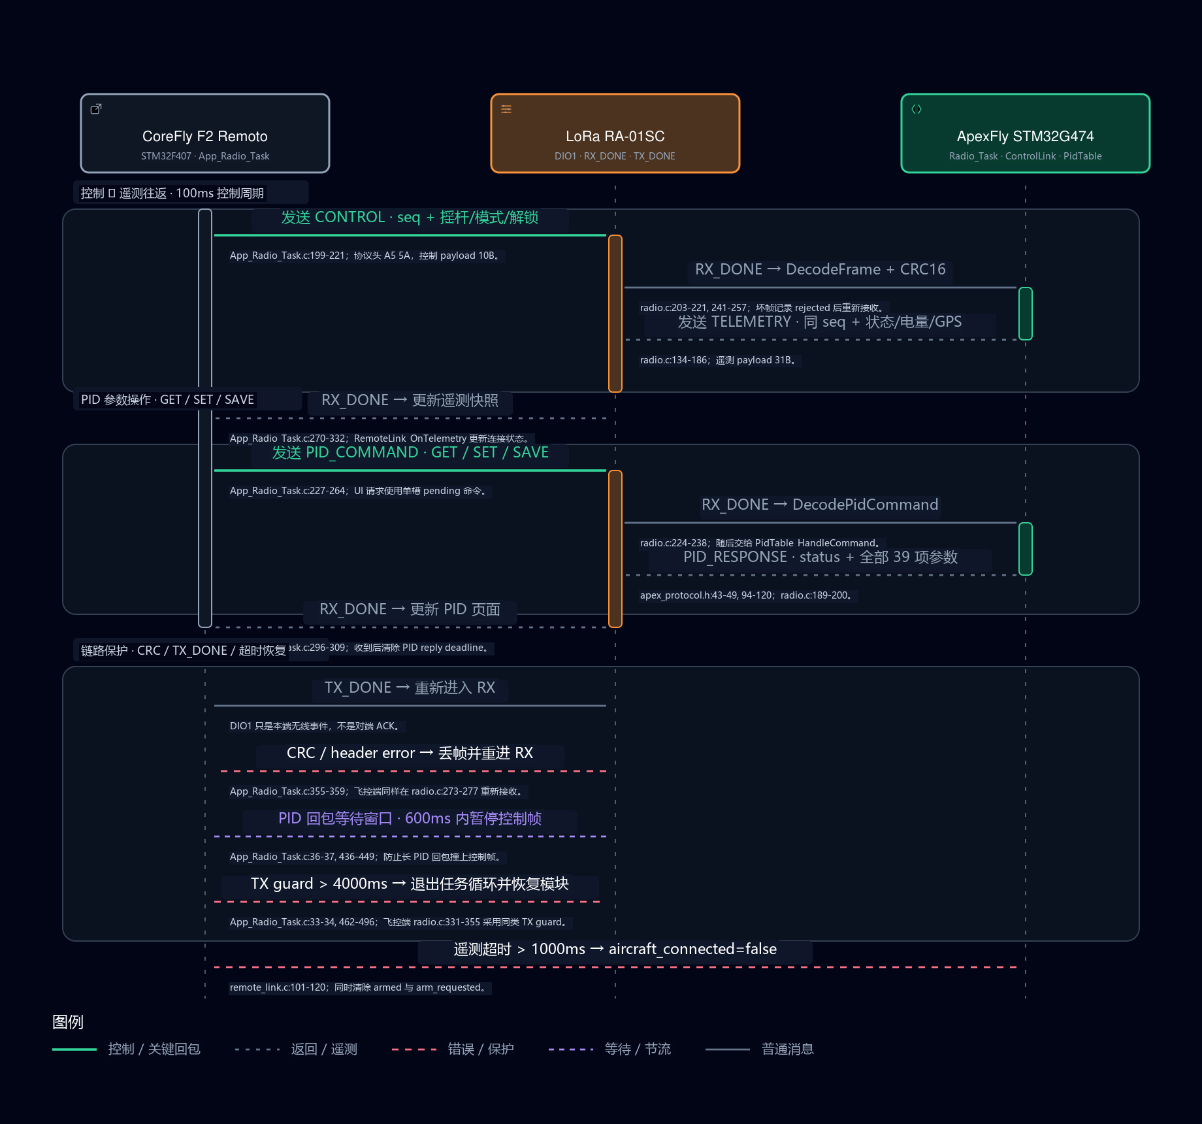
docs/diagrams/lora-communication.png
