Nyxarian/ApexFly-v2.0/docs/diagrams/realtime-control.png

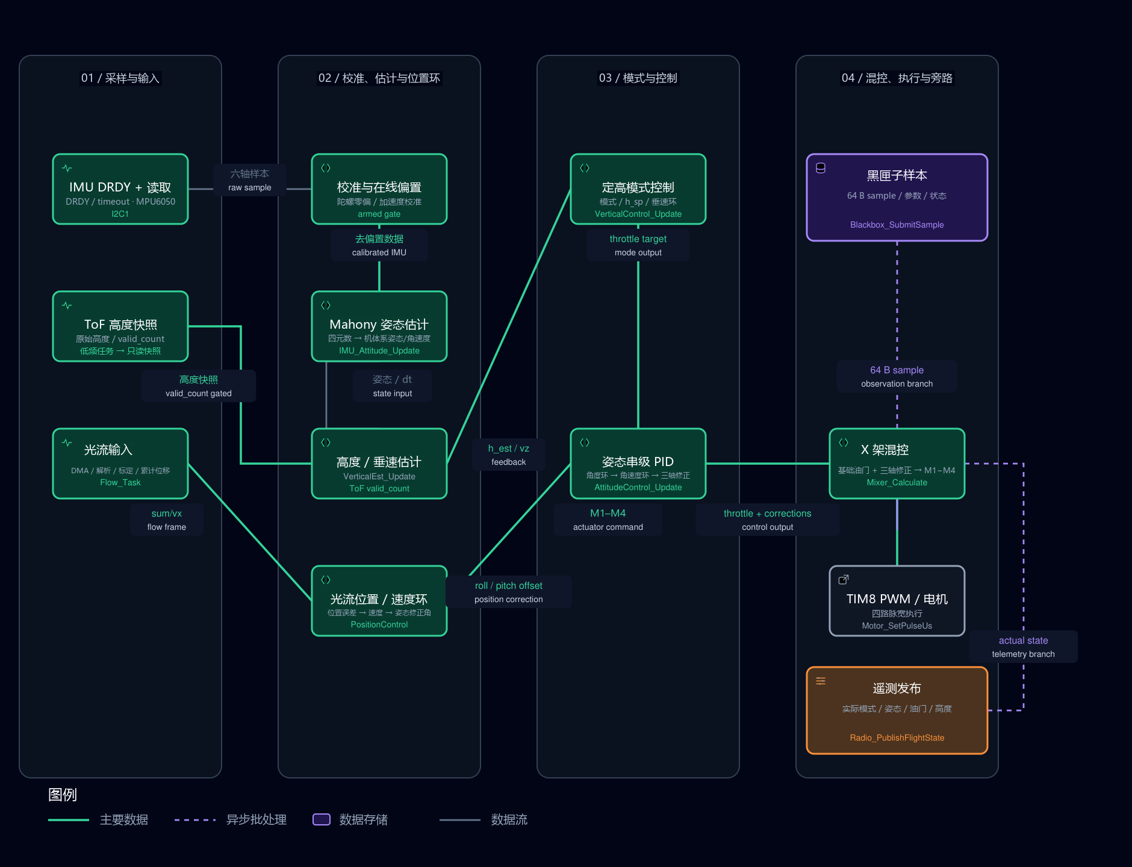
docs/diagrams/realtime-control.png
