Nyxarian/ApexFly-v2.0/docs/diagrams/software-layers.png

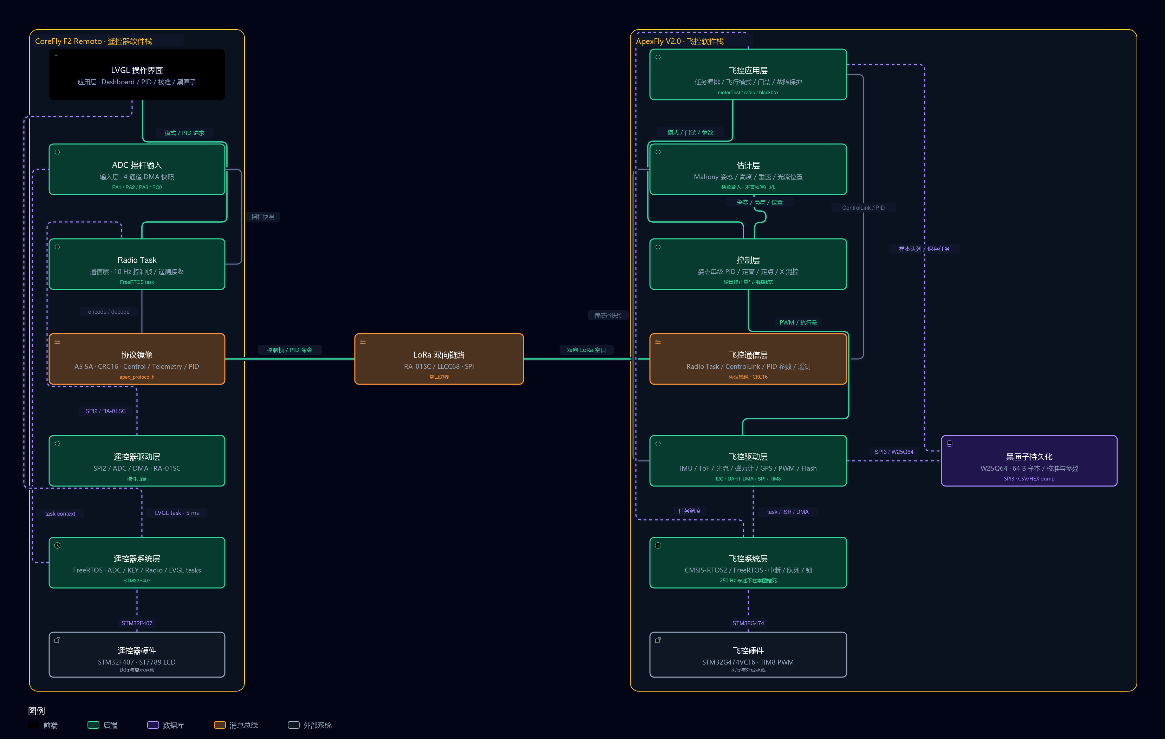
docs/diagrams/software-layers.png
