Nyxarian/ApexFly-v2.0/docs/diagrams/system-architecture.png

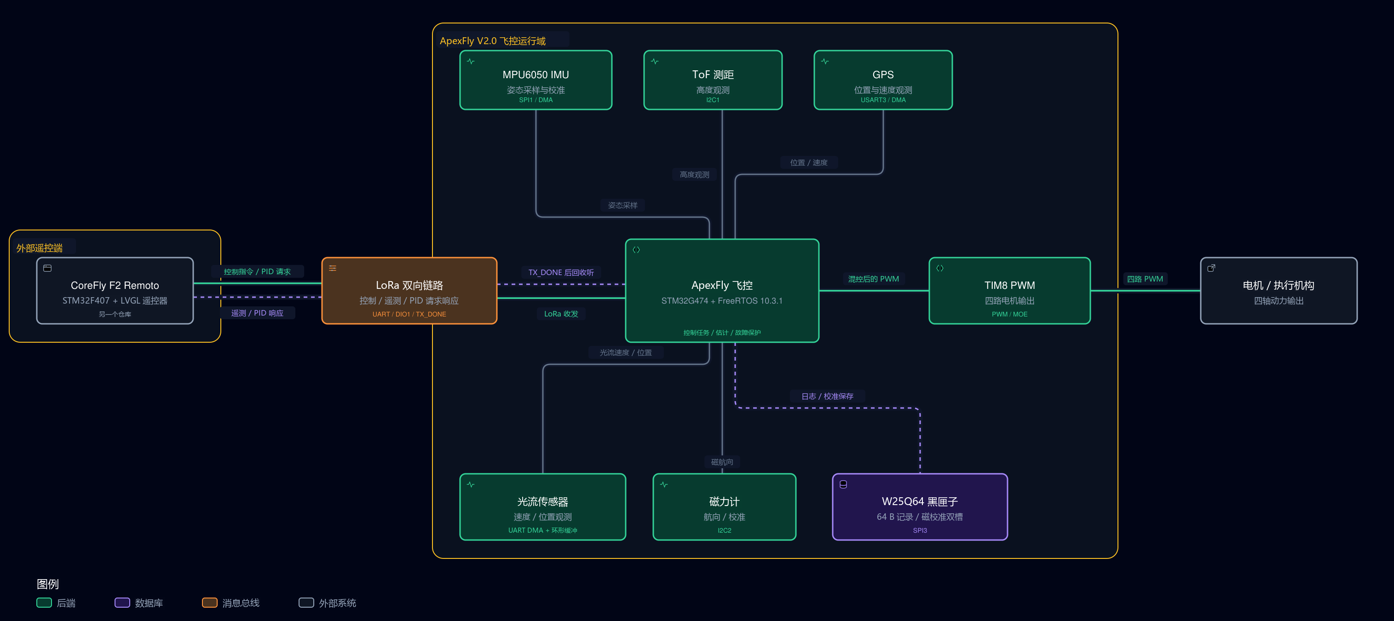
docs/diagrams/system-architecture.png
