Nyxarian/ApexFly-v2.0/docs/hardware/flight-controller/flight-controller-3d-back.png

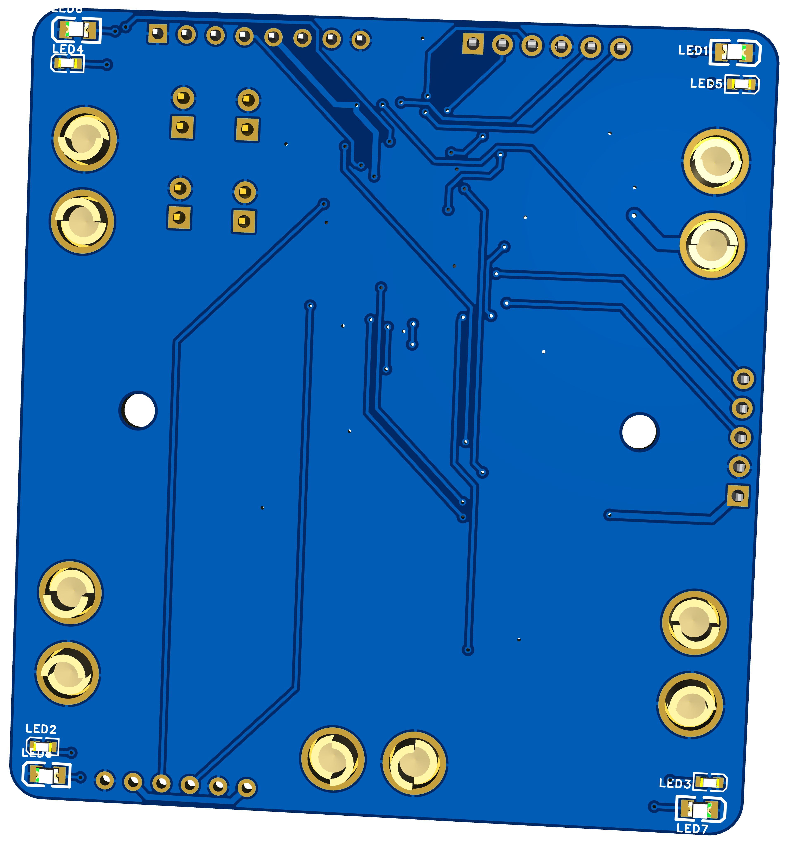
docs/hardware/flight-controller/flight-controller-3d-back.png
