Nyxarian/ApexFly-v2.0/docs/hardware/flight-controller/flight-controller-3d-front.png

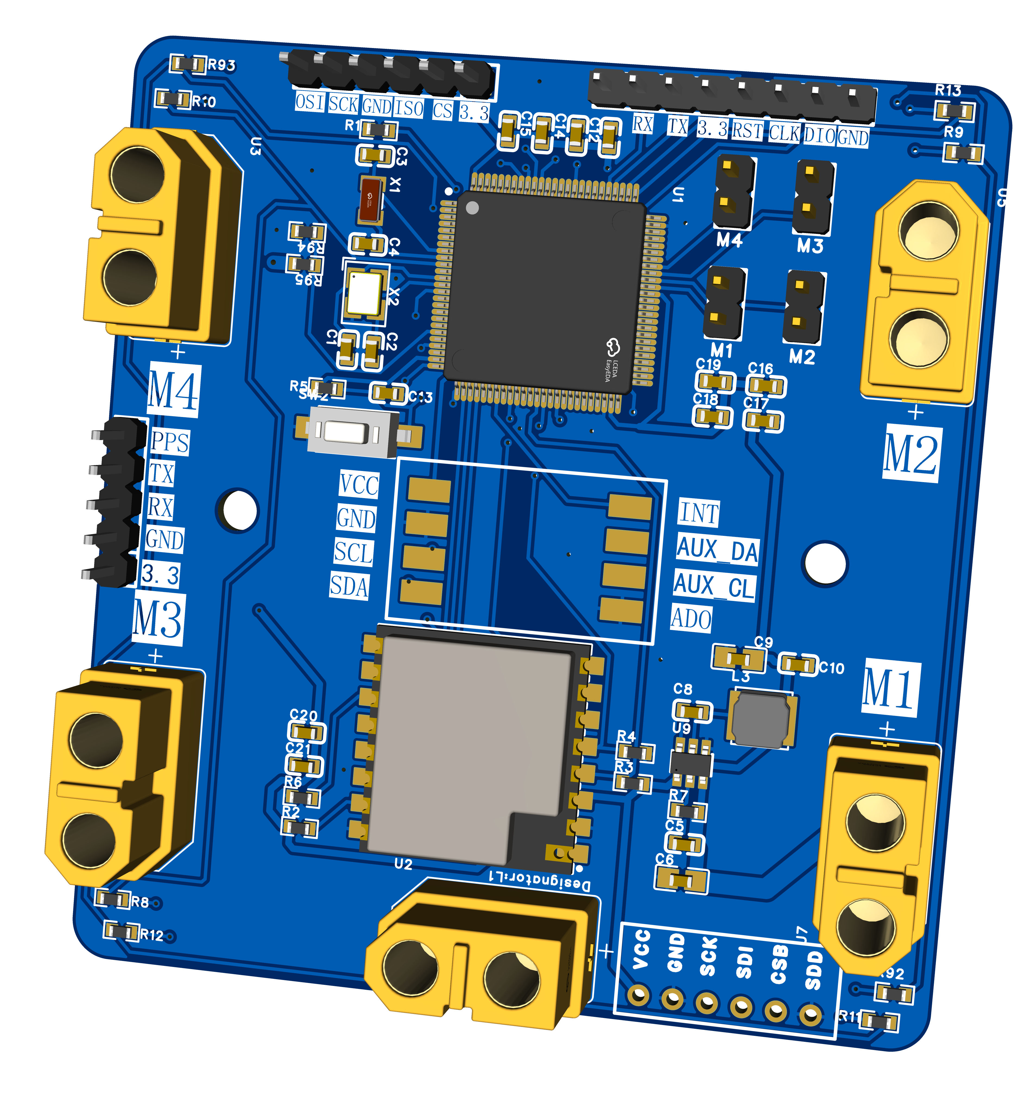
docs/hardware/flight-controller/flight-controller-3d-front.png
