Nyxarian/ApexFly-v2.0/docs/hardware/flight-controller/flight-controller-pcb-bottom.png

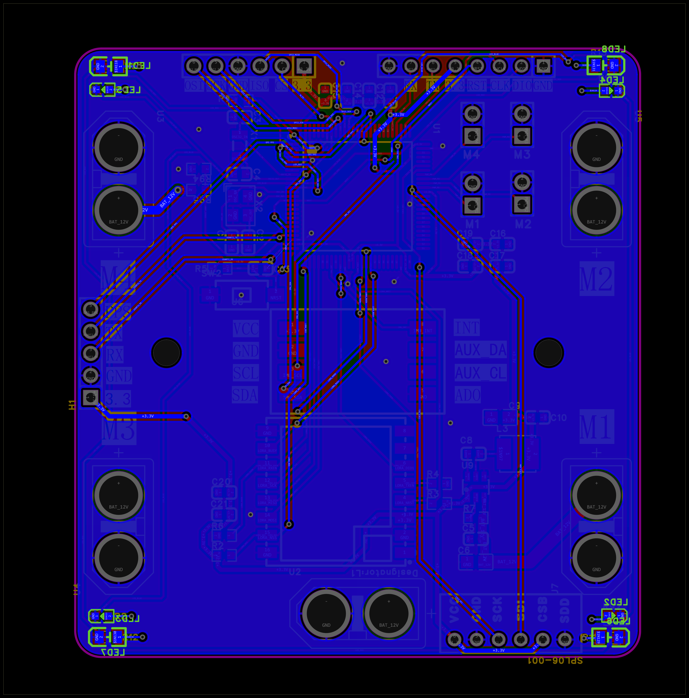
docs/hardware/flight-controller/flight-controller-pcb-bottom.png
