Nyxarian/ApexFly-v2.0/docs/hardware/flight-controller/flight-controller-pcb-top.png

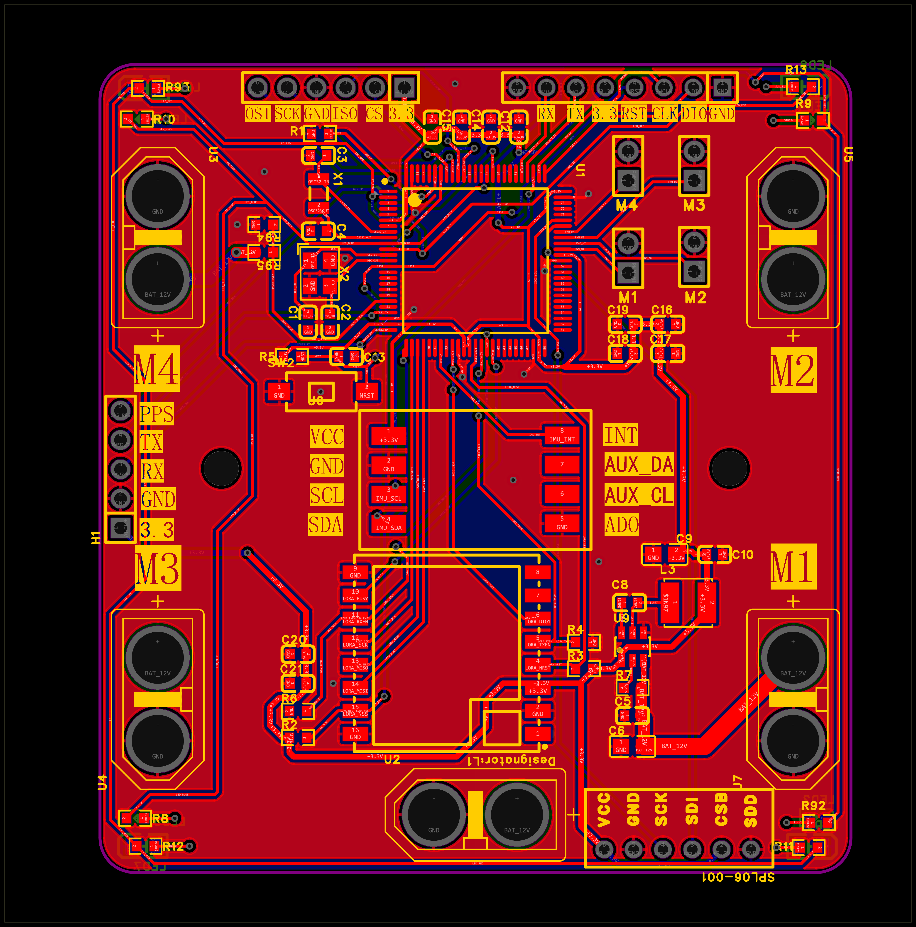
docs/hardware/flight-controller/flight-controller-pcb-top.png
