Nyxarian/ApexFly-v2.0/优化一下/姿态链路优化清单（逐环节·含影响结果）.md

# ApexFly V2.0 姿态链路优化清单（逐环节 · 含影响结果）

> 链路范围：**MPU6050 底层六轴读取 → 校准 → 姿态解算 → 串级 PID → 混控 → PWM → 电机**
> 整理时间：2026-09-08（含 9/8 当天已完成的改动）
> 分析对象：`F:\Zhuomian\ApexFly v2.0\ApexFly v2.0\`（STM32G474VCT6 / Keil AC5 / FreeRTOS 10.3.1）
> 性质：只读分析 + 已实施项标注；本文件为**长期留存版**，后续讨论以此为准，不必重新翻代码。
> 说明：表中"影响结果"分两栏——**现状→后果**（当前问题会造成什么）与**优化后→收益**（改完能得到什么）。

---

## 0. 当前进展快照（截至 2026-09-08）

| 项目 | 状态 | 说明 |
|---|---|---|
| 电调 PWM 50Hz → **400Hz** | ✅ 已完成 | `tim.c:102` `Period=2499`、`Prescaler=169`；`.ioc` 同步；台架验证电调接受 |
| 磁力计任务 `magTask` | ✅ 已恢复 | CubeMX 补齐 + `StartMagTask` 填 `Mag_Task(argument)` |
| GPS 任务 `gpsTask` | ✅ 已恢复 | CubeMX 补齐 + `StartGpsTask` 填 `GPS_Task(argument)` |
| 姿态调试任务 `attitudeDebugTask` | ⛔ 暂不常驻 | 按需临时创建即可（它只打 `[MAG]`，与控制环内打印是两件事） |
| 气压计任务 `baroTask` | ⛔ 暂不添加 | 定高未启用；`baro.c/spl06.c/altitude_est.c` 保留在工程内但无调用者 |
| 控制环内每拍阻塞打印 | ❌ 待处理 | `motor_test.c:236`（P0-1） |
| PID 参数重新整定 | ❌ 待处理 | 400Hz 生效后被控对象相位变了，1.80/1.30 需重调 |

> 内存占用现状（8 个任务）：栈合计 3712 字 = 14.5KB，加 TCB 与队列约 18KB / 30KB heap，余量约 12KB。

---

## 1. 三个"硬约束级"发现（优先级高于调 PID）

| # | 环节 | 现状 | 问题 | 优化空间 | 影响结果 |
|---|---|---|---|---|---|
| F1 | 输出层：电机有效更新率 | TIM8 原 50Hz（20ms），CCR 预装载（HAL 自动置 OCxPE，`stm32g4xx_hal_tim.c:4358`）；**已改 400Hz** | 控制环 100Hz 算、写 CCR，但新脉宽每 20ms 才装载 → 电机实际更新率 50Hz、平均延迟 10ms | 已改 400Hz（周期 2.5ms、延迟 1.25ms）；该 XXD 30A 电调不支持 DShot/OneShot，无法再上台阶 | **现状（50Hz）→** 姿态环相位裕度被吃掉大半，增益上不去、大风压不住、易震荡发散。<br>**优化后（400Hz）→** 指令延迟降 8 倍，可用更高阻尼增益，抗阵风能力提升（**必须重调 PID**） |
| F2 | 任务调度：控制环内打印 | `motor_test.c:236` 每拍 `Debug_Printf("[IMU] ...")`，约 70 字节 @115200 ≈ **6ms 阻塞**（9/3 新增、9/8 编译进固件） | 名义 100Hz 实际降到 ~16.5ms 且抖动；8/29 数据（无此行）dt 中位数 10ms，今天必然变差 | 删除该行；或仅 `armed==0` 时 10Hz 打印；解锁后一律只走黑匣子 | **现状→** 节拍降约 40%、相位裕度恶化、姿态抖动、PID 整定失真（同一组参数表现飘忽）。<br>**优化后→** 恢复 10ms 稳定节拍，姿态噪声下降，调参可复现 |
| F3 | 输出层：混控下限 | `mixer.c` 已做统一缩放饱和保护，但 `motor_test.c:58-61` 事后**逐路硬抬到 1050us**（混控内部下限又是 1000us） | 某一路本该 950us 被抬到 1050 → 四路差速关系被破坏、力矩方向扭曲；两处下限不一致 | 把"最低有效油门"作为参数传入 `Mixer_Calculate()`，参与 `correction_scale` 计算，不做事后裁剪 | **现状→** 大修正/低油门时出现力矩不足或方向被扭曲，姿态修正打折甚至反效果，饱和行为不可预测。<br>**优化后→** 修正方向始终正确，饱和按统一比例缩放，行为可预测 |

---

## 2. A. 任务调度层

| # | 环节 | 现状 | 问题 | 优化空间 | 影响结果 |
|---|---|---|---|---|---|
| A1 | 控制任务优先级 | `motorTestTask = osPriorityNormal(24)` | **低于** `radioTask = osPriorityAboveNormal(32)`；radio 每次收发要做 SPI 读写 + Busy 忙等（`ra01sc.c` 单次最长 200ms 忙等）→ 会抢占控制环 | 控制任务提到最高优先级；radio 降为普通优先级并用中断/DMA 驱动收发 | **现状→** 每次无线电交互（约每 300ms 一次）可能让控制环晚 1–3ms，节拍抖动、偶发丢拍，姿态修正"卡一下"。<br>**优化后→** 控制环始终优先，节拍稳定，抖动来源减少 |
| A2 | 周期基准 | `osDelay(10)` 放在循环末尾 | 实际周期 = 计算时间 + 10ms，**误差累积**（8/23 实测 11ms 主峰、19ms 尖峰） | 改 `vTaskDelayUntil()` 固定相位；高频环可用"下一拍绝对时刻"等待 | **现状→** 周期偏大且不均匀，等效采样延迟增加，dt 抖动传导到积分/微分。 <br>**优化后→** 严格 10ms（或设定值）周期，dt 稳定 |
| A3 | dt 精度 | `osKernelGetTickCount()` 差 × 0.001f | tick 分辨率 1ms → dt=10ms 时**量化误差 10%** | 用 DWT->CYCCNT 或 TIM 微秒计数（ns 级） | **现状→** PID 的积分与微分项幅值随量化误差波动（同一误差算出的输出不一致），参数整定结果不可复现。<br>**优化后→** dt 精度 <0.1%，PID 行为稳定可复现 |
| A4 | 时基一致性 | 姿态数据时间戳用 `HAL_GetTick()`（TIM6），控制环用 `osKernelGetTickCount()`（SysTick） | 两套时基，可能相差 0–1ms，混用易错 | 统一到一个微秒时基（DWT 或 TIM） | **现状→** 时间戳与 dt 基准不一致，黑匣子/日志做延迟分析时会误判；跨模块时间无法对齐。<br>**优化后→** 全链路时间可精确对齐，便于分析 |
| A5 | 控制频率 | 100Hz | 对四轴偏低（现代飞控 250–1000Hz）；采样延迟 + DLPF 延迟占比大 | 先解决 I2C 阻塞（见 B9），再提到 250–500Hz | **现状→** 阻尼带宽受限、扰动恢复慢，大风下"压不住"的余量小。<br>**优化后→** 响应更快、抗扰更强（**PID 必须重调**） |
| A6 | I2C 阻塞超时 | `MPU6050_I2C_TIMEOUT_MS = 20ms`；单次读失败会触发整机重新初始化 IMU + 重采零偏/水平零点 | 超时比控制周期还长；一次总线异常 → 控制环停摆 2 拍以上；飞行中触发重初始化是**断桨级风险** | 超时降到 1–2ms；单次错误只丢本拍并计数，连续 N 次才保护 | **现状→** 振动/干扰导致的偶发 I2C 错误可能让飞机在空中"上锁重来"，直接炸机。<br>**优化后→** 单次错误无感，只在连续错误时保护，飞行安全裕度大幅提升 |
| A7 | IMU 中断 | `IMU_INT=PB0/EXTI0` 已配优先级 6，但 `HAL_GPIO_EXTI_Callback()` 明确忽略它（`radio.c:344-353`） | Data-Ready 中断闲置，采样靠 `osDelay` 盲等 | EXTI0 → 任务通知，采样与芯片输出严格同步 | **现状→** 采样相位与芯片更新不同步，可能抽到重复样本或跨更新边界的"半新半旧"数据。<br>**优化后→** 每次采样都是新样本，时序抖动消除 |
| A8 | 栈 / 堆 | 控制任务 2560B；heap 30KB，当前 8 任务约占 18KB；栈溢出检测 level 2（溢出即停调度+红灯） | 无明显问题，余量约 12KB | 保持；新增任务时重新核算 | **现状→** 安全，有保护。<br>**优化后→** 余量可用于后续功能（光流/位置环等） |

---

## 3. B. 传感器数据层（MPU6050）

| # | 环节 | 现状 | 问题 | 优化空间 | 影响结果 |
|---|---|---|---|---|---|
| B1 | 量程 | 陀螺 ±2000dps（16.4 LSB/dps）、加计 ±8g（4096 LSB/g） | 四轴实际角速度 <500dps，大量程换来更大噪声、更低分辨率 | 陀螺改 ±500dps（65.5 LSB/dps，噪声约降 4 倍）；加计改 ±4g（注意抗冲击余量） | **现状→** 陀螺噪声直接进入姿态解算与内环 PID，限制可用阻尼增益（增益一高就抖）。<br>**优化后→** 同等增益下姿态抖动明显下降，可以放心提高阻尼 |
| B2 | DLPF | `CONFIG=0x03` → 陀螺 42Hz / 加计 44Hz，**延迟 4.9ms** | 延迟占 100Hz 周期的近一半；若控制环提到 500Hz，42Hz 带宽成为瓶颈 | 控制频率提高后改 98Hz / 188Hz 档，权衡噪声与延迟 | **现状→** 4.9ms 纯延迟压缩相位裕度，是"增益调不上去"的隐性原因之一。<br>**优化后→** 延迟降低、带宽提升，配合更高控制频率效果更佳 |
| B3 | 采样率 / DRDY | 内部 1kHz（`SMPLRT_DIV=0`）；**不检查 Data-Ready** | 以 100Hz 读取相当于"抽点"，无法确认读到的是新样本 | 保留 1kHz 内部采样，改由 DRDY 中断触发读取 | **现状→** 可能读到与上一拍相同的样本（重复积分/重复控制），或错过更新。<br>**优化后→** 每拍都是确定的新样本 |
| B4 | 读取原子性 | 一次连续读 14 字节（~0.4ms @400kHz） | 芯片内部 1ms 更新一次 → 约 **40% 概率跨更新边界**，accel 与 gyro 最多差 1ms | 读前查 `INT_STATUS.DATA_RDY`，或启用 FIFO 批量读 | **现状→** 姿态解算输入存在 1ms 级时间不对齐（300°/s 时约 0.3° 误差），机动时误差放大。<br>**优化后→** accel/gyro 严格同批同刻 |
| B5 | 温度 | 读了 `temperature_c` 但**从未使用** | 陀螺零偏温漂典型 ±0.05°/s/℃；开机自热 10–20℃ → 漂移 0.5–1°/s | 温度-零偏一阶补偿（需一次标定）；或静止自适应零偏估计 | **现状→** 飞行数分钟后零偏漂移，roll/pitch 被重力修正拉住但 yaw 明显漂；姿态出现缓慢偏置。<br>**优化后→** 温漂影响大幅减小，长时间飞行姿态更稳 |
| B6 | 加速度计校准 | **没有做**（只有"水平零点"） | 加计零偏几十 mg → 静态姿态误差 1–2°，且误差随姿态变化 | 六面法标定零偏 + 尺度，结果存 Flash | **现状→** 静态误差被水平零点部分吸收，但机动/大倾角时误差暴露，姿态估计不准。<br>**优化后→** 全姿态范围精度提升，水平零点更可信 |
| B7 | 陀螺零偏采集 | 上电静置 200 拍（约 2s）取平均；**无静止检测、无方差检查、无温度稳定等待** | 开机 2s 内芯片自热未稳；若此时有振动/风吹，零偏带误差 | 延长到 5–10s；加双重门禁（陀螺方差 < 阈值 + 加计模长 ≈1g） | **现状→** 冷机起飞时零偏不准 → 姿态缓慢漂移、yaw 漂得更快，每次起飞表现不一致。<br>**优化后→** 零偏可靠，起飞状态可复现 |
| B8 | 水平零点采集 | 静置 200 拍取机体系 roll/pitch 平均后**直接相减**（`imu_level.c`），仅存 RAM | ① 同时吸收安装倾角与姿态估计静态误差；② **若采集时机体不在真实水平（起落架不平/放斜面上），就变成永久目标角偏置 → 飞机带固定倾角飞 → 单向漂移**；③ 无水平性/方差检查；④ 每次开机重采 → 飞行行为不一致 | 改为"用加计重力方向标定安装倾角 + 加计零偏"并**存 Flash**；采集准入条件（模长≈1g、gyro 静止、倾角变化小）；台架用水平仪交叉验证 | **现状→** 这是"**持续单向漂移**"最直接的软件来源之一：零点带 2° 误差，飞机就永远带 2° 倾角飞、持续朝一个方向加速；而且每次开机不同，问题难复现、难排查。<br>**优化后→** 零点可复现、可验证、可存档，漂移从根上消除 |
| B9 | I2C 速率 / 方式 | ✅ **已修正（2026-09-10）**：旧值 `Timing=0x40B285C2` 实测仅约 98.8kHz（**不是文档原先写的 400kHz**）；现改为 `0x40621236` = 400kHz，仍为**阻塞读** | 旧：14B 读 ≈1.6ms，占 10ms 周期 16%；新：实测 ≈405µs，占 4.1% | 已完成，不再需要 DMA 方案 | **现状→** CPU 被阻塞、时间被占用，直接限制控制频率提升。<br>**优化后→** 为 250–500Hz 控制环腾出时间预算 |

---

## 4. C. 姿态解算层（Mahony 六轴）

| # | 环节 | 现状 | 问题 | 优化空间 | 影响结果 |
|---|---|---|---|---|---|
| C1 | 积分方法 | **一阶欧拉**：`q += 0.5*q⊗ω*dt` | dt=10ms、ω=300°/s 时每拍转 3°，误差随 ω²dt 增长；dt 抖动时误差不稳定 | 改**中值积分**（ω_prev 与 ω_now 平均）或四元数指数映射 | **现状→** 大角速度/机动后姿态角存在系统偏差，快速动作后姿态不准，影响 PID 判断。<br>**优化后→** 精度显著提升，计算代价几乎为零 |
| C2 | 加速度门限 | 模长 0.8–1.2g 才使用重力修正 | **太宽**：机动/加速时"比力 ≠ 重力"，在 0.8–1.2g 内仍会用错误重力方向把姿态拉偏 | 收紧到 0.95–1.05g；或改用加速度变化率/方差门控 + 机动时降低 Kp | **现状→** 大机动或强阵风时姿态被"错误的重力"拉歪，roll/pitch 出现虚假角度 → PID 朝错误方向修正，可能自激震荡。<br>**优化后→** 机动时姿态更可信，不会因加速度干扰而误判 |
| C3 | 加速度滤波 | 只有芯片 DLPF 44Hz，**无软件低通** | 电机振动（100–300Hz 及谐波）经 DLPF 衰减后仍有残留，直接进入重力修正 | 加二阶低通（20–30Hz），或对重力误差项做滑动平均 | **现状→** 姿态角带振动噪声 → PID 输出抖动 → 电机抖动、发热、噪声，且限制增益上限。<br>**优化后→** 姿态平滑，PID 可提高增益（需权衡引入的 5–10ms 延迟） |
| C4 | Kp / Ki 整定基准 | Kp=0.8、Ki=0.03/s、积分限幅 ±0.2rad/s（按 100Hz 手调） | 数值合理，但与当前采样率/滤波绑定；改频率或滤波后必须重算 | 控制频率或滤波改动后重新整定 | **现状→** 参数与实现耦合，改一处要连带重调，容易遗漏导致姿态异常。<br>**优化后→** 参数与实现解耦，维护清晰 |
| C5 | dt 限幅 | `[5ms, 30ms]`，越界返回 false | 返回 false 时上层 `continue`，**直接跳过本拍控制**（姿态不更新、电机保持旧值） | 丢拍时改用陀螺外推的姿态，而不是不控制 | **现状→** 偶发大延迟时"本拍不控制"，电机维持旧油门，姿态短暂失控（严重时触发发散）。<br>**优化后→** 控制连续，短暂延迟不中断闭环 |
| C6 | 初始化 | 首拍用加速度计算 roll/pitch 置初值 | 首拍有振动/机动则初值偏，之后靠 Mahony 慢慢收敛 | 用零偏采集期间的平均加速度作为初值 | **现状→** 起飞前姿态初值可能偏几度，收敛需要几秒，期间姿态控制基准不准。<br>**优化后→** 初值更准，收敛更快 |
| C7 | yaw | 无磁观测，纯积分漂移 | （当前暂不讨论，磁力计只进偏航外环） | 后续接磁航向或 GPS course 修正 | **现状→** yaw 随时间漂移，只能靠磁航向环（`yaw_angle`）拉回，而该环当前未启用。<br>**优化后→** 航向可长期稳定 |

---

## 5. D. 控制算法层（串级 PID）

| # | 环节 | 现状 | 问题 | 优化空间 | 影响结果 |
|---|---|---|---|---|---|
| D1 | 结构 | 外环角度 → 目标角速度；内环角速度 → 修正 us | 设计正确，符合四轴姿态控制常规做法 | 保持 | **现状→** 无问题。<br>**优化后→** — |
| D2 | 内环旁路 | 内环 Kp/Ki/Kd 全 0 时，外环输出**直通当 us**（`attitude_control.c:70-73,117-121`） | 危险后门：参数丢失/未加载时系统静默退化为"无阻尼角度环" | 加显式门禁（内环未启用 → 拒绝解锁/告警）；或彻底删除该旁路 | **现状→** 参数丢失时"看起来在控制、实际无阻尼"，起飞即发散（8/23 及之前实机正是此状态）。<br>**优化后→** 故障显性化，不会静默带病飞行 |
| D3 | 微分项 | `deriv = (error - last_error)/dt`，**作用在误差上**，无低通 | ① 打杆/Trim 变化时产生**微分冲击**（derivative kick）；② 陀螺噪声被 Kd 放大 | 改为对**测量**微分 `-(meas-last_meas)/dt` + 一阶低通 | **现状→** 打杆瞬间输出尖峰（抖动/过冲）；噪声限制 Kd 可用值，阻尼加不上去。<br>**优化后→** 打杆平顺，Kd 可加大以提升阻尼 |
| D4 | 积分限幅 | `i_limit` 被 `pid_table` SET 时**设成与 out_max 相同（200）** | 积分项可独占整个输出 → 饱和时"风车"（windup） | i_limit 设为 out_max 的 20–30%；并加 anti-windup（输出饱和时冻结积分） | **现状→** 长时间存在偏差后积分顶满，退出饱和时大幅过冲/来回摆（低频震荡）。<br>**优化后→** 饱和后快速恢复，无过冲 |
| D5 | 输出限幅与油门关系 | 三轴修正 ±200us，与基础油门无关 | 低油门（1100us）时 200us 相对过大；靠混控 scale 兜底，但 F3 的 1050 事后下限又破坏 scale | 让"最低有效油门"进混控统一计算；或按油门比例限制修正上限 | **现状→** 低油门大修正时某路被抬到 1050 → 力矩被扭曲，姿态修正反效果。<br>**优化后→** 修正幅度与可用推力匹配，低油门段也可靠 |
| D6 | 目标角速率限制 | 杆量直接映射目标角（满杆 10°），无斜率限制 | 杆量跳变 → 目标角跳变 → 外环误差跳变 → 冲击 | 加目标角一阶滤波 / 速率限制（如 200°/s） | **现状→** 打杆冲击大、D 项尖峰、电机电流突变。<br>**优化后→** 手感平滑、结构应力小 |
| D7 | 限幅语义耦合 | `APEX_PID_ROLL_MAX_RATE_DPS` 同时当外环 `out_max` 与 `i_limit`；`..._MAX_CORRECTION_US` 同理 | 语义耦合，调参时容易误伤 | 拆成两个独立参数 | **现状→** 改限幅会连带改积分限幅，调参困惑、易引入异常。<br>**优化后→** 参数语义清晰，调参可控 |
| D8 | dt 使用 | 传入的 `control_dt_s` 被限幅到 `[5ms, 30ms]` | 与真实周期不一致时积分量有偏 | 用微秒真实 dt，只做异常保护（不做粗暴限幅） | **现状→** 与 A3 叠加，积分/微分误差进一步放大。<br>**优化后→** 积分准确，PID 输出可复现 |
| D9 | 电压补偿 | 无 | 电池 12.6V→11.0V 时，同脉宽推力下降约 10% | 用 `battery.c` 电压做一阶推力补偿系数 | **现状→** 电量下降后悬停漂移、油门手感变化，定高（未来）不准。<br>**优化后→** 推力与电压解耦，手感与悬停点稳定 |

---

## 6. E. 输出层（PWM / 电调）

| # | 环节 | 现状 | 问题 | 优化空间 | 影响结果 |
|---|---|---|---|---|---|
| E1 | PWM 频率 | **已由 50Hz 改为 400Hz**（`tim.c:102` Period=2499、PSC=169；9/8 完成，电调实测接受） | （原）有效更新率 50Hz、平均延迟 10ms | 已完成；该 XXD 30A 电调不支持 DShot/OneShot，无法再上台阶（8kHz 是其内部载波，不是输入频率） | **改前→** 姿态环相位裕度不足、增益上不去、大风易震荡。<br>**改后→** 指令延迟 10ms→1.25ms，抗阵风余量提升（**PID 必须重调**） |
| E2 | 通道映射 | M1→CH1(PC6)、M2→CH2(PC7)、M3→CH3(PC8)、M4→CH4(PC9) | 与混控约定一致，无问题 | 保持 | **现状→** 无问题。<br>**优化后→** — |
| E3 | 脉宽范围 / 死区 | 1000–2000us，锁定 1000us | 电调实际起转点可能在 1050–1100us，且四路不一致 | 台架实测四路起转点，写入各自死区补偿 | **现状→** 低油门段四路推力不一致 → 起转/怠速时姿态偏转，起飞瞬间"往一侧歪"。<br>**优化后→** 低油门段四路同步，起飞更稳 |
| E4 | 混控下限 | 混控内部 1000us + 事后逐路 1050us（见 F3） | 破坏差速关系、力矩方向扭曲 | 统一进 `Mixer_Calculate()` 计算 | **现状→** 大修正时力矩不足或反向，姿态修正失效。<br>**优化后→** 修正方向始终正确 |
| E5 | 输出平滑 | 无 | 修正量突跳直接进电机 | 可选：对修正量做一阶低通（谨慎，会增加延迟） | **现状→** 修正跳变引起电机电流冲击、噪声。<br>**优化后→** 更平顺，但需权衡延迟（建议放在其他优化之后再做） |

---

## 7. 优先级与建议实施顺序

### P0（纯工程修复，不改算法，收益最大）

| 序号 | 项目 | 对应条目 | 备注 |
|---|---|---|---|
| 1 | 删除控制环内每拍打印 | F2 | 恢复 10ms 节拍 |
| 2 | ~~PWM 50Hz → 400Hz~~ | F1 / E1 | ✅ **已完成** |
| 3 | 混控下限统一 | F3 / E4 | 去掉事后 1050 硬抬 |
| 4 | 控制任务最高优先级 + `vTaskDelayUntil` | A1 / A2 | 降低抖动 |
| 5 | dt 改用微秒计时（DWT） | A3 / A4 / D8 | 精度提升 |
| 6 | I2C 超时 20ms→2ms，单错只丢拍 | A6 | 消除空中"重置"风险 |

### P1（校准与数据质量，直接关系"漂移"）

| 序号 | 项目 | 对应条目 |
|---|---|---|
| 7 | 水平零点改为加计重力标定 + 存 Flash + 门禁 | B8 |
| 8 | 陀螺零偏采集延长 + 静止/方差门禁 | B7 |
| 9 | 加计软件低通 + 门限收紧 | C2 / C3 |
| 10 | 陀螺量程 ±2000→±500dps（加计 ±8g→±4g） | B1 |
| 11 | 加速度计六面法标定 | B6 |

### P2（算法增强，需重新整定 PID）

| 序号 | 项目 | 对应条目 |
|---|---|---|
| 12 | 控制频率 100Hz → 250–500Hz（配 I2C DMA + DRDY） | A5 / A7 / B3 / B9 |
| 13 | 欧拉积分 → 中值积分 | C1 |
| 14 | D 项改为对测量微分 + 低通 | D3 |
| 15 | anti-windup + i_limit 降到 out_max 的 20–30% | D4 |
| 16 | 目标角速率限制 | D6 |
| 17 | 内环旁路门禁 | D2 |
| 18 | 电压补偿 | D9 |

> **重要提醒**：只要改动了 PWM 频率（已改）、控制频率或滤波环节，**PID 参数（当前 1.80 / 1.30）必须重新整定**——被控对象相位特性变了，旧参数不再是稳定点。

---

## 8. 验证方法速查

| 优化项 | 怎么验证 |
|---|---|
| 控制环节拍 | 黑匣子 `t_ms` 差值直方图（应集中在设定周期） |
| PWM 频率 | 示波器测 TIM8 引脚周期（400Hz → 2.5ms） |
| 混控下限 | 台架大修正时看四路脉宽差速比例是否仍对称 |
| dt 精度 | 串口打印实测 dt 与 tick 差值对比 |
| I2C 鲁棒性 | 人为制造总线错误，观察是否只丢本拍 |
| 零偏/水平零点 | 台架水平仪交叉验证；多次上电比较零点一致性 |
| 姿态噪声 | 黑匣子 roll/pitch/rate 的 RMS 与高频分量 |
| 陀螺量程 | 满杆机动时检查是否饱和（原始值接近满量程） |
| PID 整定 | 每轮归档 `pid.csv` + 黑匣子场次，对比超调/收敛时间 |
| 电调温度 | 红外测温，改频率前后同油门对比（差异应 <5℃） |

---

## 9. 相关文件

| 文件 | 内容 |
|---|---|
| `优化一下\姿态链路优化备注（MPU6050-PID-电机）.md` | 过程分析、黑匣子数据时间线、磁力计接入层次、R1 根因修订 |
| `优化一下\姿态链路优化清单（逐环节·含影响结果）.md` | **本文件**：逐环节优化清单（含影响结果） |
| `ApexFly v2.0\ApexFly V2.0 悬停稳定性分析与定高定点返航实施方案.md` | 全量代码解析 + Phase A–D 分阶段方案书 |
| `BlackboxReader\exports\` | 黑匣子导出（最新 8/29 那批为 `blackbox_20260829_101042`） |

---

*本清单为只读分析的整理归档；已实施项已标注日期，"优化空间"列均为方案，实施前按"方案 → 确认 → 执行"流程逐项进行。*
