Nyxarian/ApexFly-v2.0/docs/hardware/flight-controller/flight-controller-schematic.pdf

PB11 50 PB12 51 PB13 52 PB14 53 PB15 54 PD8 55 PD9 56 PD10 57 PD11 58 PD12 59 PD13 60 PD14 61 PD15 62 VSS 63 VDD 64 PC6 65 PC7 66 PC8 67 PC9 68 PA8 69 PA9 70 PA10 71 PA11 72 PA12 73 VSS 74 VDD 75 PA13 76 PA14 77 PA15 78 PC10 79 PC11 80 PC12 81 PD0 82 PD1 83 PD2 84 PD3 85 PD4 86 PD5 87 PD6 88 PD7 89 PB3 90 PB4 91 PB5 92 PB6 93 PB7 94 PB8-BOOT0 95 PB9 96 PE0 97 PE1 98 VSS 99 VDD 100

# IMU

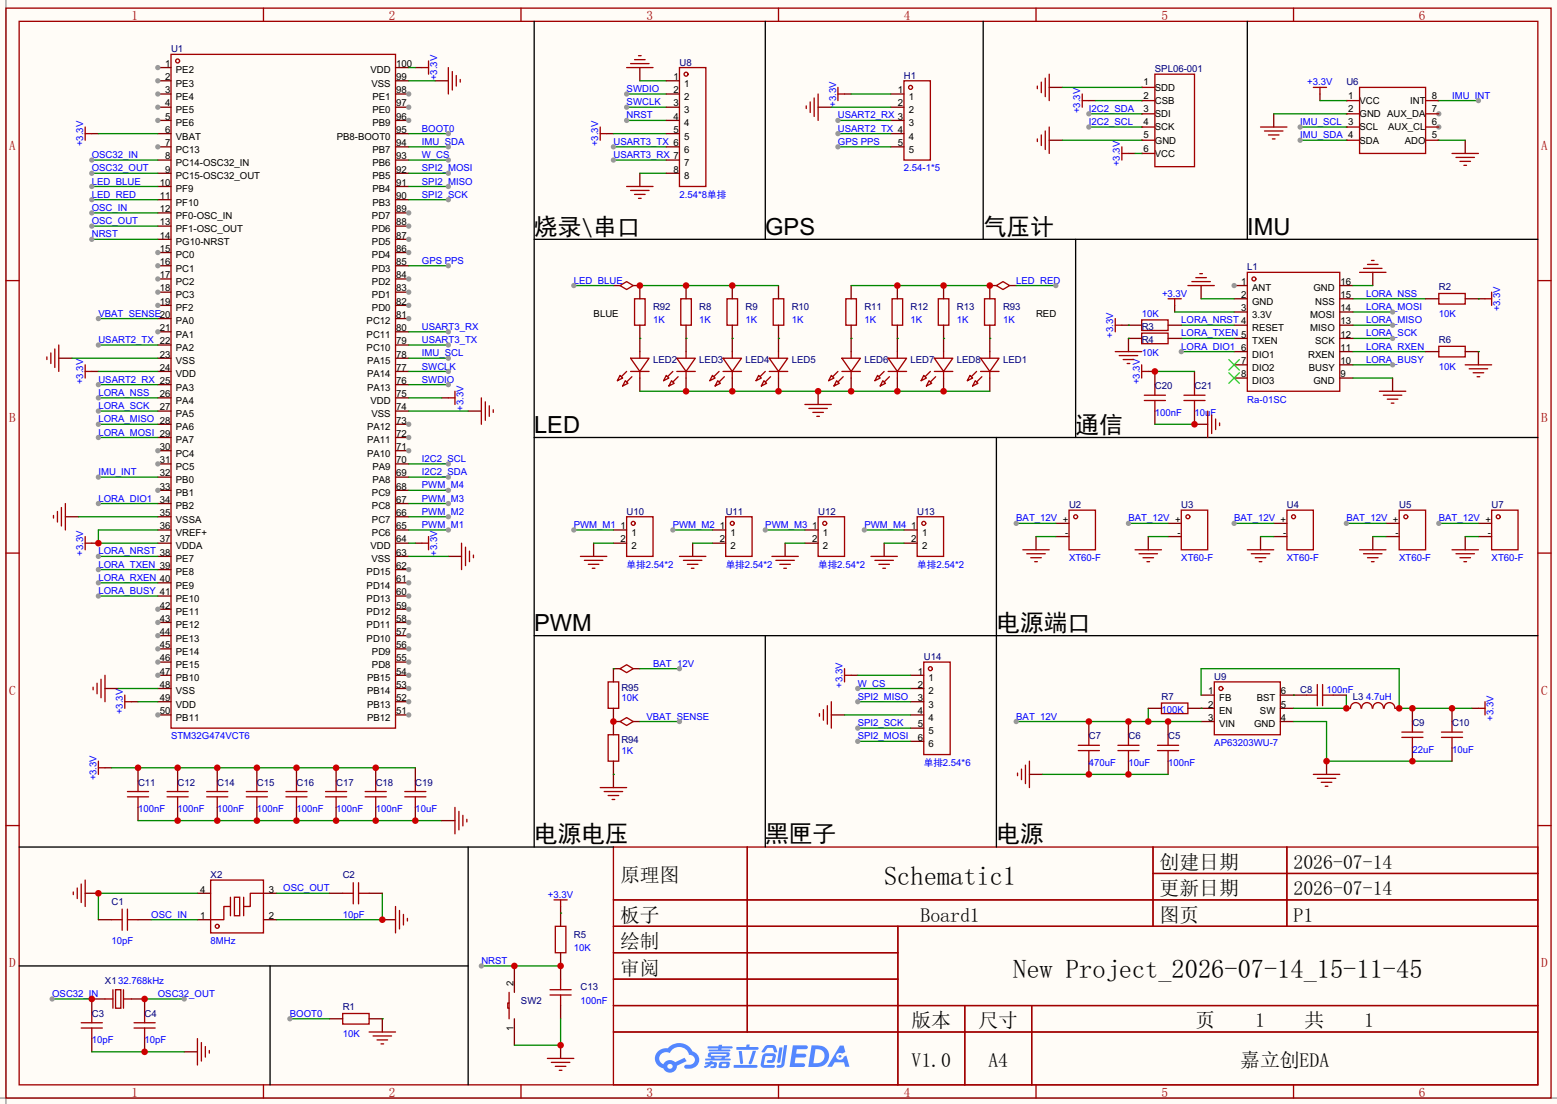
[picture p12: page 1]

BUSY 10 RXEN 11 SCK 12 MISO 13 MOSI 14 NSS 15 GND 16

更新日期 | 2026-07-14

板子 | Board1 | 图页 | P1
绘制 | | New Project_2026-07-14_15-11-45
审阅
