Nyxarian/ApexFly-v2.0/ApexFly v2.0/ApexFly v2.0.ioc

Mcu.UserName=STM32G474VCTx
PA0.Signal=ADC1_IN1
PA13.Signal=SYS_JTMS-SWDIO
PA14.Signal=SYS_JTCK-SWCLK
PA15.Signal=I2C1_SCL
PA2.Signal=USART2_TX
PA3.Signal=USART2_RX
PA4.GPIO_Label=LORA_NSS
PA4.Signal=GPIO_Output
PA5.GPIO_Label=LORA_SCK
PA5.Signal=SPI1_SCK
PA6.GPIO_Label=LORA_MISO
PA6.Signal=SPI1_MISO
PA7.GPIO_Label=LORA_MOSI
PA7.Signal=SPI1_MOSI
PA8.Signal=I2C2_SDA
PA9.Signal=I2C2_SCL
PB0.GPIO_Label=IMU_INT
PB0.Signal=GPXTI0
PB2.GPIO_Label=LORA_DIO1
PB2.Signal=GPXTI2
PB3.Signal=SPI3_SCK
PB4.Signal=SPI3_MISO
PB5.Signal=SPI3_MOSI
PB6.GPIO_Label=W_CS
PB6.Signal=GPIO_Output
PB7.Signal=I2C1_SDA
PC10.Signal=USART3_TX
PC11.Signal=USART3_RX
PC14-OSC32_IN.Signal=RCC_OSC32_IN
PC15-OSC32_OUT.Signal=RCC_OSC32_OUT
PC6.Signal=S_TIM8_CH1
PC7.Signal=S_TIM8_CH2
PC8.Signal=S_TIM8_CH3
PC9.Signal=S_TIM8_CH4
PD3.Signal=S_TIM2_CH1
PE10.GPIO_Label=LORA_BUSY
PE10.Signal=GPIO_Input
PE7.GPIO_Label=LORA_NRST
PE7.Signal=GPIO_Output
PE8.GPIO_Label=LORA_TXEN
PE8.Signal=GPIO_Output
PE9.GPIO_Label=LORA_RXEN
PE9.Signal=GPIO_Output
PF0-OSC_IN.Signal=RCC_OSC_IN
PF1-OSC_OUT.Signal=RCC_OSC_OUT
PF10.GPIO_Label=LED_RED
PF10.Signal=GPIO_Output
PF9.GPIO_Label=LED_BLUE
PF9.Signal=GPIO_Output
