Nyxarian/ApexFly-v2.0/ApexFly v2.0/Core/Inc/main.h

#define LED_BLUE_Pin GPIO_PIN_9
#define LED_BLUE_GPIO_Port GPIOF
#define LED_RED_Pin GPIO_PIN_10
#define LED_RED_GPIO_Port GPIOF
#define LORA_NSS_Pin GPIO_PIN_4
#define LORA_NSS_GPIO_Port GPIOA
#define LORA_SCK_Pin GPIO_PIN_5
#define LORA_SCK_GPIO_Port GPIOA
#define LORA_MISO_Pin GPIO_PIN_6
#define LORA_MISO_GPIO_Port GPIOA
#define LORA_MOSI_Pin GPIO_PIN_7
#define LORA_MOSI_GPIO_Port GPIOA
#define IMU_INT_Pin GPIO_PIN_0
#define IMU_INT_GPIO_Port GPIOB
#define IMU_INT_EXTI_IRQn EXTI0_IRQn
#define LORA_DIO1_Pin GPIO_PIN_2
#define LORA_DIO1_GPIO_Port GPIOB
#define LORA_DIO1_EXTI_IRQn EXTI2_IRQn
#define LORA_NRST_Pin GPIO_PIN_7
#define LORA_NRST_GPIO_Port GPIOE
#define LORA_TXEN_Pin GPIO_PIN_8
#define LORA_TXEN_GPIO_Port GPIOE
#define LORA_RXEN_Pin GPIO_PIN_9
#define LORA_RXEN_GPIO_Port GPIOE
#define LORA_BUSY_Pin GPIO_PIN_10
#define LORA_BUSY_GPIO_Port GPIOE
#define W_CS_Pin GPIO_PIN_6
#define W_CS_GPIO_Port GPIOB
