Nyxarian/ApexFly-v2.0/ApexFly v2.0/Modules/Control/position_control.c

/**
 * @file position_control.c
 * @brief 光流定点 OF6：58° 坐标旋转、位置 P 环、速度 P 环、输出低通。
 *
 * 机体系约定：X 朝前、Y 朝右；roll 正为右倾，pitch 正为抬头。
 * 因而飞机向前偏时应抬头后拉，向右偏时应左倾回拉。
 */

#include "position_control.h"

#ifdef POSITION_CONTROL_SIM
#include "pid_table_sim.h"
#else
#include "pid_table.h"
#endif

#include <stddef.h>

/* 光流相对机体系的 yaw 安装角。2026-09-27 前后/左右原始流量复核得到约 54°。 */
#define POSITION_CONTROL_COS_YAW 0.5878f
#define POSITION_CONTROL_SIN_YAW 0.8090f

/* 位置环每两帧更新一次：25Hz 光流下约 12.5Hz，避开约 80ms 的测量滞后。 */
#define POSITION_CONTROL_OUTER_DIVIDER 2U
#define POSITION_CONTROL_VELOCITY_SP_LIMIT_CPS 200.0f
#define POSITION_CONTROL_ANGLE_LIMIT_DEG 8.0f
/* 一阶低通：fc=2.5Hz，tau=1/(2*pi*fc)。不调用 libm。 */
#define POSITION_CONTROL_FILTER_TAU_S 0.063662f
#define POSITION_CONTROL_RECENTER_FRAMES 5U /* 25Hz × 200ms */
#define POSITION_CONTROL_REFERENCE_HEIGHT_CM 14.0f
#define POSITION_CONTROL_HEIGHT_SCALE_MIN 0.60f
#define POSITION_CONTROL_HEIGHT_SCALE_MAX 2.00f
/* OF10 接入后请求来自控制帧；上电默认关闭，避免遥控器尚未明确请求时进入定点。 */
#define POSITION_CONTROL_DIAGNOSTIC_REQUEST_DEFAULT false

static PositionControlSnapshot_t position_snapshot;
static uint8_t position_outer_divider;
static bool position_request;
static bool position_link_ok;
static bool position_sticks_centered;
static volatile bool position_control_permission;
static volatile bool position_attitude_safe;
static volatile bool position_height_safe;
static volatile bool position_safety_context_valid;
static volatile bool position_pilot_disarmed;
static bool position_flow_available;
static bool position_latched;
static uint8_t position_recenter_frames;
static float position_anchor_x;
static float position_anchor_y;
static float position_integral_forward;
static float position_integral_right;
static float velocity_integral_forward;
static float velocity_integral_right;
static float velocity_forward_error_prev;
static float velocity_right_error_prev;
static float velocity_forward_derivative;
static float velocity_right_derivative;
static volatile bool position_height_context_valid;
static volatile float position_height_cm;
static volatile bool position_motion_suppressed;
static bool position_reanchor_after_motion;

static float PositionControl_Clamp(float value, float lower, float upper)
{
    if (value > upper) return upper;
    if (value < lower) return lower;
    return value;
}

static float PositionControl_GetHeightScale(void)
{
    float scale;

    if (!position_height_context_valid || (position_height_cm <= 0.0f)) return 1.0f;
    scale = position_height_cm / POSITION_CONTROL_REFERENCE_HEIGHT_CM;
    return PositionControl_Clamp(scale, POSITION_CONTROL_HEIGHT_SCALE_MIN, POSITION_CONTROL_HEIGHT_SCALE_MAX);
}

static void PositionControl_ResetOutput(void)
{
    position_outer_divider = 0U;
    position_snapshot.valid = false;
    position_snapshot.velocity_forward_sp_cps = 0.0f;
    position_snapshot.velocity_right_sp_cps = 0.0f;
    position_snapshot.raw_roll_deg = 0.0f;
    position_snapshot.raw_pitch_deg = 0.0f;
    position_snapshot.roll_deg = 0.0f;
    position_snapshot.pitch_deg = 0.0f;
    position_snapshot.height_scale = 1.0f;
    position_snapshot.motion_suppressed = false;
    position_integral_forward = 0.0f;
    position_integral_right = 0.0f;
    velocity_integral_forward = 0.0f;
    velocity_integral_right = 0.0f;
    velocity_forward_error_prev = 0.0f;
    velocity_right_error_prev = 0.0f;
    velocity_forward_derivative = 0.0f;
    velocity_right_derivative = 0.0f;
}

static void PositionControl_LatchOff(void)
{
    position_latched = true;
    position_recenter_frames = 0U;
    position_snapshot.state = (uint8_t)POSITION_CONTROL_STATE_LATCHED;
    PositionControl_ResetOutput();
}

static bool PositionControl_WaitForPilotDisarm(void)
{
    /* 只处理正常上锁，已经锁存的真实故障仍需关闭、重开定点请求。 */
    if (!position_pilot_disarmed || !position_request || position_latched) return false;

    position_snapshot.state = (uint8_t)POSITION_CONTROL_STATE_WAITING;
    position_snapshot.fault_reason = (uint8_t)POSITION_CONTROL_FAULT_NONE;
    position_recenter_frames = 0U;
    position_reanchor_after_motion = false;
    position_anchor_x = 0.0f;
    position_anchor_y = 0.0f;
    position_snapshot.anchor_x_counts = 0.0f;
    position_snapshot.anchor_y_counts = 0.0f;
    position_snapshot.position_forward_counts = 0.0f;
    position_snapshot.position_right_counts = 0.0f;
    position_snapshot.velocity_forward_cps = 0.0f;
    position_snapshot.velocity_right_cps = 0.0f;
    PositionControl_ResetOutput();
    return true;
}

static void PositionControl_LatchOffWithReason(uint8_t reason)
{
    position_snapshot.fault_reason = reason;
    PositionControl_LatchOff();
}

static uint8_t PositionControl_GetGateMask(void)
{
    uint8_t mask = 0U;

    if (position_request) mask |= POSITION_CONTROL_GATE_REQUEST;
    if (position_link_ok) mask |= POSITION_CONTROL_GATE_LINK;
    if (position_flow_available) mask |= POSITION_CONTROL_GATE_FLOW;
    if (position_sticks_centered) mask |= POSITION_CONTROL_GATE_STICKS;
    if (position_safety_context_valid && position_control_permission && !position_pilot_disarmed &&
        position_attitude_safe && position_height_safe)
    {
        mask |= POSITION_CONTROL_GATE_PERMISSION;
    }
    return mask;
}

static uint8_t PositionControl_GetSafetyFault(void)
{
    if (!position_safety_context_valid || !position_control_permission)
    {
        return (uint8_t)POSITION_CONTROL_FAULT_PERMISSION;
    }
    if (!position_attitude_safe)
    {
        return (uint8_t)POSITION_CONTROL_FAULT_ATTITUDE;
    }
    if (!position_height_safe)
    {
        return (uint8_t)POSITION_CONTROL_FAULT_HEIGHT;
    }
    return (uint8_t)POSITION_CONTROL_FAULT_NONE;
}

static bool PositionControl_AllGatesOpen(uint8_t mask)
{
    return mask == (POSITION_CONTROL_GATE_REQUEST |
                    POSITION_CONTROL_GATE_LINK |
                    POSITION_CONTROL_GATE_FLOW |
                    POSITION_CONTROL_GATE_STICKS |
                    POSITION_CONTROL_GATE_PERMISSION);
}

void PositionControl_Init(void)
{
    position_request = POSITION_CONTROL_DIAGNOSTIC_REQUEST_DEFAULT;
    position_link_ok = true;
    position_sticks_centered = true;
    position_control_permission = false;
    position_attitude_safe = false;
    position_height_safe = false;
    position_safety_context_valid = false;
    position_pilot_disarmed = false;
    position_flow_available = false;
    position_latched = false;
    position_recenter_frames = 0U;
    position_anchor_x = 0.0f;
    position_anchor_y = 0.0f;
    position_height_context_valid = false;
    position_height_cm = POSITION_CONTROL_REFERENCE_HEIGHT_CM;
    position_motion_suppressed = false;
    position_reanchor_after_motion = false;

    position_snapshot.valid = false;
    position_snapshot.request = position_request;
    position_snapshot.gate_mask = 0U;
    position_snapshot.state = (uint8_t)POSITION_CONTROL_STATE_WAITING;
    position_snapshot.velocity_update_count = 0U;
    position_snapshot.position_update_count = 0U;
    position_snapshot.position_forward_counts = 0.0f;
    position_snapshot.position_right_counts = 0.0f;
    position_snapshot.velocity_forward_cps = 0.0f;
    position_snapshot.velocity_right_cps = 0.0f;
    position_snapshot.anchor_x_counts = 0.0f;
    position_snapshot.anchor_y_counts = 0.0f;
    position_snapshot.fault_reason = (uint8_t)POSITION_CONTROL_FAULT_NONE;
    PositionControl_ResetOutput();
}

void PositionControl_SetRequest(bool requested)
{
    position_request = requested;
    position_snapshot.request = requested;
    position_snapshot.gate_mask = PositionControl_GetGateMask();
    if (!requested)
    {
        position_latched = false;
        position_anchor_x = 0.0f;
        position_anchor_y = 0.0f;
        position_recenter_frames = 0U;
        position_snapshot.fault_reason = (uint8_t)POSITION_CONTROL_FAULT_NONE;
        position_snapshot.state = (uint8_t)POSITION_CONTROL_STATE_DISABLED;
        PositionControl_ResetOutput();
    }
}

void PositionControl_SetPilotContext(bool link_ok, bool sticks_centered)
{
    position_link_ok = link_ok;
    position_sticks_centered = sticks_centered;
    position_snapshot.gate_mask = PositionControl_GetGateMask();
}

void PositionControl_SetSafetyContext(bool control_permission, bool attitude_safe, bool height_safe, bool pilot_disarmed)
{
    position_control_permission = control_permission;
    position_attitude_safe = attitude_safe;
    position_height_safe = height_safe;
    position_pilot_disarmed = pilot_disarmed;
    position_safety_context_valid = true;
}

void PositionControl_SetHeightContext(bool valid, float height_cm)
{
    position_height_context_valid = valid && (height_cm > 0.0f);
    if (height_cm > 0.0f) position_height_cm = height_cm;
}

void PositionControl_SetMotionSuppressed(bool suppressed)
{
    if (suppressed)
    {
        if (!position_motion_suppressed) PositionControl_ResetOutput();
        position_motion_suppressed = true;
        position_snapshot.motion_suppressed = true;
        return;
    }
    if (position_motion_suppressed)
    {
        position_motion_suppressed = false;
        position_reanchor_after_motion = true;
    }
    position_snapshot.motion_suppressed = false;
}

void PositionControl_Update(float sum_x, float sum_y, float vx_cps, float vy_cps, float dt_s)
{
    float rotated_position_forward;
    float rotated_position_right;
    float rotated_velocity_forward;
    float rotated_velocity_right;
    uint8_t gate_mask;
    uint8_t safety_fault;
    float alpha;
    float velocity_forward_error;
    float velocity_right_error;
    float position_kp;
    float position_ki;
    float position_kd;
    float velocity_kp;
    float velocity_ki;
    float velocity_kd;
    float derivative_alpha;
    float velocity_forward_derivative_raw;
    float velocity_right_derivative_raw;
    float height_scale;

    if (dt_s <= 0.0f) return;
    if (PositionControl_WaitForPilotDisarm()) return;

    height_scale = PositionControl_GetHeightScale();
    position_snapshot.height_scale = height_scale;

    if (position_motion_suppressed)
    {
        PositionControl_ResetOutput();
        position_snapshot.motion_suppressed = true;
        return;
    }

    /* 模块坐标 -> 机体系。位置与速度必须使用同一旋转，不能各写一套符号。 */
    rotated_position_forward = (POSITION_CONTROL_COS_YAW * sum_x) + (POSITION_CONTROL_SIN_YAW * sum_y);
    rotated_position_right = (-POSITION_CONTROL_SIN_YAW * sum_x) + (POSITION_CONTROL_COS_YAW * sum_y);
    rotated_velocity_forward = (POSITION_CONTROL_COS_YAW * vx_cps) + (POSITION_CONTROL_SIN_YAW * vy_cps);
    rotated_velocity_right = (-POSITION_CONTROL_SIN_YAW * vx_cps) + (POSITION_CONTROL_COS_YAW * vy_cps);
    /* 光流计数与 1/高度成正比；统一换算到参考高度量纲后再进两级环。 */
    rotated_position_forward *= height_scale;
    rotated_position_right *= height_scale;
    rotated_velocity_forward *= height_scale;
    rotated_velocity_right *= height_scale;

    gate_mask = PositionControl_GetGateMask();
    position_snapshot.request = position_request;
    position_snapshot.gate_mask = gate_mask;

    if (position_latched)
    {
        position_snapshot.state = (uint8_t)POSITION_CONTROL_STATE_LATCHED;
        PositionControl_ResetOutput();
        return;
    }

    if (!position_request)
    {
        position_snapshot.state = (uint8_t)POSITION_CONTROL_STATE_DISABLED;
        position_snapshot.fault_reason = (uint8_t)POSITION_CONTROL_FAULT_NONE;
        PositionControl_ResetOutput();
        return;
    }

    if (!position_link_ok)
    {
        if ((position_snapshot.state == (uint8_t)POSITION_CONTROL_STATE_ACTIVE) ||
            (position_snapshot.state == (uint8_t)POSITION_CONTROL_STATE_PILOT_MOVE))
        {
            PositionControl_LatchOffWithReason((uint8_t)POSITION_CONTROL_FAULT_LINK);
        }
        else
        {
            position_snapshot.state = (uint8_t)POSITION_CONTROL_STATE_WAITING;
            position_snapshot.fault_reason = (uint8_t)POSITION_CONTROL_FAULT_LINK;
            PositionControl_ResetOutput();
        }
        return;
    }

    if (!position_flow_available)
    {
        if ((position_snapshot.state == (uint8_t)POSITION_CONTROL_STATE_ACTIVE) ||
            (position_snapshot.state == (uint8_t)POSITION_CONTROL_STATE_PILOT_MOVE))
        {
            PositionControl_LatchOffWithReason((uint8_t)POSITION_CONTROL_FAULT_FLOW);
        }
        else
        {
            position_snapshot.state = (uint8_t)POSITION_CONTROL_STATE_WAITING;
            position_snapshot.fault_reason = (uint8_t)POSITION_CONTROL_FAULT_FLOW;
            PositionControl_ResetOutput();
        }
        return;
    }

    if (!position_sticks_centered)
    {
        if (position_snapshot.state != (uint8_t)POSITION_CONTROL_STATE_PILOT_MOVE)
        {
            position_snapshot.state = (uint8_t)POSITION_CONTROL_STATE_PILOT_MOVE;
            position_snapshot.fault_reason = (uint8_t)POSITION_CONTROL_FAULT_NONE;
            position_recenter_frames = 0U;
            PositionControl_ResetOutput();
        }
        position_snapshot.position_forward_counts = rotated_position_forward - position_anchor_x;
        position_snapshot.position_right_counts = rotated_position_right - position_anchor_y;
        position_snapshot.velocity_forward_cps = rotated_velocity_forward;
        position_snapshot.velocity_right_cps = rotated_velocity_right;
        position_snapshot.velocity_update_count++;
        return;
    }

    safety_fault = PositionControl_GetSafetyFault();
    if (safety_fault != (uint8_t)POSITION_CONTROL_FAULT_NONE)
    {
        if (position_snapshot.state == (uint8_t)POSITION_CONTROL_STATE_ACTIVE)
        {
            PositionControl_LatchOffWithReason(safety_fault);
        }
        else
        {
            position_snapshot.state = (uint8_t)POSITION_CONTROL_STATE_WAITING;
            position_snapshot.fault_reason = safety_fault;
            position_recenter_frames = 0U;
            PositionControl_ResetOutput();
        }
        return;
    }

    if (position_snapshot.state == (uint8_t)POSITION_CONTROL_STATE_PILOT_MOVE)
    {
        position_recenter_frames++;
        if (position_recenter_frames < POSITION_CONTROL_RECENTER_FRAMES)
        {
            position_snapshot.position_forward_counts = rotated_position_forward - position_anchor_x;
            position_snapshot.position_right_counts = rotated_position_right - position_anchor_y;
            position_snapshot.velocity_forward_cps = rotated_velocity_forward;
            position_snapshot.velocity_right_cps = rotated_velocity_right;
            position_snapshot.velocity_update_count++;
            PositionControl_ResetOutput();
            return;
        }

        /* 手动飞行结束：把当前机体位置作为新的定点原点。 */
        position_anchor_x = rotated_position_forward;
        position_anchor_y = rotated_position_right;
        position_snapshot.anchor_x_counts = position_anchor_x;
        position_snapshot.anchor_y_counts = position_anchor_y;
        position_snapshot.state = (uint8_t)POSITION_CONTROL_STATE_ACTIVE;
        position_snapshot.fault_reason = (uint8_t)POSITION_CONTROL_FAULT_NONE;
        PositionControl_ResetOutput();
    }

    if (!PositionControl_AllGatesOpen(gate_mask))
    {
        position_snapshot.state = (uint8_t)POSITION_CONTROL_STATE_WAITING;
        PositionControl_ResetOutput();
        return;
    }

    if (position_reanchor_after_motion)
    {
        position_anchor_x = rotated_position_forward;
        position_anchor_y = rotated_position_right;
        position_snapshot.anchor_x_counts = position_anchor_x;
        position_snapshot.anchor_y_counts = position_anchor_y;
        position_reanchor_after_motion = false;
        PositionControl_ResetOutput();
        return;
    }

    if (position_snapshot.state != (uint8_t)POSITION_CONTROL_STATE_ACTIVE)
    {
        /* 无扰切入：当前位置就是新的定点原点，旧累计量不带入。 */
        position_anchor_x = rotated_position_forward;
        position_anchor_y = rotated_position_right;
        position_snapshot.anchor_x_counts = position_anchor_x;
        position_snapshot.anchor_y_counts = position_anchor_y;
        position_snapshot.state = (uint8_t)POSITION_CONTROL_STATE_ACTIVE;
        position_snapshot.fault_reason = (uint8_t)POSITION_CONTROL_FAULT_NONE;
        PositionControl_ResetOutput();
    }

    position_snapshot.position_forward_counts = rotated_position_forward - position_anchor_x;
    position_snapshot.position_right_counts = rotated_position_right - position_anchor_y;
    position_snapshot.velocity_forward_cps = rotated_velocity_forward;
    position_snapshot.velocity_right_cps = rotated_velocity_right;
    position_snapshot.velocity_update_count++;

    PidTable_GetPositionParams(&position_kp, &position_ki, &position_kd);
    PidTable_GetVelocityParams(&velocity_kp, &velocity_ki, &velocity_kd);
    position_integral_forward += position_snapshot.position_forward_counts * dt_s;
    position_integral_right += position_snapshot.position_right_counts * dt_s;
    position_integral_forward = PositionControl_Clamp(position_integral_forward, -400.0f, 400.0f);
    position_integral_right = PositionControl_Clamp(position_integral_right, -400.0f, 400.0f);

    position_outer_divider++;
    if (position_outer_divider >= POSITION_CONTROL_OUTER_DIVIDER)
    {
        position_outer_divider = 0U;
        /* 目标恒为原点：偏前为正时给负速度目标，要求它向后回来。
           D 项使用位置误差的导数 -velocity，避免给静止噪声额外积分。 */
        position_snapshot.velocity_forward_sp_cps = PositionControl_Clamp(
            (-position_kp * position_snapshot.position_forward_counts) -
                (position_ki * position_integral_forward) -
                (position_kd * position_snapshot.velocity_forward_cps),
            -POSITION_CONTROL_VELOCITY_SP_LIMIT_CPS,
            POSITION_CONTROL_VELOCITY_SP_LIMIT_CPS);
        position_snapshot.velocity_right_sp_cps = PositionControl_Clamp(
            (-position_kp * position_snapshot.position_right_counts) -
                (position_ki * position_integral_right) -
                (position_kd * position_snapshot.velocity_right_cps),
            -POSITION_CONTROL_VELOCITY_SP_LIMIT_CPS,
            POSITION_CONTROL_VELOCITY_SP_LIMIT_CPS);
        position_snapshot.position_update_count++;
    }

    velocity_forward_error = position_snapshot.velocity_forward_sp_cps - position_snapshot.velocity_forward_cps;
    velocity_right_error = position_snapshot.velocity_right_sp_cps - position_snapshot.velocity_right_cps;

    velocity_integral_forward += velocity_forward_error * dt_s;
    velocity_integral_right += velocity_right_error * dt_s;
    velocity_integral_forward = PositionControl_Clamp(velocity_integral_forward, -400.0f, 400.0f);
    velocity_integral_right = PositionControl_Clamp(velocity_integral_right, -400.0f, 400.0f);
    velocity_forward_derivative_raw = (dt_s > 0.0f) ? ((velocity_forward_error - velocity_forward_error_prev) / dt_s) : 0.0f;
    velocity_right_derivative_raw = (dt_s > 0.0f) ? ((velocity_right_error - velocity_right_error_prev) / dt_s) : 0.0f;
    derivative_alpha = dt_s / (0.080f + dt_s);
    derivative_alpha = PositionControl_Clamp(derivative_alpha, 0.0f, 1.0f);
    velocity_forward_derivative += derivative_alpha * (velocity_forward_derivative_raw - velocity_forward_derivative);
    velocity_right_derivative += derivative_alpha * (velocity_right_derivative_raw - velocity_right_derivative);
    velocity_forward_error_prev = velocity_forward_error;
    velocity_right_error_prev = velocity_right_error;

    /* 前向加速度由 pitch 负（低头）产生；右向加速度由 roll 正（右倾）产生。 */
    position_snapshot.raw_roll_deg = PositionControl_Clamp(
        velocity_kp * velocity_right_error + velocity_ki * velocity_integral_right + velocity_kd * velocity_right_derivative,
        -POSITION_CONTROL_ANGLE_LIMIT_DEG,
        POSITION_CONTROL_ANGLE_LIMIT_DEG);
    position_snapshot.raw_pitch_deg = PositionControl_Clamp(
        -(velocity_kp * velocity_forward_error + velocity_ki * velocity_integral_forward + velocity_kd * velocity_forward_derivative),
        -POSITION_CONTROL_ANGLE_LIMIT_DEG,
        POSITION_CONTROL_ANGLE_LIMIT_DEG);

    alpha = dt_s / (POSITION_CONTROL_FILTER_TAU_S + dt_s);
    alpha = PositionControl_Clamp(alpha, 0.0f, 1.0f);
    position_snapshot.roll_deg += alpha * (position_snapshot.raw_roll_deg - position_snapshot.roll_deg);
    position_snapshot.pitch_deg += alpha * (position_snapshot.raw_pitch_deg - position_snapshot.pitch_deg);
    position_snapshot.valid = true;
}

void PositionControl_SetFlowAvailable(bool available)
{
    position_flow_available = available;
    position_snapshot.gate_mask = PositionControl_GetGateMask();
    /* Flow 轮询也处理上锁；无需等下一帧光流，旋转冻结或暂时无帧时同样退等待。 */
    if (PositionControl_WaitForPilotDisarm()) return;
    if (!available && ((position_snapshot.state == (uint8_t)POSITION_CONTROL_STATE_ACTIVE) ||
                       (position_snapshot.state == (uint8_t)POSITION_CONTROL_STATE_PILOT_MOVE)))
    {
        PositionControl_LatchOffWithReason((uint8_t)POSITION_CONTROL_FAULT_FLOW);
    }
    else if (!available && position_request && !position_latched)
    {
        position_snapshot.fault_reason = (uint8_t)POSITION_CONTROL_FAULT_FLOW;
    }
}

void PositionControl_GetSnapshot(PositionControlSnapshot_t *snapshot)
{
    if (snapshot == NULL) return;

    /* 位置快照由 flowTask 写入，安全门禁由 250Hz 控制环发布；
       输出读取先经过安全门禁，避免跨任务沿用旧姿态目标。 */
    *snapshot = position_snapshot;
    /* 控制环发布安全状态的频率高于 Flow；在 Flow 下一帧锁存前，
       读取接口也必须先把姿态目标视为无效，避免未来接入姿态环时多用一拍旧输出。 */
    if (!position_safety_context_valid || !position_control_permission || position_pilot_disarmed ||
        !position_attitude_safe || !position_height_safe)
    {
        snapshot->valid = false;
        snapshot->velocity_forward_sp_cps = 0.0f;
        snapshot->velocity_right_sp_cps = 0.0f;
        snapshot->raw_roll_deg = 0.0f;
        snapshot->raw_pitch_deg = 0.0f;
        snapshot->roll_deg = 0.0f;
        snapshot->pitch_deg = 0.0f;
    }
}
