Nyxarian/ApexFly-v2.0/ApexFly v2.0/Modules/Control/vertical_control.h

/**
 * @file vertical_control.h
 * @brief 定高模式的状态机、两层门禁与摇杆映射对外接口。
 *
 * 本模块回答五个问题：
 *   1. 现在处于哪个模式（普通 / 定高），以及遥控的请求要不要接受；
 *   2. 目标高度 h_sp 是多少（油门杆三段映射 + 积分得到）；
 *   3. 飞机在地面上时进入"停手"，控制器什么都不做；
 *   4. 定高模式下基础油门该给多少（H8 起接管，见 GetThrottleUs）；
 *   5. 垂速内环该给多少修正量（H9 起，见 VERTICAL_INNER_CORR_LIMIT_US）。
 *
 * 本模块**不写电机、不打印、不做外环**。内环积分（= 悬停油门学习器）在 H10，
 * 外环（h_sp − h_est → vz_sp）与 h_sp 的真正接入在 H13。
 * 这样安排的用意：门禁、模式状态机、停手是最容易出人命的逻辑，
 * 先在"完全没有执行权限"的状态下于台架上验完（H6），再让它碰油门（H8），
 * 最后才让修正量真的推动电机（H9）——每一步都能单独回退。
 *
 * ── 谁驱动它、谁看它 ──────────────────────────────────────────
 * 驱动：`motor_test.c` 的控制环每拍调用一次 `VerticalControl_Update()`（250Hz）。
 *       姿态角、解锁状态、链路状态、遥控杆量全部由调用方传进来，本模块不自己跨模块取数。
 *       它内部只读一个东西：`vertical_est` 的高度/垂速估计。
 * 查看：`tof.c` 的低优先级任务每 500ms 调一次 `VerticalControl_GetSnapshot()` 打印。
 *       控制环里**禁止打印**（一行日志约 10ms，会吃掉两拍 4ms 预算），所以打印留在那边。
 *       ⚠️ 一写多读，结构体拷贝不是原子的，打印出来的字段理论上可能来自相邻两拍。
 *       对诊断没有影响，但知道这件事比不知道好。
 *
 * ── 定高是一个"独立模式"，不是一个开关 ────────────────────────
 * 切进这个模式后油门杆不再直通油门，而是三段式（下降 / 保持 / 上升）。
 * 模式**只在地面、且杆在最低位时才允许切换**（门禁①），所以一次飞行只能用一个模式。
 * 完整设计（含为什么取消"待命段"、为什么必须有"停手"）见
 * `优化一下/高度接入飞控方案.md` 第 5 节。
 */

#ifndef VERTICAL_CONTROL_H
#define VERTICAL_CONTROL_H

#include <stdbool.h>
#include <stdint.h>

#ifdef __cplusplus
extern "C" {
#endif

/* ── 摇杆三段 ──────────────────────────────────────────────────
   定高模式下油门杆的三段边界与目标高度变化率，单位厘米每秒，向上为正。
   段与段之间速率连续（在 350 和 650 处都是 0），所以边界上不会抖。

   ⭐ 三段就是飞行员看到的三件事（**本次飞行要实现的就是这个手感**）：
       杆 0~350   下降段：0 → −VERTICAL_RATE_DOWN_CMS
       杆 350~650 保持段：恒 0（h_sp 冻结，松手就稳住）
       杆 650~1000 上升段：0 → +VERTICAL_RATE_UP_CMS

   ⚠️ **2026-09-15 由 −2/+3 改成 −5/+5**（用户决定，飞前定）：
      起因是"下区域要能当**降落**用"—— 原来的 2cm/s 意味着**从 1 米落地要 50 秒**，
      实飞时飞行员会以为"杆拉到底了怎么不掉下来"。5cm/s 时 1 米约 **20 秒**，可以接受。
      上升同时提到 5 是为了**快慢对称**（原来上升 3、下降 2，飞行员会觉得两边手感不一样）。
   ⚠️ 取 5 而不是更大：这两条速率是"取消待命段"之后的**保护**——
      飞行员慌乱中把杆收到底，飞机是"以 5cm/s 缓降"而不是"掉下来"。
      真掉下来的速率量级是 **300+ cm/s**（自由落体 1 秒就 2m/s），5 与它差两个数量级，
      保护性质仍然成立。要再快就得上分段（如 0~200 快降 / 200~350 慢降），属后续。
   ⚠️ 它们是**代码常量、遥控改不了**，要改必须重烧。 */
#define VERTICAL_STICK_HOLD_LOW 350U
#define VERTICAL_STICK_HOLD_HIGH 650U
#define VERTICAL_STICK_MAX 1000U
#define VERTICAL_RATE_DOWN_CMS 5.0f
#define VERTICAL_RATE_UP_CMS 5.0f

/* 目标高度 h_sp 的钳位，单位厘米。
   下限必须是 0 而不是 2：飞机放在平面上 h_est≈0.8cm，下限若高于它，
   外环会永远存在一个正误差，把飞机在地面上就顶起来。
   上限 120cm 给 ToF 的 1.3m 量程留 10cm 余量。 */
#define VERTICAL_H_SP_MIN_CM 0.0f
#define VERTICAL_H_SP_MAX_CM 120.0f

/* ── 门禁阈值 ────────────────────────────────────────────────── */

/* 门禁①"杆在最低位"的上限。写 50 而不是 0，是为了容忍摇杆的机械与校准余量。 */
#define VERTICAL_SWITCH_STICK_MAX 50U

/* 门禁①"高度上限"，单位厘米。超过它认为飞机已经在可信工作区之外。 */
#define VERTICAL_MODE_MAX_HEIGHT_CM 120.0f

/* 姿态平稳的倾角上限，单位度（横滚、俯仰各自判断）。
   超过它 cosθ 倾斜补偿就不再有意义，高度读数不能用。

   ⚠️ **同一个阈值管两件事**（改之前必须知道，它们会一起动）：
     ① **门禁②的 `ATT_OK` 位**（`VerticalControl_EvalControlGates`）——
        「姿态平稳才允许控制」；
     ② **H12 的失效判据 `fr=2`**（`VerticalControl_EvalFailReason`）——
        「姿态超限 ⇒ 判定炸机 ⇒ 立即停桨」。

   ⚠️ **2026-09-15 由 25 改成 30**（用户决定，飞前定）。理由：
     满杆角度是 `ATTITUDE_STICK_MAX_ANGLE_DEG`，而它被改到了 **15°**（见 `attitude_control.c`）。
     25° 的门禁对 15° 满杆只留 10° 余量 —— 打满杆再加一阵扰动就可能触发 `fr=2`，
     而 `fr=2` 的含义是**立即停桨**（不是缓降）。30° 留 15° 余量，安全得多。
   ⭐ 30 也正是**方案 §6.1 的原值**：H12 实施时按"与门禁用同一个值"的理由把它改成了 25，
     现在因为满杆角度变大又改回 30 —— 两次都不是随手改的，理由都记在这里。
   ⚠️ 前提是**满杆角度不超过 20°**。若以后再把满杆角度调大，这个值必须一起重看。 */
#define VERTICAL_CONTROL_MAX_TILT_DEG 30.0f

/* ── 停手（地面待机）──────────────────────────────────────────
   飞机在地面上时控制器必须什么都不做：油门压最低、内外环冻结。
   不做这件事的后果是确定性的，不是概率性的：
   杆在最低位给的是 −5cm/s，h_sp 被钳到 0，而地面 h_est≈1~3cm，
   外环误差为负 → 内环把油门往下压 → 输出掉到 1100µs 以下
   → 命中"输出 < 1100µs 持续 > 500ms"的失效判据 → 定高在地面上自己退出。 */

/* 停手进入门槛：估计高度不超过这么多厘米，**并且本拍摇杆没有在命令爬升**
   （目标变化率 ≤ 0），且连续满足下面的时间去抖。
   为什么要加"没在命令爬升"这一条：飞机在地面上、飞行员推杆要起飞时，h_est 还是地面读数，
   不加它就会在推杆 500ms 之后被重新判成停手，把刚发出的爬升指令按回去。
   而"被气流或障碍物压到地面、杆还停在中位"那种情况变化率是 0，照样能进——
   这正是当初决定**不**要求"杆必须在最低位"的那个场景。
   ⭐ **2026-09-15 补充（改成"推杆即解手"之后）**：本条件**一个字没改** —— 落地就进停手就是要这样。
      那"刚解手、杆还停在下降段，会不会 500ms 后又判回停手"？由**起飞保护**挡着
      （它的清除条件改成了"杆 ≤ 100"）。⇒ 这里是**进入看高度、滞回看杆量**，分工明确：
      ⚠️ 千万不要把"杆 ≤ 100"加进**本条件** —— 那样"杆停在中位落地"就永远进不了停手，
      飞机已经在地上了电机还在转，与"落地就进停手"直接冲突。

   ⭐ **2026-09-15 改成 4.0**（用户决定，飞前定）。原来的 6.0 是【垫高台架的测试值】。
   改这一条的**规矩**（有待办 3 的教训撑着，别机械照抄任何数）：
     ① 实测**撤掉垫块后**的地面静止读数；② 门槛取 **实测读数 + 1~2cm**；
     ③ **门槛绝不能小于地面读数**，否则停手永远进不去 —— 2026-09-14 就是这么翻车的
        （门槛 2.0、读数 4cm ⇒ `st` 一直 1、`gt` 一直 0ms）。
   实测参考：2026-09-15 同一台架（垫高）地面读数 = **2.4~3.2cm、中位 2.8cm**（2137 个样本）；
   旧文档里"不垫高约 1cm"来自更早的镜头安装状态，**不能照用**。
   ⇒ 取 **4.0** 的前提是**地面读数 ≤ 3cm**。
      ⚠️ **飞之前先在地面上看一眼 `h`**：若静止 `h` 已经 ≥ 3.5cm，就把本值再抬 1~2cm（**要重烧**）。
   反方向的风险同样记住：门槛太高会把"4~6cm 的低空悬停"误判成停手
   （油门压最低 ⇒ 掉下来）。方案 §15.3 第四个坑。 */
#define VERTICAL_GROUND_ENTER_H_CM 4.0f

/* 停手进入去抖时间，单位毫秒。
   没有它，起飞擦地时 h_est 瞬时跌破门槛会造成"停手 ↔ 控制"来回抖。
   ⚠️ 这个时间**必须与门槛和下降速率一起看**：擦地起飞的抖动周期约为
      `门槛 / 下降速率`，门槛 4cm、速率 5cm/s 时约 **0.8 秒** —— 去抖 500ms 比它短，
      所以**不会**把一次正常的擦地起飞判成停手（这正是当初取 500 的依据）。
      若以后把门槛调高或把速率调慢，这个 500 要跟着重算（否则会误判）。 */
#define VERTICAL_GROUND_ENTER_HOLD_MS 500U

/* ── 停手退出：**推杆即解手**（2026-09-15 改）──────────────────
   退出条件 = **已解锁** 并且 **油门杆从低位推过 VERTICAL_GROUND_EXIT_STICK**，
   而且是**边沿**（上一拍杆在低位、这一拍推上去），不是"杆 > 200 就行"。

   ⭐ 为什么从"`h_sp` 攒过 4cm"改成杆量判据：
      原来那个出口要求 `h_sp > 4cm`，而 `h_sp` **只在杆 >650（上升段）时才涨**
      ⇒ 杆在下降段（0~350）和中间段（350~650）推得再多，**电机一点都不转**
      （油门恒 1000µs），想解手必须推到上升段再保持约 0.8 秒。
      飞行员要的是"推一点就转起来、推多少转多少"，那杆的位置本身就该是判据。

   ⚠️ **为什么必须是边沿**：否则"锁着的时候先把杆推到 1000、再解锁"会在解锁那一拍
      直接解手 ⇒ 一上来就给 1250µs。边沿挡掉了这条隐患。
      飞行习惯上不别扭 —— 解锁本来就是在杆最低时做的。

   ⚠️ **为什么只要求 `armed`**：解手之后油门就交给控制器了
      （1000 → 0.31s 爬到 1250，再花 8~13 秒把悬停油门学出来），
      "解锁"就是唯一需要的许可。杆在下降段/中间段照样解手，电机照样转。 */
#define VERTICAL_GROUND_EXIT_STICK 200U

/* "杆在低位"的判据，一个值管两件事（**必须一起看**）：
     ① 上面的解手**边沿的下沿** —— 杆必须先降到 ≤ 本值，再推过 200 才算解手；
     ② **解除起飞保护**（`VERTICAL_TAKEOFF_GUARD_CLEAR_H_CM` 那一条的 ②）。
   取 100 而不是 0：给摇杆的机械与校准余量留空间。
   ⚠️ 与门禁①的 `VERTICAL_SWITCH_STICK_MAX`（50）**不是一回事**，不要合并：
      那个要求"杆精确在最低位"才允许**切模式**，这个只要求"飞行员把杆收回来了"。 */
#define VERTICAL_GROUND_STICK_LOW 100U

/* 停手退出后的"起飞保护"清零高度，单位厘米。
   ⚠️ 这一条是 H6 写代码时用仿真抓出来的，不加会有一个**飞机永远起飞不了**的死循环：
   退出停手只说明"飞行员命令了爬升"，飞机此刻还在地面上（h_est 仍是 0.8cm）。
   如果不加保护，退出后 500ms 去抖一满就又被判成停手，
   于是 h_sp 被按回 0.8、油门压最低 —— 推杆、被按回、再推杆，来回死循环。
   电池电压低或载重大（推力偏弱、500ms 内离不了 2cm）时必然发生。
   清掉保护的两个条件（任一满足）：
     ① 高度已经明显离地（> 这个值），说明这次起飞真的成功了；
     ② **杆回到低位**（≤ `VERTICAL_GROUND_STICK_LOW`）—— 飞行员把杆收回来了。
   ⚠️ ② 原文是"杆回到下降段（变化率 < 0）"，2026-09-15 改成杆量判据，原因是**必改**的：
      改后"解手"由**推杆**触发（杆 > 200），而**杆处在下降段时变化率正好是负的**
      ⇒ 解手那一拍保护就被清掉 ⇒ 500ms 去抖一满又被判回停手
      ⇒ 电机**转一下、停一下**来回抖。
      改成"杆 ≤ 100 才清"之后，从解手到收杆这一段被挡住，**滞回宽度 100（200 解手 / 100 才准回）**。
   ⚠️ 另外 **`!armed`（上锁）时会直接把本保护清零**，见 `vertical_control.c` 的 ⑥ 段：
      上锁是"一次飞行"的硬边界。不清的话——"解手后没飞起来就上锁、再解锁"会带着
      上一次的 `true` 出来 ⇒ 进不了停手 ⇒ 解锁后油门直接 1250（地面上电机转起来）。 */
#define VERTICAL_TAKEOFF_GUARD_CLEAR_H_CM 10.0f

/* 门禁①（模式切换）的通过位，全通才允许切换。
   ⚠️ 位 0 同时要求"链路正常"：失联时 armed 也是 false，
   光看 armed 会把"空中失联"误判成"在地面上"，从而在半空中把模式切了。 */
#define VERTICAL_GATE_SW_ON_GROUND 0x01U
#define VERTICAL_GATE_SW_STICK_LOW 0x02U
#define VERTICAL_GATE_SW_EST_VALID 0x04U
#define VERTICAL_GATE_SW_HEIGHT_OK 0x08U
#define VERTICAL_GATE_SW_ALL 0x0FU

/* 门禁②（控制启用）的通过位，全通才算控制器真的在干活。 */
#define VERTICAL_GATE_CT_ARMED 0x01U
#define VERTICAL_GATE_CT_EST_VALID 0x02U
#define VERTICAL_GATE_CT_ATT_OK 0x04U
#define VERTICAL_GATE_CT_NOT_GROUND 0x08U
#define VERTICAL_GATE_CT_ALL 0x0FU

/* ── 定高油门（H8 起，H10 重构）──────────────────────────────
   ⭐⭐ 定高模式的基础油门是**两层之和**，两层职责完全不同，不要合并：

       电脑给的油门 = 慢层：积分器（悬停油门估计器）   ← 由 vz_ki 驱动
                    + 快层：垂速内环 P(+D) 修正量      ← 由 vz_kp 驱动
                    → 再整体钳到 [地板, 天花板]

   **慢层**回答"悬停需要多少油门"——它是一个**物理事实**（由重量、电压、桨叶决定），
   我们无法预先知道，只能让它自己收敛出来。方案 §2.3 那句"积分器就是悬停油门估计器"
   说的就是这一层。H9 时它还不存在，所以基准只能是一个死数 1250，
   而 1250 低于真实悬停（约 1420）⇒ 无论 P 增益调到多大都补不上这个缺口 ⇒
   定高在物理上建立不了悬停。这正是 H10 存在的理由。
   **快层**负责"快速压住垂速摆动"，就是 H9 已经实测验过符号的那个阻尼器。

   ⭐ H13 起快层的**目标垂速 `vz_sp` 不再是常数 0**，改由外环给出（见下一段）。 */

/* ── 外环：高度 → 目标垂速（H13）──────────────────────────────
   ⭐⭐ 整条串级的形状（**分段**，不是一次算完）：

       摇杆 →【速率 cm/s】→ 积分 →【目标高度 h_sp cm】→ 外环 P →【目标垂速 vz_sp cm/s】
            → 内环 PID →【油门修正量 µs】→ 加上慢层悬停油门估计 → 基础油门

   外环是这一环**唯一**要做的事：把"目标高度与实际高度的差"变成"内环该追的速度"。

       vz_sp = clamp( h_kp × (h_sp − h_est)， ±VERTICAL_OUTER_VZ_SP_MAX_CMS )，死区内为 0

   ⚠️ **稳态精度就是死区宽度（±2cm）**：稳态时必须有 `vz_sp = 0`
      （悬停意味着 vz = 0，而内环把 vz 压到 vz_sp），
      而 P-only + 死区 ⇒ 误差落进死区就不再出力 ⇒ 停在目标 ±2cm 内任意处。
      要更准得上 `h_ki`（协议 ID 31 已预留），那是 H15 的活。

   ⚠️⚠️ **为什么增益必须比 §3.3 的设计值（0.6）保守** —— H13 方案阶段算出来的：
      回路延迟**消不掉**：ToF 一步 20ms、4 步一个测量周期 = **83ms**，
      再加差分垂速、低通，以及限速器（±50µs 满幅修正要走 125ms）；§3.8 的滞后预算是 60ms。
      手算相位裕度：悬停点附近 d(推力比)/du = 2/415 ⇒ 修正量每变 1µs，向上加速度变 4.7cm/s²；
      内环 `corr = −Kp_v·vz` 的闭环时间常数 = 1/(Kp_v × 4.7)；`Kp_v=20` 时只有 **11ms**，
      比延迟快 8~15 倍 ⇒ **相位裕度必然为负**。
      仿真（`sim_h13_takeoff.js`）也确认：60~80ms 延迟下 `vz_kp=20 / h_kp=0.6`
      **进入极限环**（末段垂速 ±27cm/s）；延迟 0 时同一组参数完全稳定。
      ⇒ **首飞参数：`vz_kp` 从 2 起步、`h_kp` 从 0.3 起步**（都别用设计值/默认值）。
      ⚠️ 真正该动的是 `vz` 的**来源**（H16 加计融合），不是继续调增益。

   ⚠️⚠️ **上面那段的第一版结论写错过，更正如下（别照抄旧版本）**：
      H13 初稿把"极限环"归因到**外环**，因此把 `h_kp` 从 0.6 降到 0.3；
      后来把 `vz_kp` 单独扫了一遍（`sim_h13_takeoff.js` 最后那张表）才发现：
        延迟 80 / 100 / 120ms 下，`vz_kp ≤ 2` 稳、**`≥ 3` 就开始振荡**；
        而把 `vz_kp` 定成 2 之后，**`h_kp` 取 0.2~0.8 全都稳**。
      ⇒ **瓶颈是内环，不是外环。** `h_kp = 0.3` 这个值**仍然保留**（保守起步，
        之后往上加不用重烧 —— 它是遥控可调的），但**理由要更正**：
        它不是因为"延迟"才取 0.3，而是"首飞先保守"。
      ⇒ 顺序也记住：**先定内环（`vz_kp`），再定外环（`h_kp`）**。
      ⚠️ 表里 160ms 那一列是"连 `vz_kp=1` 都振荡" —— 说明**总延迟若真到 160ms，
         调增益救不了**，只能等 H16。真实 `vz` 通道延迟估计在 100~150ms
         （差分垂速要跨两个 ToF 采样点，比高度通道更慢）。

   ⚠️ 该模型（一维、无噪声、无姿态动力学）只能定"量级"，定不了精确值 ——
      真值要靠 H15 用黑匣子数据整定。往保守方向错的代价是"反应迟钝"，
      往激进方向错是炸机，所以一律先保守。 */

/* 外环死区，单位厘米。界内输出 0（**硬死区**）。
   取 2cm 是方案 §3.3 定的数；它同时**就是稳态精度**（见上）。
   ⚠️ 为什么是硬死区而不是"界外再减掉死区"的连续死区：
      连续死区平滑，但会留下一个**固定的系统偏差** —— 稳定停在目标**下方 2cm**
      （因为要维持"误差 = 死区"才有输出）。硬死区没有这个偏差，
      代价只是边界上有个 `h_kp × 死区` 的小台阶（默认 0.3 × 2 = **0.6cm/s**，
      相对 ±20cm/s 的限幅很小，不至于引起明显抖动）。 */
#define VERTICAL_OUTER_DEADBAND_CM 2.0f

/* 外环输出（目标垂速）的限幅，单位厘米每秒，**对称**。方案 §3.3 的值。
   ⚠️ 它只在 `|误差| > 20 / h_kp ≈ 67cm` 时才真正顶到，
      所以首飞把目标高度定在 15~30cm 时它是"备而不用"的保险。 */
#define VERTICAL_OUTER_VZ_SP_MAX_CMS 20.0f

/* 外环积分限幅 = 输出上限 × 本比例，沿用 `attitude_control.h` 的既有约定
   （外环 0.15 / 内环 0.25）。H13 阶段 `h_ki = 0`，本值不起作用；
   放在这里是为了将来开 `h_ki` 时不用再动限幅语义。 */
#define VERTICAL_OUTER_I_LIMIT_RATIO 0.15f

/* ── 慢层：积分器（H10）────────────────────────────────────── */

/* 积分器的**初值**，单位微秒。也是"刚进入控制启用"那一刻的油门。
   取 1250 的用意：① 与 H9 的固定基准同值，**进控制时油门不跳变**；
   ② 它在 [地板, 天花板] 中间偏下，给双向都留了行程。
   ⚠️ 这个值**不是**悬停油门，只是"从哪儿开始学"。真实悬停只能由积分收敛出来。
   ⚠️ 每次 Pid_ApplyParams / 模式复位之后都必须把它写回积分器：
      否则积分从 0 起算，输出会变成 0 + P ≈ 0 ⇒ **电机停转**（这是本环节最危险的一处）。 */
#define VERTICAL_THROTTLE_START_US 1250.0f

/* 积分器（= 慢层油门）的钳位，单位微秒。
   ⚠️⚠️ **地板和天花板必须同时钳住"积分值"和"最终输出"**，两把锁是同一对数字。
      只钳输出不钳积分的话，积分会偷偷涨到几千而表面看不出来，
      表现成"长期死死顶在天花板（饱和）"，一旦条件变化立刻猛冲 —— 这就是 windup。

   地板 1150：
     ① **绝不能是 1000**：那是电机停转 = 空中停车；
     ② **必须 > 混控有效下限 1100**：`motor_test.c` 的判据是 `thr <= 1100` 就
        绕过姿态环（四路等值 + AttitudeControl_Reset()）。地板若 ≤1100，
        飞机在空中会没有姿态修正。留 50µs 余量。
   天花板 1650：
     ① 悬停估计约 1420（据"1450 左右能起飞"倒推），留约 230µs 向上余量；
     ② 不跟 `max_throttle_us` 走：那个参数同时是普通模式的满杆油门，
        跟着它会让"调手动手感"意外改变定高行为。两者解耦，各管各的；
     ③ 不给更高，是因为基础油门越接近物理上限 2000，留给姿态差速的空间越小
        （混控在余量不足时会统一缩放三轴修正，**被牺牲的永远是姿态**）。
        1650 时向上还有 350µs，充裕。 */
#define VERTICAL_CONTROL_THROTTLE_MIN_US 1150.0f
#define VERTICAL_CONTROL_THROTTLE_MAX_US 1650.0f

/* ── 快层：垂速内环修正量（H9 起）──────────────────────────── */

/* 修正量的硬限幅，单位微秒，**对称**。
   H9 时是 30（当时的任务是"只验符号"，故意压小让台架安全）；
   H10 放到 **50**，理由：
   ① ⭐ 与首飞计划一致——H14 写着"修正量限到 ±50µs 起步"，取 50 则首飞不用再改代码；
   ② 取 80 的话首飞振荡风险偏高（权限是 30 的 2.7 倍），而这是第一次飞这个环；
   ③ 真正该调的旋钮是 `vz_kp`（遥控可改、不用重烧），
      所以"给 50 的安全网 + 慢慢加 Kp"比"给 80 的大网"更可控。
   ⚠️ `vz_kp = 20` 时饱和点是 50/20 = 2.5cm/s：手推飞机（实测能到 ±35cm/s）
      会顶到限幅，但静置噪声（σ=0.47cm/s）不会 —— 这正是想要的形状。
   ⚠️ 本值在台架上**验不出好坏**（手是"无限权限"的扰动源），真值靠 H14/H15 飞行整定。 */
#define VERTICAL_INNER_CORR_LIMIT_US 50.0f

/* ── 失效处理（H12）──────────────────────────────────────────
   ⭐ 这一段的由来：H10 真机实测里 **41/451 个样本（约 9% 的时间）处于"空中停车"** ——
      门禁②一抖（姿态歪超倾角门禁、ToF 掉一下）就 `GetThrottleUs()` 返回 1000，
      而 1000 同时**旁路了姿态环**（`motor_test.c` 的判据是 `thr <= 1100` 就四路等值 +
      `AttitudeControl_Reset()`）⇒ 飞机是**翻滚着砸下来**的。
      地面上的停手返回 1000 完全正确；**空中**返回 1000 是致命的。两者原来走了同一行代码。

   ⭐⭐ 现在的做法：把"能不能开始控制"（门禁②）和"控制中途抖了怎么办"（失效处理）
      拆成两件事。失效不再是"立刻停车"，而是：

        st=1 控制启用 ──门禁②失效──► st=6 失效保持（2 秒）
                                          ├─ 恢复 ──► 回 st=1（慢层/快层原封不动 ⇒ 无缝）
                                          └─ 超时 ──► st=7 失效下降
                                                        从锁存油门按 30µs/s 降到 1000，不再回头

   ⚠️⚠️ **姿态超限是唯一的例外，它不进保持段**（见 VERTICAL_FAIL_ATTITUDE 的说明）。 */

/* 失效保持时长，单位毫秒。
   这一段是**纯赚的**：ToF 的失效有相当一部分是瞬时的（反光地面、丢帧、
   `too many misses → re-init`，H10 实测里就出现过 3 次），本来什么都不用做。
   保持段里飞机用"失效前的悬停油门"近似悬停，恢复后无缝继续。
   ⚠️ 它**不增加落地速度**：保持段油门锁在悬停值 ⇒ 飞机就悬在那儿，
      2 秒后从同样的初始条件开始降，落地速度与"立刻开始降"完全一样（仿真实测 1.86 vs 1.86 m/s）。
   ⚠️ 它是 2026-09-15 用户定的值（"先保持两秒"）。 */
#define VERTICAL_FS_HOLD_MS 2000U

/* 失效下降的斜率，单位微秒每秒。
   ⚠️ 必须 ≤ `motor_test.c` 的下降限速 300µs/s，否则会被限速器卡住、白设。
      取 30 远低于它 ⇒ **限速器不参与**，实际曲线就是本值算出来的直线（验收时直接量它）。
   ⭐ 定这个值的依据（`sim_failsafe_ramp.js`，从 1.0m 掉下来的落地速度）：
        立刻停车（旧行为）  4.43 m/s（等价从 1.0m 自由落体）
        20µs/s              1.64 m/s（13.6cm）
        30µs/s              1.86 m/s（17.7cm）   ← 采用
        50µs/s              2.19 m/s（24.4cm）
      20 与 30 的落地速度只差 0.22m/s，但"落地后桨还要转多久"差 7 秒
      （19.2s vs 12.4s）⇒ 取 30 更划算。**冲击能量降到旧行为的 1/6。**
   ⚠️ 比落地速度更重要的是：`thr` 全程 ≥ 1150 ⇒ **姿态环始终有效 ⇒ 水平着地**。
      旧行为下 1000 会旁路姿态环，飞机是翻滚着砸下来的。 */
#define VERTICAL_FS_RAMP_US_PER_S 30.0f

/* 高度越界的进入门槛，单位厘米。超过它认为飞机已经在可信工作区之外
   （ToF 量程 1.3m、h_sp 上限 120cm）⇒ 走与"读数失效"同一套失效处理。
   ⚠️ 与门禁①的 `VERTICAL_MODE_MAX_HEIGHT_CM`(120) 不是一回事：
      那个管"能不能在地面上切进定高"，这个管"飞起来之后越界了怎么办"。 */
#define VERTICAL_FS_H_MAX_CM 125.0f

/* 高度越界的**恢复**门槛，单位厘米。必须比进入门槛低，否则会在边界上来回穿：
   h_sp 的上限就是 120cm，飞机很容易在 124~126 之间游走，
   两个门槛取同一个值就是"保持 ↔ 控制"反复切换。
   姿态与读数两条判据是状态量、天然不带滞回，不需要第二个门槛。 */
#define VERTICAL_FS_H_RECOVER_CM 115.0f

/**
 * @brief 实际生效的模式。给遥测 flight_mode 用。数值与协议约定一致，不要改。
 */
typedef enum
{
    /* 普通 / 手动：油门杆直通油门。 */
    VERTICAL_MODE_MANUAL = 0U,
    /* 定高：油门杆三段式。 */
    VERTICAL_MODE_ALT_HOLD = 1U
} VerticalControlMode_t;

/**
 * @brief 高度控制的细分状态。给黑匣子 altitude_state 与串口打印用。
 *
 * 为什么"模式"和"状态"要分开：模式只回答"切没切进定高"，
 * 状态还要回答"控制器有没有真的在干活"。混成一个量，
 * 出问题时分不清是"根本没切进模式"还是"切进去了但门禁没过"。
 */
typedef enum
{
    /* 普通模式，定高完全没参与。 */
    VERTICAL_STATE_MANUAL = 0U,
    /* 定高模式，门禁②全通，控制器在干活。 */
    VERTICAL_STATE_ALT_HOLD = 1U,
    /* 自动起飞（预留，本阶段不会产生）。 */
    VERTICAL_STATE_AUTO_TAKEOFF = 2U,
    /* 自动降落（预留，本阶段不会产生）。 */
    VERTICAL_STATE_AUTO_LAND = 3U,
    /* 定高模式，处于停手（地面待机）。 */
    VERTICAL_STATE_GROUNDED = 4U,
    /* 定高模式已切进去，但门禁②没过，控制器还没动。 */
    VERTICAL_STATE_IDLE = 5U,
    /* 定高模式在飞，门禁②失效了，**油门锁存、等它恢复**（H12）。
       ⚠️ 与 IDLE 的区别：IDLE 是"控制器没在干活，油门给最小值"，
          本状态是"控制器停手了，但**油门必须保住**"——保不住就是空中停车。 */
    VERTICAL_STATE_FAILSAFE_HOLD = 6U,
    /* 定高模式在飞，失效保持期满，**油门正按 30µs/s 降到 1000**（H12）。
       到底后停住（1000 = 电机停转），保持本状态直到上锁。 */
    VERTICAL_STATE_FAILSAFE_DESCEND = 7U
} VerticalControlState_t;

/**
 * @brief 进入失效的原因。给串口打印、黑匣子与遥测用。数值会进遥测 bit5-6，不要改。
 *
 * 为什么要有它：失效之后光看 `st=6/7` 并不知道"飞机到底怎么了"。
 * 台架故障注入时它是唯一的判据来源，飞行中它是唯一能事后复盘的东西。
 */
typedef enum
{
    /* 没失效。 */
    VERTICAL_FAIL_NONE = 0U,
    /* ToF 读数失效（估计器 `valid=false`，含超量程、I2C 掉线、连续丢帧后 re-init）。
       ⇒ 进保持段等恢复，超时后慢降。 */
    VERTICAL_FAIL_SENSOR = 1U,
    /* 姿态超限（|roll| 或 |pitch| ≥ VERTICAL_CONTROL_MAX_TILT_DEG）。
       ⚠️⚠️ **这一条不进保持段、不慢降，直接压到 1000**（2026-09-15 用户决定）：
          "姿态超过倾角门禁一般就是撞上东西了（电线、大风），以现在的硬件基础已经很难找回，
           就默认撞击炸机、不管了。"
       为什么不给它也用 2s+30µs/s：保持段的用途是"抓瞬时失效"，而姿态歪着**不是瞬时事件**，
       它抓不到任何东西；而"2s 保持 + 14s 斜坡"意味着**撞地之后桨还要转约 16 秒**
       （要先把 1420µs 降到 1000），与"不管了、赶紧停桨"的本意正相反。 */
    VERTICAL_FAIL_ATTITUDE = 2U,
    /* 高度越界（估计高度 > VERTICAL_FS_H_MAX_CM）。
       ⇒ 与读数失效同一套（飞机姿态是好的，只是飞出了可信工作区）。 */
    VERTICAL_FAIL_HEIGHT = 3U
} VerticalControlFailReason_t;

/**
 * @brief 一次 Update 之后的完整状态，供打印、遥测与黑匣子读取。
 */
typedef struct
{
    /* 遥控请求的模式，取协议 flight_mode 的低 4 位。非 0/1 视为未知，只拒绝不切换。 */
    uint8_t requested_mode;
    /* 实际生效的模式，取 VerticalControlMode_t。 */
    uint8_t mode;
    /* 细分状态，取 VerticalControlState_t。 */
    uint8_t state;
    /* 门禁①的通过位，VERTICAL_GATE_SW_xxx 或起来。等于 VERTICAL_GATE_SW_ALL 才算通过。 */
    uint8_t switch_gates;
    /* 门禁②的通过位，VERTICAL_GATE_CT_xxx 或起来。等于 VERTICAL_GATE_CT_ALL 才算通过。 */
    uint8_t control_gates;
    /* 直接给遥测用的模式字节：实际模式；请求与实际不一致（被拒）时或上 0x80。 */
    uint8_t telemetry_mode;
    /* true 表示处于停手（地面待机）。 */
    bool grounded;
    /* true 表示高度估计可信，转抄估计器的 valid。 */
    bool est_valid;
    /* 本拍油门杆原始量，0～1000（超过 1000 的按 1000 处理）。 */
    uint16_t stick;
    /* 本拍摇杆给出的目标高度变化率，单位厘米每秒，向上为正。 */
    float stick_rate_cms;
    /* 本拍目标高度，单位厘米。停手期间仍随杆积分——它是停手的唯一出口。 */
    float h_sp_cm;
    /* 本拍估计高度，单位厘米。只用来打印时和 h_sp 对齐；
       本模块拿它做判断的唯一地方是"停手进入"，那里会先看 est_valid。 */
    float h_est_cm;
    /* 本拍估计垂速，单位厘米每秒，向上为正。转抄估计器的 vz_cms（H9 新增）。
       打印用：它和内环输出的符号关系就是本环节的验收核心。 */
    float vz_est_cms;
    /* 本拍内环的目标垂速，单位厘米每秒，**外环的输出**（H13 起不再恒 0）。
       它就是 `[V]` 里的 `vzsp=`，也是黑匣子 `vz_target_cms` 那一列的来源。
       ⚠️ 符号判据：`h_sp > h_est`（命令上升）⇒ 它是**正**的；反之为负。
       ⚠️ 失效期间（st=6/7）两层都冻结 ⇒ 它保持失效前的值，不是 0。 */
    float vz_sp_cms;
    /* 本拍垂速内环（快层）输出的油门修正量，单位微秒，已限幅到 ±VERTICAL_INNER_CORR_LIMIT_US。
       ⚠️ 停手 / 门禁②没过时恒 0、且积分被复位——那就是"控制器闭嘴"的定义。 */
    float vz_correction_us;
    /* 本拍**慢层**的值：悬停油门估计器（积分器）当前值，单位微秒（H10 新增）。
       它就是 `[V]` 行里的 `i=`，也是黑匣子的悬停油门记录来源。
       ⚠️ 台架上**只有这个量能看出积分在不在工作**：`corr` 是快层、随时可能为 0，
          而 `i` 会随"匀速移动飞机"持续变化。不加它，H10 在台架上无法验收。 */
    float vz_throttle_base_us;
    /* 停手进入条件的累计满足时间，单位毫秒；0 表示计时未开始。 */
    uint32_t ground_timer_ms;
    /* 失效持续计时，单位毫秒（H12 新增）。0 = 没失效。
       ⚠️ 保持段与下降段**都累加**：`0 < fs < 2000` 是保持段，`fs ≥ 2000` 是下降段。
          不拆成两个字段，是因为"失效了多久"本身就是要看的量。 */
    uint32_t failsafe_ms;
    /* 进入失效的原因，取 VerticalControlFailReason_t（H12 新增）。
       ⚠️ 上锁 / 回普通模式 / 停手时清零；失效期间一直保留，所以
          `st=7` 且桨已停时它仍然写着"当初为什么进来的"。 */
    uint8_t fail_reason;
} VerticalControlSnapshot_t;

/**
 * @brief 初始化。上电创建任务时调用一次，IMU 重新初始化时也用它做冷复位。
 *
 * 与 Reset 的区别：Init 把模式也清回普通，Reset 保留模式。
 */
void VerticalControl_Init(void);

/**
 * @brief 复位控制器的运行状态，但**不动模式**。
 *
 * 复位内容：目标高度对齐到当前估计高度、停手计时清零、停手标志清除。
 * 调用时机：① IMU 重新初始化；② **模式切换成功的那一刻**。
 *
 * ② 是必须的：进模式时如果 h_sp 还留着上一轮的旧值，
 * 解除停手的瞬间会朝着一个完全不相干的高度产生巨大的跳变指令。
 * 对齐到"当前高度"是标准做法——设定值等于当前值，进来就没有误差。
 */
void VerticalControl_Reset(void);

/**
 * @brief 推进一拍。控制环每拍调用一次，**上锁时也必须调用**。
 *
 * ⚠️ 必须在 `if (!armed)` 分支**之前**调用：模式切换的前置条件就是"已上锁"，
 * 把调用塞进解锁分支里，上锁时就永远切不进模式。
 * ⚠️ 必须在 `VerticalEst_Update()` **之后**调用：它内部要读估计器的最新结果。
 *
 * @param requested_mode 遥控请求的模式，取协议 flight_mode 的低 4 位。
 * @param throttle_stick 油门杆原始量，0～1000。
 * @param link_ok 链路正常且指令有效。失联时 armed 也是 false，必须单独传进来，
 *                否则门禁①会把"空中失联"误判成"在地面上"。
 * @param armed 当前是否已解锁（与写电机用的是同一个判据）。
 * @param roll_deg 机体系横滚角，单位度，用于门禁②的姿态判据。
 * @param pitch_deg 机体系俯仰角，单位度，同上。
 * @param dt_s 距上一拍的时间，单位秒，正常情况下约 0.004。数值离谱时按 0 处理，不积分。
 */
void VerticalControl_Update(uint8_t requested_mode, uint16_t throttle_stick, bool link_ok, bool armed, float roll_deg, float pitch_deg, float dt_s);

/**
 * @brief 取最近一次结果。只拷贝一个结构体，不做任何计算，可在低频任务里调用。
 * @param snapshot 输出，不能为空。
 */
void VerticalControl_GetSnapshot(VerticalControlSnapshot_t *snapshot);

/**
 * @brief 定高模式下应该用的基础油门，单位微秒（H8 新增）。
 *
 * ── 为什么需要它 ──────────────────────────────────────────────
 * 定高模式下油门杆已经被"三段映射 → h_sp"占用了。若不接管基础油门，
 * 同一个杆会同时命令"爬升"（本模块）和"加大油门"（`MotorTest_MapStickToThrottleUs`），
 * 两套逻辑抢同一个输入，谁也管不住谁。接管之后基础油门只由本函数决定。
 *
 * ── 返回值 ────────────────────────────────────────────────────
 * | 模式 / 状态                             | 返回值                                    |
 * |-----------------------------------------|-------------------------------------------|
 * | 普通模式（调用方不该问，兜底）          | `MOTOR_PWM_MIN_US`（1000）                |
 * | 停手（VERTICAL_STATE_GROUNDED）         | `MOTOR_PWM_MIN_US`（1000）                |
 * | 已进定高但门禁②没过（IDLE）             | `MOTOR_PWM_MIN_US`（1000）                |
 * | 控制启用（ALT_HOLD）                    | 慢层积分器 + 快层修正量，钳到 [1150, 1650]（H10 起） |
 * | **失效保持（FAILSAFE_HOLD，H12）**      | **失效前一拍的实际输出，锁存不变**        |
 * | **失效下降（FAILSAFE_DESCEND，H12）**   | **从锁存值按 30µs/s 降到 1000，不再回头** |
 *
 * 停手给 **1000** 而不是 1100：停手就是"飞机在地面上、控制器什么都不做"，
 * 唯一和它语义一致的是"电机停转"，也就是普通模式杆收到底的那个值。
 * 给 1100（`MOTOR_PWM_IDLE_US`，怠速）意味着"桨还在转"，与停手矛盾。
 * ⇒ 方案旧文里写的 `MOTOR_PWM_IDLE_US`（1100µs）是错的，已在 §5.4 更正。
 *
 * ⚠️ **"定高模式下油门只会更低、不会更高"这条从 H9 起就不成立了**（H8 的单侧性质到此为止），
 *    H10 之后范围进一步放宽到 **1150~1650**。这不是退步——H9/H10 的全部目的就是让控制器
 *    真的能动油门，动不了就等于没做。**停手仍然恒 1000**，"地面不会自己起飞"没有削弱。
 *    ⚠️ 因此历次验收判据（H8 的 `thr ≤ 1100`、H9 的 `thr ≤ 1280`）**都作废**，
 *       H10 起改判 `thr ∈ [1150, 1650]`；H12 再补一条 `st=6` 时 `thr` **恒定**。
 *
 * ⚠️ 地板 1150 > 姿态环旁路边界 1100，所以 `motor_test.c` 里的
 *    `throttle_us <= MOTOR_ATTITUDE_ENABLE_PWM_US` 判据**在正常控制时永远不会命中**，
 *    姿态环在定高模式下**始终参与**（H8 阶段给 1100 时是没有姿态修正的）。
 *    这也是"地板不能再取 1100"的第二个理由：取 1100 时输出会因噪声在边界上来回穿，
 *    姿态环被反复 `AttitudeControl_Reset()`，等于废掉。
 *
 * ── ⭐⭐ H12：原来的"已知缺口"已结案 ──────────────────────────
 * 旧版本在门禁②没过时**一律返回 1000**。地面上完全正确（停手 = 电机停转），
 * 但**空中**丢读数 / 姿态歪超倾角门禁时返回 1000 等于**空中停车**，
 * 而且 1000 还会命中 `thr <= 1100` 分支**旁路姿态环** ⇒ 飞机翻滚着砸下来。
 * H10 真机实测里 451 个样本中有 **41 个（9% 的时间）**处在这个状态。
 *
 * 现在门禁②没过时先看**失效处理**（`st=6/7`）：
 *   · `st=6` 保持住失效前的悬停油门，姿态环照常工作（`thr` 恒 > 1100）⇒ 飞机近似悬停；
 *   · `st=7` 从那里按 30µs/s 平缓降到 1000 ⇒ **水平着地**，落地速度 4.43 → 1.86 m/s。
 * ⇒ 只有"**停手**"和"**上锁**"这两种情况仍然返回 1000，而这两种情况下飞机确实在地面上。
 *
 * @return 基础油门，单位微秒。调用方仍要经速率限制器，不要直接写电机。
 */
uint16_t VerticalControl_GetThrottleUs(void);

#ifdef __cplusplus
}
#endif

#endif
