Nyxarian/ApexFly-v2.0/ApexFly v2.0/Modules/ToF/tof.c

/**
 * @file tof.c
 * @brief VL53L1X 激光测距任务实现（单次测量循环）。
 *
 * ── 为什么要用单次测量循环 ────────────────────────────────────
 * 2026-09-11 实测：本芯片的连续模式写入成功但不再产生新结果；
 * 单次模式每次都能正常完成。因此这里改成"触发一次 → 等完成 → 读结果 → 再触发"。
 *
 * ── 节奏（2026-09-11 实测更正）────────────────────────────────
 * 每 20ms 走一步。一次完整测量占【4 步】：
 *     第1步 触发 → 第2步 等1拍 → 第3步 等2拍(转READ) → 第4步 读结果
 * 一轮约 83ms，即【约 12Hz】（串口 n= 每 500ms 增加 6）。
 * ⚠️ 这里原来写的是"3 步 / 约 16Hz"，是数错了步数，已按实测更正。
 * 结果读到手的时刻是触发后约 62ms，而测量本身 20ms 就完成了，
 * 也就是数据到手时已经放了约 42ms。这个 42ms 才是控制通道的滞后
 * （低通那 330ms 只影响显示/遥测，因为估计器吃的是 raw 值）。
 *
 * ── 失败处理 ───────────────────────────────────────────────
 * 测不到时保持上一次的读数，只把 fresh 置 false 并累加 age，
 * 上层能一眼看出"这个数是新的还是旧的"。
 * 连续多轮测不到才判定掉线并重新初始化。
 *
 * ── 总线约定 ───────────────────────────────────────────────
 * 本任务与 magtask 同级（都是 BelowNormal），每步都让出 CPU，
 * 避免长时间占着 I2C2 把磁力计饿死。
 *
 * ── 为什么不做"地面零点" ─────────────────────────────────────
 * 曾用"解锁时采一次地面读数当零点，高度 = 距离 − 零点"的方案，已废弃，原因：
 *   1. 镜头固定在机架最下方，机械偏置只有约 8mm（放在平面上就是 8mm），为一个常数引入整套状态机不值；
 *   2. 零点必须绑定"飞机确实在地面"的时刻，一旦和控制环的解锁/上锁状态耦合，
 *      就会出现"上锁时零点被反复清掉、高度恒 0"这类问题（已实际发生过）；
 *   3. 机身倾斜时真正要补的是 h = d·cosθ（θ 取 MPU6050 的横滚/俯仰），
 *      零点相减并不能解决倾斜误差，减的只是一个常数。
 * 因此这里直接输出实测距离换算的厘米值，保留约 8mm 的安装偏置。
 * 倾斜补偿留到将来做定高时再加，那时由使用方拿姿态角做 d·cosθ。
 */

#include "tof.h"

#include "cmsis_os.h"
#include "debug.h"
#include "flow.h"
#include "i2c.h"
#include "position_control.h"
#include "radio.h"
#include "task.h"
/* vertical_est 不再需要：打印里的 h/vz/v 改成从 vertical_control 的快照读，
   本任务不再直接碰估计器。 */
#include "vertical_control.h"
#include "vl53l1x.h"

/* 步进周期。 */
#define TOF_STEP_MS 20U
/* 触发后等几拍再读结果（2 拍 = 40ms > 20ms 时间预算，留足余量）。
   ⚠️ 曾经评估过把它改成 1 拍来提速（一轮 4 步 → 3 步，12Hz → 约 16.7Hz），
   结论是【不做】：控制通道只吃约 42ms 的读取延迟、不吃低通的 330ms，
   省下 20ms 在互补滤波的交叉频率上只相当于约 0.6° 相位；
   而采样变快会让"相邻两拍差分求垂速"的噪声变大 34%，对 H3 是反作用。
   详见 优化一下/高度接入飞控方案.md 第 13.6 节。 */
#define TOF_WAIT_STEPS 2U
/* 串口打印周期，单位毫秒。250Hz 的调用方，绝不能每拍都打。 */
#define TOF_PRINT_PERIOD_MS 500U
/* 连续多少轮拿不到有效数据才重新初始化（约 0.83 秒，12Hz × 10 轮）。 */
#define TOF_MISS_REINIT 10U

/* 距离低通滤波：filtered += (raw - filtered) / ALPHA_SHIFT。
   2026-09-11 实测（飞机静置）：原始值的峰峰值多在 3~5mm（个别到 8~10mm），
   滤波后峰峰值多在 0~1mm（最大 2mm），约 3~4 倍降噪。
   时间常数约 4 拍 = 4 / 12Hz ≈ 330ms。
   ⚠️ 这个滞后只影响显示/遥测；状态估计器吃的是 distance_raw_mm，不走这个滤波。
   取 2 的幂是为了用移位代替除法，避免在嵌入式里做浮点或整数除法。 */
#define TOF_LPF_ALPHA_SHIFT 2U

/* 单次测量状态机的阶段。 */
typedef enum
{
    TOF_PHASE_TRIGGER = 0,   /* 触发一次测量 */
    TOF_PHASE_WAIT,          /* 等测量完成 */
    TOF_PHASE_READ           /* 读结果 */
} ToF_Phase_t;

static VL53L1X_Device_t tof_device;
static ToFSnapshot_t tof_snapshot;

/* 低通滤波后的距离，单位是 1/4 毫米（定点）。
   为什么不用整数毫米：filtered += (raw-filtered)>>2 这种整数写法有 ~3mm 死区，
   差值不足 4mm 时移位结果为 0，滤波值会卡住不动，实测的 7mm 抖动就压不下去。
   存 1/4 毫米后死区只剩 0.25mm，等于可以忽略。 */
static uint32_t tof_distance_filtered_q2;

/* 滤波器是否已经用第一个真实读数起步过。
   低通是从 0 开始往上爬的，如果不先"起步"，前 8 拍会明显偏低。
   只在 ToF 初始化（含掉线后重新初始化）时复位一次。 */
static bool tof_distance_filter_primed;

void ToF_GetSnapshot(ToFSnapshot_t *snapshot)
{
    if (snapshot == NULL) return;
    *snapshot = tof_snapshot;
}

int32_t ToF_GetAltitudeCm(void)
{
    /* 只做一次 32 位整数读取，不碰 I2C 总线。 */
    return tof_snapshot.altitude_cm;
}

void ToF_Task(void *argument)
{
    VL53L1X_Result_t result;
    ToF_Phase_t phase;
    uint32_t last_fresh_tick;
    uint32_t next_print_tick;
    uint8_t wait_count;
    uint8_t miss_rounds;

    (void)argument;

    phase = TOF_PHASE_TRIGGER;
    wait_count = 0U;
    miss_rounds = 0U;
    last_fresh_tick = osKernelGetTickCount();
    next_print_tick = osKernelGetTickCount() + TOF_PRINT_PERIOD_MS;

    for (;;)
    {
        /* ── 初始化直到成功为止，每 1 秒重试一次。 ── */
        if (!tof_device.initialized)
        {
            if (!VL53L1X_Init(&tof_device, &hi2c2))
            {
                tof_snapshot.ready = false;
                Debug_Printf("[TOF] init fail: %s (errors=%lu)\r\n",
                             VL53L1X_InitStatusString(VL53L1X_GetLastInitStatus(&tof_device)),
                             (unsigned long)tof_device.error_count);
                osDelay(1000U);
                continue;
            }

            tof_snapshot.ready = true;
            tof_snapshot.fresh = false;
            tof_snapshot.miss_streak = 0U;
            /* 重新初始化后滤波器也重新起步，避免带着旧距离或从 0 往上爬。 */
            tof_distance_filtered_q2 = 0U;
            tof_distance_filter_primed = false;
            last_fresh_tick = osKernelGetTickCount();
            /* 初始化末尾已经触发了第一次测量，直接从"等待"开始。 */
            phase = TOF_PHASE_WAIT;
            wait_count = 0U;
            miss_rounds = 0U;
        }

        /* ── 状态机走一步。 ── */
        switch (phase)
        {
        case TOF_PHASE_TRIGGER:
            if (!VL53L1X_StartSingleShot(&tof_device))
            {
                Debug_Printf("[TOF] trigger fail, re-init.\r\n");
                tof_device.initialized = false;
                break;
            }
            wait_count = 0U;
            phase = TOF_PHASE_WAIT;
            break;

        case TOF_PHASE_WAIT:
            wait_count++;
            if (wait_count >= TOF_WAIT_STEPS)
            {
                phase = TOF_PHASE_READ;
            }
            break;

        case TOF_PHASE_READ:
            if (VL53L1X_IsMeasurementDone(&tof_device) &&
                VL53L1X_ReadMeasurement(&tof_device, &result))
            {
                tof_snapshot.range_status = result.range_status;
                tof_snapshot.error_count = result.error_count;

                if (result.valid)
                {
                    /* ⭐ 顺序要求，不要打乱：
                       ① 先把原始距离写进快照；
                       ② 再更新低通滤波器；
                       ③ 最后才自增 valid_count。
                       上层靠 valid_count 判断"有没有新数据"，按这个顺序写，
                       只要计数器变了，distance_raw_mm 必然已经是这一条新数据，
                       不会出现"计数器是新的、距离还是旧的"这种错配。 */
                    tof_snapshot.distance_raw_mm = result.distance_mm;

                    /* 差值要用有符号算，否则距离变小时无符号下溢，滤波值会直接跳到天上。 */
                    if (!tof_distance_filter_primed)
                    {
                        /* 第一个读数直接作为滤波初值，不让滤波器从 0 慢慢爬。 */
                        tof_distance_filtered_q2 = (uint32_t)result.distance_mm << 2;
                        tof_distance_filter_primed = true;
                    }
                    else
                    {
                        int32_t diff_q2 = ((int32_t)result.distance_mm << 2) - (int32_t)tof_distance_filtered_q2;
                        tof_distance_filtered_q2 = (uint32_t)((int32_t)tof_distance_filtered_q2
                                                    + (diff_q2 >> TOF_LPF_ALPHA_SHIFT));
                    }
                    /* 1/4 毫米还原成毫米，四舍五入。 */
                    tof_snapshot.distance_filtered_mm = (uint16_t)((tof_distance_filtered_q2 + 2U) >> 2);

                    /* 高度仍然由【滤波值】换算，所以显示与遥测和 H2 之前完全一致。
                       直接换算成厘米，不减任何零点：镜头装在机身底部，
                       实测值里就含着约 8mm 的安装偏置（放在平面上读数约 1cm），当作固定读数保留。
                       毫米 → 厘米四舍五入，直接整除会把 19mm 砍成 1cm。
                       距离是物理量，不可能为负，所以不需要负值分支。 */
                    tof_snapshot.altitude_cm = (int32_t)(((uint32_t)tof_snapshot.distance_filtered_mm + 5U) / 10U);

                    /* 最后自增计数器，见本分支开头的顺序要求。 */
                    tof_snapshot.valid_count++;

                    tof_snapshot.fresh = true;
                    tof_snapshot.miss_streak = 0U;
                    last_fresh_tick = osKernelGetTickCount();
                    miss_rounds = 0U;
                }
                else
                {
                    /* 测到了但结果无效（超量程/反射太弱/太强）：保持上一次读数。 */
                    tof_snapshot.fresh = false;
                    tof_snapshot.miss_streak++;
                }
            }
            else
            {
                /* 这一轮没读到有效结果。 */
                tof_snapshot.fresh = false;
                tof_snapshot.miss_streak++;
            }

            miss_rounds++;
            if (miss_rounds >= TOF_MISS_REINIT)
            {
                Debug_Printf("[TOF] too many misses, re-init.\r\n");
                tof_device.initialized = false;
                break;
            }

            /* 立刻触发下一轮。 */
            phase = TOF_PHASE_TRIGGER;
            break;

        default:
            phase = TOF_PHASE_TRIGGER;
            break;
        }

        tof_snapshot.age_ms = (uint32_t)(osKernelGetTickCount() - last_fresh_tick);

        /* ── 本任务只负责**打印**，不驱动任何东西（H4' 起）───────────
           高度/垂速估计器在控制环里驱动（倾斜补偿要用姿态角，而姿态角只有控制环算得出来）；
           控制环里**禁止打印**（一行日志约 10ms，会吃掉两拍 4ms 预算）。
           所以"谁驱动"和"谁打印"分开：驱动在控制环，打印留在这里。 */

        /* ── 串口打印，按时间节流。 ── */
        if ((int32_t)(osKernelGetTickCount() - next_print_tick) >= 0)
        {
            VerticalControlSnapshot_t vertical_control_state;
            RadioFlightStateSnapshot_t radio_state;
            FlowState_t flow_state;
            PositionControlSnapshot_t position_control_state;

            next_print_tick = osKernelGetTickCount() + TOF_PRINT_PERIOD_MS;
            /* ⚠️ 估计高度/垂速/有效标志全部从 **vertical_control 的快照**读，
                  不再单独调 VerticalEst_GetState()。
               两个理由：① 快照本来就是每拍从估计器转抄的，取一处即一份**同一时刻**的样本，
                 不会出现 h 与 vz 来自相邻两拍；② 少一次结构拷贝，也少一条跨模块依赖。 */
            VerticalControl_GetSnapshot(&vertical_control_state);
            /* 基础油门从遥测快照读：那是控制环每拍发布的**实际**值（含速率限制之后的），
               普通模式和定高模式都能看到，比从 vertical_control 单独问一个更贴合实际。
               先给 0：万一快照还没发布过（上电早期），打印出来是 0 而不是随机值。 */
            radio_state.throttle_pwm_us = 0U;
            (void)Radio_GetFlightStateSnapshot(&radio_state);

            /* ── 一行打完整个垂直轴（2026-09-15 起，取代原来的例行 [TOF] + [ALT] 两行）──
               ⚠️ 注意 `[TOF]` 这个标签只用于初始化失败、触发失败和连续丢测量等故障事件，
                  那是 ToF 模块自己的故障与状态消息，与被合并掉的例行数据行不是一回事。
               ⚠️ 为什么要合并：原来两行共约 239 字符，其中 h / vz / v 三个字段是
                  **同一时刻同一来源打了两遍**（两行都读估计器，取出时刻差一拍，
                  数值还不一样，反而容易让人怀疑是 bug）。合并后约 123 字符。

               四段，各回答一个问题：
                 ① 传感器  raw   = ToF 原始距离 mm（估计器的输入）
                 ② 估计器  h/vz/v= 估计高度 cm / 估计垂速 cm/s / 读数是否可信
                 ③ 状态机  req/mode = 遥控请求 / 实际模式（两者不等就是"被拒"）
                           st    = 细分状态：0 普通 / 1 定高在干活 / 4 停手 / 5 已进未使能
                                   **6 失效保持 / 7 失效下降**（H12）
                           sw/ct = 两层门禁位图（全通分别是 0xF）
                           stick = 油门杆；h_sp = 目标高度 cm；gt = 停手去抖计时 ms
                           fs    = 失效计时 ms（H12）：0 没失效 / 0~2000 在保持 / ≥2000 已在下降
                           fr    = 失效原因（H12）：0 无 / 1 ToF 读数失效 / 2 姿态超限 / 3 高度越界
                                   ⚠️ **fr=2 时 thr 立刻变成 1000**（判定炸机、不进保持段），是设计不是 bug
                 ④ 输出    vzsp  = **外环（H13）**：内环的目标垂速 cm/s = h_kp × (h_sp − h)
                                   ⚠️ **符号**：h_sp > h（命令上升）⇒ 它是**正**的；死区 2cm 内恒 0
                                   ⭐ 台架上它是"外环有没有接上"的唯一观测量
                           corr  = **快层**：垂速内环修正量 µs —— ⚠️ **符号必须与 vz 相反**
                                   （vz>0 时 corr<0），这是负反馈的唯一证据
                            i     = **慢层**：悬停油门估计器（H10 起），钳在 1150~1650
                                    ⭐ 台架上**只有它**能看出积分在不在工作：corr 是快层、
                                       随时可能为 0，而 i 会随"匀速移动飞机"持续变化
                           thr   = 基础油门 = i + corr，再钳到 [1150, 1650]（普通模式跟杆走，与这两层无关）
                                   ⚠️ H12 起：`st=6` 时它**恒等于失效前一刻的输出**（锁存值，不跳变）；
                                      `st=7` 时它从锁存值按 **30µs/s** 单调降到 1000（电机停转）

               ⚠️ 2026-09-15 主动删掉的字段（**不是遗漏**，理由都记在这里）：
                 filt= / alt=    显示用低通值及其换算结果，raw 一个就够；alt 在遥控器上实时可见
                 status= / fresh= / age= / err=
                                 ToF 健康度。⚠️ **删了就没有第二个出口**——黑匣子不记这些。
                                 将来排查"v 掉到 0 是超量程还是 ToF 挂了"时，必须把这几项加回来，
                                 或者从 git 历史取删之前那一版
                 n= / sc=        ToF 与估计器的累计样本数，被 fresh+age 覆盖
                 gnd=            **与 st=4 完全等价**（代码三条分支恒等）
                 rate=           由 stick 唯一决定（三段映射是纯函数）
                 vzsp=           H9 阶段恒 0；**H13 接外环时要加回来**
                 h= / v= / vz=（旧 [ALT] 那三个）与②段完全重复 */
            Debug_Printf("[V] raw=%umm | h=%.1fcm vz=%+.1fcm/s v=%u | req=%u mode=%u st=%u sw=0x%X ct=0x%X stick=%u h_sp=%.1f gt=%lums fs=%lums fr=%u | vzsp=%+.1f corr=%+.1f i=%.1f thr=%u\r\n",
                         (unsigned)tof_snapshot.distance_raw_mm,
                         (double)vertical_control_state.h_est_cm,
                         (double)vertical_control_state.vz_est_cms,
                         vertical_control_state.est_valid ? 1U : 0U,
                         (unsigned)vertical_control_state.requested_mode,
                         (unsigned)vertical_control_state.mode,
                         (unsigned)vertical_control_state.state,
                         (unsigned)vertical_control_state.switch_gates,
                         (unsigned)vertical_control_state.control_gates,
                         (unsigned)vertical_control_state.stick,
                         (double)vertical_control_state.h_sp_cm,
                         (unsigned long)vertical_control_state.ground_timer_ms,
                         (unsigned long)vertical_control_state.failsafe_ms,
                         (unsigned)vertical_control_state.fail_reason,
                         (double)vertical_control_state.vz_sp_cms,
                         (double)vertical_control_state.vz_correction_us,
                         (double)vertical_control_state.vz_throttle_base_us,
                         (unsigned)radio_state.throttle_pwm_us);

            /* ── 光流一行（2026-09-18 起）──────────────────────────
               ⚠️ OF6 仍然**不接任何控制**；[OF] 只显示传感器原始状态。
               n     = 四重校验全过、成功解出的帧数（持续增长才说明接线/波特率对）
               bad   = 累加和失败 / 长度或包尾失败（持续增长 ⇒ 波特率或接线有问题）
               qrej  = 质量不达标被拒的帧数
               q     = 最近一帧的图像质量 —— **判断地面纹理/光照够不够的唯一依据**
               dx/dy = 最近一帧的原始位移计数（有符号；单位是"计数"，不是毫米）
               z     = 标定得到的零点，单位计数/帧（理想应远小于 1）
               sx/sy = 累积流量（已减零点）—— ⭐ **静止时它不该持续单向增长**
               v     = 数据是否可用（为 0 时 sx/sy 是**冻结**的旧值，不是清零）
               cal   = 0 未开始 / 1 采样中 / 2 已完成 / 3 失败待重来
               a     = 距最近一帧**合格**数据的毫秒数 */
            Flow_GetState(&flow_state);
            Debug_Printf("[OF] n=%lu bad=%lu/%lu qrej=%lu | q=%u dx=%d dy=%d | z=%+.4f,%+.4f | sx=%+.1f sy=%+.1f | v=%u cal=%u a=%lums\r\n", (unsigned long)flow_state.frame_count, (unsigned long)flow_state.checksum_error_count, (unsigned long)flow_state.format_error_count, (unsigned long)flow_state.quality_reject_count, (unsigned)flow_state.quality, (int)flow_state.dx, (int)flow_state.dy, (double)flow_state.zero_x, (double)flow_state.zero_y, (double)flow_state.sum_x, (double)flow_state.sum_y, flow_state.valid ? 1U : 0U, (unsigned)flow_state.cal, (unsigned long)flow_state.age_ms);

            /* ── OF8 位置/速度两级环与安全门禁（仍只算不下发）────────
               n      = 速度环 / 位置环更新次数，约应为 2:1
               ok     = 光流有效且零点标定完成；否则输出强制为 0
               fr     = 最近一次安全退出原因：0 无、1 光流、2 链路、3 姿态、4 高度、5 许可
               p/v/sp = 旋到机体系后的前、右位置 / 速度 / 目标速度
               raw    = 速度环原始 roll,pitch 角；out 是 2.5Hz 低通后的角
               ⚠️ out 仅供台架判方向，绝不写 AttitudeControl_Update。 */
            PositionControl_GetSnapshot(&position_control_state);
            Debug_Printf("[PC] req=%u gate=0x%02X st=%u fr=%u n=%lu/%lu ok=%u hs=%.2f rot=%u | p=%+.1f,%+.1f v=%+.1f,%+.1f sp=%+.1f,%+.1f | raw=%+.2f,%+.2f out=%+.2f,%+.2f\r\n",
                         position_control_state.request ? 1U : 0U,
                         (unsigned)position_control_state.gate_mask,
                         (unsigned)position_control_state.state,
                         (unsigned)position_control_state.fault_reason,
                         (unsigned long)position_control_state.velocity_update_count,
                         (unsigned long)position_control_state.position_update_count,
                         position_control_state.valid ? 1U : 0U,
                         (double)position_control_state.height_scale,
                         position_control_state.motion_suppressed ? 1U : 0U,
                         (double)position_control_state.position_forward_counts,
                         (double)position_control_state.position_right_counts,
                         (double)position_control_state.velocity_forward_cps,
                         (double)position_control_state.velocity_right_cps,
                         (double)position_control_state.velocity_forward_sp_cps,
                         (double)position_control_state.velocity_right_sp_cps,
                         (double)position_control_state.raw_roll_deg,
                         (double)position_control_state.raw_pitch_deg,
                         (double)position_control_state.roll_deg,
                         (double)position_control_state.pitch_deg);
        }

        /* 每步都让出 CPU：本任务与 magtask 共用 I2C2。 */
        osDelay(TOF_STEP_MS);
    }
}
