Nyxarian/ApexFly-v2.0/ApexFly v2.0/Core/Src/app_freertos.c

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

/* Includes ------------------------------------------------------------------*/
#include "FreeRTOS.h"
#include "task.h"
#include "main.h"
#include "cmsis_os.h"

/* USER CODE BEGIN Includes */
#include "apex_config.h"
#include "debug.h"
#include "flow.h"
#include "i2c.h"
#include "imu_attitude.h"
#include "imu_bias.h"
#include "led.h"
#include "motor_test.h"
#include "mpu6050.h"
#include "blackbox.h"
#include "gps.h"
#include "i2c2_lock.h"
#include "mag.h"
#include "radio.h"
#include "tof.h"
/* USER CODE END Includes */

/* USER CODE BEGIN Variables */
/* ── 光流任务（2026-09-18，OF1~OF5）────────────────────────────
   与 tofTask / magtask 同级（BelowNormal）：它只收字节、数数、标零点，
   **不参与任何控制**，优先级不该高于任何人。
   栈 384 词：调用链很浅（解析器 + 一次结构体拷贝），留足余量。
   ⚠️ 放在 USER CODE 区里，CubeMX 重新生成不会清掉。 */
osThreadId_t flowTaskHandle;
const osThreadAttr_t flowTask_attributes = {
  .name = "flowTask",
  .priority = (osPriority_t) osPriorityBelowNormal,
  .stack_size = 384 * 4
};
/* USER CODE END Variables */
/* Definitions for defaultTask */
osThreadId_t defaultTaskHandle;
const osThreadAttr_t defaultTask_attributes = {
  .name = "defaultTask",
  .priority = (osPriority_t) osPriorityNormal,
  .stack_size = 128 * 4
};
/* Definitions for motorTestTask */
osThreadId_t motorTestTaskHandle;
const osThreadAttr_t motorTestTask_attributes = {
  .name = "motorTestTask",
  .priority = (osPriority_t) osPriorityHigh,
  .stack_size = 640 * 4
};
/* Definitions for ledTask */
osThreadId_t ledTaskHandle;
const osThreadAttr_t ledTask_attributes = {
  .name = "ledTask",
  .priority = (osPriority_t) osPriorityNormal,
  .stack_size = 128 * 4
};
/* Definitions for radioTask */
osThreadId_t radioTaskHandle;
const osThreadAttr_t radioTask_attributes = {
  .name = "radioTask",
  .priority = (osPriority_t) osPriorityAboveNormal,
  .stack_size = 512 * 4
};
/* Definitions for blackboxTask */
osThreadId_t blackboxTaskHandle;
const osThreadAttr_t blackboxTask_attributes = {
  .name = "blackboxTask",
  .priority = (osPriority_t) osPriorityBelowNormal,
  .stack_size = 768 * 4
};
/* Definitions for magtask */
osThreadId_t magtaskHandle;
const osThreadAttr_t magtask_attributes = {
  .name = "magtask",
  .priority = (osPriority_t) osPriorityBelowNormal,
  .stack_size = 512 * 4
};
/* Definitions for gpsTask */
osThreadId_t gpsTaskHandle;
const osThreadAttr_t gpsTask_attributes = {
  .name = "gpsTask",
  .priority = (osPriority_t) osPriorityBelowNormal,
  .stack_size = 512 * 4
};
/* Definitions for tofTask */
osThreadId_t tofTaskHandle;
const osThreadAttr_t tofTask_attributes = {
  .name = "tofTask",
  /* 与 magtask 同级：两者共用 I2C2，同级 + 每拍让出 CPU，避免任何一方被饿死。 */
  .priority = (osPriority_t) osPriorityBelowNormal,
  .stack_size = 512 * 4
};

/* USER CODE BEGIN FunctionPrototypes */
void StartFlowTask(void *argument);
/* USER CODE END FunctionPrototypes */

void StartDefaultTask(void *argument);
void StartMotorTestTask(void *argument);
void StartLedTask(void *argument);
void StartRadioTask(void *argument);
void StartBlackboxTask(void *argument);
void StartMagTask(void *argument);
void StartGpsTask(void *argument);
void StartTofTask(void *argument);

void MX_FREERTOS_Init(void); /* (MISRA C 2004 rule 8.1) */

/* Hook prototypes */
void vApplicationStackOverflowHook(xTaskHandle xTask, signed char *pcTaskName);

/* USER CODE BEGIN 4 */
void vApplicationStackOverflowHook(xTaskHandle xTask, signed char *pcTaskName)
{
   /* 栈溢出时停住调度，并让红灯常亮、蓝灯熄灭，方便面板直接看出异常。 */
   (void)xTask;
   (void)pcTaskName;
   taskDISABLE_INTERRUPTS();
   HAL_GPIO_WritePin(LED_BLUE_GPIO_Port, LED_BLUE_Pin, GPIO_PIN_RESET);
   HAL_GPIO_WritePin(LED_RED_GPIO_Port, LED_RED_Pin, GPIO_PIN_SET);
   for (;;)
   {
   }
}
/* USER CODE END 4 */

/**
  * @brief  FreeRTOS initialization
  * @param  None
  * @retval None
  */
void MX_FREERTOS_Init(void) {
  /* USER CODE BEGIN RTOS_MUTEX */
  I2C2_Lock_Init();
  /* USER CODE END RTOS_MUTEX */

  /* USER CODE BEGIN RTOS_SEMAPHORES */
  /* add semaphores, ... */
  /* USER CODE END RTOS_SEMAPHORES */

  /* USER CODE BEGIN RTOS_TIMERS */
  /* start timers, add new ones, ... */
  /* USER CODE END RTOS_TIMERS */

  /* USER CODE BEGIN RTOS_QUEUES */
  /* add queues, ... */
  /* USER CODE END RTOS_QUEUES */

  /* Create the thread(s) */
  /* creation of defaultTask */
  defaultTaskHandle = osThreadNew(StartDefaultTask, NULL, &defaultTask_attributes);

  /* creation of motorTestTask */
  motorTestTaskHandle = osThreadNew(StartMotorTestTask, NULL, &motorTestTask_attributes);

  /* creation of ledTask */
  ledTaskHandle = osThreadNew(StartLedTask, NULL, &ledTask_attributes);

  /* creation of radioTask */
  radioTaskHandle = osThreadNew(StartRadioTask, NULL, &radioTask_attributes);

  /* creation of blackboxTask */
  blackboxTaskHandle = osThreadNew(StartBlackboxTask, NULL, &blackboxTask_attributes);

  /* creation of magtask */
  magtaskHandle = osThreadNew(StartMagTask, NULL, &magtask_attributes);

  /* creation of gpsTask */
  /* ⚠️ 下面这个 #if 是**手工加**的，而且它**不在 USER CODE 区里**：
     USART2 同一时刻只能归一个人用，接了光流就不能再建 GPS 任务，
     否则两边抢同一个 DMA 通道（现象是 [OF] 的 n 一直是 0）。
     ⇒ CubeMX 重新生成会让这个 #if 消失，生成完必须回来补。
     见 Core/Inc/apex_config.h。 */
#if !APEX_UART2_ROLE_FLOW
  gpsTaskHandle = osThreadNew(StartGpsTask, NULL, &gpsTask_attributes);
#endif

  /* creation of tofTask */
  tofTaskHandle = osThreadNew(StartTofTask, NULL, &tofTask_attributes);

  /* USER CODE BEGIN RTOS_THREADS */
#if APEX_UART2_ROLE_FLOW
  /* creation of flowTask：USART2 归光流时才建（见 Core/Inc/apex_config.h）。 */
  flowTaskHandle = osThreadNew(StartFlowTask, NULL, &flowTask_attributes);
#else
  /* USART2 归 GPS：光流任务不建，省下一份栈。 */
#endif
  /* USER CODE END RTOS_THREADS */

  /* USER CODE BEGIN RTOS_EVENTS */
  /* add events, ... */
  /* USER CODE END RTOS_EVENTS */

}

/* USER CODE BEGIN Header_StartDefaultTask */
/**
  * @brief  Function implementing the defaultTask thread.
  * @param  argument: Not used
  * @retval None
  */
/* USER CODE END Header_StartDefaultTask */
void StartDefaultTask(void *argument)
{
  /* USER CODE BEGIN StartDefaultTask */
  (void)argument;
  /* Infinite loop */
  for(;;)
  {
    osDelay(1);
  }
  /* USER CODE END StartDefaultTask */
}

/* USER CODE BEGIN Header_StartMotorTestTask */
/**
  * @brief  遥控油门跟杆任务。
  *         电调解锁并采完零偏后，按 control_link 快照输出油门。
  *         测试前必须拆桨。
  * @param  argument: Not used
  * @retval None
  */
/* USER CODE END Header_StartMotorTestTask */
void StartMotorTestTask(void *argument)
{
  /* USER CODE BEGIN StartMotorTestTask */
  MotorTest_Task(argument);
  /* USER CODE END StartMotorTestTask */
}

/* USER CODE BEGIN Header_StartLedTask */
/**
  * @brief  LED 心跳任务。
  *         蓝灯 PF9 和红灯 PF10 每秒翻转一次，用来确认 FreeRTOS 正在运行。
  * @param  argument: Not used
  * @retval None
  */
/* USER CODE END Header_StartLedTask */
void StartLedTask(void *argument)
{
  /* USER CODE BEGIN StartLedTask */
  Led_Task(argument);
  /* USER CODE END StartLedTask */
}

/* USER CODE BEGIN Header_StartRadioTask */
/**
  * @brief  LoRa 电台任务。
  *         收遥控控制帧，写入 control_link，立刻回遥测。不写 TIM8。
  * @param  argument: Not used
  * @retval None
  */
/* USER CODE END Header_StartRadioTask */
void StartRadioTask(void *argument)
{
  /* USER CODE BEGIN StartRadioTask */
  Radio_Task(argument);
  /* USER CODE END StartRadioTask */
}

/* USER CODE BEGIN Header_StartBlackboxTask */
/**
* @brief Function implementing the blackboxTask thread.
* @param argument: Not used
* @retval None
*/
/* USER CODE END Header_StartBlackboxTask */
void StartBlackboxTask(void *argument)
{
  /* USER CODE BEGIN StartBlackboxTask */
  Blackbox_Task(argument);
  /* USER CODE END StartBlackboxTask */
}

/* USER CODE BEGIN Header_StartMagTask */
/**
  * @brief  磁力计任务。I2C2 读 GY-273，只发布磁场快照，不进姿态环。
  * @param  argument: Not used
  * @retval None
  */
/* USER CODE END Header_StartMagTask */
void StartMagTask(void *argument)
{
  /* USER CODE BEGIN StartMagTask */
  Mag_Task(argument);
  /* USER CODE END StartMagTask */
}

/* USER CODE BEGIN Header_StartGpsTask */
/**
  * @brief  GPS 任务。独占 USART2 上的 ATGM336H，解析 NMEA，给黑匣子提供 UTC 时间。
  * @param  argument: Not used
  * @retval None
  */
/* USER CODE END Header_StartGpsTask */
void StartGpsTask(void *argument)
{
  /* USER CODE BEGIN StartGpsTask */
  GPS_Task(argument);
  /* USER CODE END StartGpsTask */
}

/* USER CODE BEGIN Header_StartTofTask */
/**
  * @brief  激光测距任务。I2C2 上与磁力计共用总线，只发布距离快照，不参与控制。
  * @param  argument: Not used
  * @retval None
  */
/* USER CODE END Header_StartTofTask */
void StartTofTask(void *argument)
{
  /* USER CODE BEGIN StartTofTask */
  ToF_Task(argument);
  /* USER CODE END StartTofTask */
}

/* USER CODE BEGIN Application */
/**
  * @brief  光流任务（2026-09-18，OF1~OF5）。
  *         收 CX-OF 的串口帧、判有效性、标零点、累积流量。
  *         ⚠️ 本阶段**不接任何控制**，唯一出口是 tof.c 里那行 [OF] 打印。
  * @param  argument: Not used
  * @retval None
  */
void StartFlowTask(void *argument)
{
  /* USER CODE BEGIN StartFlowTask */
  Flow_Task(argument);
  /* USER CODE END StartFlowTask */
}
/* USER CODE END Application */
