Nyxarian/ApexFly-v2.0/ApexFly v2.0/Modules/GPS/gps_atgm336h.c

/**
 * @file gps_atgm336h.c
 * @brief ATGM336H NMEA 解析实现。只处理 GGA 和 RMC。
 *
 * 校验失败的语句直接丢掉。时间只认 RMC 的完整日期和时间，GGA 只补充位置和卫星数。
 */

#include "gps_atgm336h.h"

#include <stddef.h>
#include <stdlib.h>
#include <string.h>

#define GPS_NMEA_MAX_FIELDS 20U

static int8_t GPS_HexValue(char character)
{
    if ((character >= '0') && (character <= '9')) return (int8_t)(character - '0');
    if ((character >= 'A') && (character <= 'F')) return (int8_t)(character - 'A' + 10);
    if ((character >= 'a') && (character <= 'f')) return (int8_t)(character - 'a' + 10);
    return -1;
}

static bool GPS_CheckChecksum(char *sentence, char **checksum_mark)
{
    uint8_t checksum = 0U;
    char *cursor;
    char *asterisk;
    int8_t high;
    int8_t low;

    if ((sentence == NULL) || (sentence[0] != '$')) return false;
    asterisk = strchr(sentence, '*');
    if ((asterisk == NULL) || (asterisk[1] == '\0') || (asterisk[2] == '\0')) return false;

    for (cursor = &sentence[1]; cursor < asterisk; cursor++) checksum ^= (uint8_t)(*cursor);
    high = GPS_HexValue(asterisk[1]);
    low = GPS_HexValue(asterisk[2]);
    if ((high < 0) || (low < 0)) return false;
    if (checksum != (uint8_t)(((uint8_t)high << 4) | (uint8_t)low)) return false;

    *checksum_mark = asterisk;
    return true;
}

static uint8_t GPS_SplitFields(char *payload, char *fields[], uint8_t maximum_fields)
{
    uint8_t count = 0U;
    char *cursor;

    if ((payload == NULL) || (fields == NULL) || (maximum_fields == 0U)) return 0U;
    fields[count++] = payload;
    for (cursor = payload; (*cursor != '\0') && (count < maximum_fields); cursor++)
    {
        if (*cursor == ',')
        {
            *cursor = '\0';
            fields[count++] = cursor + 1;
        }
    }
    return count;
}

static bool GPS_IsSentenceType(const char *field, const char *type)
{
    size_t length;

    if ((field == NULL) || (type == NULL)) return false;
    length = strlen(field);
    if (length < 3U) return false;
    return strcmp(&field[length - 3U], type) == 0;
}

static bool GPS_FieldHasDigits(const char *field, uint8_t count)
{
    uint8_t index;
    if ((field == NULL) || (strlen(field) < count)) return false;
    for (index = 0U; index < count; index++)
    {
        if ((field[index] < '0') || (field[index] > '9')) return false;
    }
    return true;
}
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
