Nyxarian/ApexFly-v2.0/(commit log)

2026-08-23 本地快照：可飞姿态环 + 黑匣子读取器（未接气压高度环）
    - 飞机端：串级 PID、黑匣子场次日志、USART3 dump/dumpall、可中断导出
    - 默认 dump 最近 20000 条；场次号按 session 头续编
    - PC 读取器：场次 CSV、分屏波形、PID 备注
    - 姿态底板约 Roll/Pitch 外1.80 内1.50，偏航角速度 0.45～1.00，无高度环
2026-08-25 Add GPS time, quaternion attitude, wrap-around blackbox, and refresh docs.
    Keep throttle as a direct stick-to-PWM map, persist the log write pointer, and dump from the latest records instead of the Flash tail.
2026-08-28 Add mag heading hold, stick-to-angle roll/pitch, and disable baro.
    Feed calibrated mag heading into the yaw outer loop, map roll/pitch sticks to about +/-10 deg setpoints plus trim, persist mag calibration in flash, and stop the baro task so I2C2 is mag-only.
2026-09-08 feat: 电调 PWM 改 400Hz，恢复 mag/gps 任务，控制环删打印并固定周期
    - tim.c / .ioc：TIM8 周期 19999 -> 2499（400Hz），电调实测正常
    - app_freertos.c：补齐 magTask / gpsTask 并接回 Mag_Task / GPS_Task
    - motor_test.c：删除控制环内每拍 Debug_Printf；周期基准改 osDelayUntil + 防追赶
    - 新增姿态链路分析与优化文档（优化一下/、实施方案书）
2026-09-08 fix: dt 改用 DWT 微秒时基（原始计数器域差值，处理 25s 回绕）
    - motor_test.c：新增 MotorTest_TimebaseInit()，dt 在 CYCCNT 域做无符号减法后换算微秒
    - 修正 #2 周期基准的无符号比较 bug（尚未到点被误判为落后，导致控制环空转）
    - 实测 dt avg=9999us、min/max 波动 <30us，连续 80s 跨 3 次回绕无异常
2026-09-08 refactor: 删除 mpu6050 死时间戳；控制任务优先级提到 osPriorityHigh
    - mpu6050.c/.h：删除无人使用的 timestamp_ms / last_timestamp_ms / MPU6050_GetLastTimestampMs，驱动层不再依赖 HAL tick
    - .ioc / app_freertos.c：motorTestTask 24 -> 40（osPriorityHigh），radioTask 保持 32 不变
2026-09-08 feat: I2C 容错；陀螺量程 ±1000dps / 加计量程 ±4g
    - mpu6050.c/.h：GYRO_CONFIG 0x18 -> 0x10（±1000dps，32.8 LSB/dps）；ACCEL_CONFIG 0x10 -> 0x08（±4g，8192 LSB/g）
    - mpu6050.c：I2C 单次超时 20ms -> 5ms
    - motor_test.c：I2C 单次错误只丢本拍，连续 20 次（200ms）才 disarm 并重初始化
    - 文档：环节开发顺序.md 同步（#8/#9 完成，#10 跳过，#11/#12 暂缓，#13 延后；新增 #13/#31/#33 备注）
2026-09-08 feat: 陀螺零偏采集双门禁；水平零点三重门禁；温度补偿决定跳过
    - imu_bias.c/.h：零偏采集加门禁（加计模长 0.95~1.10g + 相邻两拍角速度变化 <1.0dps），越界清零重来并记录原因
    - motor_test.c：零偏采样 200 -> 500 拍（5s）；水平零点加三重门禁（模长/倾角<8度/角速度<2dps），越界清空重来
    - 实测：四次上电零偏差异 <0.02dps；水平零点 -1.54/-3.46 度与安装倾角吻合
    - 文档：环节开发顺序.md（#14/#15 完成，#16 跳过并记录原因）
2026-09-09 feat: 加计滤波、门限收紧、中值积分、dt 加固、内环解锁门禁
    - imu_attitude.c/.h：加计一阶低通（截止 30Hz）；模长门限 0.8~1.2 -> 0.95~1.10；欧拉 -> 中值积分；dt 异常时限幅继续而非丢拍
    - attitude_control.c/.h：新增 AttitudeControl_IsInnerLoopEnabled()（横滚/俯仰内环任一增益非 0 即启用）
    - motor_test.c：解锁前门禁（内环未启用则拒绝解锁）；遥测 motor_ready 同步反映内环状态
    - 实测：#17 振动时 lpf 明显平滑；#18 超限时 valid=0；#19 往返 roll/pitch 能回位
    - 文档：环节开发顺序.md 进度更新（#17~#22）
2026-09-09 fix: 混控下限统一为 1050us，删除事后逐路裁剪（#23）
    - 新增 MIXER_PWM_EFFECTIVE_MIN_US=1050，作为混控统一有效下限
    - 删除 MotorTest_ApplyMixer 里事后逐路硬抬到 1050us 的裁剪，避免破坏四路差速关系
    - 解锁门限与姿态环使能门限统一引用同一常量
    - 串口 [MIX] 数据验证：scale=1.00 差速正常；scale<1 按比例压缩且最低路恰好触底，无硬抬
    - 临时 [MIX] 打印已删除
2026-09-09 feat: 台架实测四路起转点，混控下限 1050 -> 1100us（#24）
    台架数据（无桨逐路阶梯扫描，步进 5us）：
    - M1 后右 / M2 前右 / M4 前左：1030us 有转动迹象但堵转，1035us 才稳定转起
    - M3 后左：1030us 直接稳定转起
    - 四路极差仅 5us
    结论：
    - 四路起转点差异不超过 5us，排除起转点不一致导致起飞单向漂移这一假设
    - 1030us 是电调堵转区，原下限 1050us 只比最差起转点高 15us，带桨后不够
    改动：
    - MIXER_PWM_EFFECTIVE_MIN_US 1050 -> 1100（最差起转点 + 65us 余量；悬停 1550us 时上下余量对称 450/450）
    - MOTOR_PWM_IDLE_US 同步 1050 -> 1100（原本无代码引用）
    -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
2026-09-09 refactor: 限幅语义拆解，积分限幅改为输出限幅的固定比例（#26）
    问题：pid_table.c 6 处 i_limit = out_max，改输出限幅连带改积分限幅，
    积分项理论上可独占 100% 输出（windup）。
    约束：协议 0x07 的 30 个参数 ID 已用满（应答负载 4+30x4=124 字节），
    加 6 个独立 i_limit ID 会让遥控端整包对不上，故采用比例派生方案。
    - PidParam_t 删除 i_limit 字段，参数表不再携带积分限幅
    - attitude_control.c 新增 ATTITUDE_OUTER/INNER_I_LIMIT_RATIO = 0.15 / 0.25
    - AttitudeControl_InitAxis 按 out_max x 比例推导积分限幅，覆盖编译默认/遥控 SET/Flash 回灌三条路径
    - pid_ta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
2026-09-09 feat: 控制律整定前改造 —— anti-windup + 微分对测量 + 目标斜率限制（#27/#28/#29）
    #27 积分限幅 + anti-windup
    - Pid_t 新增 delivery_scale（默认 1.0），Pid_Reset 一并复位
    - 新增 Pid_SetDeliveryScale / CascadePid_SetInnerDeliveryScale
    - Pid_Update：条件积分（试探性输出饱和且误差同向时不采纳本拍积分）
    - 积分限幅 = i_limit x delivery_scale；AttitudeControl 把上一拍混控 correction_scale 喂给三个内环
    #28 微分项改对测量微分 + 一阶低通
    - Pid_t 删 last_error/last_deriv，新增 last_measured/deriv_raw/deriv_filtered
    - deriv_raw = -(measured - last_measured)/dt，目标值突变不再产生微分冲击
    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
2026-09-09 6轴+第30环节+性能未增强
    新增两份方案文档（纯文档，不改代码）：
    - 优化一下/调参.md：#30 PID 整定方案与记录模板（轮 0~轮 7、判据速查、记录表）
    - 优化一下/性能增强+9轴.md：阶段 0~6 实施顺序，含前置条件、验证方法、验收标准、回退方式
    当前代码状态：
    - 解算 6 轴 Mahony（磁力计未进融合，硬铁校准未做）
    - 控制律 #27/#28/#29 已完成并验证（anti-windup / 微分对测量 / 目标斜率限制）
    - 性能增强 #31/#32/#33 未做；9 轴融合未做
    本提交作为性能增强之前的基线检查点。
2026-09-10 版本 v0.2「磁力计就绪 / 性能增强未开始」
    【当前版本状态】
    - 姿态解算：6 轴 Mahony（磁力计未进融合）
    - 控制律：#1~#29 全部完成并验证（含 #27 anti-windup、#28 微分对测量+低通、#29 目标斜率限制）
    - 磁力计：硬铁校准已存 Flash(gen=3)，映射已修正，位置已调整
    - 性能增强：#31 I2C DMA / #32 EXTI 采样 / #33 提频 均【未做】
    - 第 30 环节（PID 整定）：方案就绪（调参.md），【未执行】
    【本次完成：阶段 0 磁力计数据质量评估】
    1. 修正磁力计映射（原映射是错的）
    mx=-x,my=y -> mx=-y,my=x,mz=z
    实测依据（与机体朝向无关，只用地磁场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
2026-09-10 轮A：I2C1 提速到 400kHz（待台架验证）+ 临时探针；#31 DMA 跳过
    原因：I2C1.Timing=0x40B285C2 解码为约 100kHz（PRESC=4、SCLL=194、SCLH=133），
    14 字节读约 1.5ms，占满 10ms 控制周期的 15%；提到 250Hz（4ms）后就是 38%，
    是 #33 提频的直接障碍。DMA 只改变"谁在等"，不改变事务本身的墙钟延迟，
    故 #31 跳过，腾时间预算的任务改由提升总线速率承担。
    - Core/Src/i2c.c：hi2c1.Init.Timing 0x40B285C2 -> 0x40621236
    （CubeMX 官方值，Fast Mode 400kHz；I2C2 不动）
    - ApexFly v2.0.ioc：同步 I2C1.Timing
    - Modules/Motor/motor_test.c：加临时探针 [T]
    （每拍 i2c 读耗时 / 整拍耗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
2026-09-10 轮A 收尾：拆除临时探针 + 更正文档中的 I2C 速率表述（实测 405us / 400.0kHz）
    台架验收（连续 5 分钟以上）：
    - i2c 读耗时 405us（均值=峰值）；旧值按同口径反推约 1600us，提速 4.0 倍
    - err=0、who=0x68、bad=0、每秒拍数恒为 100，无一次例外
    - 整拍 work 435us 均值 / 633us 峰值（峰值来自每秒一次的 Battery_Update）
    - 结论：阶段 3 提到 250Hz 后 i2c 占 10.1%，时间预算充足，提频可行
    - Modules/Motor/motor_test.c：整段删除临时探针，恢复到加探针前的状态
    （已核对与 58b4c63 逐字节一致，关键字残留 0 个）
    - 性能增强+9轴.md：新增 2.0.1 轮 A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
2026-09-10 #32 IMU 中断采样（EXTI0/DRDY）：一次 DRDY = 一帧控制
    目的：消除"盲等定时读"的两个问题——
    1) 每秒 100 拍里有相当比例读到与上一拍同一帧（重复积分、重复控制）；
    2) 一次 14 字节读可能跨芯片更新边界，导致 accel 与 gyro 来自不同帧。
    同时承接 #11（DRDY 中断）与 #12（读取原子性）。
    改动（4 个文件，不新增文件、不动 .uvprojx）：
    - Modules/IMU/mpu6050.c：SMPLRT_DIV 0x00 -> 0x09
    1kHz/(1+9) = 100Hz，输出寄存器与 DRDY 都变成 100Hz。
    必须与 DRDY 采样配套：只降采样率而继续定时读，跨帧会从 1ms 恶化到 10ms。
    - Modules/Motor/motor_test.c / .h：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
2026-09-10 #32 收尾：拆除 [D] 临时打印 + 记录 DRDY 实测结果
    台架验收（全部通过）：
    - DRDY 中断与拍数 1:1（每秒恒为 100/100），超时兜底 0 次
    - 实测周期 10019us，抖动仅 2~6us（旧定时方式受 1ms tick 粒度限制）
    - err=0、who=0x68
    - 断线兜底自测（跳过 INT_ENABLE 写入模拟 INT 断线）：
    drdy=0、tick=50、timeout 每秒 +50、err=0 —— 控制环稳定跑在 50Hz，不卡死
    自测开关已还原，未进入本提交
    - Modules/Motor/motor_test.c：整段删除 [D] 打印、临时统计计数器与 debug.h 引用；
    保留 dt 实测点移到等脉冲之后（得到传感器真实周期）与 20ms 超时兜底
    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
2026-09-10 阶段3：#10 DLPF 档位 + #33 控制频率提到 250Hz（待台架验证）
    前置条件已具备：轮A 把 I2C1 提到 400kHz（读 405us/拍），轮B 把采样改成 DRDY 驱动
    （实测中断与拍数 1:1、周期抖动 2~6us、断线有 8ms 超时兜底）。
    - Modules/IMU/mpu6050.c
    CONFIG 0x03 -> 0x02（42Hz -> 98Hz，延迟约 4.9ms -> 2.8ms）
    SMPLRT_DIV 0x09 -> 0x03（100Hz -> 250Hz，一次 DRDY 仍是一帧控制）
    - Modules/Motor/motor_test.c
    IMU_SAMPLE_PERIOD_MS 10 -> 4
    IMU_DELTA_TIME_S 0.01f -> 0.004f
    MOTOR_DT_MIN_S 0.005f -> 0.002f （必改项）
    MOTOR_DT_MAX_S 0.03f -> 0.012f （必改项）
    M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
2026-09-10 阶段3 补充：[R] 打印加入陀螺静止噪声指示（三轴|角速度|之和均值，0.01dps）
    DLPF 从 42Hz 换到 98Hz 后噪声涨多少，是决定保留 0x02 还是退回 0x03 的唯一判据，
    原来的 [R] 行里没有这个数字。打印行仍控制在约 37 字符（≈3.2ms），
    连同本拍工作一起能塞进 4ms 的一拍内，不破坏 dt 统计。
2026-09-10 阶段3 收尾（台架）：拆除 [R] 临时打印 + 记录 250Hz/98Hz 台架实测结果
    - drdy/tick = 250/250，打印行约 3.2ms 塞进 4ms 一拍内，没吃采样
    - dt = 4007us 均值，抖动 3~19us
    - work = 434us 均值 / 633us 峰值（= 4007us 的 15.8%，硬指标 <2000us 轻松通过）
    - 陀螺静止噪声 13~15（0.01dps，三轴和）→ 单轴约 0.05dps RMS，
    与数据手册 0.005dps/sqrt(Hz) × sqrt(98Hz) ≈ 0.049 吻合：
    98Hz 档的噪声就是芯片自身噪声，台架无额外振动/串扰 → 保留 CONFIG=0x02
    - timeout：仅冷启动第一次超时 1 次（芯片刚使能中断，第一个脉冲要几毫秒），之后不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
2026-09-10 工具：补回 VSCode IntelliSense 配置（c_cpp_properties.json）
    症状：编译下载正常，但编辑器里所有头文件标红、函数/结构体/宏跳转全部失效。
    根因：构建用 EIDE 生成的 compile_commands.json（不受影响），
    而 IntelliSense 读的 MDK-ARM/.vscode/c_cpp_properties.json 缺失；
    根 .gitignore 忽略了整个 .vscode/，所以无法从 git 恢复。
    内容按 compile_commands.json 里的包含路径逐条对齐（21 条，已核对全部存在），
    含 __CC_ARM + STM32G474xx + USE_HAL_DRIVER 三个宏，compilerPath 指向 Keil armcc。
2026-09-11 版本 v0.3「9 个轴都能完整运行」
    可飞锚点：当前固件为上机验证通过的稳定版本，暂存此状态以便后续改动回退。
    已完成的链路状态：
    - 姿态链路 #1~#29 全部落地（节拍/计时/优先级/传感器容限/校准/解算/控制律）
    - 性能增强 阶段0~3 全部落地：磁力计评估、I2C1 提速 400kHz、EXTI0/DRDY 中断采样、
    DLPF 0x02(98Hz) + 控制频率 250Hz
    - 9 轴（MPU6050 六轴 + QMC5883P 磁力计）全部在链路上运行，磁航向已可进偏航角环
    - 偏航环实测整定：yaw_rate_kp=0.95、yaw_angle_kp=1.15，自转已压住，悬停稳定
    本版本为纯锚点提交，工作区自 f177a7d 起无代码改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
2026-09-11 版本 v0.4「油门速率限制 + 俯仰摇杆修正」定稿前完整一版
    本版为进入"定高"阶段前的完整存档。相对 v0.3 有两项功能改动，外加一份新专题文档。
    一、油门速率限制（不对称）—— 新增
    问题：油门是"摇杆推多少就出多少力"，摇杆一动推力 4ms 内一步到位。
    从 1500 松到 1400 这么一点，升力瞬间掉约 31%，飞机立刻以约 3m/s²
    向下加速 —— 降落时表现为"稍微松一点就砸下来"。
    改动：在"摇杆->油门"之后加一层一阶速率限制，上升 800us/s、下降 300us/s。
    映射本身一行未改，最高油门仍由 PID 表 APEX_PID_HOV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
2026-09-11 版本 v0.5「清理死代码，为接入激光腾出 I2C2」
    定稿后确定：剩余工作只有激光相关，其余不用的全部清掉。本次净删 1489 行、新增 66 行。
    一、删除（10 个文件）
    气压计链（Modules/Baro/ 整个目录）
    baro.c / baro.h —— 任务从未创建，baro.h 自己就写着"不创建 Baro_Task"
    spl06.c / spl06.h —— 只被 baro.c 引用
    altitude_est.c/.h —— 高度卡尔曼，全仓零外部调用
    定高控制器
    altitude_control.c/.h —— AltitudeControl_Update() 全仓 0 个调用点
    姿态调试任务
    attitude_debug.c/.h —— AttitudeDebug_Task() 从未被创建，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
2026-09-11 版本 v0.6「上电打印 I2C2 总线设备列表」
    为接入 VL53L1X 激光做准备：需要一眼看到总线上到底有哪些从机，
    以便确认激光（0x29）活着、且与磁力计（0x2C）不撞车。
    改动（仅 Modules/Mag/ 下两个文件，不涉及控制链）
    1. mag.c：新增 static void Mag_PrintBusScan(const MagProbe_t *probe)
    把扫描结果里的 found_count 和 found_addrs[] 拼成一行打印，例如：
    [I2C2] scan: found 2 device(s): 0x29 0x2C
    一个设备都不应答时打印：
    [I2C2] scan: no device responded (fail=N).
    调用点放在 Mag_Task 的每次初始化尝试之后：
    - 磁力计成功 -> 上电只打一行，不刷屏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
2026-09-11 版本 v0.7「高度显示」：VL53L1X 激光测距接入 + 高度上遥测
    飞控侧本次完成：
    - 新增 Modules/ToF 模块：vl53l1x.c/.h（底层驱动）+ tof.c/.h（任务层）
    - 高度进入 ApexTelemetry_t.altitude_cm（int32，payload 偏移 6，单位厘米），协议未改
    - motor_test.c：250Hz 控制环只调 ToF_GetAltitudeCm()，一次 32 位读取，不碰 I2C2 锁
    - app_freertos.c：新增 tofTask（osPriorityBelowNormal，每步 osDelay，与 magtask 共用 I2C2）
    - 工程文件加入 Modules/ToF 文件组与头文件路径
    关键决策与踩坑（详见 优化一下/定高与油门专题.md 第 18 节）：
    - 连续测量模式（MODE_START=0x40）写入成功但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
2026-09-12 文档：高度接入飞控方案研究 + 施工顺序表 H1~H20
    新增：
    - 优化一下/高度接入飞控方案.md：高度接入飞控系统的完整研究方案
    （接入形态、串级结构、代码位置、垂速信号来源、安全门禁、分阶段路线、待拍板清单）
    含第 12 节：黑匣子 23 列语义表、第 20 列版本分界、为什么不动第 18 列、64 字节布局偏移表
    - 优化一下/高度接入施工顺序.md：H1~H20 共 20 个可独立验证的施工环节与依赖关系
    更新：
    - 优化一下/环节开发顺序.md：加上两份新文档的索引入口
    本次只做方案研究，未执行任何控制相关代码改动。
2026-09-12 版本 v0.8「H1 语义与正名迁移」：hover 正名 + 黑匣子第 20 列改记目标垂速
    一、参数正名（协议数值与枚举名均未变）
    - pid_table：内部字段 hover_pwm_us 改名 max_throttle_us，默认值宏同步改名
    - apex_protocol.h：APEX_PID_HOVER_PWM_US 枚举名保留，注释写明它表示
    「满杆对应的最高油门」，不是「悬停需要多少油门」；
    垂速 PID 项（ID 25~28）的说明改为「接入定高后它们就是垂速内环的三增益」
    - 遥控器参数页标签 HOVER PWM 改为 MAX THROTTLE（另一个仓库，未纳入本提交）
    二、黑匣子列语义迁移（记录布局与偏移完全未变，仍 64 字节）
    - 第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
2026-09-12 版本 v0.9「H2 ToF 暴露原始距离」：原始值 + 新版号计数器，并按实测更正数据
    一、ToF 对外接口扩展（快照结构体）
    - 新增 distance_raw_mm：未滤波的原始距离，给状态估计器用
    - 新增 valid_count：每测到一次有效数据 +1（单调递增），上层靠它判断"是不是新数据"
    - distance_mm 改名为 distance_filtered_mm（含义不变，仍给显示/遥测/黑匣子）
    - altitude_cm 仍由滤波值换算 —— 遥控器与黑匣子的显示一字未动
    - tof.c 内强制写顺序：先写原始距离 → 再更新滤波 → 最后自增计数器。
    保证"计数器变了 ⇒ 距离一定也是新的"，已写成注释并要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
2026-09-12 版本 v0.10「H3 高度/垂速估计器（差分版）」：新增 vertical_est 模块，实机验证通过
    一、新增
    - Modules/Control/vertical_est.c/.h：差分 + 一阶低通的高度/垂速估计（只造眼睛，不接控制）
    - 对外：Init / Reset / Update / GetState + VerticalEstState_t（height_cm、vz_cms、valid、sample_count）
    - H3 阶段挂在 tofTask 里跑（方案 A，约 12Hz），控制环一行未动
    - Keil 工程把两个新文件加进 Modules/Control 组
    二、关键设计：有效性判据用「自己累加的计时」
    - 第一版是 valid = primed && fresh && age_ms<=300。离线仿真发现：单次读失败会让 fresh
    立刻变 false，valid 短促抖动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
2026-09-12 版本 v0.11「H4' 估计器搬进控制环 + 倾斜补偿」：顺带修掉重初始化后的 vz 尖峰
    一、为什么把 H4 和 H5 合并
    倾斜补偿要用机体系姿态角 body.roll_deg/pitch_deg，而姿态角只有控制环算得出来，
    tofTask 根本拿不到。按原顺序（H4 先做）就得先造一条"姿态发布通道"给 tofTask 用，
    而 H5 一搬家这条通道立刻变废码。合并成 H4' 一次做完：搬迁 + 倾斜补偿 + 一拍耗时实测。
    二、改动
    - vertical_est：Update 签名加 roll_deg / pitch_deg；入口做倾斜补偿
    h_meas = 距离mm/10 × cos(roll) × cos(pitch)（只在来新数据时算，约 12Hz，不在 250Hz 空算 cosf）
    - motor_tes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
2026-09-13 文档：定高摇杆改三段式 + 新增「停手」状态机（方案 v5.1/5.4/15.3，施工表 H6 扩展）
    - 摇杆四段 -> 三段：取消待命段，满杆下拉 = 2cm/s 缓降
    - 新增 §5.4 停手状态机：h_est<=2cm 持续 500ms 进入，h_sp>4cm 退出，油门钳 1100us、内外环冻结、豁免 输出<1100 判据
    - h_sp 钳位 [2,120] -> [0,120]；切换条件 杆在待命段 -> 杆在最低位(<=50)；门禁二删去 杆不在待命段
    - alt_state 增加 4=停手；决策记录新增 9/10/11；§15.3 留档两版死锁教训
    - 施工表：三段映射+h_sp 积分器从 H13 前移到 H6，H13 收缩为外环 P；H7/H8/H13/H14/H18 同步
    - 明确落地不自动上锁（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
2026-09-13 版本 v0.12「H6 模式状态机 + 两层门禁 + 三段映射 + 停手状态机」：修正量恒 0，飞机行为不变
    新增 Modules/Control/vertical_control.c/.h：
    - 模式状态机：请求 vs 实际，门禁①全通才切，0x80 标记被拒
    - 门禁①：链路正常+已上锁 / 杆最低位(<=50) / 读数可信 / 高度<=120cm
    - 门禁②：已解锁 / 读数可信 / 姿态<25度 / 不处于停手
    - 三段映射 0~350 下降 -2、350~650 保持 0、650~1000 上升 +3 cm/s，段间连续
    - h_sp 积分器 clamp[0,120]；停手：h_est<=2cm + 没在命令爬升 + 非起飞保护，持续 500ms；退出 h_sp>4cm
    - 起飞保护：退出停手后直到 h_est>10cm 或 rate<0 才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
2026-09-14 版本 v0.13「H6 台架实测修正：停手门槛改测试值 6cm + 进入时 h_sp 归零」
    实测发现（垫高台架，地面读数约 4cm）：
    - 原门槛 2cm < 地面读数 4cm -> 停手一次都进不去（st 一直 1、gt 一直 0ms）
    - H6 阶段无害（修正量恒 0），但 H8 接管油门后会在地面自己退出定高
    - VERTICAL_GROUND_ENTER_H_CM 2.0f -> 6.0f（台架测试值，恢复不垫高后改回 2.0）
    - 停手进入时 h_sp := 0（不再对齐到 h_est）：否则地面读数 4cm 会让 h_sp 一进来就超过退出门槛 4cm，造成进入/退出 2Hz 抖动
    - blackbox.c 的 vm 命令改用字符判据，兼容 vm0/vm1（原来要求 VM 后跟空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
2026-09-14 施工表：H6 完成 + H7 并入 H8 + 新增 H17a（提前到 H8 之前）
    - H6 标记完成（v0.13），实测项逐条记录
    - H7 标记已并入 H8：无代码可做、无现象可验（H6 阶段模式不影响油门，平凡成立）
    - 新增 H17a「遥控端：模式通道打通」，排在 H8 之前（纯遥控端改动，飞控一行不动）
    - 原 H17 改名 H17b；H8 的 遥控端常量改成 0 一项取消；H8 风险 中高 -> 低
    - H4' 探针删除与 举到 1.3m 验证均并入 H8；vm 命令保留到 H8 验证完再删
    - 新增 台架仿真/静态检查 一节（含遥控端用 arm-none-eabi-gcc + portmacro 桩做语法检查的跑法）
2026-09-15 临时：USART3 透明回显任务（用于验证上位机串口工具的收发回路）
    为什么走中断：115200 每字节 86.8us，而 USART3 的 FIFO 关闭、硬件只存 1 字节；现有收数据靠黑匣子任务每 5ms 轮询一次 RDR（5ms 能来 57 字节、只能收 1 个）。任何轮询点被抢占几百微秒就丢字节，提到最高优先级又会挡住 250Hz 控制环。所以必须中断接收。
    新增 Modules/De_Bug/serial_echo.c/.h：环形缓冲 256B + HAL_UART_Receive_IT（单字节）+ RxCplt 回调（只认 USART3）+ ErrorCallback 重新武装（ORE 会让 HAL 中止接收，不兜住就会装死）+ USART3_IRQHandler（覆盖启动文件的 WEAK）+ 回显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
2026-09-15 修链接错误 L6200E：HAL_UART_ErrorCallback 与 GPS 重复定义
    现象：第一次真机编译 link failed：Symbol HAL_UART_ErrorCallback multiply defined (by gps.o and serial_echo.o)。
    根因：gps.c:152 已经定义了这个全局弱回调（按 Instance != USART2 过滤）。加自定义 HAL 弱回调前只 grep 了 RxCpltCallback/RxEventCallback，漏了这个符号；而语法检查查不出重复定义——那是链接期的事。
    修法：不再定义 HAL_UART_ErrorCallback，把错误处理就近放进 USART3_IRQHandler ——
    ① 先把 ORE 清掉再交给 HAL（HAL 看不到错误就不会中止接收）；
    ② 末尾检查 RxState != BUSY_RX 时补一次 HAL_UART_R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
2026-09-15 还原：删除串口回显测试的全部临时改动
    回显测试已完成并拿到全部结论，按要求全部删除（revert 0fbb390 与 448e549）。
    删除内容：
    - Modules/De_Bug/serial_echo.c/.h（环形缓冲 + 接收中断 + USART3_IRQHandler + 回显任务）
    - Core/Src/usart.c 的 USART3 NVIC 使能（两行）
    - Core/Src/app_freertos.c 的临时任务创建与 include
    - Modules/ToF/tof.c 的 TOF_PERIODIC_PRINT_ENABLE 开关（[TOF]/[ALT] 周期打印回归）
    - Modules/Flash/blackbox.c 的 BLACKBOX_UART_POLL_ENABLE / BLACKBOX_STATUS_PRINT_ENABLE 开关（串口轮询与 [BB] rec= 回归）
    - MDK-ARM uvprojx 里 serial_echo.c/.h 的登记项
    - 优化一下/串口回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
2026-09-15 施工表：记录串口回显插曲的结论与一条未验证项（回显代码已全部还原）
    - 插曲已全部删除（afe46ad 还原 0fbb390 / 448e549），完整内容留在 git 历史
    - 结论①：USART3 现在是 5ms 轮询 + 必须逐字节发，这是串口命令又慢又脆的根因；接收中断已实测可行（256B 全量二进制 + 1024B 连续突发零丢失，1314B 进 = 1314B 出）
    - ⚠️ 未验证项：拔插线 / ORE 溢出后的自动恢复没有真机验证（用户跳过）；将来串口突然收不到数据时先怀疑这里
2026-09-15 v0.14 H8 定高模式接管基础油门
    本环节：把"定高模式下基础油门从哪来"这条线接过来，并清掉 H4' 探针。
    ## 做了什么
    1. 新增 VerticalControl_GetThrottleUs()
    - 普通模式（调用方不该问） -> MOTOR_PWM_MIN_US 1000（兜底）
    - 停手 / 门禁②没过（st=4/5） -> MOTOR_PWM_MIN_US 1000（电机停转）
    - 控制启用（st=1） -> MIXER_PWM_EFFECTIVE_MIN_US 1100（占位）
    - 见 vertical_control.h 的返回值表；.c 里的注释写明了为什么停手是 1000 而不是 1100
    2. motor_test.c 第 522 行那一句按模式分叉
    - 用 vertical_control_state.mode（**实际生效**的模式）判断，不是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
2026-09-15 v0.14 H8 台架验证通过（9/9）+ 停手门槛的旧数字被推翻
    H8 代码在上一提交（041a5d9）已完成，本次只更新留档，**没有改任何代码**。
    ## 验证结论
    用户实测，由串口审计日志逐条自动核对（脚本 verify_h8.js）：
    通过 9 / 失败 0 / 未测 1
    - ① 普通模式映射不变：31 样本，杆量连续两拍不变的 13 个全部精确；杆 690 仍是 1345us
    - ② 定高+解锁+杆最低+停手 -> thr=1000（走的是 GetThrottleUs 新路径，ct=0x7 已解锁）
    - ③ 推杆时 h_sp 未过 4cm -> 恒 1000（14 样本，stick 最大 1000）；越过 4cm 立刻变 st=1 thr=1100
    - ★ 不变式：定高下 257 个样本 thr 只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
2026-09-15 v0.14 H8 的 ⑧「举高」补充实测：判据拆成 ⑧a/⑧b + 记录 USB 线扯掉的坑
    用户实测（13:03）：举到 128.1cm，共 32 个离地样本。
    结果：
    - ✅ sw 从 0xF 掉成 0x7（掉了 HEIGHT_OK），因为 128cm > VERTICAL_MODE_MAX_HEIGHT_CM=120cm
    - ✅ st 仍是 4、thr 仍是 1000（停手在离地状态下依然成立，油门不动）
    - ✅ thr 超过 1100 的样本 0 个（不变式在离地状态下依然成立）
    - ⬜ v=0（掉 EST_VALID）没触发 —— 128cm 还在 ToF 的约 1.3m 量程内
    ⭐ 判据本身被这次实测纠正：HEIGHT_OK（120cm 代码软上限）与 EST_VALID（约 1.3m 硬件量程）
    是两个不同的触发点，原判据写成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
2026-09-15 v0.15 H9 垂速内环 P —— 修正量第一次真的加到油门上
    本环节：把定高的垂速内环接上，让 `VerticalControl_GetThrottleUs()` 从"恒返回一个
    占位常数"变成"基准油门 + 真实闭环修正量"。
    1. 新增垂速内环（vertical_control.c）
    - 控制律 ∆µs = Kp_v × (vz_sp − vz_est)，vz_sp 固定 0（VERTICAL_INNER_VZ_SP_CMS）
    ⇒ 纯阻尼器：抬起来减油门、压下去加油门
    - 用一份 Pid_t，不是 CascadePid_t：H9 只有内环，外环在 H13
    （且 H13 的外环有 2cm 死区和 ±20cm/s 钳位，CascadePid 装不下，届时本来就要重排）
    - 只在"定高模式 + 不在停手 + 门禁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
2026-09-15 v0.16 例行串口打印精简：[TOF] + [ALT] 两行合并为一行 [V]
    用户提出例行打印太长、多数字段平时不看也不参考。把 500ms 那两行
    （约 239 字符）合并为一行 [V]（约 123 字符），只留会看的 14 个字段。
    **控制逻辑一行不动，纯粹是打印。**
    ## 新格式
    [V] raw=28mm | h=2.8cm vz=-0.3cm/s v=1 | req=1 mode=1 st=4 sw=0xC ct=0x7
    stick=0 h_sp=0.0 gt=500ms | corr=+0.0 thr=1000
    四段各回答一个问题：
    ① 传感器 raw
    ② 估计器 h / vz / v
    ③ 状态机 req mode st sw ct stick h_sp gt
    ④ 输出 corr / thr ← H9 的核心观测量
    ## 合并的最大理由不是省字符，是消重
    原来 h / v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
2026-09-15 v0.16 H9 真机验证通过（10/10）+ 记录四个'为什么'的答案与两条新观察
    用户实测（17:24-17:30，3 份审计日志、598 个 [V] 样本），verify_v.js 判定 10/0/0。
    核心结论：
    - ⭐ 符号正确：强信号（|vz|>=3cm/s）85/85 反号，弱信号 231 个也全部反号
    - ⭐ 等效 Kp ≈ 19.9，与遥控里设的 vz_kp = 20 吻合 ⇒ 参数链路与量纲都对
    - thr 硬上限 1280 越界 0；停手/上锁时 corr 非 0 的 0；普通模式回归精确
    - 顺带补验 H8 的 ⑨：举到 120cm 以上 sw 从 0xE 变 0x6（HEIGHT_OK 掉了），10 个样本
    用户提的四个'为什么'全部是设计行为，根源同一句话：
    停手只用'估计高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
2026-09-15 v0.17 参数通道扩展：新增高度环（外环）KP/KI/KD —— 解决待办 8
    为 H13 的外环备好遥控可调通道（H10 的调参工具也就位了）。
    ## 协议
    - 新增 APEX_PID_HEIGHT_KP/KI/KD，编号 30/31/32（追加在最后，旧编号一个都没动）
    - APEX_PID_PARAMETER_COUNT 30 -> 33，新增 APEX_PID_V7_PARAMETER_COUNT 30
    - 单帧负载上限 128 -> 140：33 项的 PID 回包 = 4 + 33*4 = 136 > 128，
    会命中 apex_protocol.h 里的编译期 #error。140 = 136 + 4 余量，
    远低于 LoRa 模块上限（ra01sc.h 的 255）。
    代价：PID 回包帧 133 -> 145 字节、空口时间约 +9%；但它是请求触发的一次性报文
    （进 PID 页 GET / SET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
2026-09-15 v0.17 验收留档：参数通道 + 字库补齐已烧录，用户实测 UI 无问题
    - 高度页三行、垂速环/高度环两个标签可分辨、7 个参数可编辑
    - 缺字形不再是方框
    - 本次只改文档，没有动代码
2026-09-15 v0.18 H10 悬停油门估计器（内环积分）+ 绝对油门区间
    让定高第一次"知道该给多少油门"。原文只写"内环 Ki + anti-windup"，
    实施时发现必须拆成两层，原因见下。
    ## ⭐⭐ 两层结构（本环节的形态与原文不同）
    慢层 = 手写积分器 vertical_throttle_base_us（悬停油门估计器，方案 §2.3 承诺的那个）
    由 vz_ki 驱动，初值 1250，钳 [1150, 1650]
    快层 = H9 的垂速内环 P，钳 ±50
    输出 = 慢层 + 快层，再整体钳到 [1150, 1650]
    ⚠️ 为什么不让 Pid_t 的内部积分当慢层：pid.c 的积分钳位是对称的（±i_limit），
    而 [1150,1650] 相对 0 不对称。硬套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
2026-09-15 v0.18 H10 真机验证通过（12/0/1）+ 正面确认两条'空中停车'缺口
    - 451 个样本/226 秒，verify_v.js 判定 12 通过 / 0 失败 / 1 未测（⑨举到1.2m 未做，h 最大 91.9cm）
    - 慢层符号两个方向都对：严格档（相邻两条 vz 同号、|vz|>=1）58 个可判、同号 0 个，
    |vz| 门槛提到 8 仍 0/13
    - i 全程在 [1150,1650]（实测 1153.8~1478.4）；地板与'积分/输出同锁'实测生效：
    i=1153.8 corr=-50 之和 1103.8 被最终钳回 1150（否则离姿态环旁路线 1100 只剩 4us）
    - 无 windup：i 冲到 1478 后能自己回落
    - 普通模式映射反推满杆 2000us，与 v0.18 新默认值吻合
    - 两条实测缺口（待办 5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
2026-09-15 v0.19 H12 失效处理：保持 2 秒 → 按 30us/s 平缓降至 1000
    结掉待办 5（空中门禁失效 = 空中停车）。起因是 H10 真机实测暴露的
    41/451 个样本（9% 的时间）处于"空中停车"：门禁②一抖就返回 1000，
    而 1000 还会命中 motor_test 的 thr <= 1100 分支**旁路姿态环**
    ⇒ 飞机是翻滚着砸下来的。
    ## 三级台阶（本环节的形状与原文完全不同）
    原文写的是"退出判据 + 交还手动"，实际做成"不退出、先把油门稳住再慢慢收"：
    st=1 控制启用
    ──门禁②失效──► st=6 失效保持（2 秒）
    · 油门**锁存**在失效前一刻的实际输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
2026-09-15 v0.20 H13 外环 P + h_sp 接入（串级真正成立）
    到此为止，摇杆命令的高度才第一次真的被控制链使用。
    ## 接线本身很简单
    vz_sp 从常数 0 换成 Pid_Update(外环, h_sp, h_est)（死区 2cm、限幅 ±20）
    内环与慢层的代码一行没改 —— 这就是串级的用意：外环换了，内环照旧。
    两个"现成件"要补：
    - Pid_t 没有死区字段 ⇒ 死区用"界内把设定值当成当前值"传进去。
    这样 PID 的微分历史照常推进，出死区那一拍不会产生假尖峰。
    - PidTable_GetHeightParams() 不存在（pid_table.h 里写着"H13 才补"）⇒ 新增。
    ## ⭐⭐ 慢层的误差来源改了（H13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
2026-09-18 v0.21 飞前清账：第一次定高实飞之前一次性做掉的 6 项代码改动 + 参数修正
    用户的计划：这次调参实现"下=降落 / 中=定高 / 上=上升"三段操作，定高基本功能即完成，
    之后直接进自动起飞 → 光流。所以飞之前把所有"琐碎但必须做"的事一次清干净。
    ## 代码改动（一次烧录；遥控端一行不动）
    1. 摇杆速率 VERTICAL_RATE_DOWN_CMS 2 → 5、VERTICAL_RATE_UP_CMS 3 → 5
    理由："下区域要能当**降落**用"——2cm/s 时从 1 米落地要 **50 秒**，飞行员会以为坏了；
    5cm/s 约 20 秒。仍远低于自由落体量级（300+ cm/s），"慌乱收杆也不会失控"的保护性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
2026-09-18 v0.22 停手改成「推杆即解手」：油门仍全程由控制器给，但解手不再需要推到上升段
    ## 为什么要改（用户提的问题）
    改之前，停手的**唯一出口**是"杆积分出来的 h_sp 攒过 4cm"，而 h_sp **只在杆 >650
    （上升段）时才涨** ⇒ 杆在下降段（0~350）和中间段（350~650）推得再多，油门恒 1000µs、
    **电机一点都不转**，想解手必须推到上升段再保持约 0.8 秒。
    用户要的是"推一点就转起来"——杆的位置本身就该是判据。
    ⚠️ **本环节不做"手动起飞段"**（那是被否掉的另一条路）：解手之后油门仍然**全程由控制器给**
    （1000 → 0.31s 爬到 1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
2026-09-18 v0.22（无代码改动）· 新增《光流接入方案（OF1~OF5）》定稿
    本次只加一份方案文档，**飞控代码一行未动**。
    ## 为什么现在做光流
    用户实测发现：定高能悬停，但水平方向没有任何位置反馈 ⇒ 起飞漂 2~5 米、之后持续缓慢
    漂走；厂区面积小 ⇒ 漂移会撞墙 ⇒ **定高没法长时间测试**。所以先做定点，定高先放一边。
    ## 核实到的硬件事实（全部带出处，见文档 §1 / §10）
    - 帧格式 9 字节：0xFE 0x04 DX_L DX_H DY_L DY_H SUM Quality 0xAA；SUM = 中间 4 字节
    相加取低 8 位；**19200 8N1**；40ms 一帧 = 25Hz（协议图）
    - ⚠️ **VDD 必须 3.3V、绝不能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
2026-09-18 v0.23 OF1~OF5 光流接入：串口接通 + 四重校验解析 + 质量门禁 + 零点标定 + 累积流量（只打印、不接控制）
    用户实测：**定高能悬停，但水平没有位置反馈 ⇒ 起飞漂 2~5 米、之后持续缓慢漂走**，
    厂区面积小会撞墙 ⇒ **定高没法长时间测试**。所以改成**先做定点、定高先放一边**。
    （定高的代码已完成，普通模式与它无关。）
    第一期先把光流"看见并算对"，**本批不接任何控制** ⇒ 零炸机风险，拆桨不拆桨都能做。
    ## 接线：不动硬件、不动 CubeMX 引脚配置
    本板只有 USART2（GPS 座）+ USART3（打印）两个串口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
2026-09-19 v0.23（无代码改动）· 会话成本治理：新增《会话交接》交接文档 + 工作区规则 AGENTS.md
    本次**飞控代码一行未动**，只加文档与两个分析脚本。
    ## 为什么做这个
    用户反映：一直用**同一个会话**（212 轮），已经压缩过很多次，token 成本高。
    用新增的 `measure_usage.js` 量了那个会话，拿到实测数字（不是估）：
    - 2176 次 LLM 请求 / **212 轮**；**合计计费 891.9 M token**
    （新输入 8.3M + **缓存读 880.6M / 98.7%** + 输出 3.0M）
    - 每次请求上下文**中位 391K**、p90 682K、**峰值 791K**（第 112 轮）
    - ⭐⭐ **三次压缩只降了 10% / 3% / 6%** ⇒ **压缩救不了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
2026-09-21 v0.24 OF5标定窗口改为250帧并留存真机验收证据
2026-09-21 v0.24 OF1~OF5真机验收通过并归档留样
2026-09-24 OF10: 完成定点请求接入与双板联调基线
2026-09-24 OF9: 完成定点安全门禁与黑匣子记录
2026-09-26 OF11: 接入定点姿态目标基线
2026-10-04 v0.33：完成 IMU 六面校准与姿态打印链路
2026-10-07 v0.34：IMU/光流定点阶段4~7改动 + 定点手动上锁重新锚定（待真机验收）
    固件：
    - IMU 健康判定、动态加速度权重、静止陀螺零偏学习（阶段4）
    - 光流方向复核、高度比例、旋转冻结（阶段5~7）
    - 定点手动上锁修复：PositionControl_SetSafetyContext() 新增第4参数 pilot_disarmed，
    仅“链路正常 + 有效遥控帧明确请求上锁”算正常上锁；正常上锁清零目标/积分/滤波/
    位置速度/旧锚点并回 WAITING，重新解锁且门禁全通时在新位置重新锚定；
    已有真实故障锁存与首次原因保持，仍需关开定点请求才能重新使能
    - 调试打印与 ToF/Flow 轮询配合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
2026-10-07 留档：会话交接同步 v0.34 提交事实
    - 头部与 §3 改为「v0.34 已提交」，补记本次提交范围与待真机验收边界
    - 记录 sim_position_control.c 受忽略规则影响，以后仍须 git add -f
    - §8 新增两条坑：DSH 沙箱禁写 .git（提交需完全权限）、工作区 Windows 权限缺失与修复留档位置
