Nyxarian/ApexFly-v2.0/(notices)

Notices in the files:
ApexFly v2.0/Core/Src/main.c:
Copyright (c) 2026 STMicroelectronics.
All rights reserved.
This software is licensed under terms that can be found in the LICENSE file
